ben5049/Smart-Watch/Firmware/README.md

# Firmware

## STM32

All STM32 firmware was written in [STM32CubeIDE](https://www.st.com/en/development-tools/stm32cubeide.html).

## NRF53

Zephyr is scary : (
