ben5049/Smart-Watch/Simulations/README.md

Simulations and calculations for circuits
