ben5049/Smart-Watch/Documentation/Useful Tools.md

[STM32 Oscillator selection](https://app.powerbi.com/view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)

[JLCPCB Impedance Calculator](https://jlcpcb.com/pcb-impedance-calculator/)

[Saturn PCB Design Toolkit](https://saturnpcb.com/saturn-pcb-toolkit/)
