ben5049/Smart-Watch/PCBs/archived/README.md

All libraries for projects in "archived/" are defined relative to the "PCBs" folder (../), and need to be moved there before opening to work properly.
