ben5049/Smart-Watch/Documentation/Display/coordinates1.png

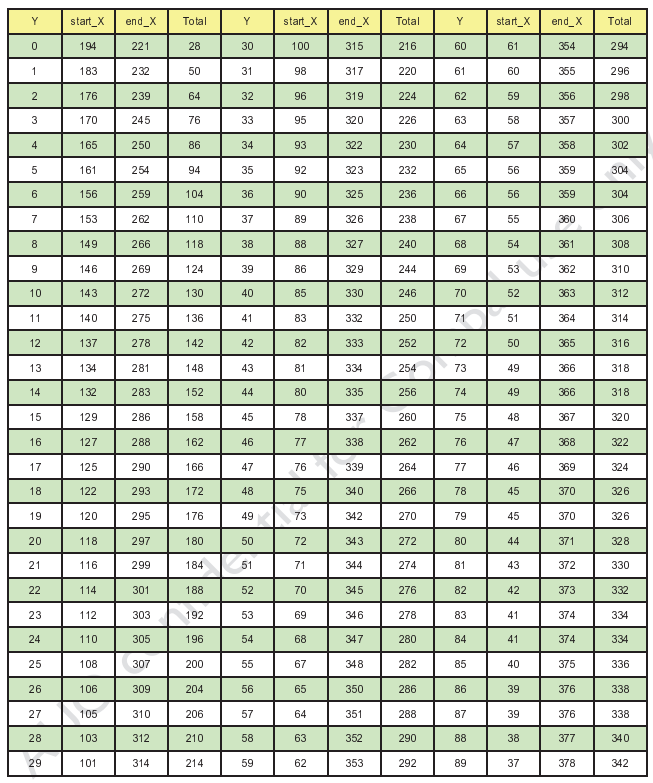
Documentation/Display/coordinates1.png
