ben5049/Smart-Watch/Documentation/Display/coordinates2.png

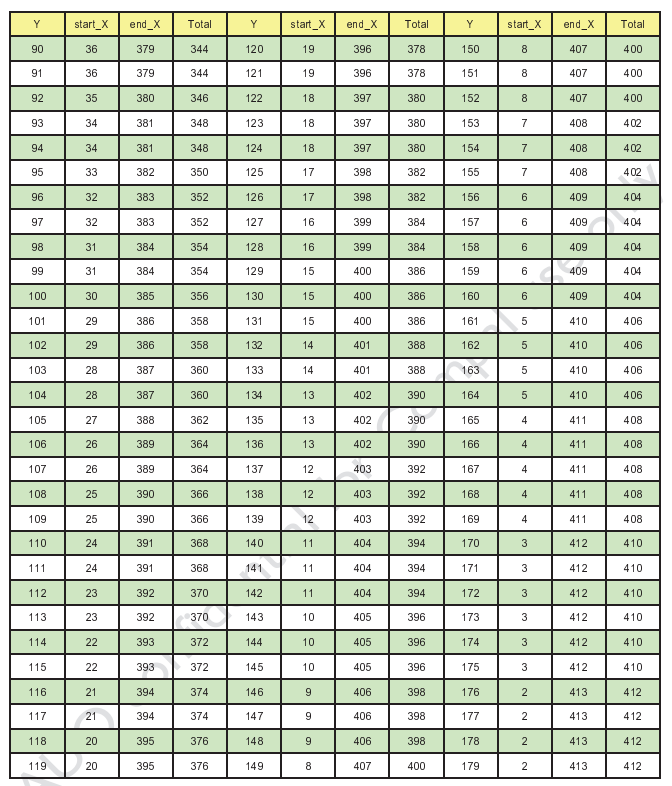
Documentation/Display/coordinates2.png
