ben5049/Smart-Watch/Documentation/Display/coordinates3.png

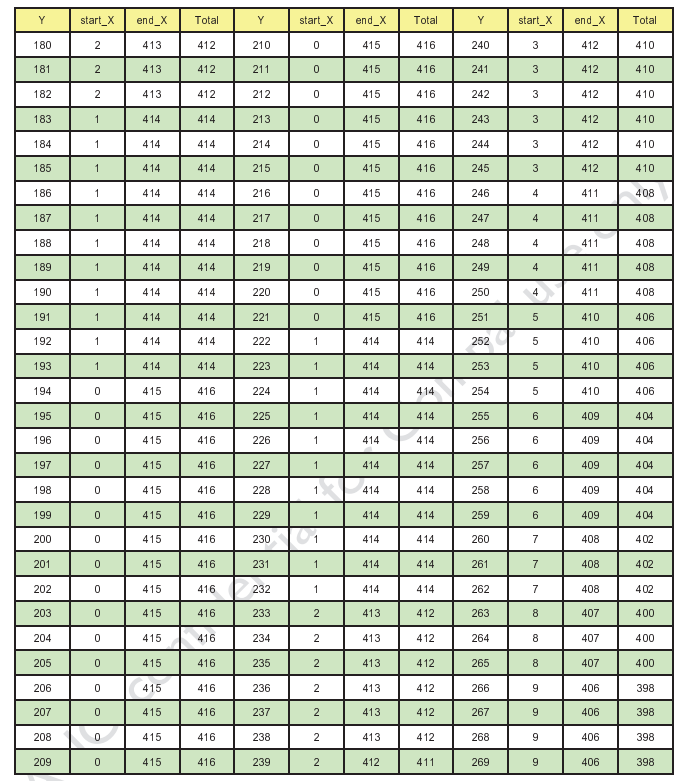
Documentation/Display/coordinates3.png
