ben5049/Smart-Watch/Documentation/Display/coordinates4.png

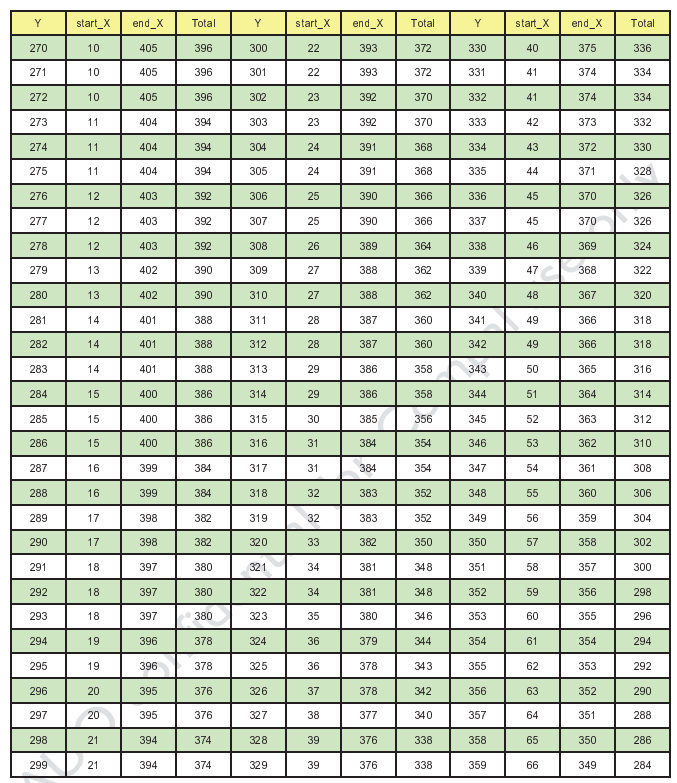
Documentation/Display/coordinates4.png
