ben5049/Smart-Watch/Documentation/Display/coordinates5.png

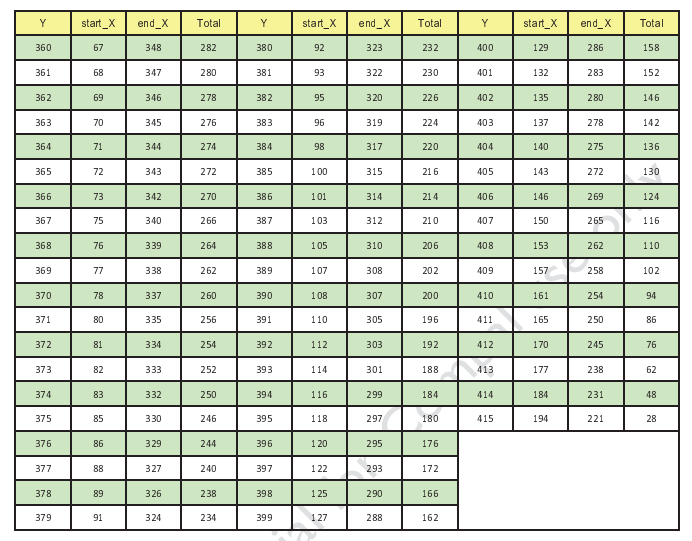
Documentation/Display/coordinates5.png
