ben5049/Smart-Watch/Documentation/Images/ADP5360_layout.png

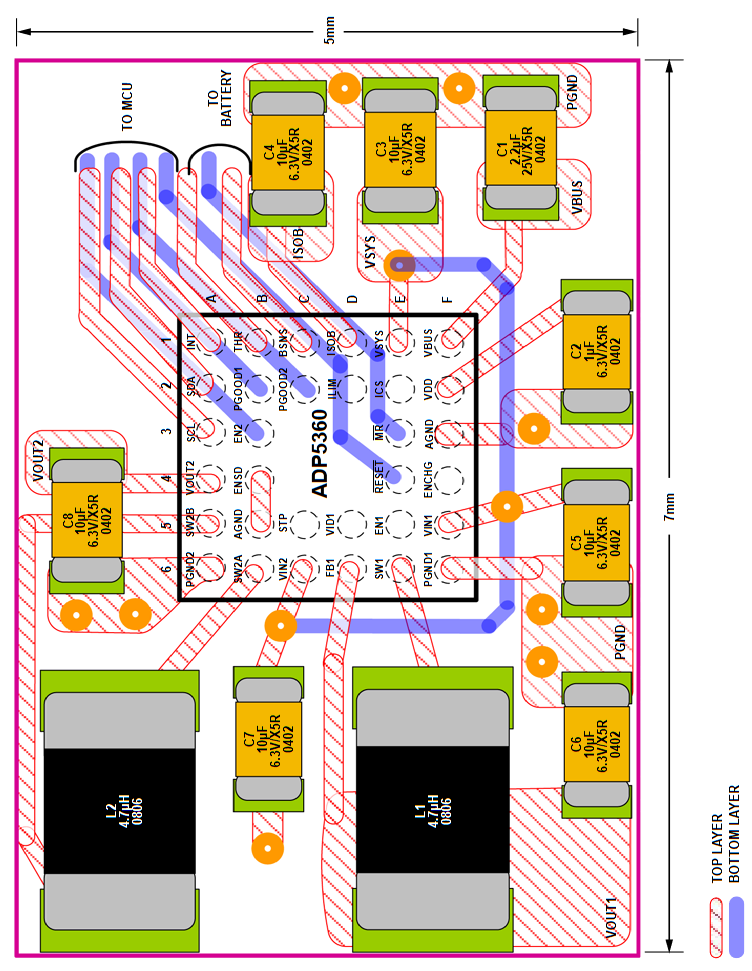
Documentation/Images/ADP5360_layout.png
