ben5049/Smart-Watch/Documentation/Images/antenna-diagram.png

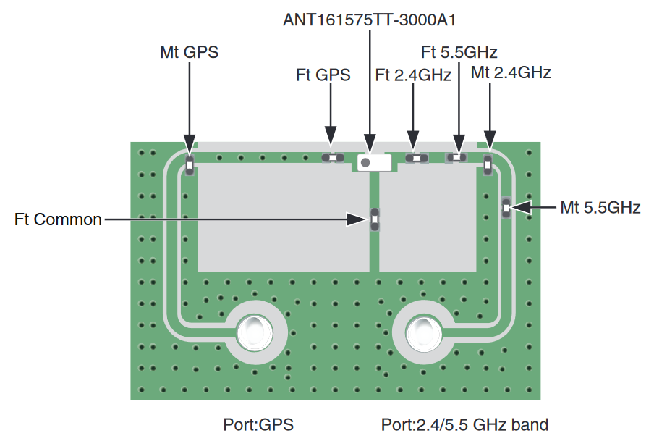
Documentation/Images/antenna-diagram.png
