ben5049/Smart-Watch/Documentation/Images/CST716_pinout.png

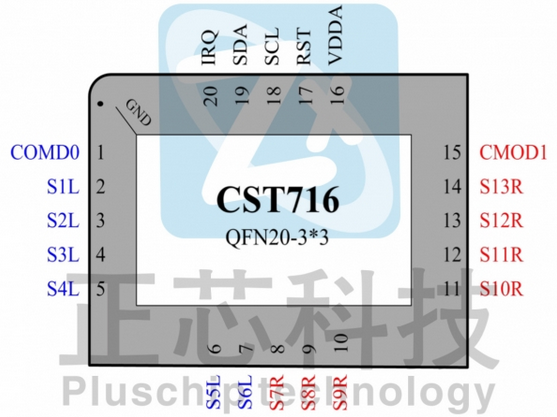
Documentation/Images/CST716_pinout.png
