ben5049/Smart-Watch/Documentation/Images/display_2_front.png

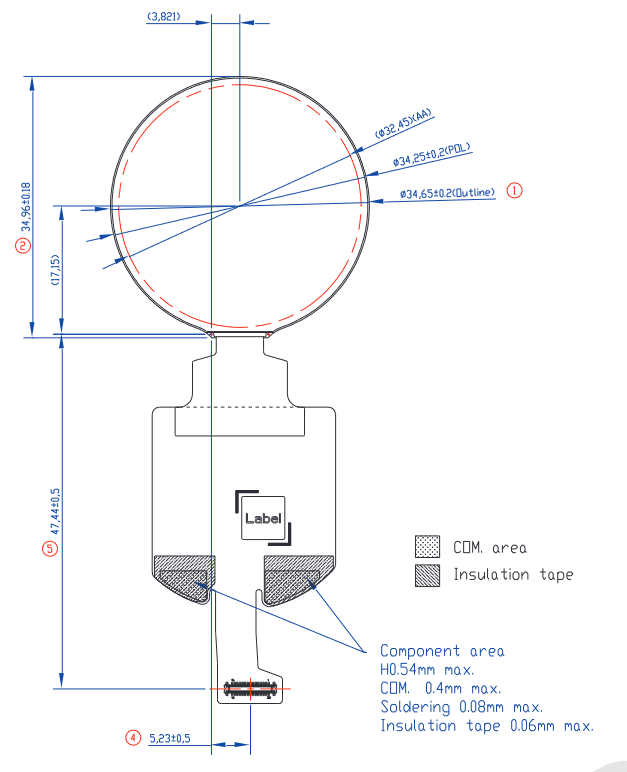
Documentation/Images/display_2_front.png
