ben5049/Smart-Watch/Documentation/Images/pogo_pin_3mm.png

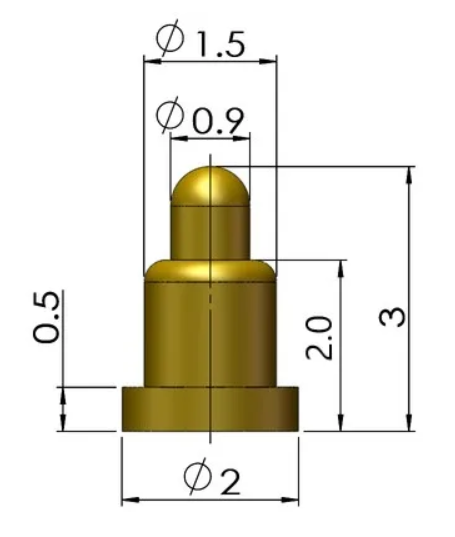
Documentation/Images/pogo_pin_3mm.png
