ben5049/Smart-Watch/Documentation/Images/pogo_pin_8mm.png

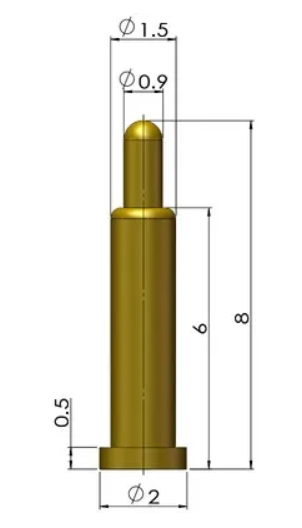
Documentation/Images/pogo_pin_8mm.png
