ben5049/Smart-Watch/Documentation/Images/pogo_pin_size_chart.png

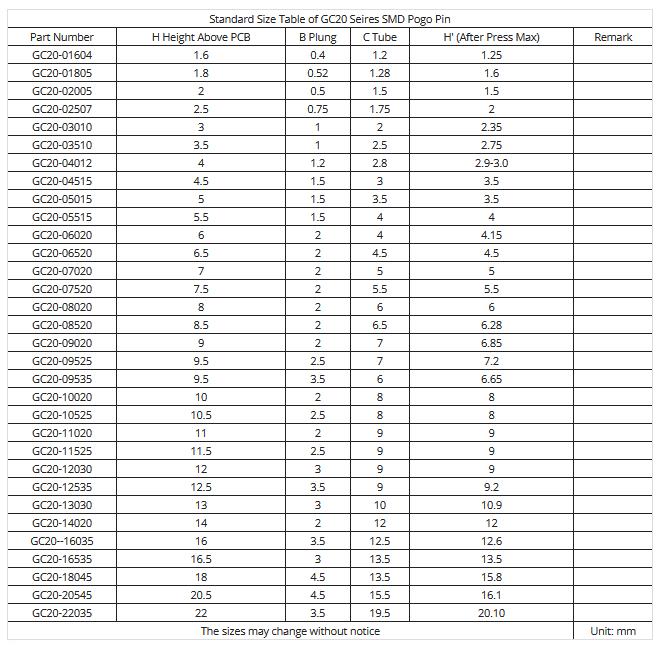
Documentation/Images/pogo_pin_size_chart.png
