ben5049/Smart-Watch/Simulations/Boost_SMPS_DAC_Control.jpg

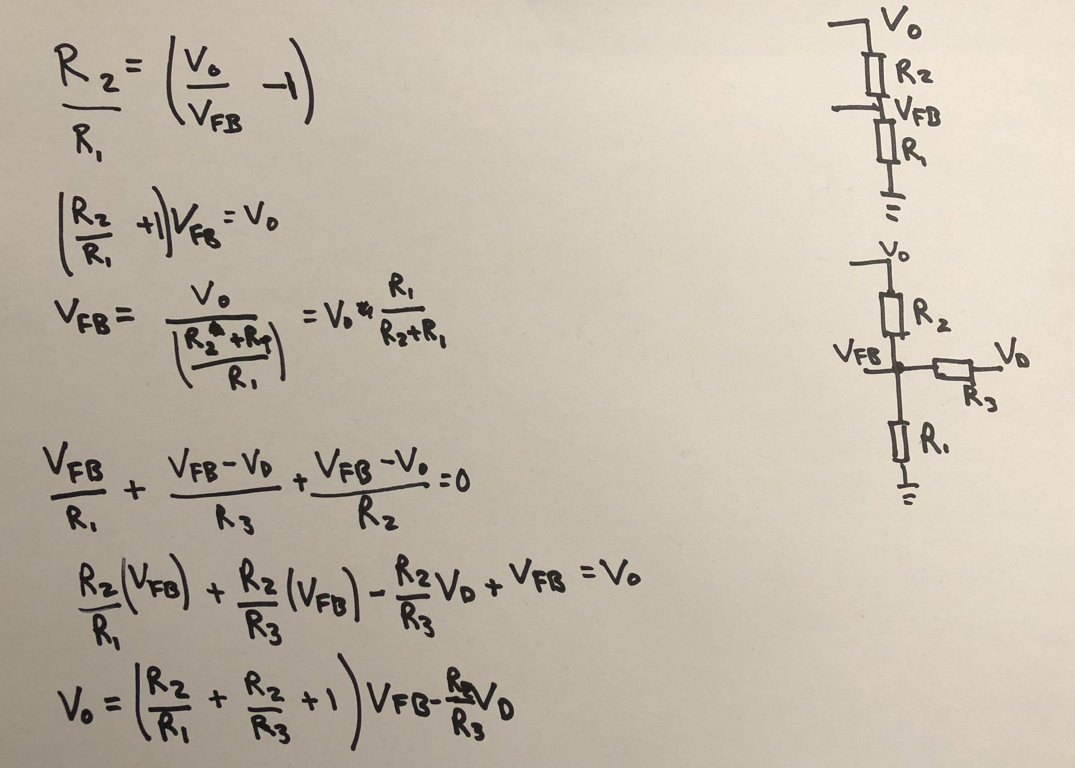
Simulations/Boost_SMPS_DAC_Control.jpg
