ben5049/Smart-Watch/Simulations/RFID_Level_Shift_Switching_Delay.jpg

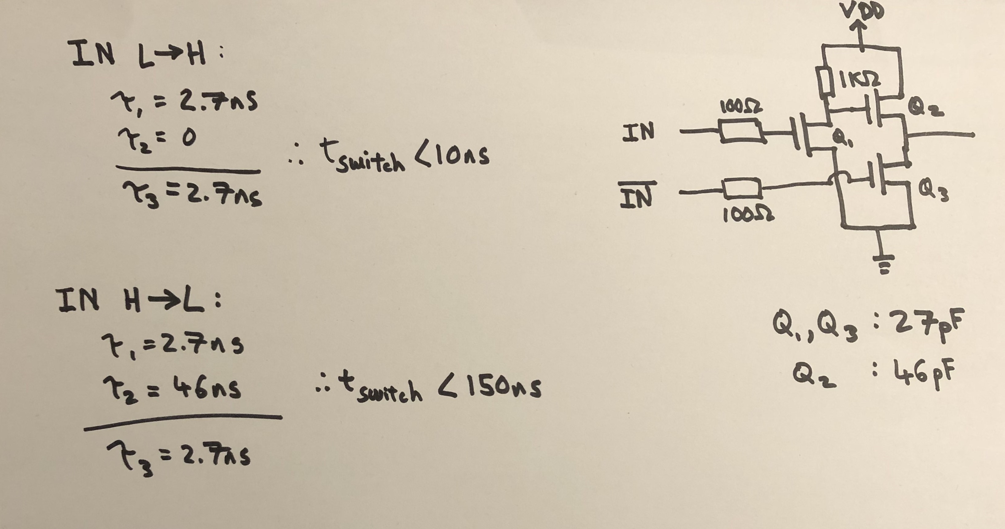
Simulations/RFID_Level_Shift_Switching_Delay.jpg
