ben5049/Smart-Watch/Documentation/BOMs/Watch Main BOM.xlsx

 |  | Name | Value | Quantity | Price | Function | Bought? | Link | Datasheet
ICs |  | STM32U5A9NJH6Q |  | 1 | 14.25 | Main MCU | A | https://www.mouser.co.uk/ProductDetail/STMicroelectronics/STM32U5A9NJH6Q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
 |  | nRF5340-QKAA-R7 |  | 1 | 7.32 | BLE MCU | B | https://www.mouser.co.uk/ProductDetail/Nordic-Semiconductor/nRF5340-QKAA-R7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
 |  | ADP5360ACBZ-2-R7 |  | 1 | 3.59 | Battery charger, 1V8, 3V3 regulators | B | https://www.mouser.co.uk/ProductDetail/Analog-Devices/ADP5360ACBZ-2-R7?qs=GBLSl2AkirtayaN8yEOC7w%3D%3D
 |  | NCP45525IMNTWG-H |  | 1 | 1.16 | SD Card load switch | B | https://www.mouser.co.uk/ProductDetail/onsemi/NCP45525IMNTWG-H?qs=xGcJQ%252BnsJwuEDnjYHzk8Zw%3D%3D
 |  | RT4730WSC |  | 1 | 1.86 | AMOLED Power | B | https://www.mouser.co.uk/ProductDetail/Richtek/RT4730WSC?qs=amGC7iS6iy9KQOadwtNmGA%3D%3D
 |  | ANT161575TT-3000A1 |  | 1 | 0.44 | GNSS + BLE Antenna | B | https://www.mouser.co.uk/ProductDetail/TDK/ANT161575TT-3000A1?qs=%2FQ2qp2Z%2FWFzXgfHtTXyT%2FQ%3D%3D
 |  | TESEO-LIV3FL |  | 1 | 12.96 | GNSS Module | B | https://www.mouser.co.uk/ProductDetail/STMicroelectronics/TESEO-LIV3FL
 |  | BGA725L6E6327FTSA1 |  | 1 | 0.35 | GNSS LNA | B | https://www.mouser.co.uk/ProductDetail/Infineon-Technologies/BGA725L6E6327FTSA1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
 |  | B39162B4327P810 |  | 1 | 1.24 | GNSS Saw filter | B | https://www.mouser.co.uk/ProductDetail/RF360/B39162B4327P810?qs=lGUynpphgXxwtn5A8O%2FIyg%3D%3D
 |  | S26HS512TGABHI000 |  | 1 | 10.00 | Hyper flash | A | https://www.mouser.co.uk/ProductDetail/Infineon-Technologies/S26HS512TGABHI000?qs=BJlw7L4Cy78X5sI41cfhkg%3D%3D
 |  | NVT4858HKZ |  | 1 | 0.96 | SD Level shifter | B | https://www.mouser.co.uk/ProductDetail/NXP-Semiconductors/NVT4858HKZ?qs=TuK3vfAjtkUQFuqXj%252BGfyA%3D%3D
 |  | M24256X-FCU6T/VF |  | 1 | 0.44 | EEPROM | B | https://www.mouser.co.uk/ProductDetail/STMicroelectronics/M24256X-FCU6T-VF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
 |  | IM70D122V01XTMA1 |  | 1 | 1.58 | Microphone | B | https://www.mouser.co.uk/ProductDetail/Infineon-Technologies/IM70D122V01XTMA1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
 |  | LSM6DSO16ISTR |  | 1 | 5.64 | IMU | A | https://www.mouser.co.uk/ProductDetail/STMicroelectronics/LSM6DSO16ISTR?qs=t7xnP681wgUum%252BsoR36hnw%3D%3D
 |  | IIS2MDCTR |  | 1 | 2.80 | Magnetometer | B | https://www.mouser.co.uk/ProductDetail/STMicroelectronics/IIS2MDCTR?qs=1mbolxNpo8ems1K%2FRdQzXg%3D%3D
 |  | OPT3004DNPR |  | 1 | 2.46 | Ambient light sensor | B | https://www.mouser.co.uk/ProductDetail/Texas-Instruments/OPT3004DNPR?qs=l7cgNqFNU1jkBuP1vZFGkA%3D%3D
Discrete Semis | FETs | DMP2104LP-7 |  | 1 | 0.34 | Reverse polarity PMOS | B | https://www.mouser.co.uk/ProductDetail/Diodes-Incorporated/DMP2104LP-7?qs=R%252By5Lqt1H6xg6KRllhPj7w%3D%3D
Passives | Inductors | MLG1005S0N6CT000 | 0.6nH | 1 |  |  | B
 |  | LQG15HZ1N5S02D | 1.5nH | 2 |  |  | B
 |  | LQG15HS2N2B02D | 2.2nH | 1 |  |  | B
 |  | LQG15HZ2N7S02D | 2.7nH | 1 |  |  | B
 |  | LQG15HS7N5G02D | 7.5nH | 1 |  |  | B
 |  | DFE201612E-2R2M=P2 | 2.2uH | 2 | 0.26 | VDD11, Display buck inductor | B | https://www.mouser.co.uk/ProductDetail/Murata-Electronics/DFE201612E-2R2M%3dP2?qs=AQlKX63v8Rsi4vow61OBVg%3D%3D
 |  | DFE201612E-4R7M=P2 | 4.7uH | 2 | 0.26 | 1V8, 3V3 Regulator inductors | B | https://www.mouser.co.uk/ProductDetail/Murata-Electronics/DFE201612E-4R7M%3dP2?qs=AQlKX63v8RtFKyOOIfSFEA%3D%3D
 |  | MLZ1608N100LT000 | 10uH | 2 | 0.11 | nRF Regulator inductors | B | https://www.mouser.co.uk/ProductDetail/TDK/MLZ1608N100LT000?qs=%2FPzWLGNeQ%252BjWztxz0ZUthw%3D%3D
 | Crystals | ECS-.327-7-12-C-TR | 32.768kHz | 1 | 0.54 | STM32 LSE | B | https://www.mouser.co.uk/ProductDetail/ECS/ECS-.327-7-12-C-TR?qs=Mv7BduZupUigykQeU9laTQ%3D%3D
 |  | ECS-160-8-37-CWY-TR3 | 16MHz | 1 | 0.32 | STM32 HSE | B | https://www.mouser.co.uk/ProductDetail/ECS/ECS-160-8-37-CWY-TR3?qs=e8oIoAS2J1S7yHPKjK4eXg%3D%3D
 |  | ECS-320-8-37B-CWN-TR | 32MHz | 1 | 0.37 | nRF Oscillator | B | https://www.mouser.co.uk/ProductDetail/ECS/ECS-320-8-37B-CWN-TR?qs=3Rah4i%252BhyCHz%252B6r%252BQzq5cA%3D%3D
 | Capacitors | GJM1555C1HR60BB01D | 0.7pF, 0402 | 1 |  |  | B
 |  | GJM1555C1H6R0CB01D | 6pF, 0402 | 4 |  |  | B
 |  | GJM1555C1H7R5DB01D | 7.5pF, 0402 | 1 |  |  | B
 |  | GJM1555C1H430JB01D | 43pF, 0402 | 1 |  |  | B
 |  | GRM1555C1H121JA01D | 120pF, 0402 | 1 |  |  | B
 |  | GRM155R70J222KA01D | 2.2nF, 0402 | 1 |  |  | B
 |  |  | 10nF, 0402 | 2 |  |  | A
 |  |  | 100nF, 0402 | 36 |  |  | A
 |  | GRT155C81E224ME01D | 220nF, 0402 | 1 |  |  | B
 |  |  | 1uF, 0402 | 10 |  |  | A
 |  |  | 2.2uF, 0402 | 3 |  |  | A
 |  |  | 4.7uF, 0402 | 4 |  |  | A
 |  |  | 10uF, 0402 | 13 |  |  | A
 |  | GRM158R61A226ME15D | 22uF, 0402 | 2 | 0.18 | ELVSS Cap | B | https://www.mouser.co.uk/ProductDetail/Murata-Electronics/GRM158R60J226ME01D?qs=hd1VzrDQEGhRlVgN8RQ1oA%3D%3D
 | Resistors 0402 |  | 0 | 1 |  |  | A
 |  |  | 4.7k | 10 |  |  | A
 |  | ERJ-2RKF1002X | 10k | 2 |  |  | B
 |  |  | 100k | 1 |  |  | A
Mechanical | Buttons | EVP-AEJB2A |  | 1 | 0.64 | Side button | A | https://www.mouser.co.uk/ProductDetail/Panasonic/EVP-AEJB2A?qs=WGabLL9VVXqY3HchGWvM%2Fg%3D%3D
 | Connectors | AXG130144A |  | 1 | 2.74 | Display connector | B | https://www.digikey.co.uk/en/products/detail/panasonic-electric-works/AXG130144A/5057281
 |  | 105162-0001 |  | 1 | 0.82 | uSD Card slot | B | https://www.digikey.co.uk/en/products/detail/molex/1051620001/4555282?s=N4IgTCBcDaIIwAYCscBsYC0DtxAXQF8g
 |  | AXG110144A | WRONG | 1 | 1.40 | Touch mezzanine socket | B | https://www.digikey.co.uk/en/products/detail/panasonic-electric-works/AXG110144A/5057277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
 |  | AXG120144A |  | 1 | 2.04 | Lower mezzanine socket | B | https://www.digikey.co.uk/en/products/detail/panasonic-electric-works/AXG120144A/5057279
