ben5049/Smart-Watch/Documentation/BOMs/Module Test Rig BOM.xlsx

 |  | Name | Value | Quantity | Price | Function | Bought? | Link | Datasheet
ICs |  | LDI1117-3.3H |  | 1 | 0.55 | 3V3 LDO Regulator | B | https://www.mouser.co.uk/ProductDetail/Diotec-Semiconductor/LDI1117-3.3H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
Passives
Mechanical | Connectors | FTSH-107-01-F-DV-K |  | 1 | 3.94 | STDC14 Connector | B | https://www.mouser.co.uk/ProductDetail/Samtec/FTSH-107-01-F-DV-K?qs=%252BZP6%2F%252BtExtDsIijVpK7L8w%3D%3D
 | Other | Button |  | 1 | 0.00 |  | A
 |  | Slide Switch |  | 1 | 0.00 |  | A
