ben5049/Smart-Watch/Documentation/BOMs/RFID Module BOM.xlsx

ICs |  | STM32G071G8U6TR |  | 1 | 2.58 |  | B | https://www.mouser.co.uk/ProductDetail/STMicroelectronics/STM32G071G8U6TR?qs=ZSypp649SOUutATaO5pC%2Fg%3D%3D
 |  | TLV9004SIRTER |  | 1 | 0.61 | Quad op amp | B | https://www.mouser.co.uk/ProductDetail/Texas-Instruments/TLV9004SIRTER?qs=byeeYqUIh0P0b6lIyMN1Wg%3D%3D
 |  | MAX9027EBT+T |  | 1 | 1.26 | Comparator | B | https://www.mouser.co.uk/ProductDetail/Analog-Devices-Maxim-Integrated/MAX9027EBT%2bT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
 |  | MAX17291BANT+T |  | 1 | 1.45 | Boost converter | B | https://www.mouser.co.uk/ProductDetail/Analog-Devices-Maxim-Integrated/MAX17291BANT%2bT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
Discrete Semis | FETs | DMN21D2UFB-7B |  | 4 | 0.29 | RFID NMOS | B | https://www.mouser.co.uk/ProductDetail/Diodes-Incorporated/DMN21D2UFB-7B?qs=gfe7vQ8txpW8IlraWNmMnA%3D%3D
 |  | DMP21D5UFB4-7B |  | 1 | 0.30 | RFID PMOS | B | https://www.mouser.co.uk/ProductDetail/Diodes-Incorporated/DMP21D5UFB4-7B?qs=gfe7vQ8txpUVAcG22XiS3g%3D%3D
 | Diodes | ACDBQC0130L-HF |  | 1 | 0.27 | RFID Envelope detector diode | B | https://www.mouser.co.uk/ProductDetail/Comchip-Technology/ACDBQC0130L-HF?qs=Zz7%252BYVVL6bENpHY2DpOUTA%3D%3D
Passives | Inductors | TR1102-0491J | 4.91mH | 1 | 5.00 | RFID z-axis transponder coil | A | https://www.grupopremo.com/en/tr1102-xy-axis-smd-ferrite-rfid-transponder-inductor-125khz-238-9mh-11x26x22mm/900-tr1102-0491j.html | Alternative: 4513TC-495XGLB
 |  | MLZ1608N100LT000 | 10uH | 1 |  |  | B | https://www.mouser.co.uk/ProductDetail/TDK/MLZ1608N100LT000?qs=%2FPzWLGNeQ%252BjWztxz0ZUthw%3D%3D
 | Capacitors 0402 | GRM1555C2A101GA01D | 100p | 3 |  |  | B
 |  | GRM155R71H331MA01D | 330p | 1 |  | Tuning cap | B
 |  | GCM155R72A102KA37J | 1n | 1 |  |  | B
 |  | GRM155R61E472KA01D | 4.7n | 2 |  |  | B
 |  |  | 10n | 2 |  |  | A
 |  |  | 100n | 4 |  |  | A
 |  |  | 220n | 1 |  |  | B
 |  |  | 1u | 2 |  |  | A
 |  |  | 4.7u | 2 |  |  | A
 |  | GRM158R61A226ME15D | 22u | 1 |  |  | B
 | Resistors 0402
 |  |  | 100 | 3 |  |  | A
 |  |  | 330 | 1 |  |  | A
 |  |  | 1k | 6 |  |  | A
 |  |  | 4.7k | 1 |  |  | A
 |  | ERJ-2GEJ512X | 5.1k | 1 |  |  | B
 |  |  | 10k | 6 |  |  | B
 |  | AF0402FR-0720KL | 20k | 1 |  |  | B
 |  |  | 33k | 2 |  |  | A
 |  |  | 100k | 2 |  |  | A
 |  | AC0402FR-07402KL | 402k | 1 |  |  | B
 |  |  | 1M | 2 |  |  | A
 |  | CRCW04023M48FKED | 3.48M | 1 |  |  | B
