ben5049/Smart-Watch/Documentation/BOMs/Watch Lower PCB BOM.xlsx

 |  | Name | Value | Quantity | Price | Function | Bought? | Link | Datasheet
ICs |  | DRV2605LYZFR |  | 1 | 1.65 |  | B | https://www.mouser.co.uk/ProductDetail/Texas-Instruments/DRV2605LYZFR?qs=7z%252BmIopC6%2FIPohzEGVWenA%3D%3D
 |  | MAX30102EFD+T |  | 1 | 9.94 |  | B | https://www.mouser.co.uk/ProductDetail/Analog-Devices-Maxim-Integrated/MAX30102EFD%2bT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
Discrete Semis | TVS Diode | TPD1E10B06DPYR |  | 1 | 0.30 |  | B | https://www.mouser.co.uk/ProductDetail/Texas-Instruments/TPD1E10B06DPYR?qs=UFc95S4Z4CaJYpQ4xqTc0g%3D%3D
Mechanical | Connectors | AXG220144 |  | 1 | 2.46 |  | B | https://www.mouser.co.uk/ProductDetail/Panasonic-Industrial-Devices/AXG220144?qs=MNIFWdyJgbqoES8luJlP4A%3D%3D
