ben5049/Smart-Watch/Documentation/BOMs/Watch Test Rig BOM.xlsx

 |  | Name | Value | Quantity | Price | Function | Bought? | Link | Datasheet
ICs
Discrete Semis | FETs | DMN21D2UFB-7B |  | 5 |  |  | B
Passives
Mechanical | Connectors | FTSH-107-01-F-DV-K |  | 1 | 3.94 | STDC14 Connector | B | https://www.mouser.co.uk/ProductDetail/Samtec/FTSH-107-01-F-DV-K?qs=%252BZP6%2F%252BtExtDsIijVpK7L8w%3D%3D
 |  | FTSH-105-01-F-DV-K |  | 1 | 2.67 | MIPI10 Connector | B | https://www.mouser.co.uk/ProductDetail/Samtec/FTSH-105-01-F-DV-K?qs=iT52DjcXudtFjikTq7rIdg%3D%3D
 |  | Pogo Pin | 8mm
