ben5049/Smart-Watch/PCBs/component_library/watch_drawings/watch_main.dxf

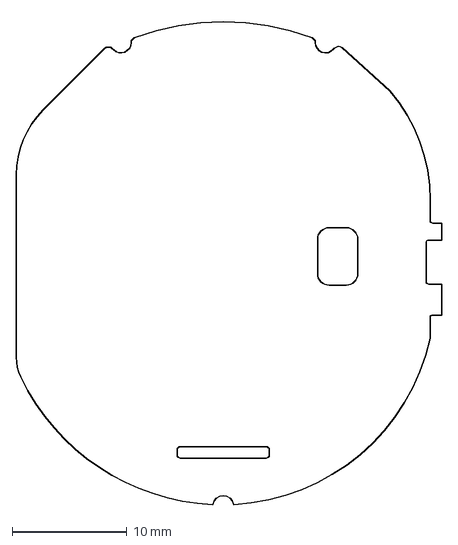
[picture p18: CAD file, 2024-01-25]
PCBs/component_library/watch_drawings/watch_main.dxf
37.0 x 42.4 mm
