ben5049/Smart-Watch/PCBs/component_library/watch_drawings/watch_main_keepout.dxf

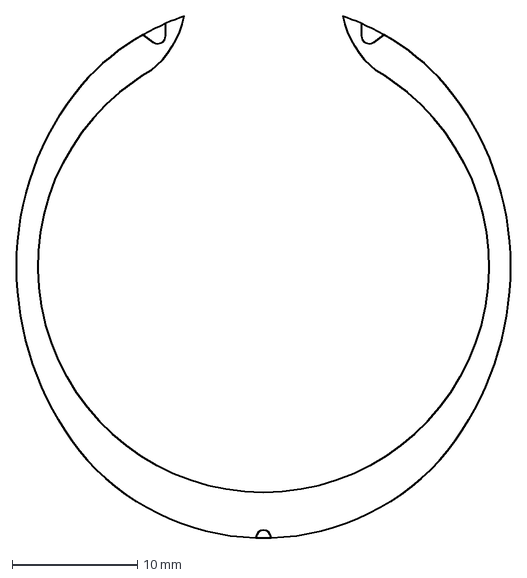
[picture p19: CAD file, 2023-12-30]
PCBs/component_library/watch_drawings/watch_main_keepout.dxf
39.4 x 41.6 mm
