ben5049/Smart-Watch/CAD/Bottom.stl

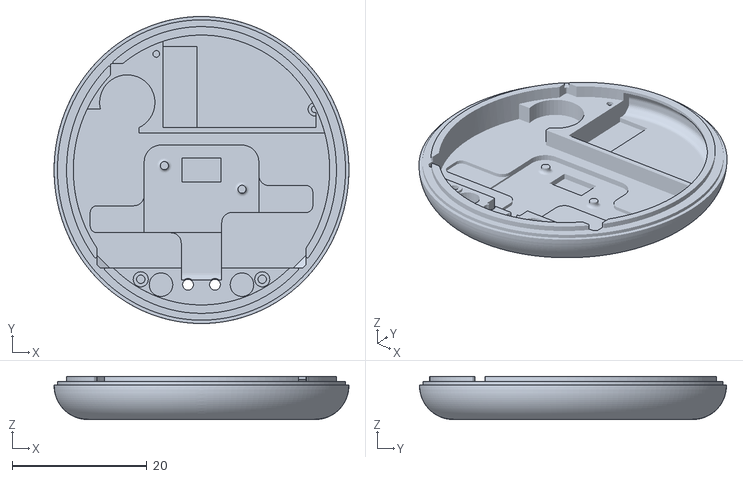
[picture p20: CAD file, 2024-01-14]
CAD/Bottom.stl
43.7 x 45.5 x 6.38
