ben5049/Smart-Watch/PCBs/component_library/watch_models/PCA9570GMH.stp

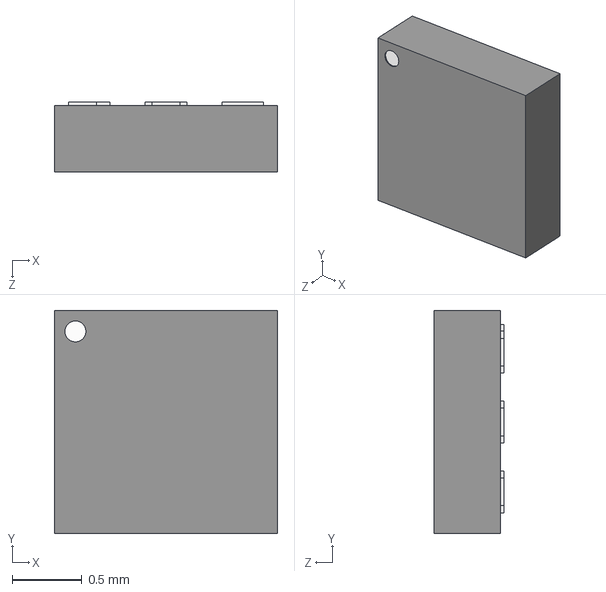
[picture p21: CAD file, 2024-03-28]
PCBs/component_library/watch_models/PCA9570GMH.stp
1.60 x 1.60 x 0.5 mm
