ben5049/Smart-Watch/PCBs/rfid_module_v1.1/rfid_module.step

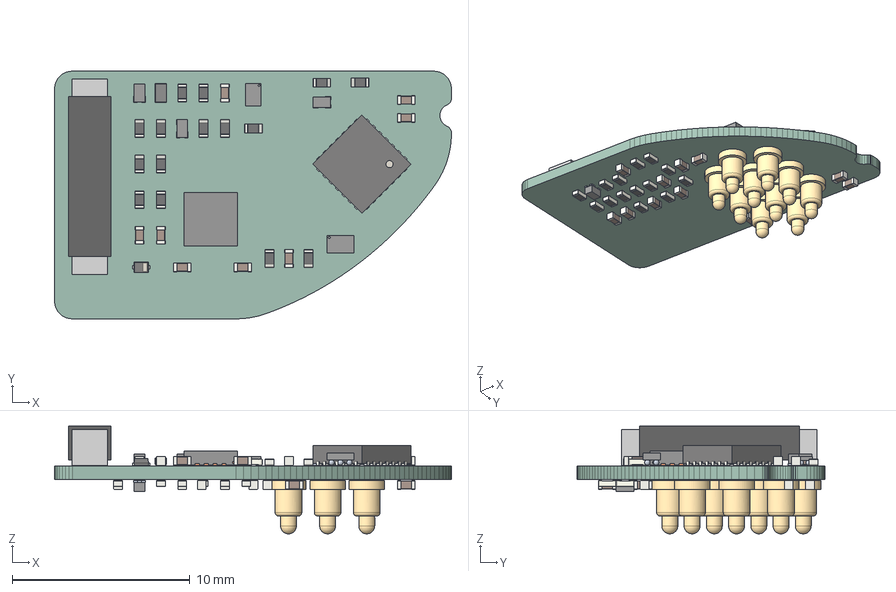
[picture p22: CAD file, 2024-01-06]
PCBs/rfid_module_v1.1/rfid_module.step
22.3 x 13.9 x 6.06 mm
PCB
