ben5049/Smart-Watch/PCBs/watch_lower/watch_lower.step

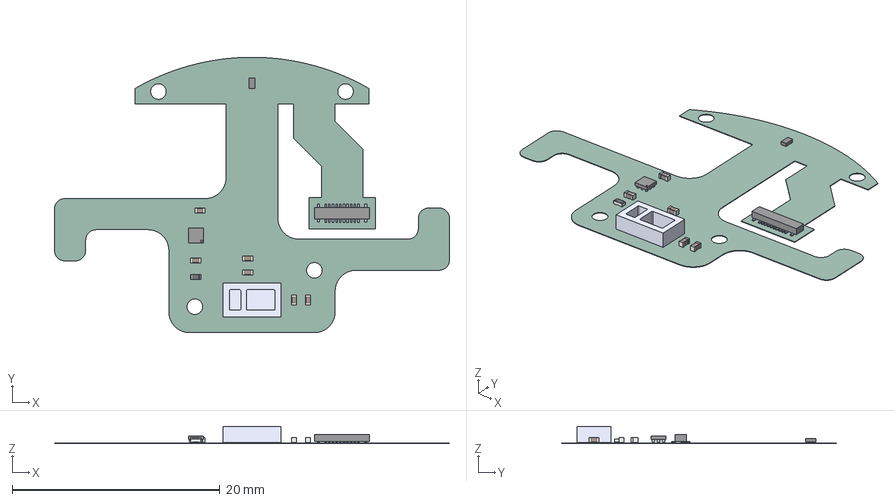
[picture p23: CAD file, 2024-01-06]
PCBs/watch_lower/watch_lower.step
38.0 x 26.5 x 1.66 mm
PCB
