ben5049/Smart-Watch/CAD/Test Rig Frame.stl

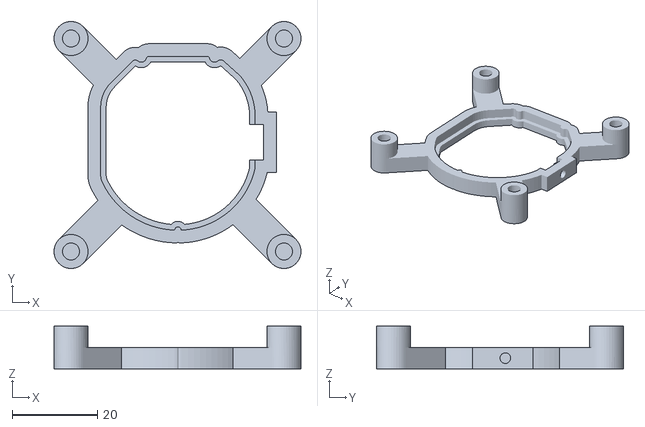
[picture p24: CAD file, 2024-01-13]
CAD/Test Rig Frame.stl
58.0 x 58.0 x 10.0
