ben5049/Smart-Watch/PCBs/component_library/watch_drawings/watch_module.dxf

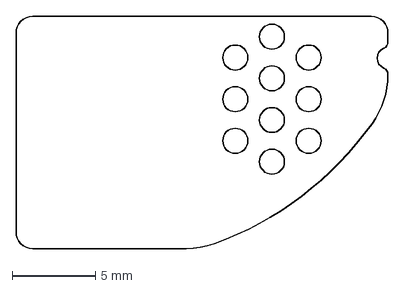
[picture p25: CAD file, 2024-01-06]
PCBs/component_library/watch_drawings/watch_module.dxf
22.3 x 13.9 mm
