ben5049/Smart-Watch/PCBs/component_library/watch_models/21-0789_B41_MXM.step

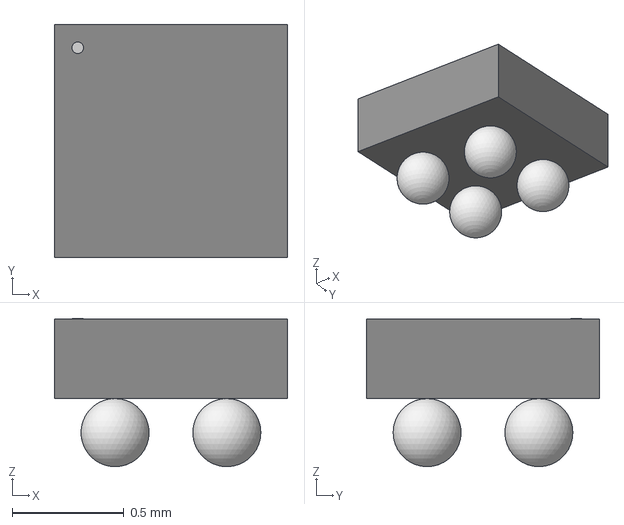
[picture p26: CAD file, 2024-03-27]
PCBs/component_library/watch_models/21-0789_B41_MXM.step
1.04 x 1.04 x 0.663 mm
