ben5049/Smart-Watch/PCBs/component_library/watch_drawings/watch_lower.dxf

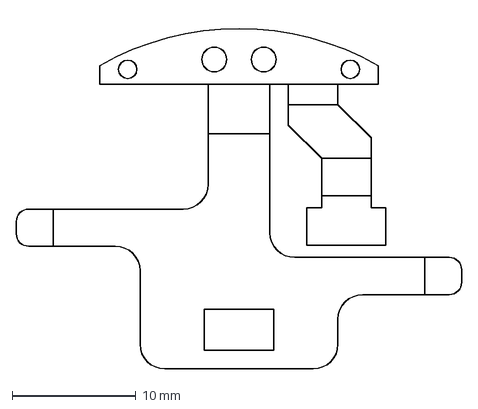
[picture p27: CAD file, 2024-01-03]
PCBs/component_library/watch_drawings/watch_lower.dxf
36.0 x 28.5 mm
