ben5049/Smart-Watch/PCBs/component_library/watch_models/UFBGA144_STM.step

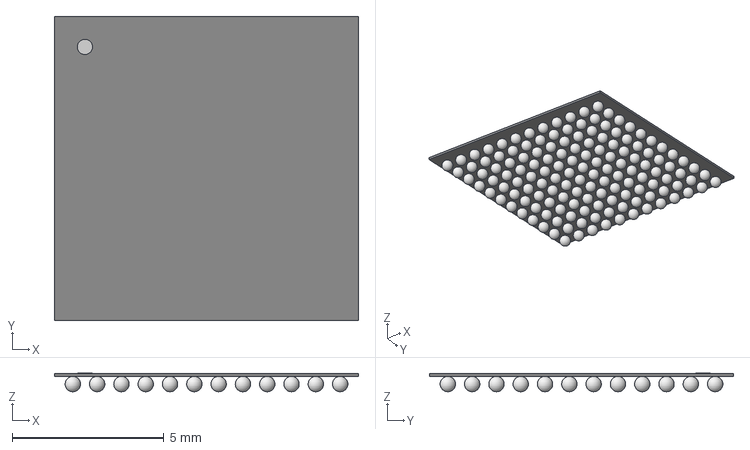
[picture p28: CAD file, 2024-03-26]
PCBs/component_library/watch_models/UFBGA144_STM.step
10.0 x 10.0 x 0.612 mm
