ben5049/Smart-Watch/PCBs/component_library/watch_drawings/antenna_layout.dxf

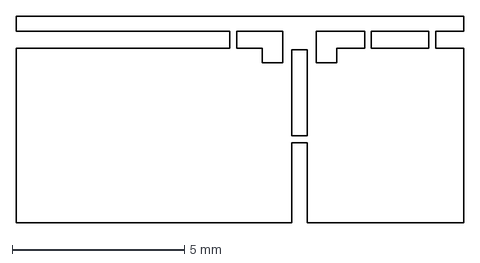
[picture p29: CAD file, 2023-12-17]
PCBs/component_library/watch_drawings/antenna_layout.dxf
13.0 x 6.00 mm
