ben5049/Smart-Watch/PCBs/component_library/watch_models/STM32U5G9ZJJ.stp

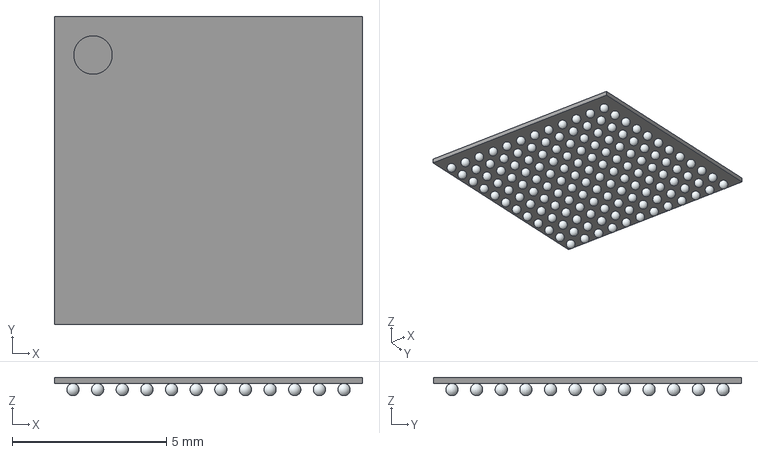
[picture p30: CAD file, 2024-01-26]
PCBs/component_library/watch_models/STM32U5G9ZJJ.stp
10.0 x 10.0 x 0.6 mm
