ben5049/Smart-Watch/PCBs/component_library/watch_models/LBEE59B1LV-278.stp

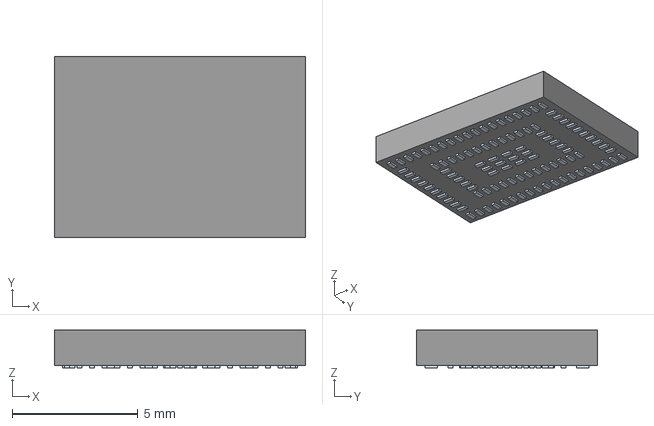
[picture p31: CAD file, 2024-01-25]
PCBs/component_library/watch_models/LBEE59B1LV-278.stp
10.0 x 7.20 x 1.50 mm
Pins
