ben5049/Smart-Watch/PCBs/component_library/watch_models/FCBGA300_CYP.step

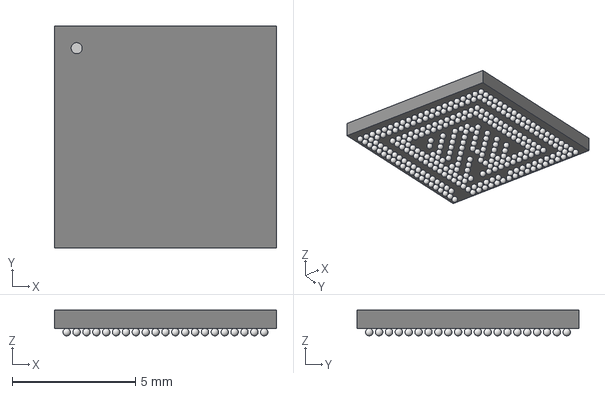
[picture p32: CAD file, 2024-01-25]
PCBs/component_library/watch_models/FCBGA300_CYP.step
8.99 x 8.99 x 1.04 mm
