ben5049/Smart-Watch/PCBs/component_library/watch_models/LBEE5PK2AE-564.stp

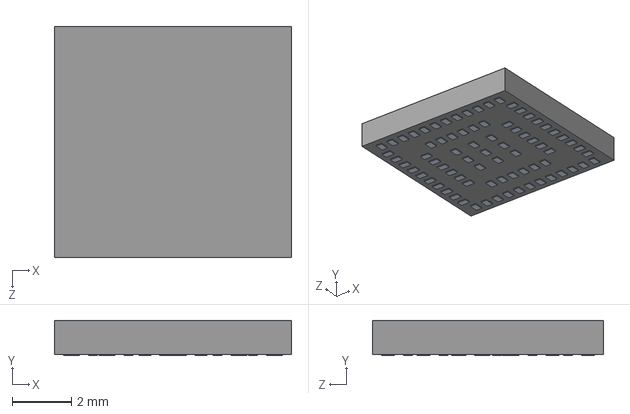
[picture p33: CAD file, 2024-01-25]
PCBs/component_library/watch_models/LBEE5PK2AE-564.stp
8.00 x 1.19 x 7.80 mm
