ben5049/Smart-Watch/PCBs/component_library/watch_models/10-Pin Pogo Connector Pins.step

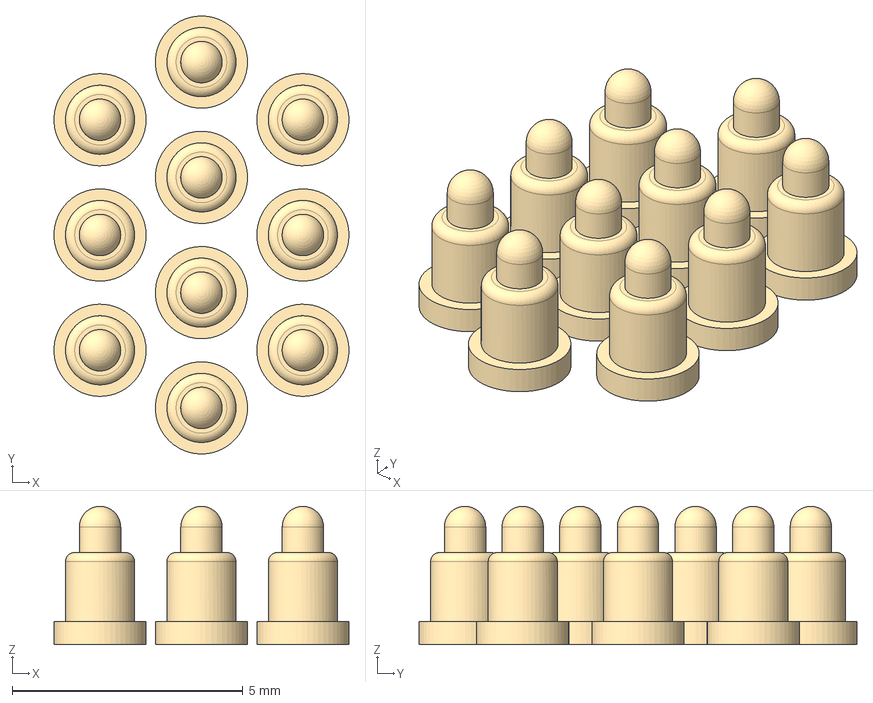
[picture p34: CAD file, 2024-01-03]
PCBs/component_library/watch_models/10-Pin Pogo Connector Pins.step
6.40 x 9.50 x 3.00 mm
Pogo Pin 5mm x 10
