ben5049/Smart-Watch/PCBs/component_library/watch_models/10-Pin Pogo Connector Pads.step

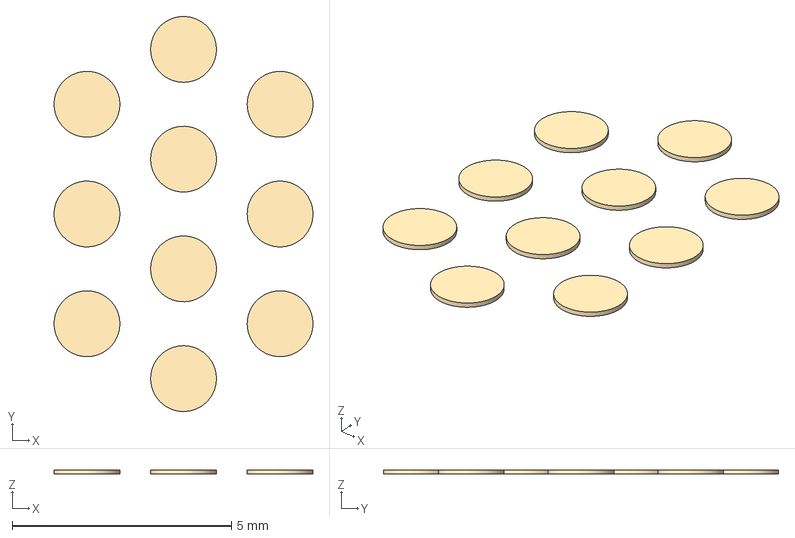
[picture p35: CAD file, 2024-01-02]
PCBs/component_library/watch_models/10-Pin Pogo Connector Pads.step
5.90 x 9.00 x 0.1 mm
