ben5049/Smart-Watch/PCBs/component_library/watch_models/Test Point 2mm.step

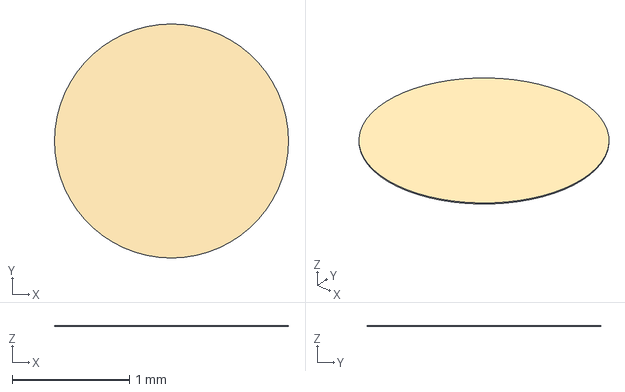
[picture p36: CAD file, 2024-01-02]
PCBs/component_library/watch_models/Test Point 2mm.step
2.00 x 2.00 x 0.01 mm
