ben5049/Smart-Watch/PCBs/component_library/watch_models/Test Point 1.5mm.step

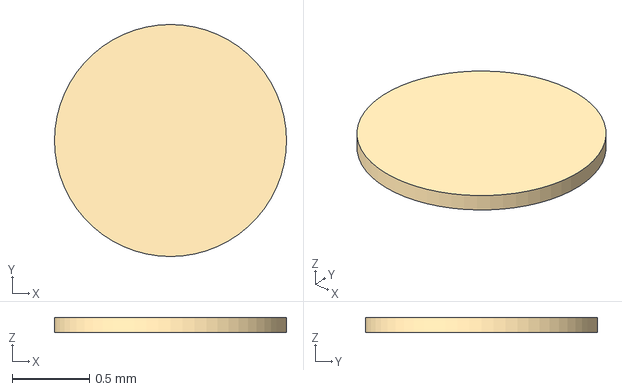
[picture p37: CAD file, 2024-01-02]
PCBs/component_library/watch_models/Test Point 1.5mm.step
1.50 x 1.50 x 0.1 mm
