ben5049/Smart-Watch/PCBs/component_library/watch_models/RT4730WSC.step

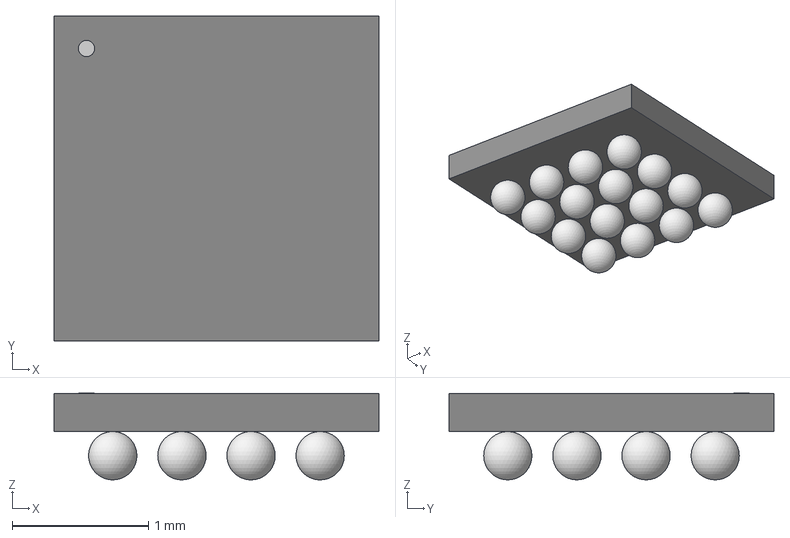
[picture p38: CAD file, 2023-12-27]
PCBs/component_library/watch_models/RT4730WSC.step
2.39 x 2.39 x 0.638 mm
