ben5049/Smart-Watch/PCBs/component_library/watch_models/TYPE-C-31-M-12.step

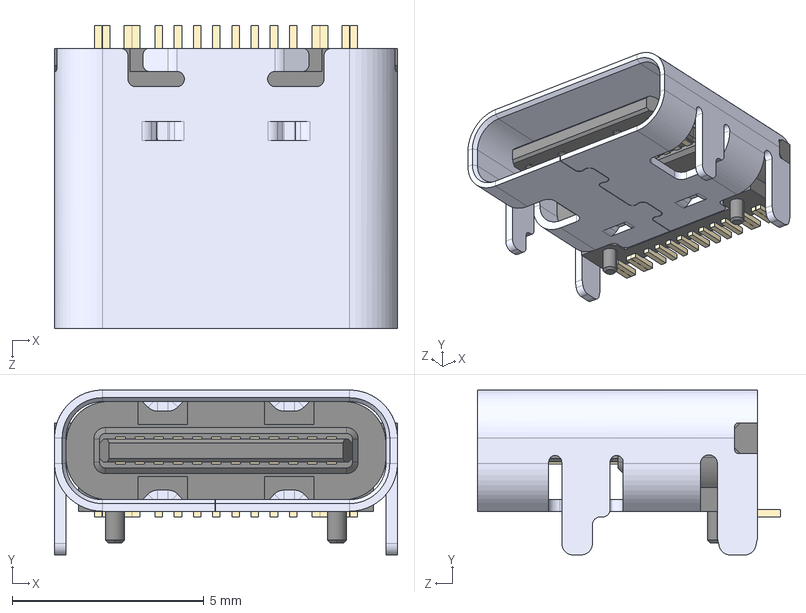
[picture p39: CAD file, 2023-12-22]
PCBs/component_library/watch_models/TYPE-C-31-M-12.step
8.94 x 4.30 x 7.90 mm
