ben5049/Smart-Watch/PCBs/component_library/watch_models/FTSH-105-01-L-DV-K.stp

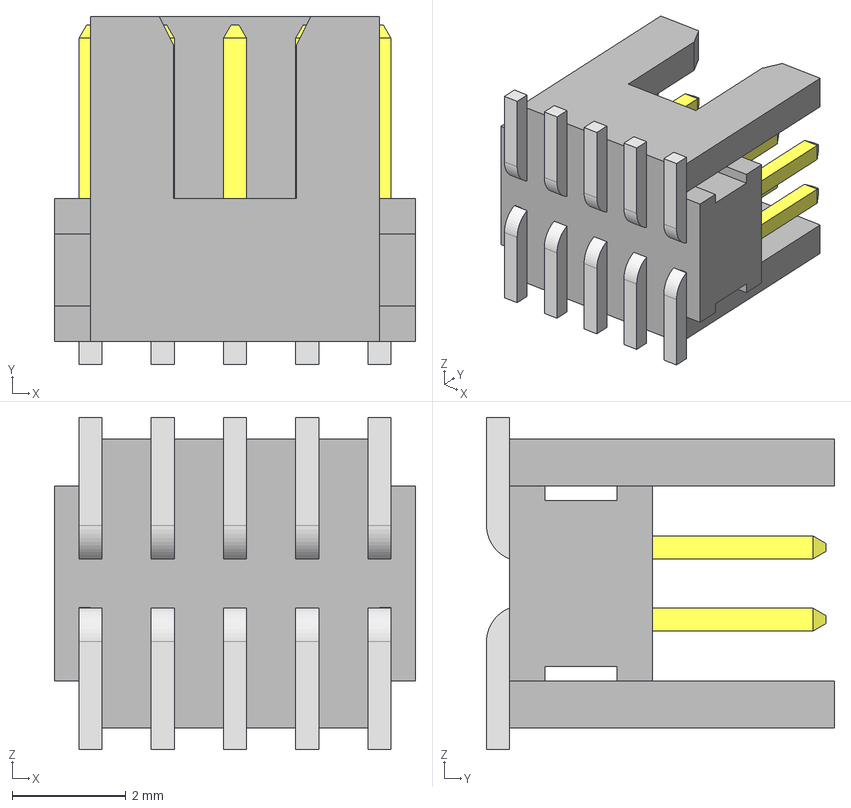
[picture p40: CAD file, 2023-12-21]
PCBs/component_library/watch_models/FTSH-105-01-L-DV-K.stp
6.35 x 6.12 x 5.84 mm
FTSH-105-01-L-DV-K_pins2
FTSH-105-01-L-DV-K_pins1
FTSH-105-01-L-DV-K_body
