ben5049/Smart-Watch/PCBs/component_library/watch_models/DMP2104LP-7.stp

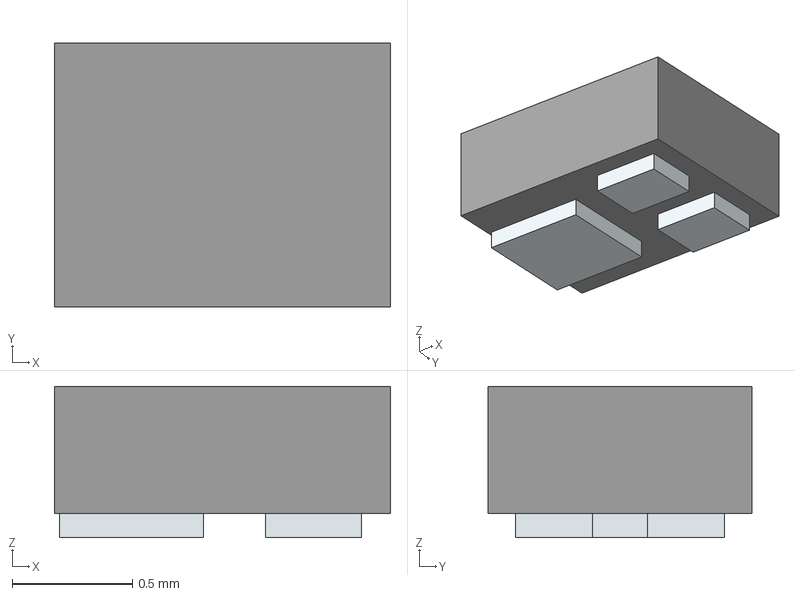
[picture p42: CAD file, 2023-12-21]
PCBs/component_library/watch_models/DMP2104LP-7.stp
1.40 x 1.10 x 0.63 mm
Pins
