ben5049/Smart-Watch/PCBs/component_library/watch_models/IM70D122V01.step

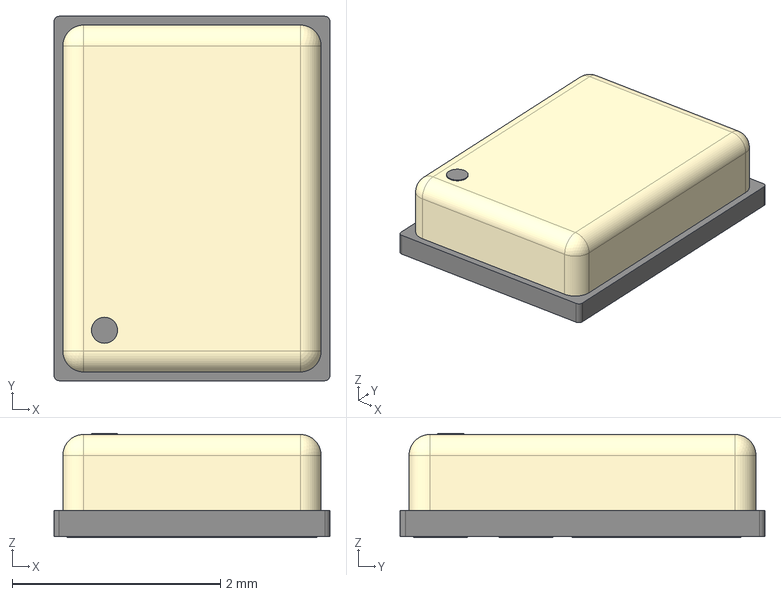
[picture p43: CAD file, 2023-12-21]
PCBs/component_library/watch_models/IM70D122V01.step
2.65 x 3.50 x 1.00 mm
