ben5049/Smart-Watch/PCBs/component_library/watch_models/TPD1E10B06DPYR.stp

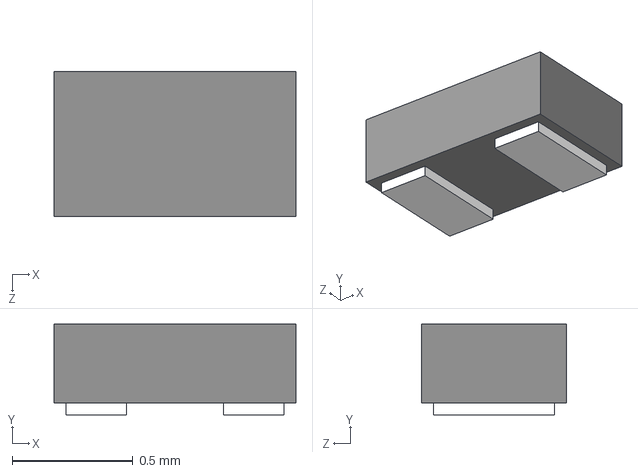
[picture p44: CAD file, 2023-12-21]
PCBs/component_library/watch_models/TPD1E10B06DPYR.stp
1.00 x 0.375 x 0.6 mm
