ben5049/Smart-Watch/PCBs/component_library/watch_models/BGA725L6E6327FTSA1.stp

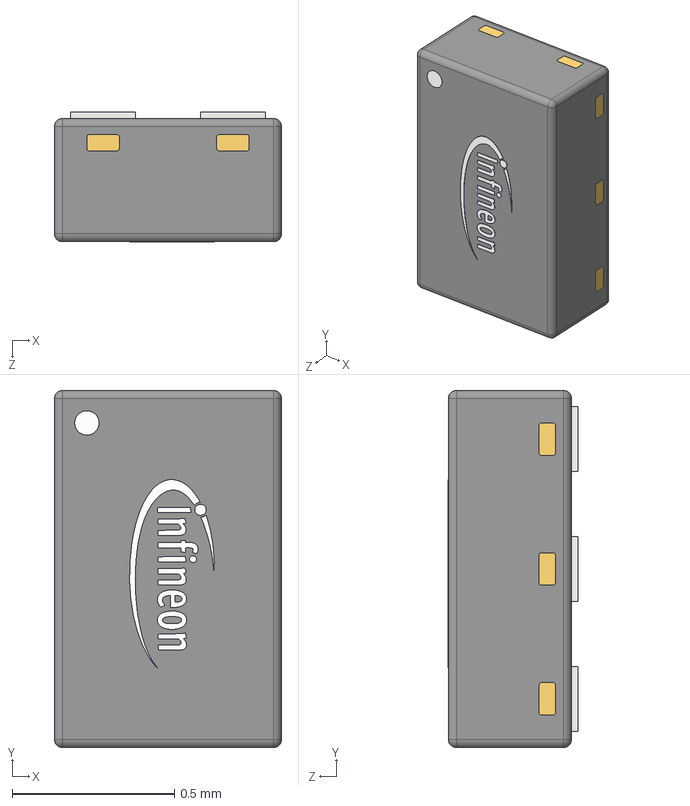
[picture p45: CAD file, 2023-12-21]
PCBs/component_library/watch_models/BGA725L6E6327FTSA1.stp
0.7 x 1.10 x 0.401 mm
BGA824N6E6327XTSA1
Infineon_Logo_1.4mm-LAPTOP-NQA1DCQ3
