ben5049/Smart-Watch/PCBs/component_library/watch_models/DMP21D5UFB4-7B.stp

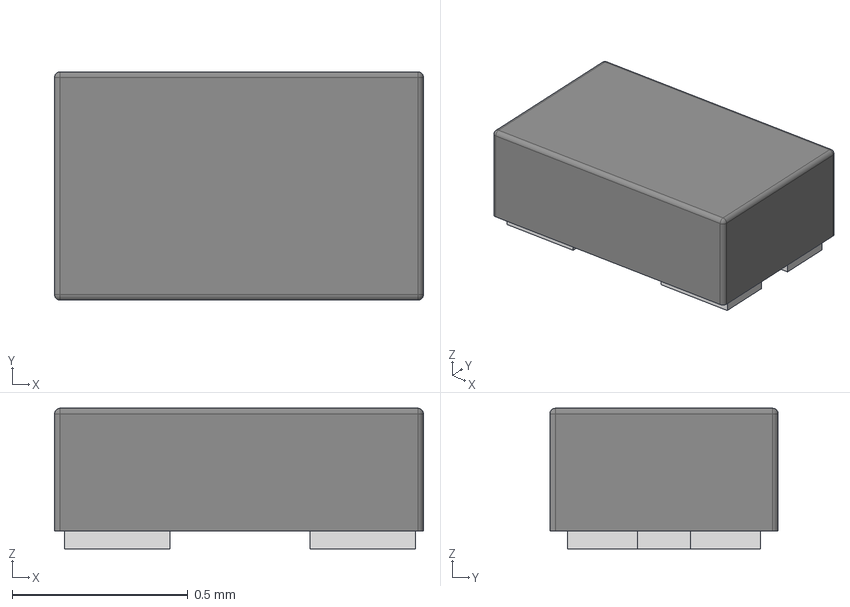
[picture p46: CAD file, 2023-12-20]
PCBs/component_library/watch_models/DMP21D5UFB4-7B.stp
1.05 x 0.65 x 0.4 mm
