ben5049/Smart-Watch/PCBs/component_library/watch_models/DMN21D2UFB-7B.stp

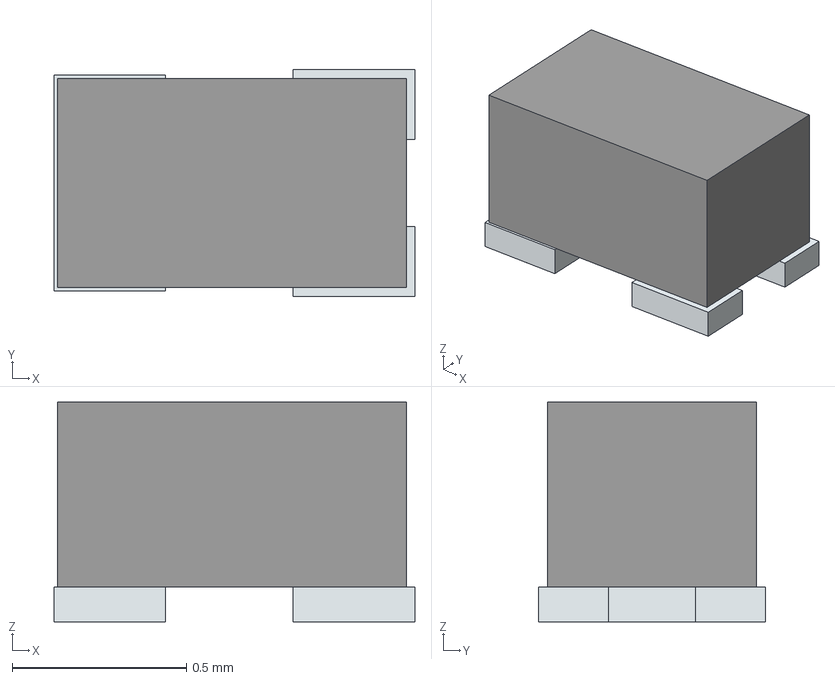
[picture p47: CAD file, 2023-12-20]
PCBs/component_library/watch_models/DMN21D2UFB-7B.stp
1.04 x 0.65 x 0.63 mm
Pins
