ben5049/Smart-Watch/PCBs/component_library/watch_models/IIS2MDCTR.stp

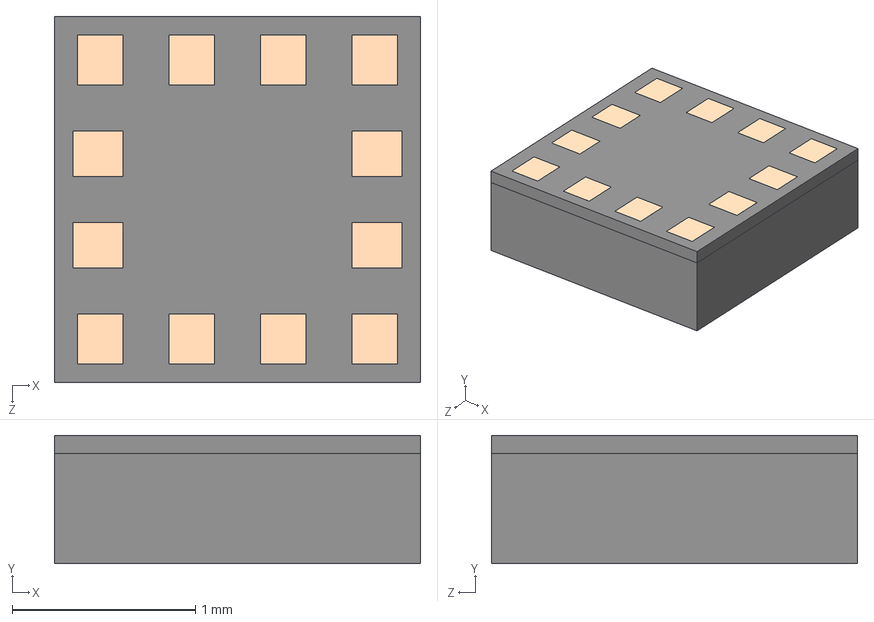
[picture p48: CAD file, 2023-12-19]
PCBs/component_library/watch_models/IIS2MDCTR.stp
2.00 x 0.7 x 2.00 mm
