ben5049/Smart-Watch/PCBs/component_library/watch_models/DRV2605LYZFR.stp

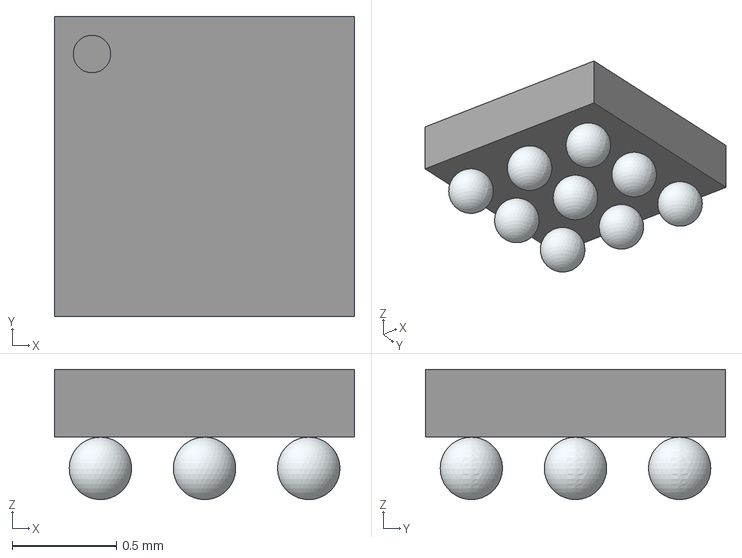
[picture p49: CAD file, 2023-12-19]
PCBs/component_library/watch_models/DRV2605LYZFR.stp
1.44 x 1.44 x 0.625 mm
