ben5049/Smart-Watch/PCBs/component_library/watch_models/MAX9027EBT+T.stp

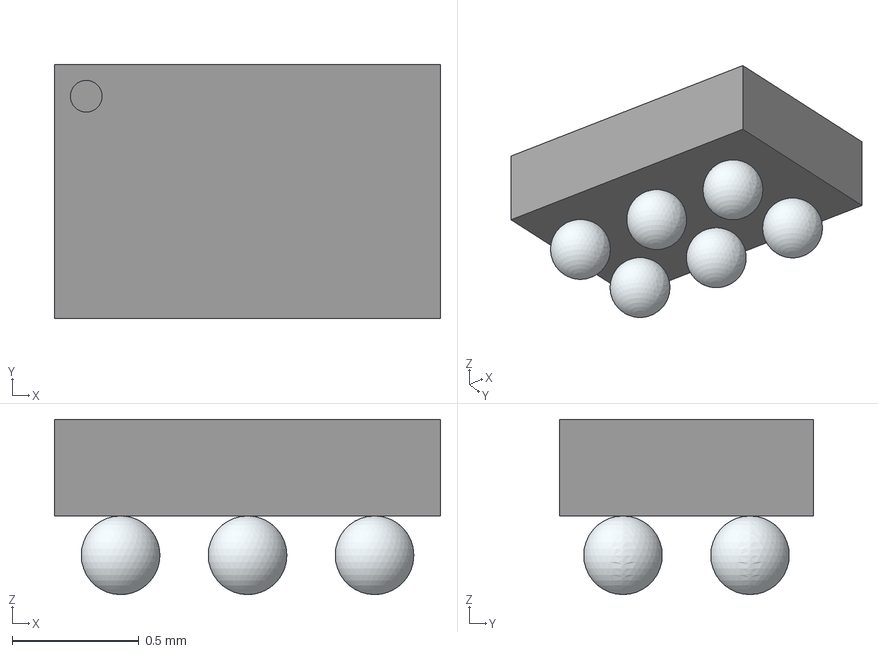
[picture p50: CAD file, 2023-12-17]
PCBs/component_library/watch_models/MAX9027EBT+T.stp
1.52 x 1.00 x 0.69 mm
