ben5049/Smart-Watch/PCBs/component_library/watch_models/TR1102-0491J.step

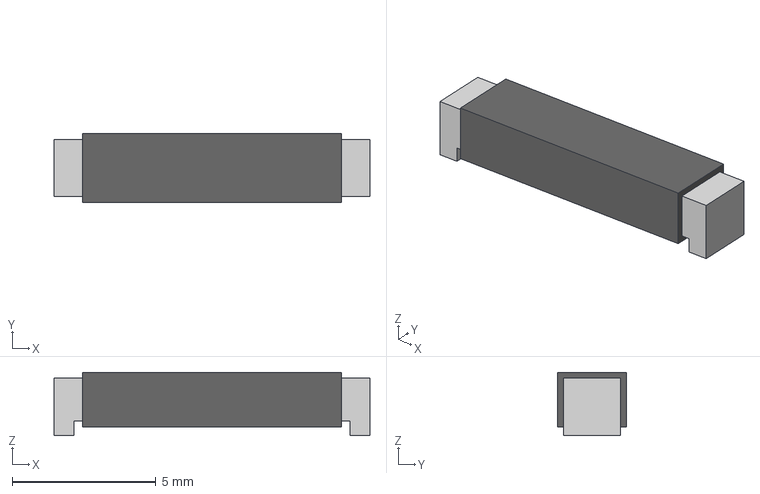
[picture p51: CAD file, 2023-12-17]
PCBs/component_library/watch_models/TR1102-0491J.step
11.0 x 2.40 x 2.20 mm
