ben5049/Smart-Watch/PCBs/component_library/watch_models/NRF5340-QKAA-R7.step

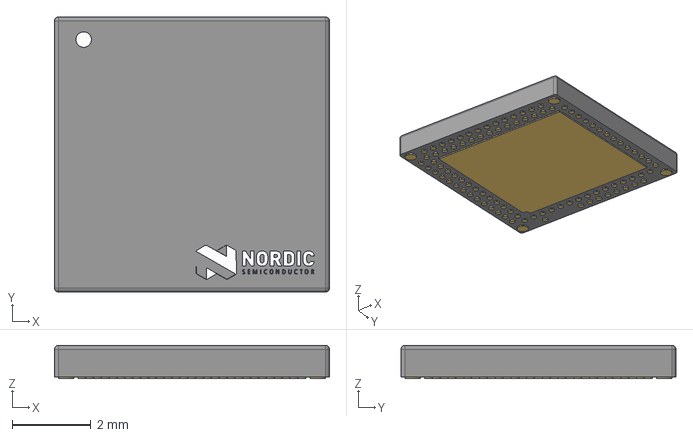
[picture p52: CAD file, 2023-12-17]
PCBs/component_library/watch_models/NRF5340-QKAA-R7.step
7.00 x 7.00 x 0.851 mm
