ben5049/Smart-Watch/PCBs/component_library/watch_models/NVT4858HKZ.stp

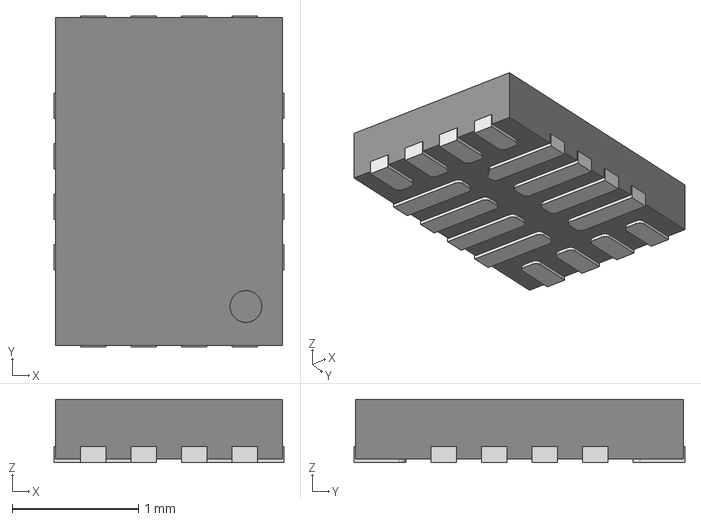
[picture p53: CAD file, 2023-12-13]
PCBs/component_library/watch_models/NVT4858HKZ.stp
1.82 x 2.62 x 0.5 mm
