ben5049/Smart-Watch/PCBs/component_library/watch_models/ICE40UP5K-UWG30ITR1K.stp

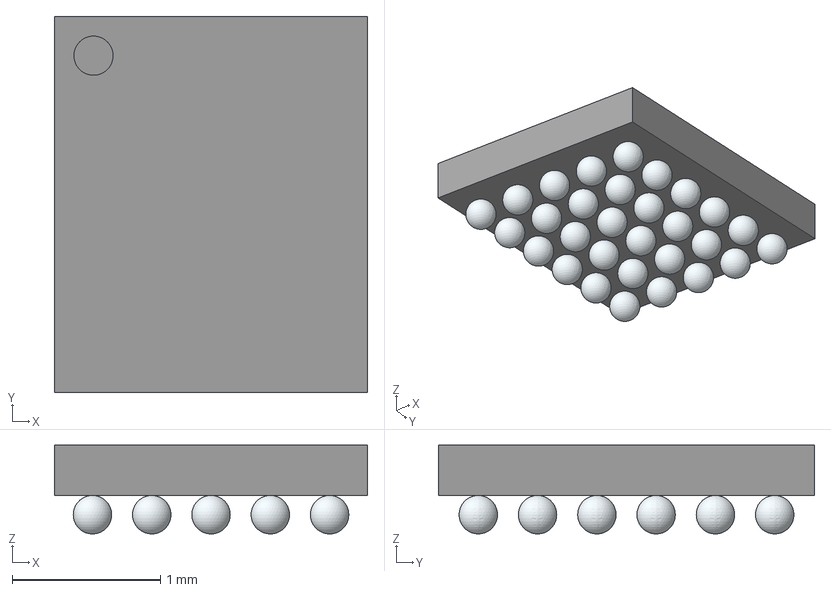
[picture p54: CAD file, 2023-12-12]
PCBs/component_library/watch_models/ICE40UP5K-UWG30ITR1K.stp
2.11 x 2.54 x 0.6 mm
