ben5049/Smart-Watch/PCBs/component_library/watch_models/TESEO-LIV3FL.stp

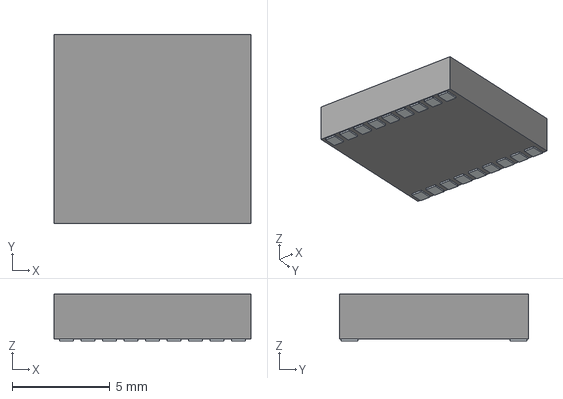
[picture p55: CAD file, 2023-12-12]
PCBs/component_library/watch_models/TESEO-LIV3FL.stp
10.1 x 9.70 x 2.40 mm
Pins
