ben5049/Smart-Watch/PCBs/component_library/watch_models/TXS0206-29YFPRB.stp

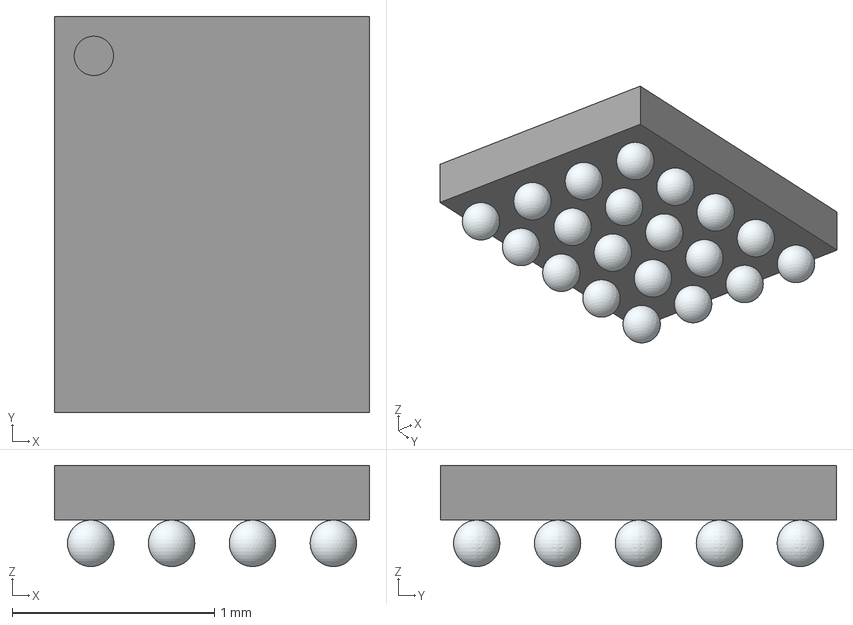
[picture p56: CAD file, 2023-12-12]
PCBs/component_library/watch_models/TXS0206-29YFPRB.stp
1.56 x 1.96 x 0.5 mm
