ben5049/Smart-Watch/PCBs/component_library/watch_models/TFBGA216_13X13_STM.step

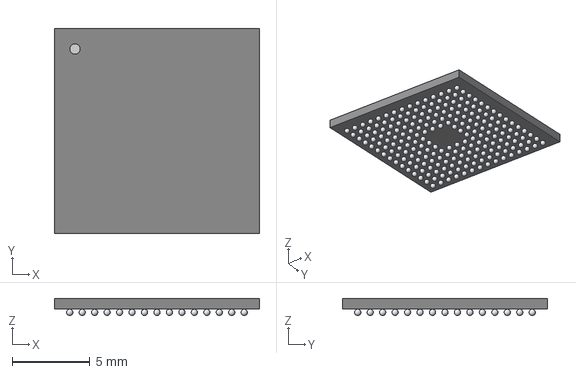
[picture p57: CAD file, 2023-12-12]
PCBs/component_library/watch_models/TFBGA216_13X13_STM.step
13.2 x 13.2 x 1.10 mm
