ben5049/Smart-Watch/PCBs/component_library/watch_models/ADP5360ACBZ-2-R7.stp

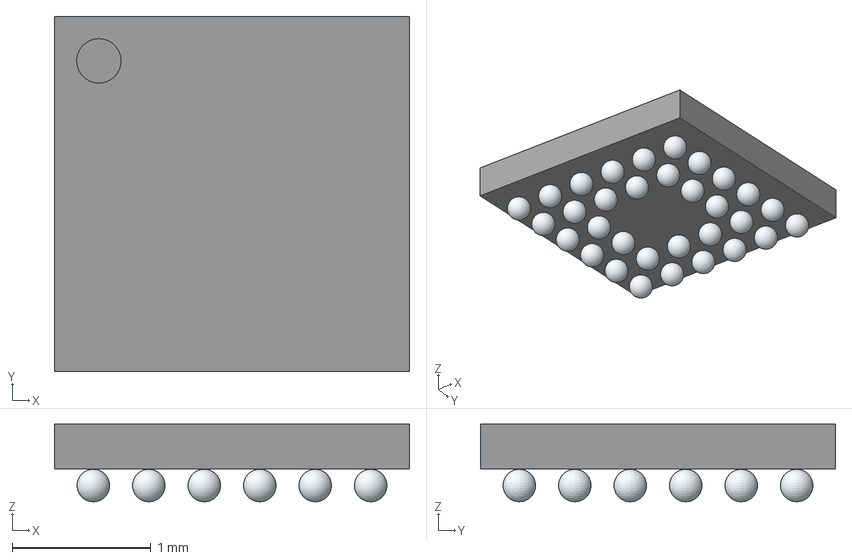
[picture p58: CAD file, 2023-12-12]
PCBs/component_library/watch_models/ADP5360ACBZ-2-R7.stp
2.56 x 2.56 x 0.56 mm
A1
A2
A3
A4
A5
A6
B1
B2
B3
B4
B5
B6
C1
C2
C5
C6
D1
D2
D5
D6
E1
E2
E3
E4
E5
E6
F1
F2
F3
F4
F5
F6
