ben5049/Smart-Watch/PCBs/component_library/watch_models/TLV9004SIRTER.stp

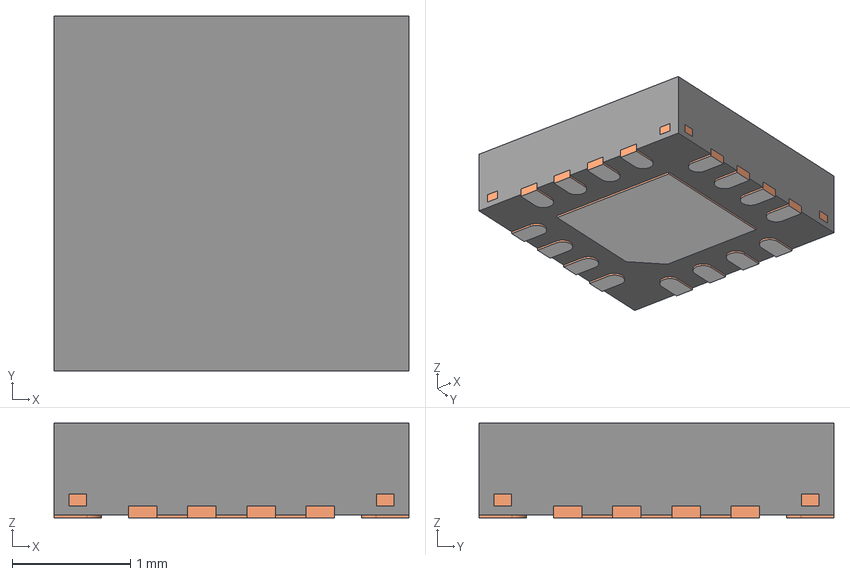
[picture p59: CAD file, 2023-12-12]
PCBs/component_library/watch_models/TLV9004SIRTER.stp
3.00 x 3.00 x 0.8 mm
BODY-QFN
FRAME-RTE0016C
PIN1-ID
