ben5049/Smart-Watch/PCBs/component_library/watch_models/Panasonic_-_EVP-AEJB2A.step

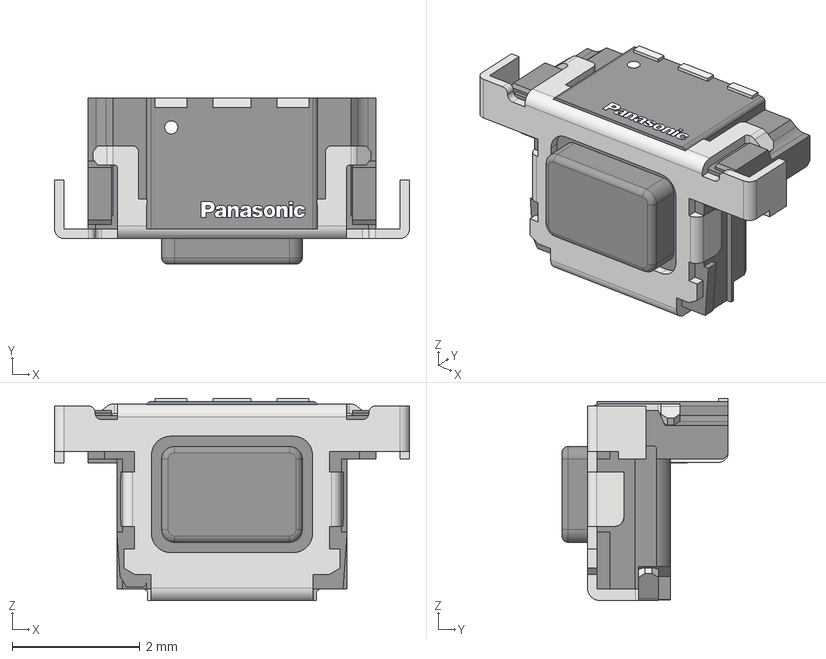
[picture p60: CAD file, 2023-12-12]
PCBs/component_library/watch_models/Panasonic_-_EVP-AEJB2A.step
5.55 x 2.60 x 3.16 mm
terminal
logo
