ben5049/Smart-Watch/PCBs/component_library/watch_models/S25HS512TFABHM010.stp

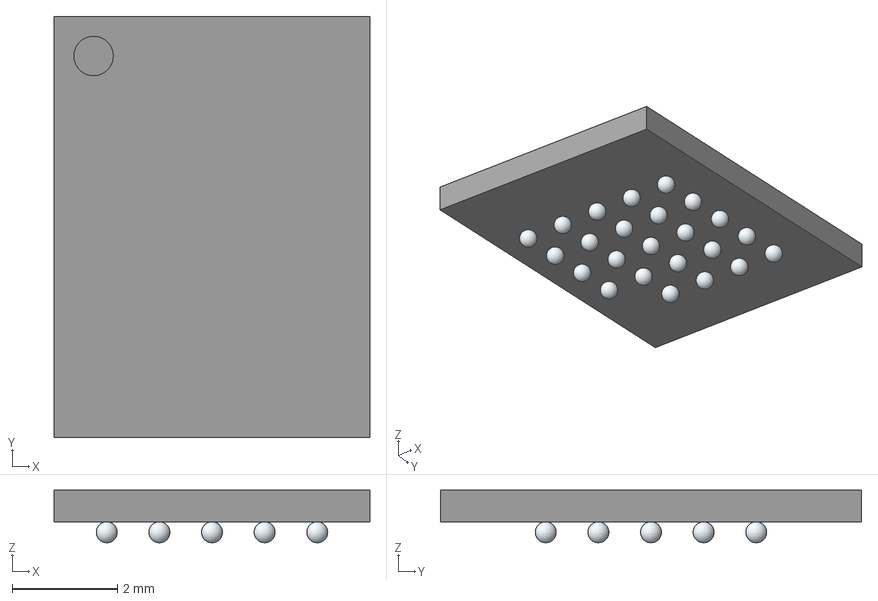
[picture p61: CAD file, 2023-12-12]
PCBs/component_library/watch_models/S25HS512TFABHM010.stp
6.00 x 8.00 x 1.00 mm
A2
A3
A4
A5
B1
B2
B3
B4
B5
C1
C2
C3
C4
C5
D1
D2
D3
D4
D5
E1
E2
E3
E4
E5
