ben5049/Smart-Watch/PCBs/component_library/watch_models/LGA14_LSM6_STM.step

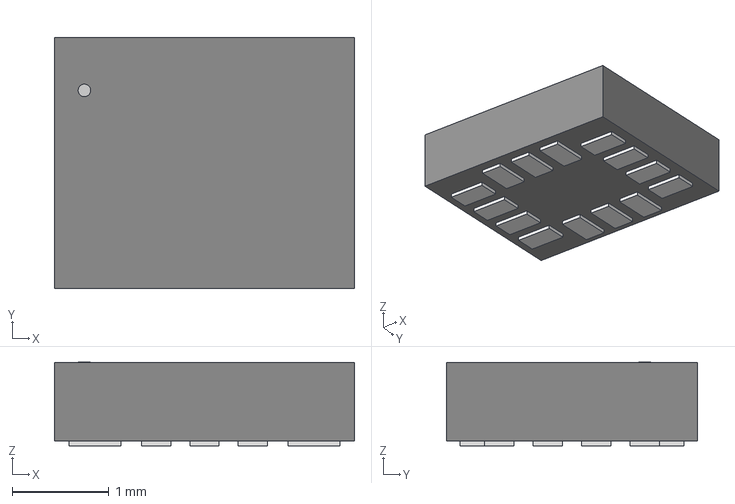
[picture p62: CAD file, 2023-12-12]
PCBs/component_library/watch_models/LGA14_LSM6_STM.step
3.10 x 2.59 x 0.866 mm
