ben5049/Smart-Watch/PCBs/component_library/watch_models/ADP5301ACBZ-3-R7.stp

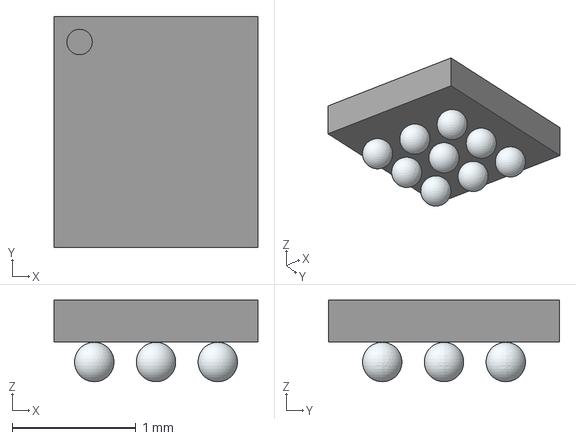
[picture p63: CAD file, 2023-12-12]
PCBs/component_library/watch_models/ADP5301ACBZ-3-R7.stp
1.65 x 1.87 x 0.66 mm
