ben5049/Smart-Watch/(list of files, cad)

Other CAD files:
PCBs/archived/rfid_module_v1/rfid_module.step
PCBs/component_library/watch_models/105162-0001.stp
PCBs/component_library/watch_models/500913-0242.stp
PCBs/component_library/watch_models/ANT161575TT-3000A1.stp
PCBs/component_library/watch_models/AXG110144A.stp
PCBs/component_library/watch_models/AXG120144.stp
PCBs/component_library/watch_models/AXG130144.stp
PCBs/component_library/watch_models/AXG220144.stp
PCBs/component_library/watch_models/B39162B4327P810.step
PCBs/component_library/watch_models/LQ05041QCS6.stp
PCBs/component_library/watch_models/M24256X-FCU6T_VF.stp
PCBs/component_library/watch_models/MAX17291BANT+T.stp
PCBs/component_library/watch_models/MAX30102EFD+T.step
PCBs/component_library/watch_models/NCP45525IMNTWG-H.stp
PCBs/component_library/watch_models/TPS65631WDSKR.stp
PCBs/component_library/watch_models/b82451l_e402.step
