ben5049/Smart-Watch/Documentation/LW11 Disassembly.md

# LW11 Disassembly

[TODO: COMPLETE DISASSEMBLY]

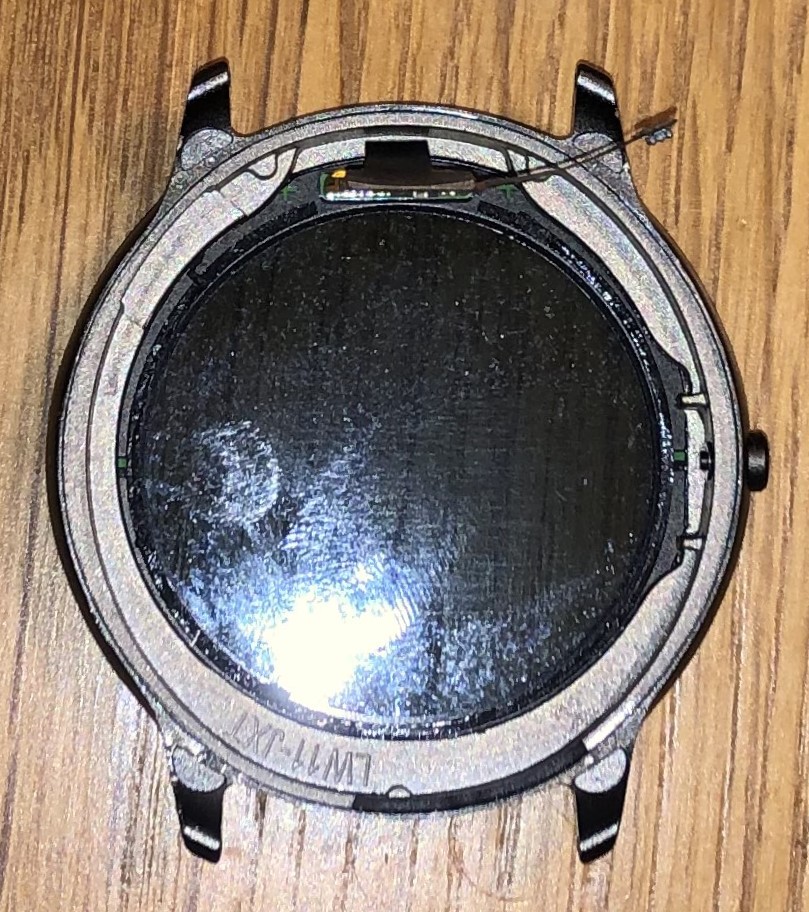
[picture p64: Documentation/Images/LW11_frame.jpg]
LW11_frame
