ben5049/Smart-Watch/Firmware/STM32/gui_ltdc_test/TouchGFX/assets/images/__generated/alternate_theme_images_backgrounds_480x480_shattered_rain_dark.png

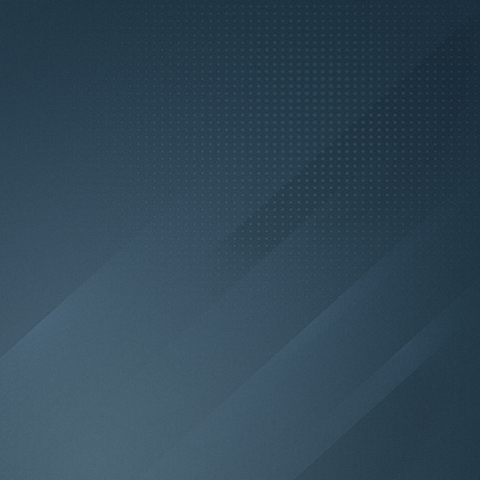
Firmware/STM32/gui_ltdc_test/TouchGFX/assets/images/__generated/alternate_theme_images_backgrounds_480x480_shattered_rain_dark.png
