ben5049/Smart-Watch/Firmware/STM32/gui_ltdc_test/TouchGFX/assets/images/Screenshot 2024-03-24 231733.png

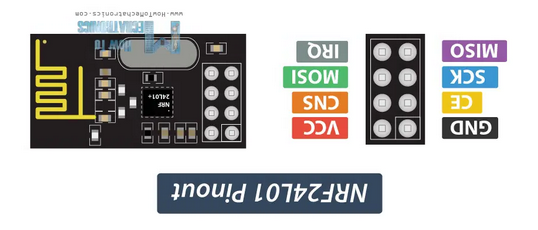
Firmware/STM32/gui_ltdc_test/TouchGFX/assets/images/Screenshot 2024-03-24 231733.png
