ben5049/Smart-Watch/PCBs/rfid_module_v1.1/rfid_module.pdf

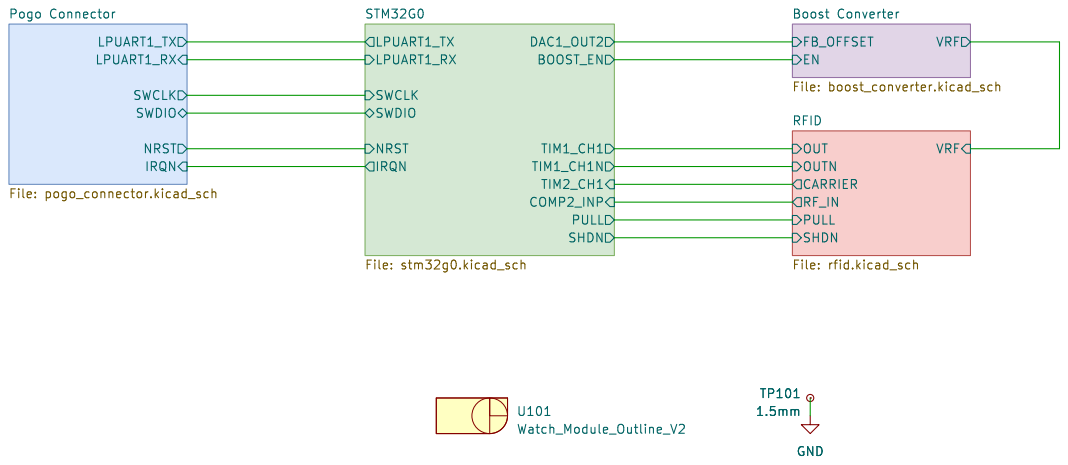
[picture p67: page 1]

Boost Converter File: boost_converter.kicad_sch GND

SWCLK
Id: 1/5 Title: File: rfid_module.kicad_sch Sheet: / PULL SWDIO

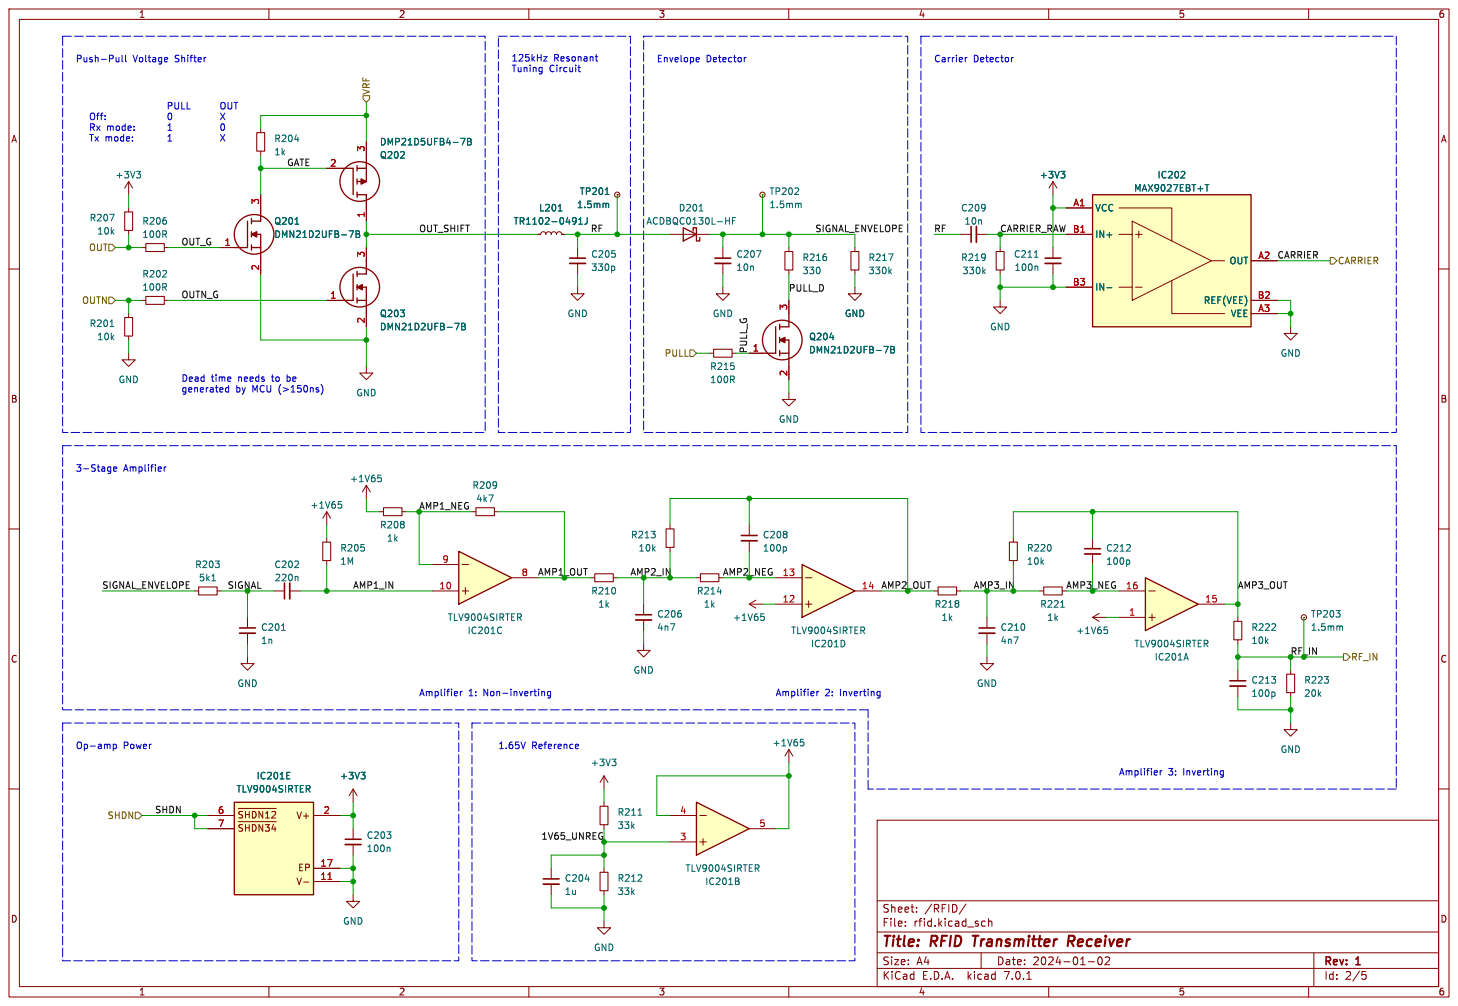
[picture p68: page 2]

PULL OUT Off: 0 X Rx mode: 1 0 Tx mode: 1 X

Id: 2/5 Title: RFID Transmitter Receiver File: rfid.kicad_sch Sheet: /RFID/ R209

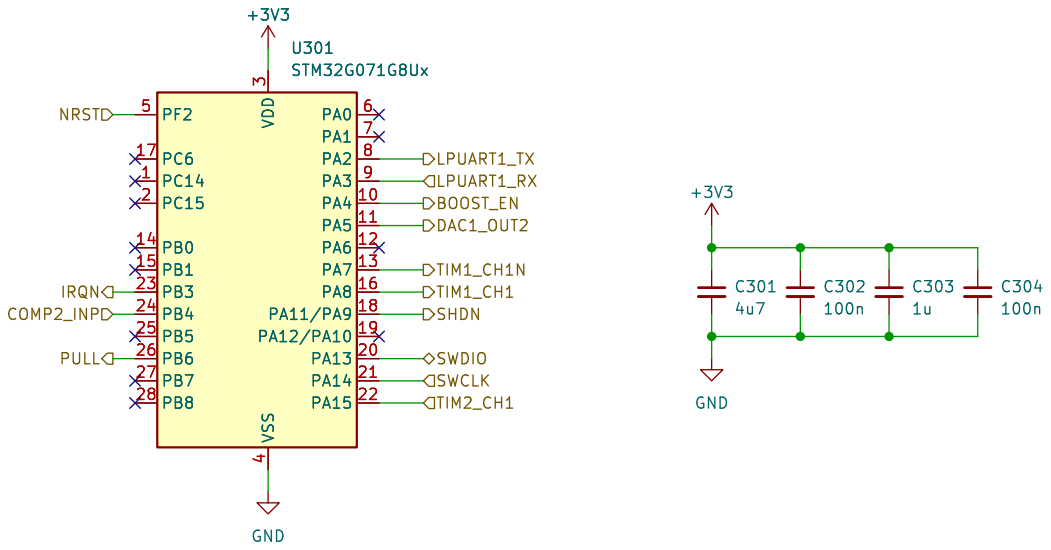
[picture p69: page 3]

Id: 3/5 Title: File: stm32g0.kicad_sch Sheet: /STM32G0/ GND

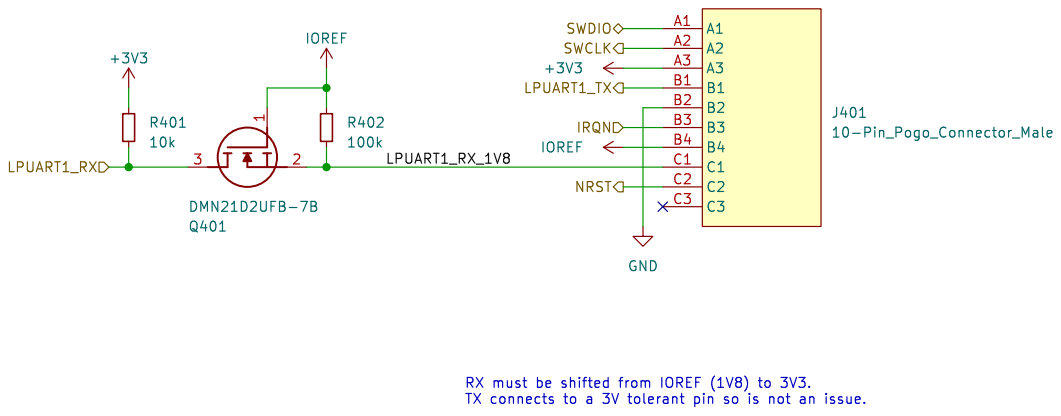
[picture p70: page 4]

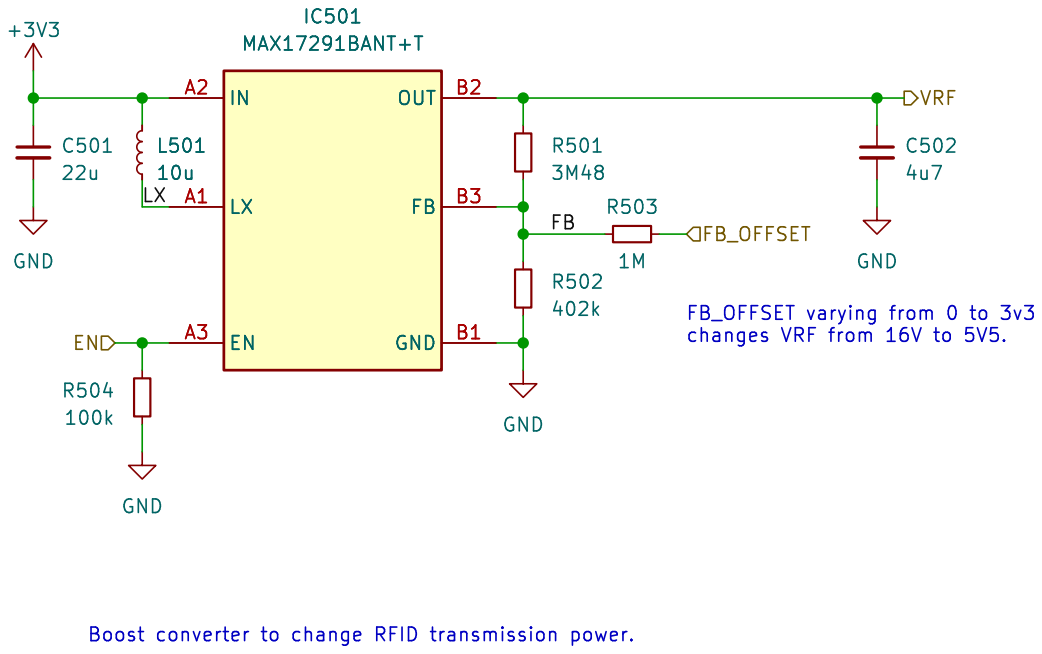
[picture p71: page 5]
