ben5049/Smart-Watch/PCBs/watch_lower/watch_lower.pdf

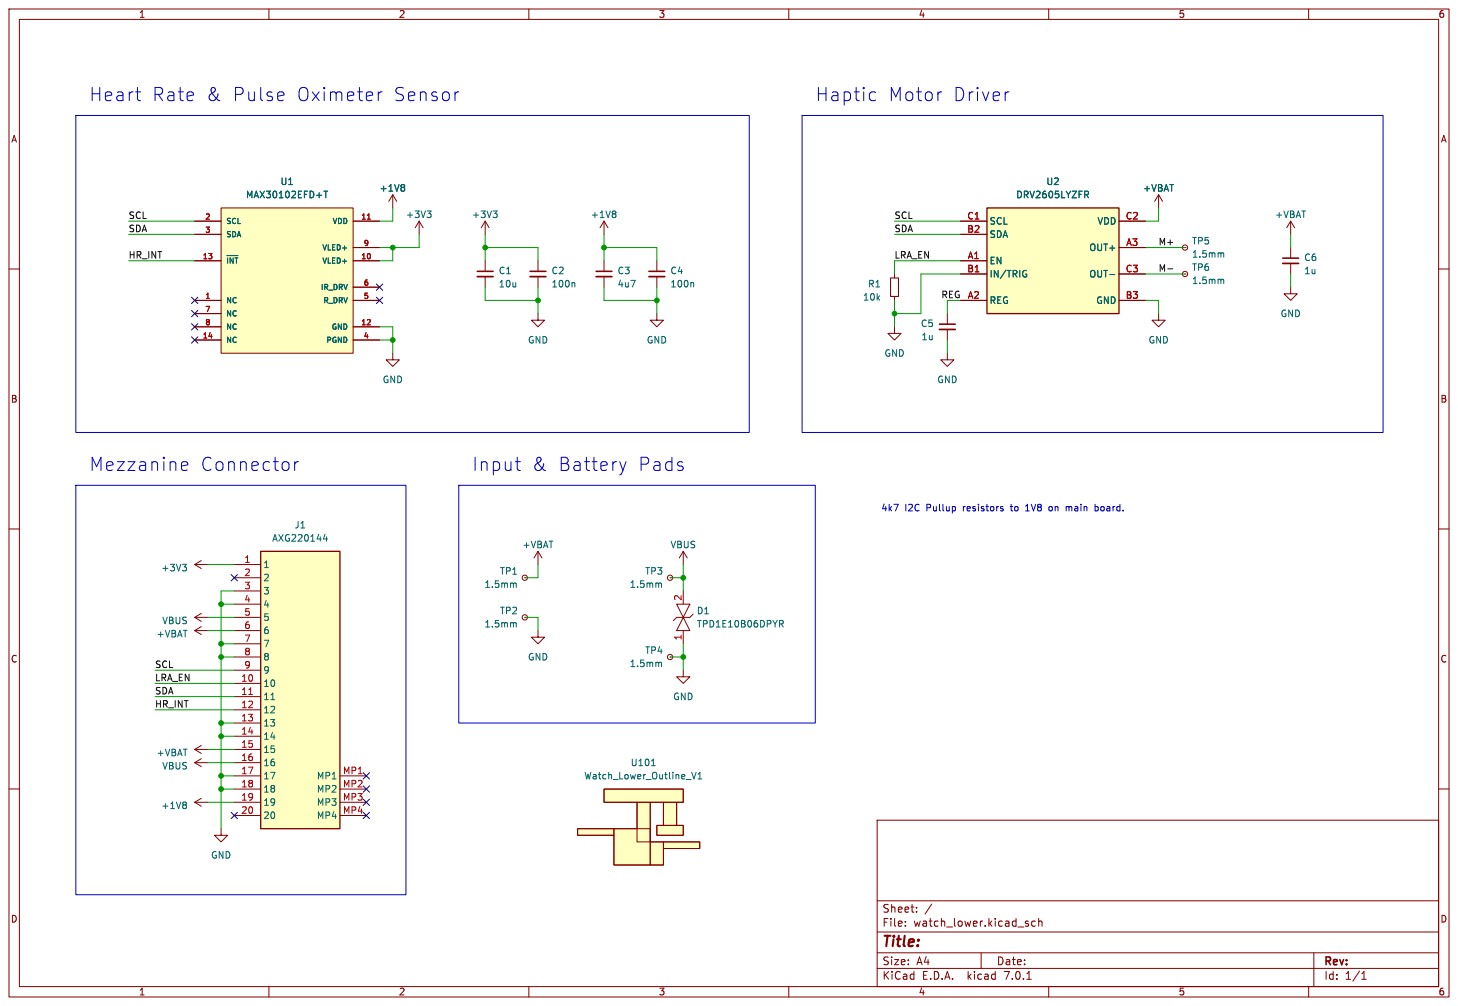
[picture p72: page 1]

Id: 1/1 Title: File: watch_lower.kicad_sch Sheet: / U101 Watch_Lower_Outline_V1 GND
