ben5049/Smart-Watch/PCBs/module_test_rig/module_test_rig.pdf

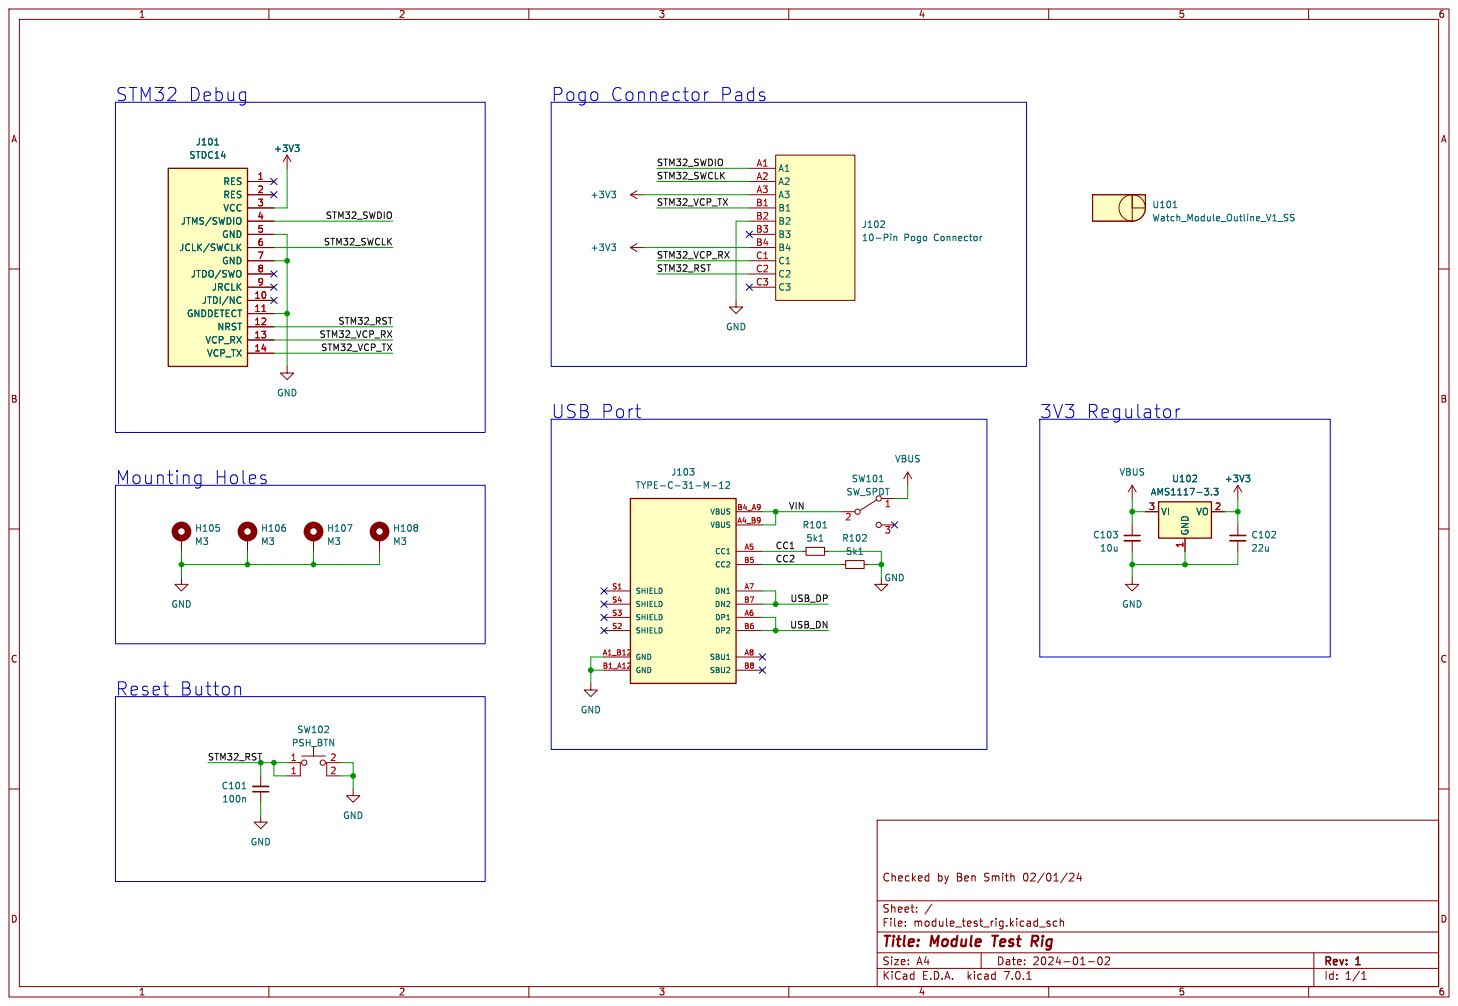
[picture p73: page 1]

Id: 1/1 Title: Module Test Rig
