ben5049/Smart-Watch/PCBs/watch_test_rig_v2/watch_test_rig.pdf

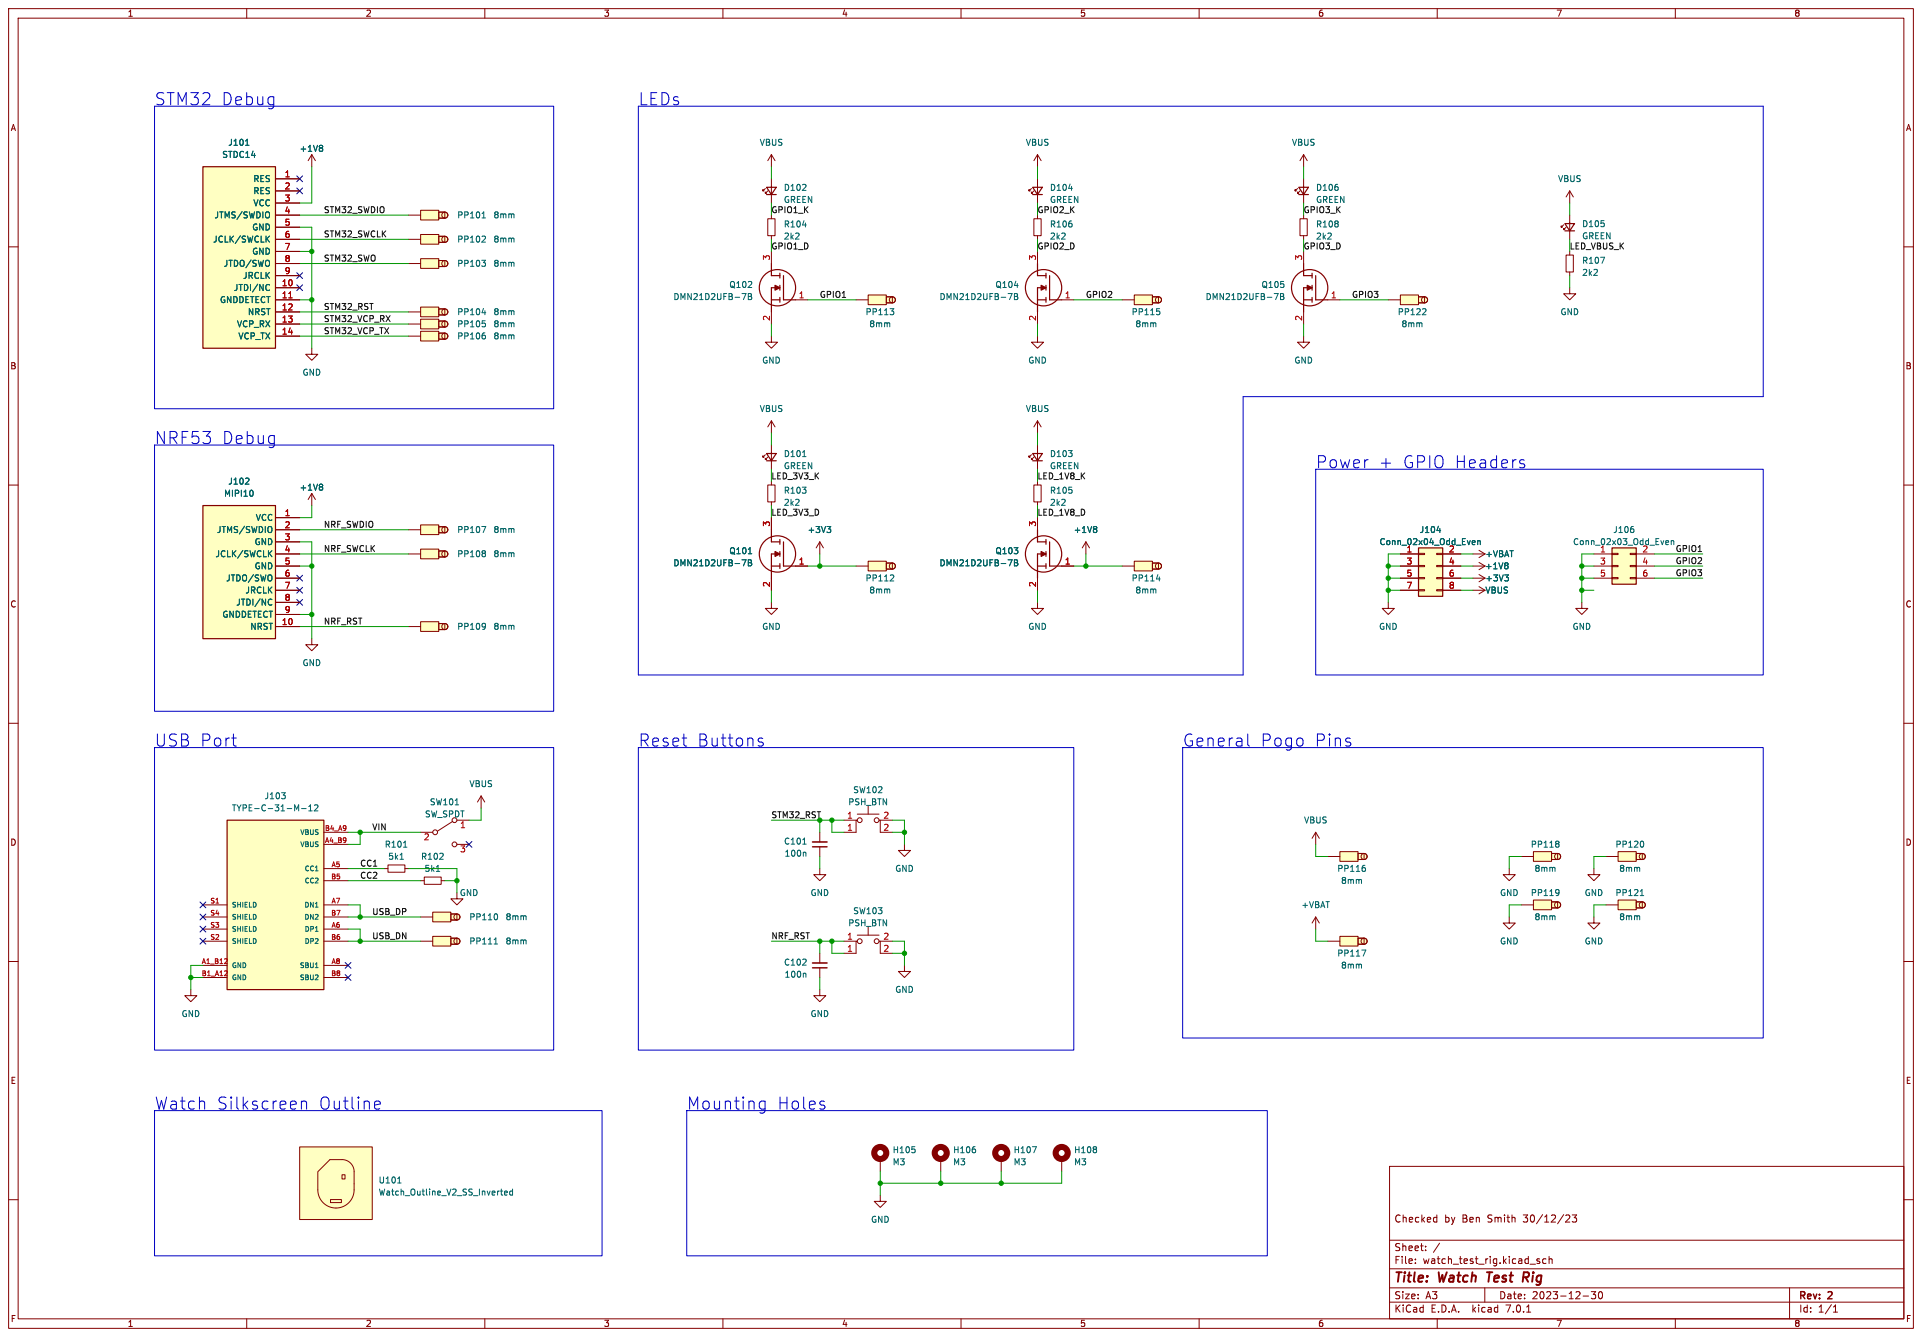
[picture p74: page 1]

Id: 1/1 Title: Watch Test Rig
