ben5049/Smart-Watch/PCBs/watch_main_v2/watch_main.pdf

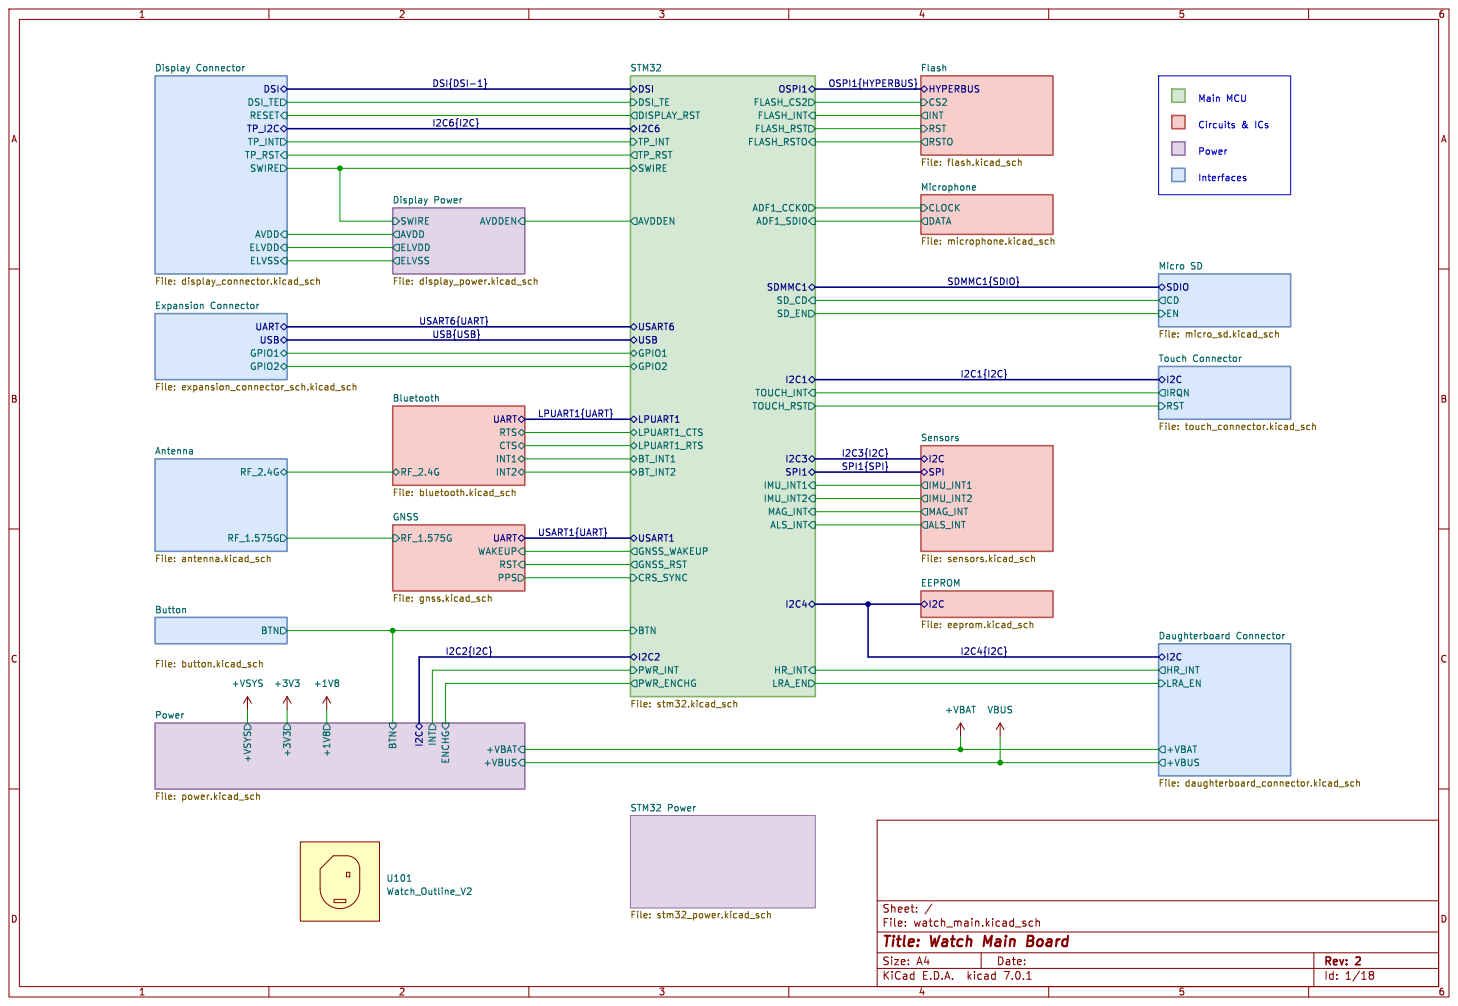
[picture p75: page 1]

Interfaces Power Main MCU

Antenna File: antenna.kicad_sch BTN

File: watch_main.kicad_sch Sheet: /
Id: 1/18 Title: Watch Main Board

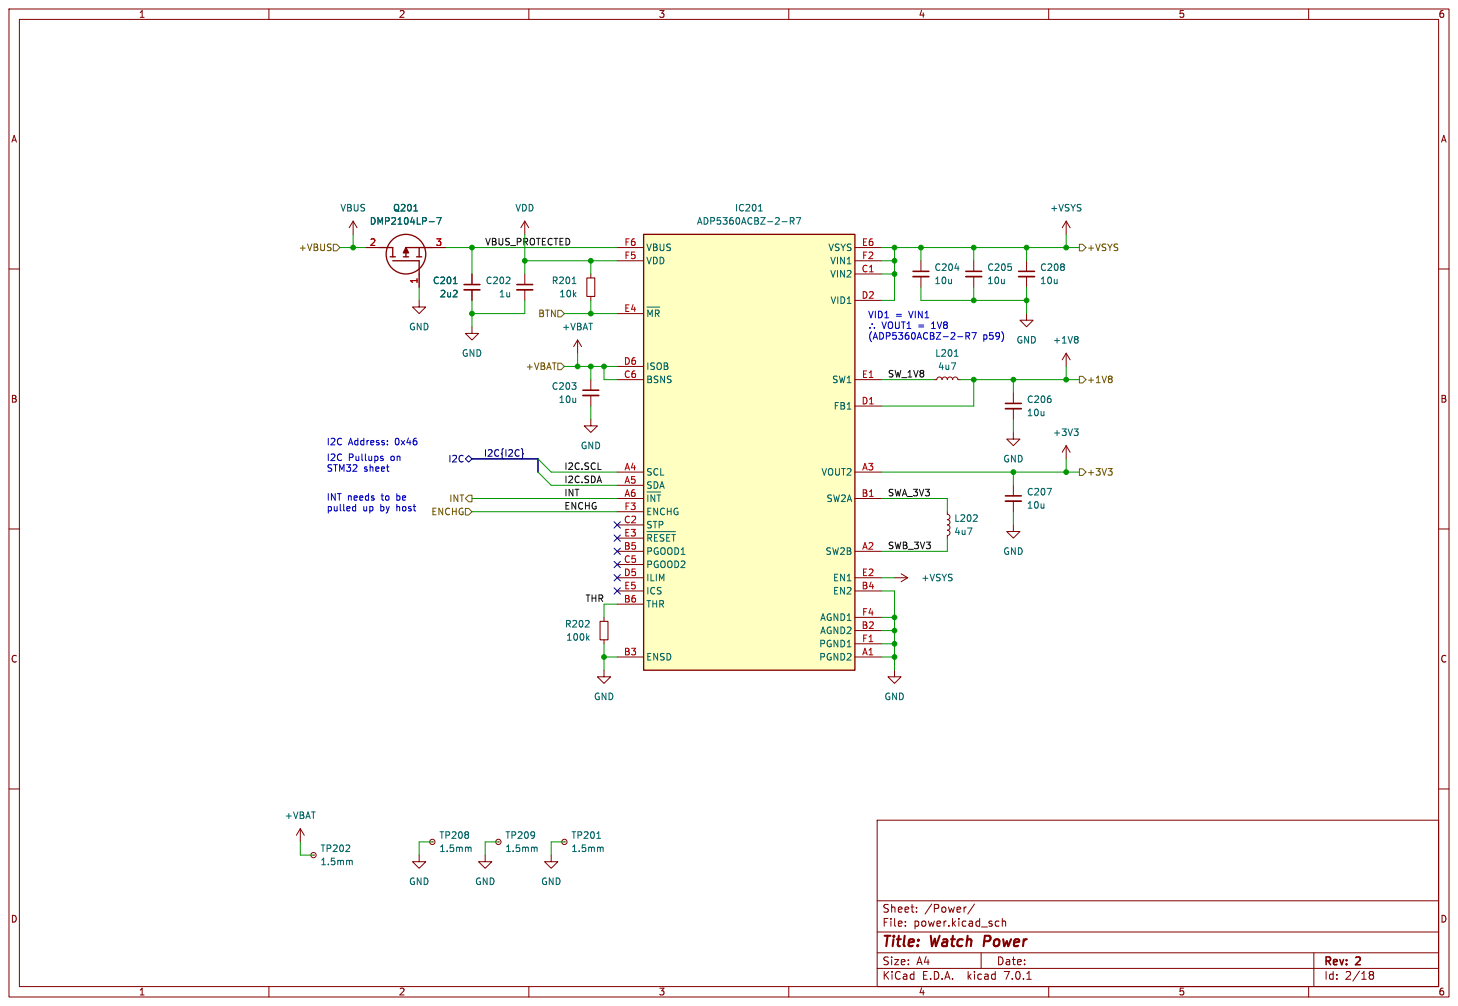
[picture p76: page 2]

INT needs to be
pulled up by host

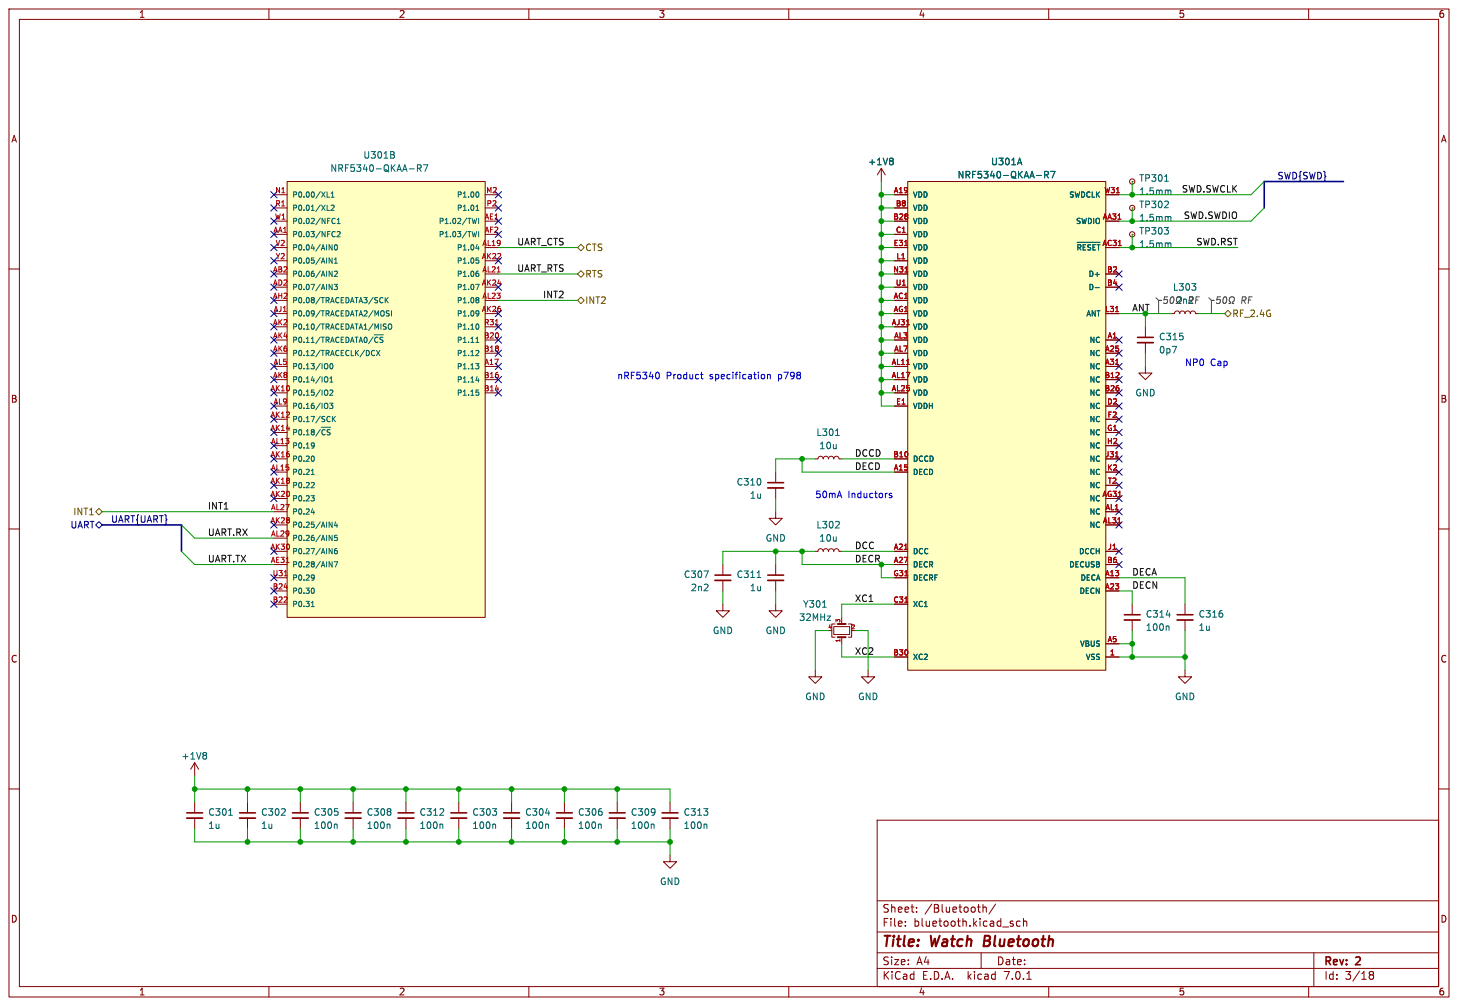
[picture p77: page 3]

SWD.RST SWD.SWDIO

Id: 3/18 Title: Watch Bluetooth

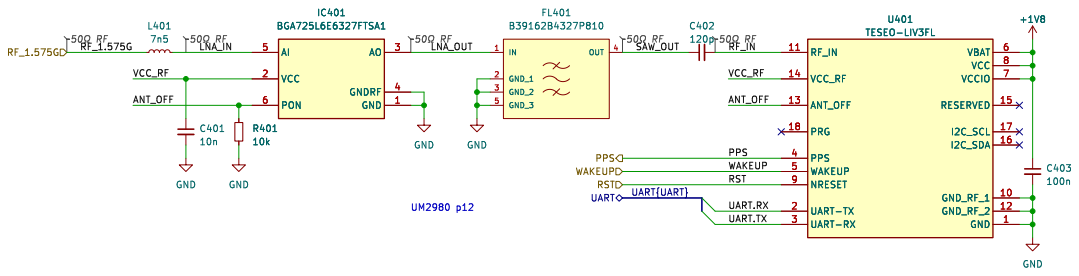
[picture p78: page 4]

Id: 4/18 Title: Watch GNSS

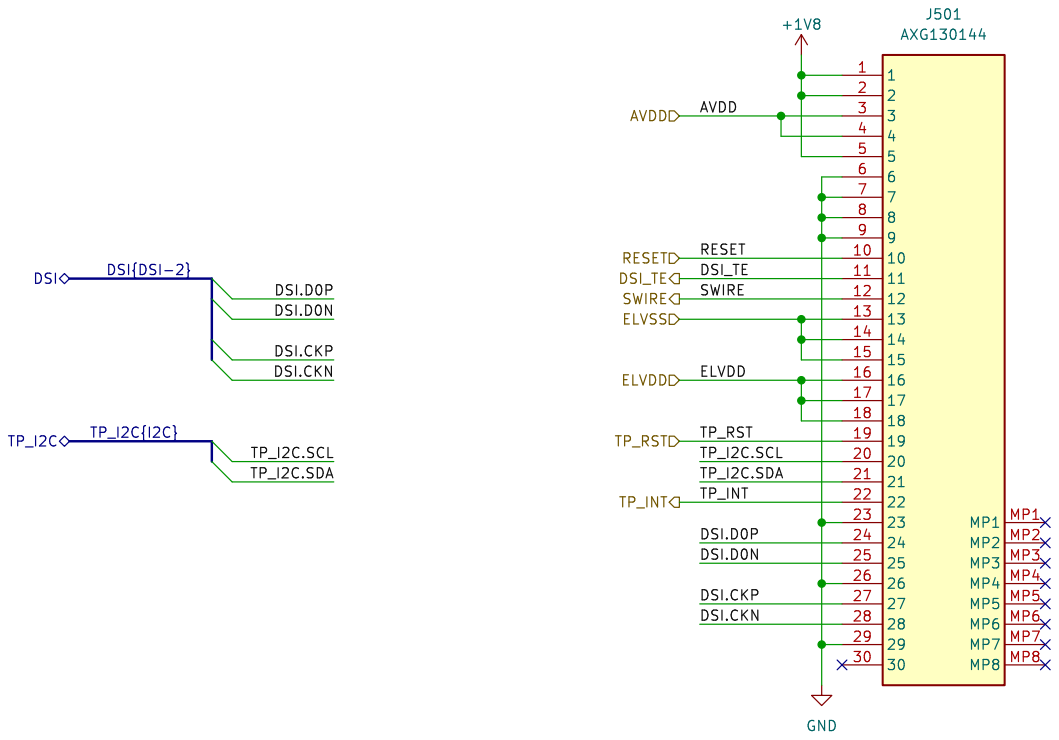
[picture p79: page 5]

DSI.CKP DSI.D0P DSI{DSI-2}

DSI.D0P DSI.CKP DSI.CKN
DSI.D0N

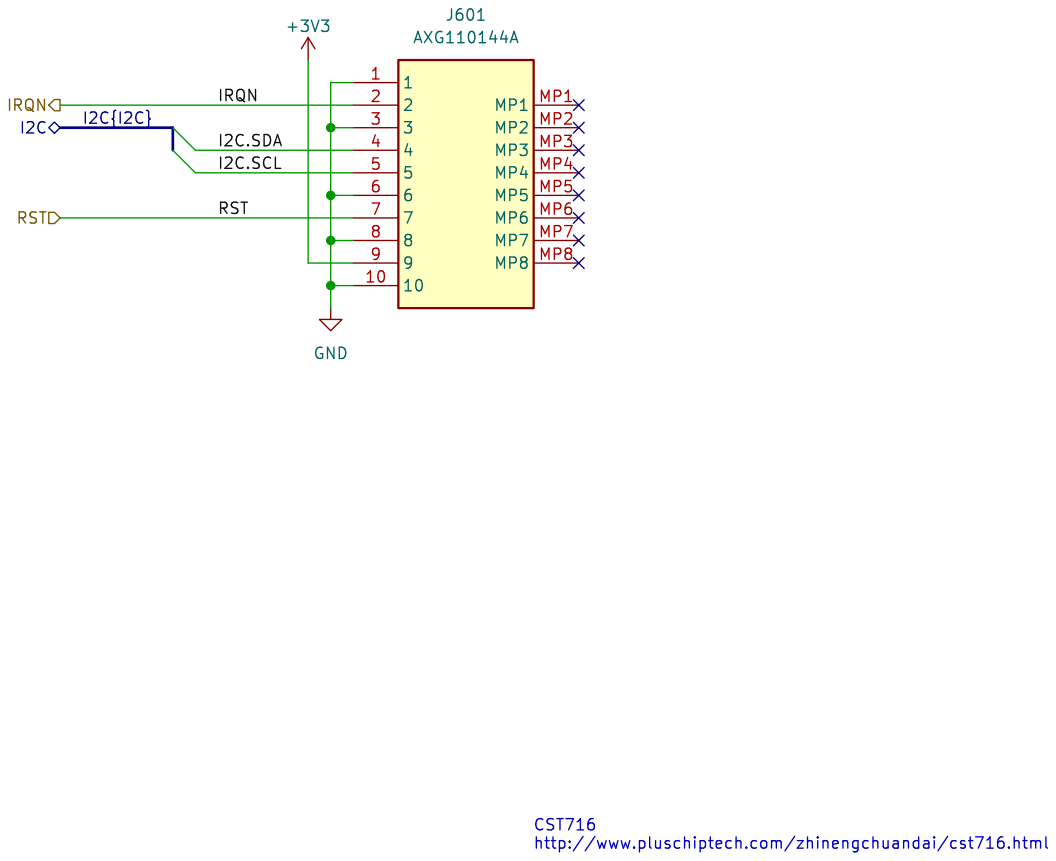
[picture p80: page 6]

http://www.pluschiptech.com/zhinengchuandai/cst716.html

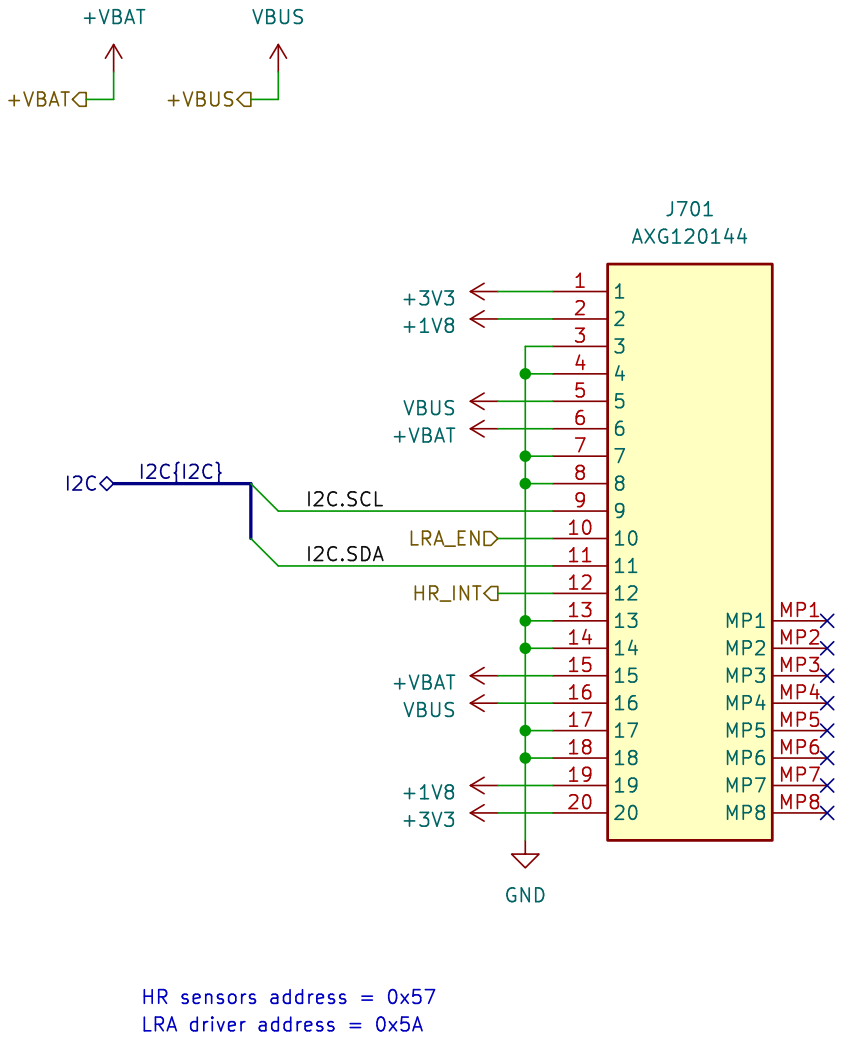
[picture p81: page 7]

LRA driver address = 0x5A HR sensors address = 0x57

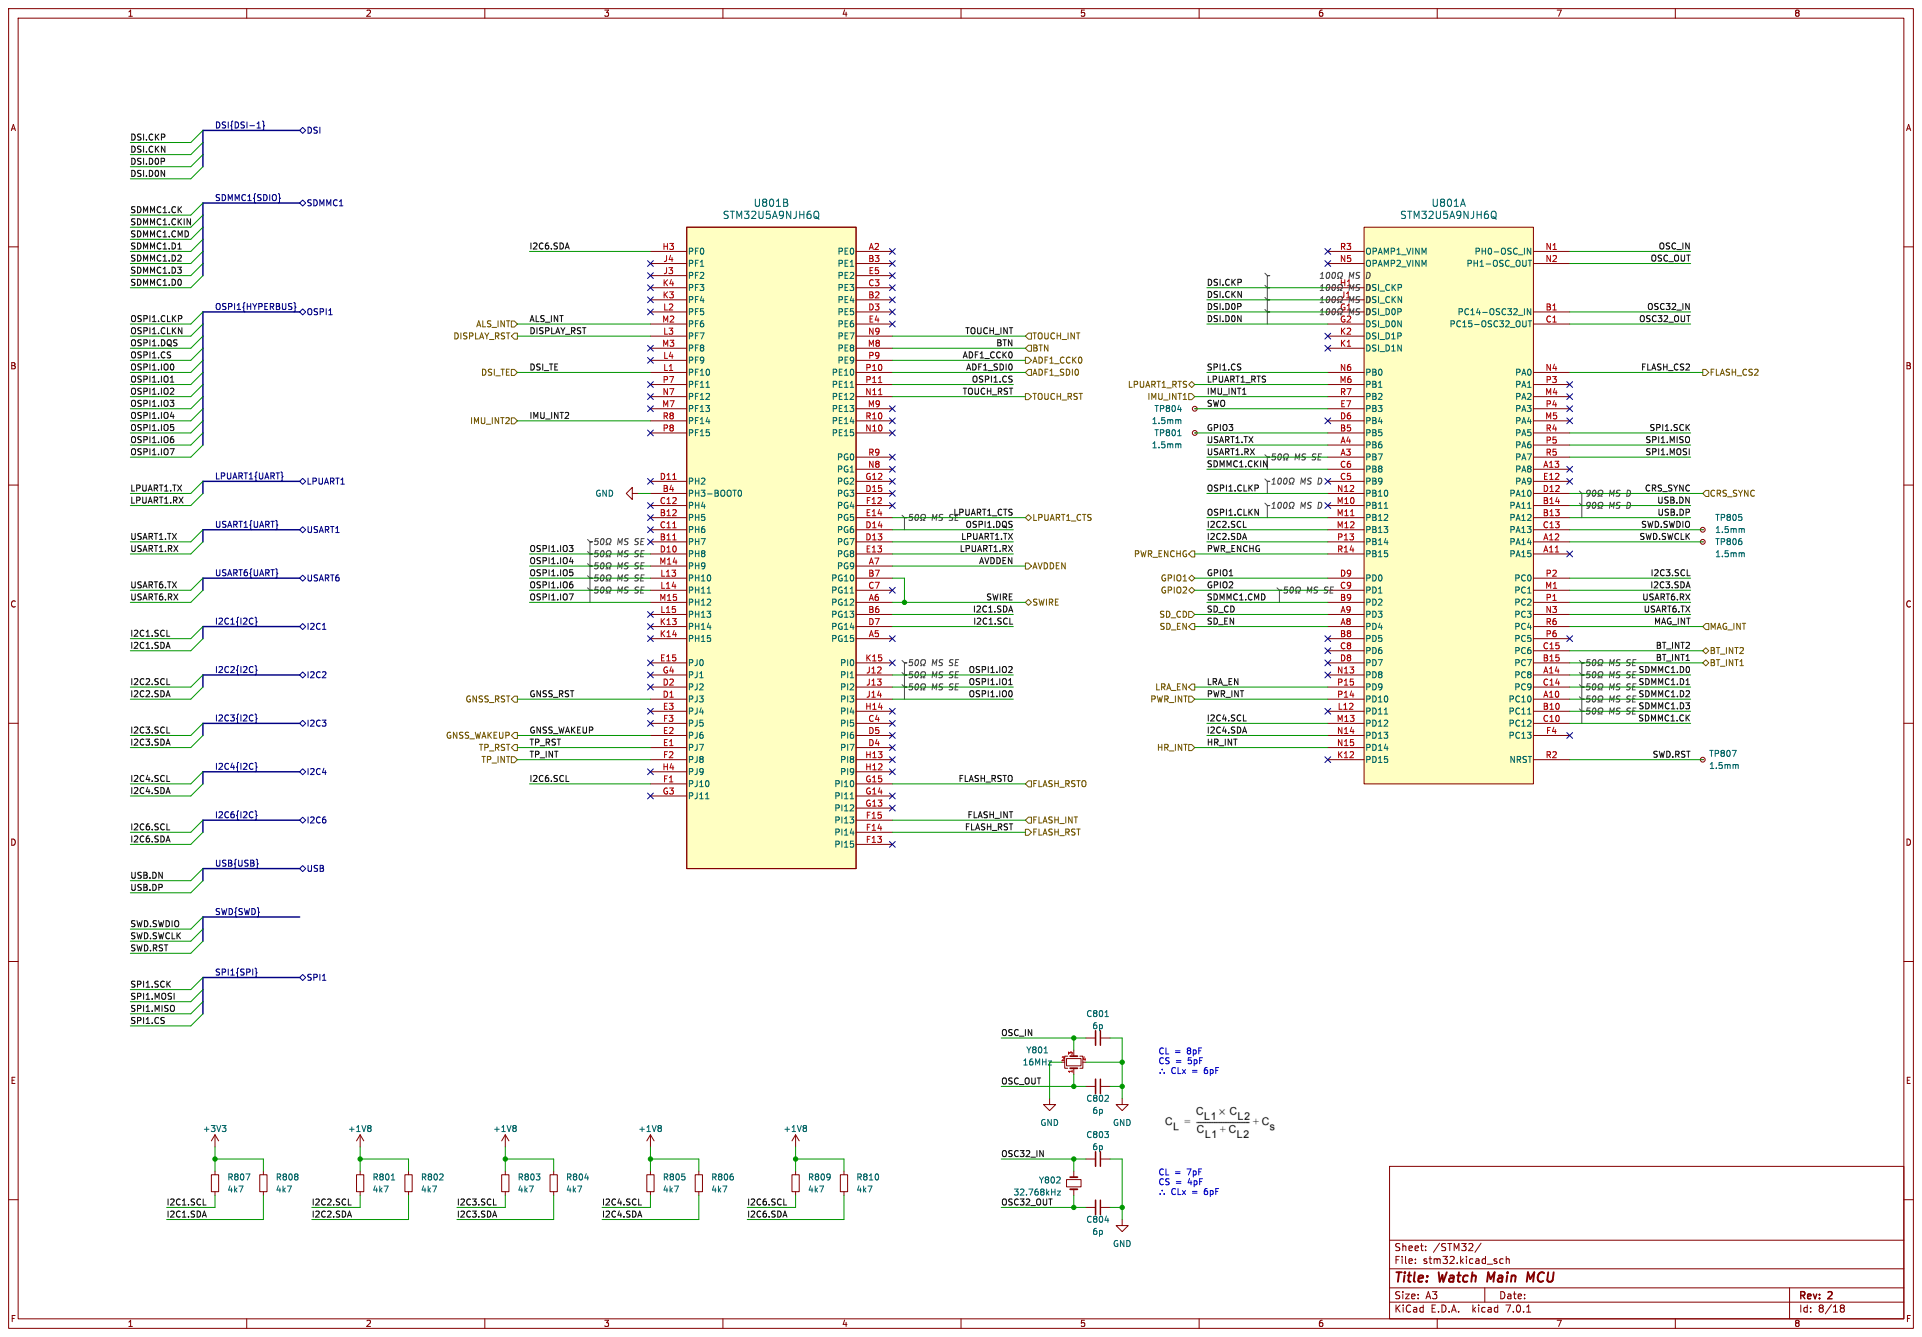
[picture p82: page 8]

DSI.CKP DSI.D0N
DSI.CKN
DSI.D0P
SDMMC1.D2 SDMMC1.D1 OSPI1.IO4 OSPI1.IO5 OSPI1.IO6 OSPI1.IO7 OSPI1.IO3 OSPI1.IO0 OSPI1.IO2 OSPI1.IO1
LPUART1.TX USART1.TX OSPI1.CLKP OSPI1.DQS OSPI1.CLKN

SWD.SWDIO
SWD.RST SWD.SWCLK

Id: 8/18 Title: Watch Main MCU

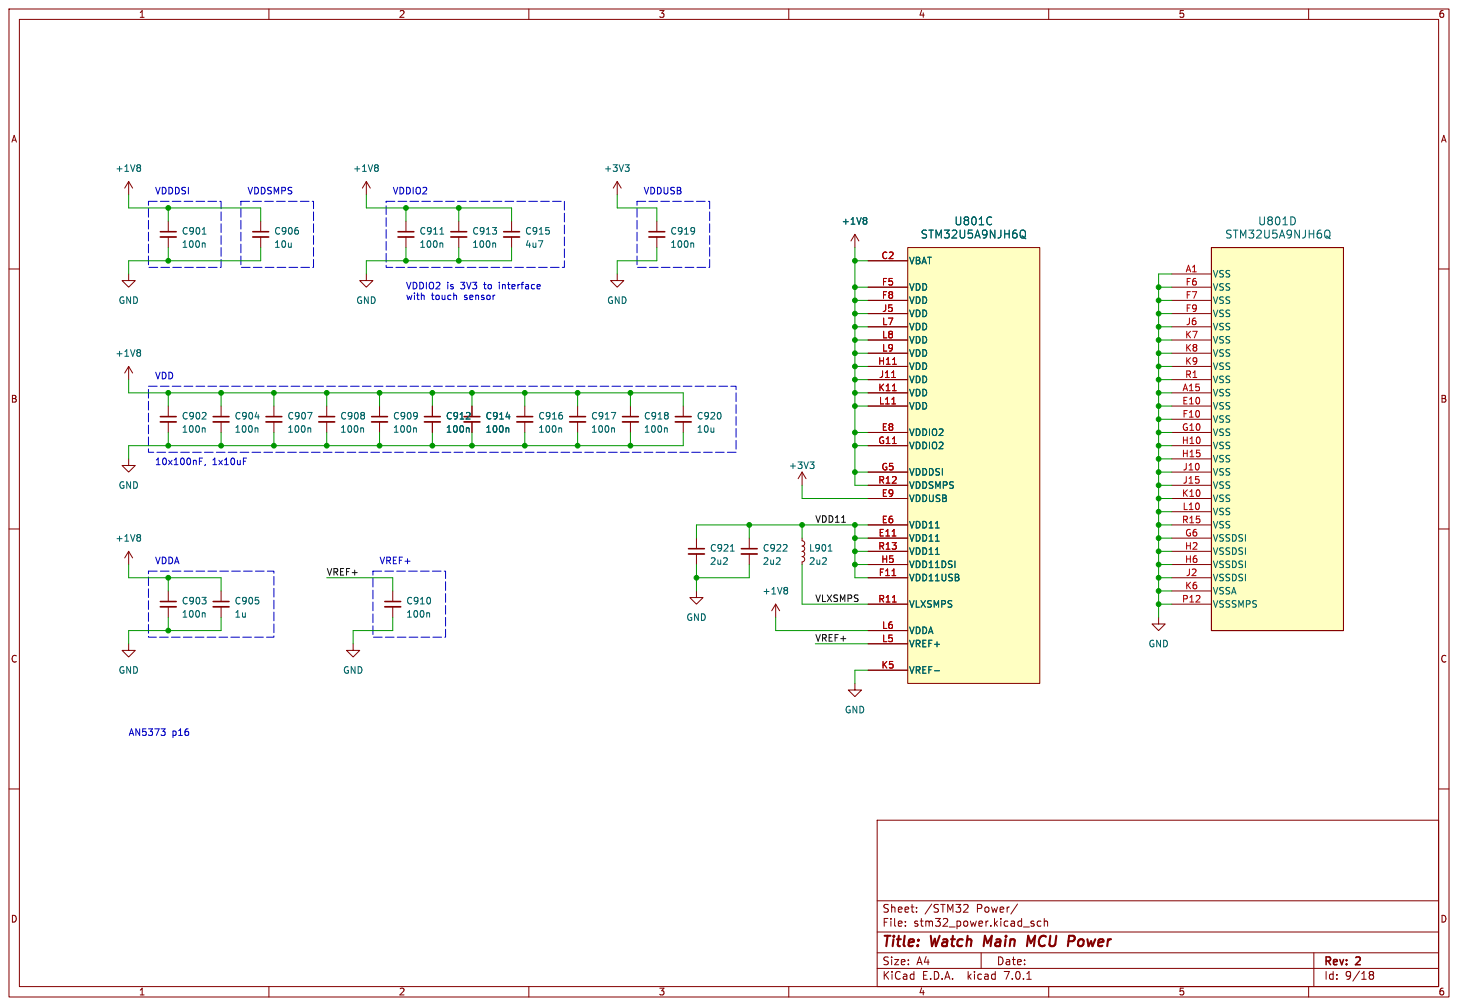
[picture p83: page 9]

VDDIO2 is 3V3 to interface with touch sensor AN5373 p16 VDDA
100n GND GND

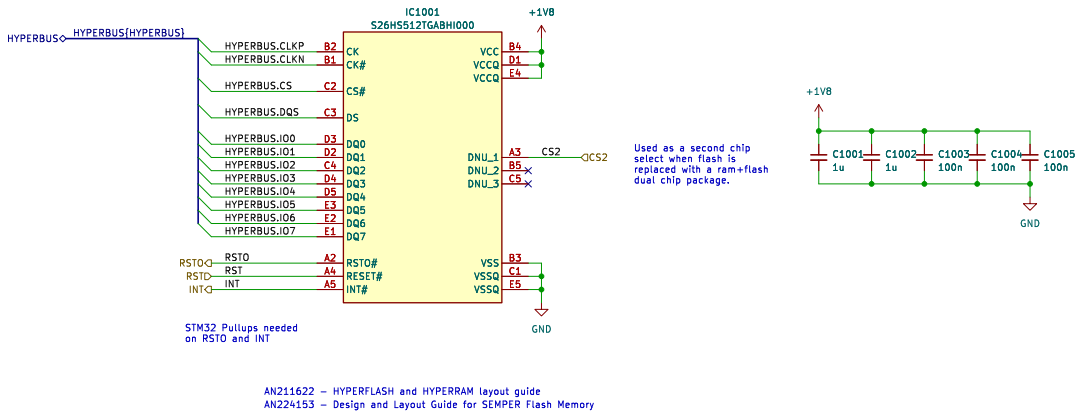
[picture p84: page 10]

select when flash is
replaced with a ram+flash

File: flash.kicad_sch Sheet: /Flash/
Id: 10/18 Title: Watch Flash

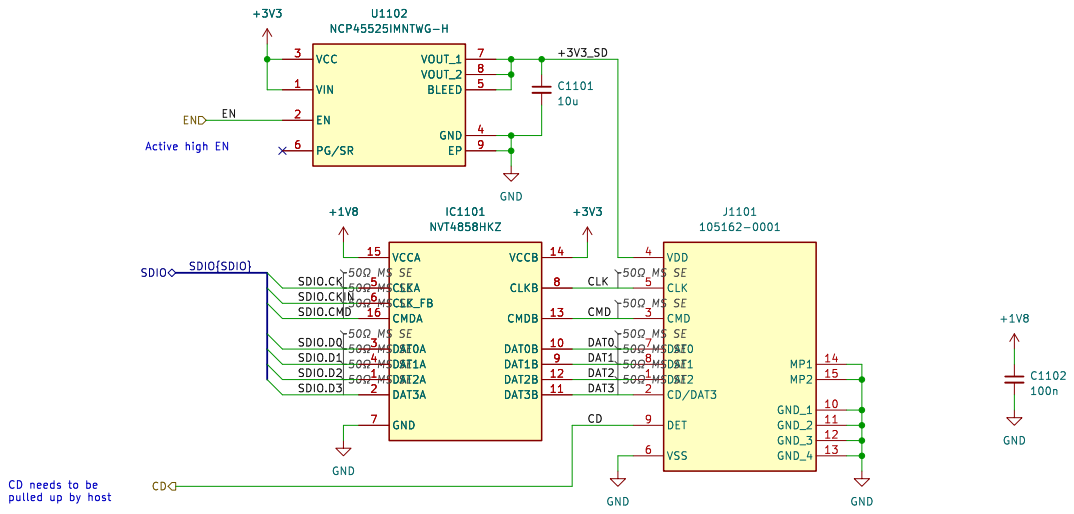
[picture p85: page 11]

DAT1 DAT3 SDIO.D1 Active high EN

CD needs to be

Id: 11/18 Title: Watch Micro SD

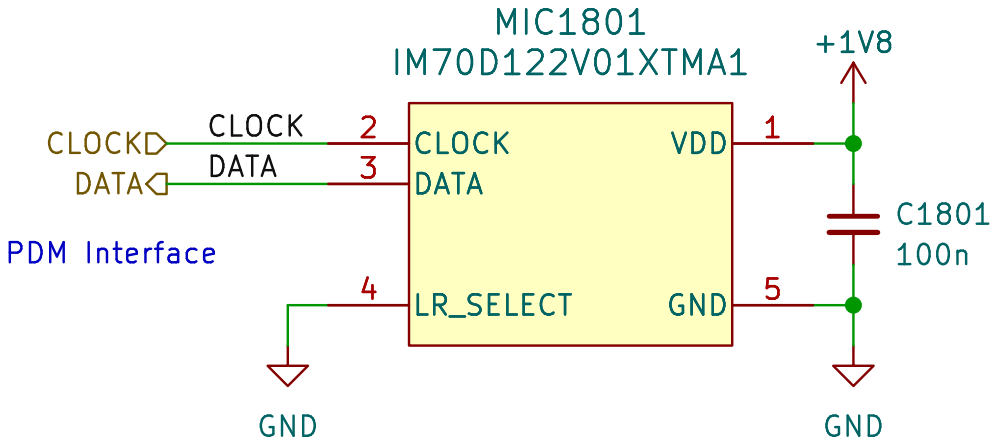
[picture p86: page 12]

File: microphone.kicad_sch Sheet: /Microphone/
Id: 12/18 Title: Watch Microphone

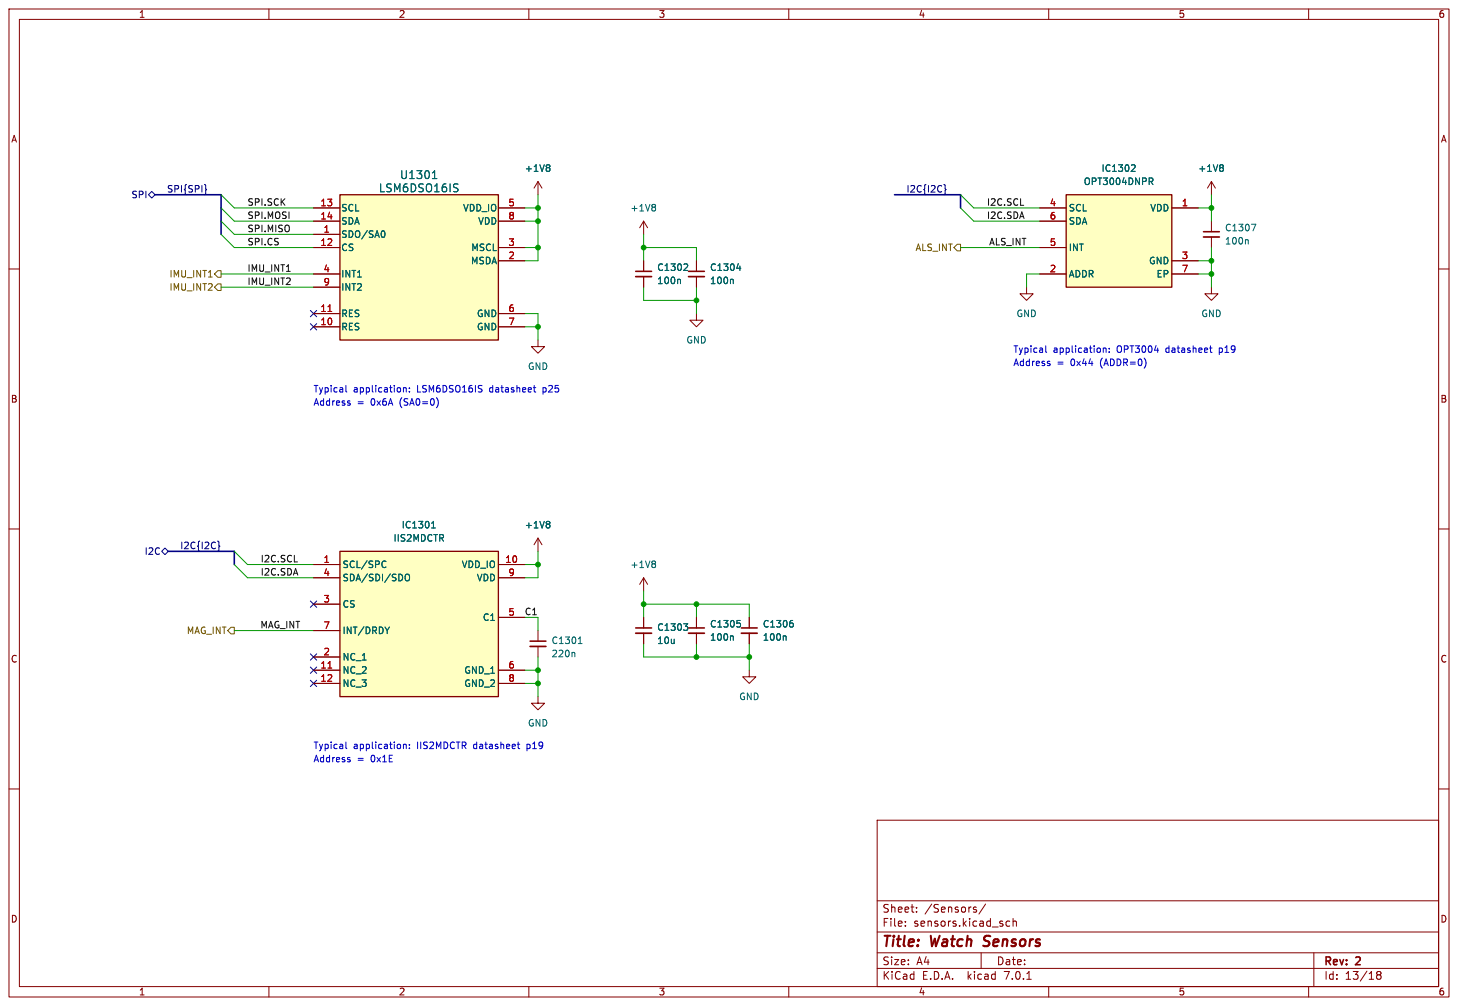
[picture p87: page 13]

IMU_INT1 SPI.MOSI MAG_INT SPI.MISO

File: sensors.kicad_sch Sheet: /Sensors/ GND

Id: 13/18 Title: Watch Sensors

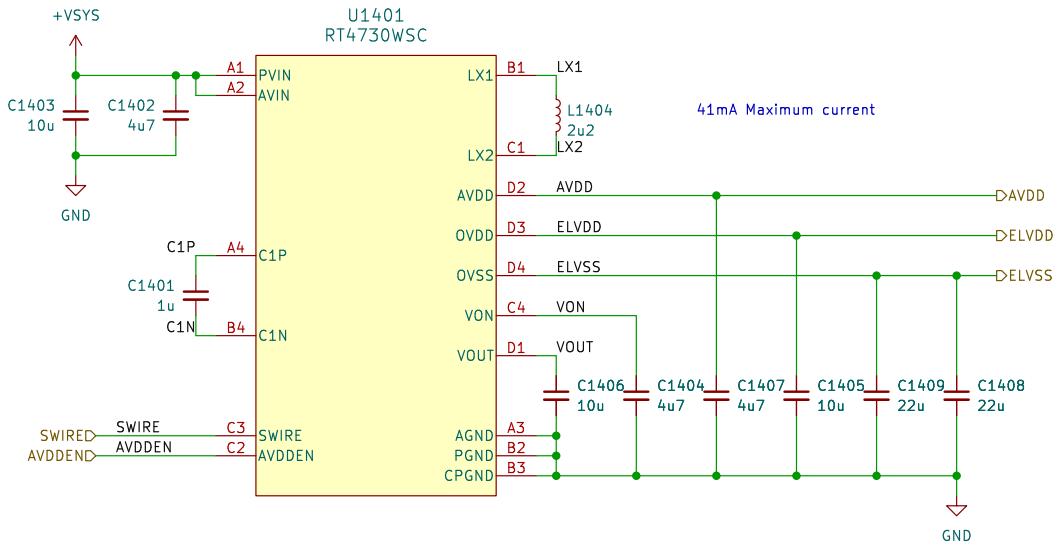
[picture p88: page 14]

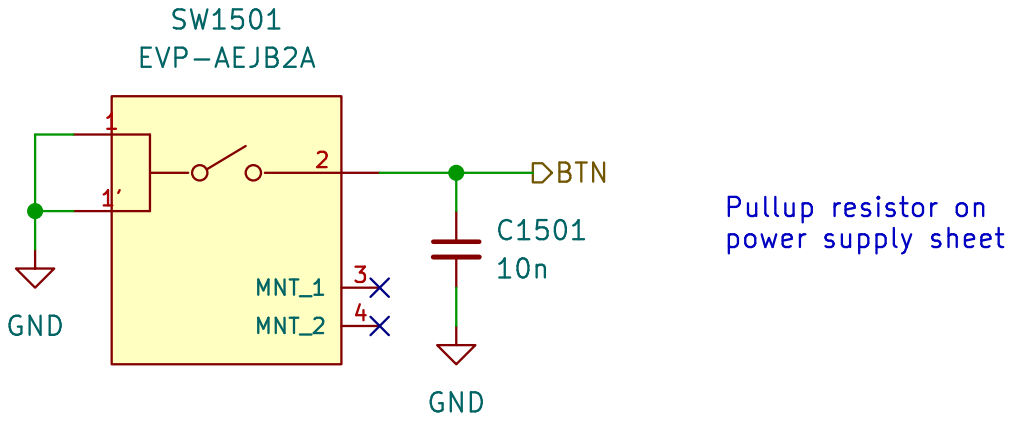
[picture p89: page 15]

Id: 15/18 Title: Watch Button

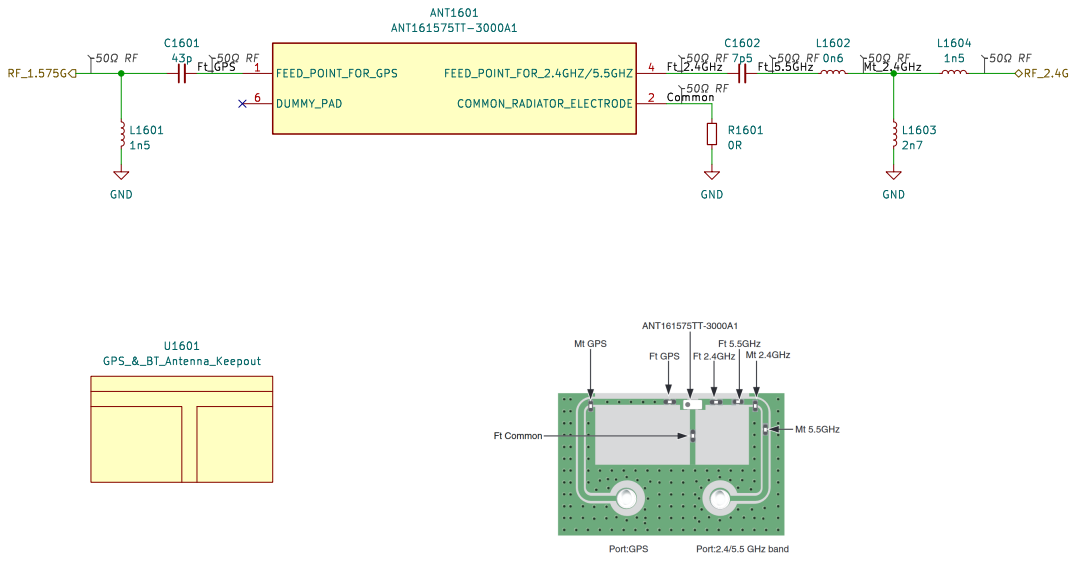
[picture p90: page 16]

File: antenna.kicad_sch Sheet: /Antenna/
Id: 16/18 Title: Watch Antenna

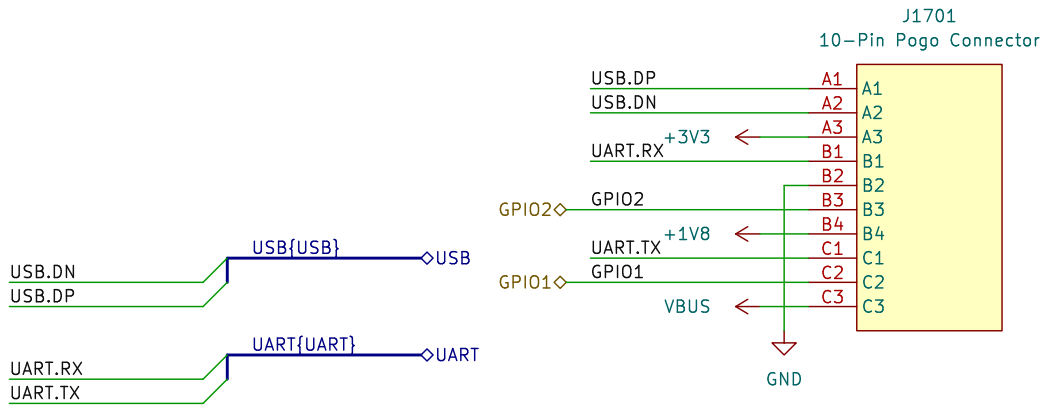
[picture p91: page 17]

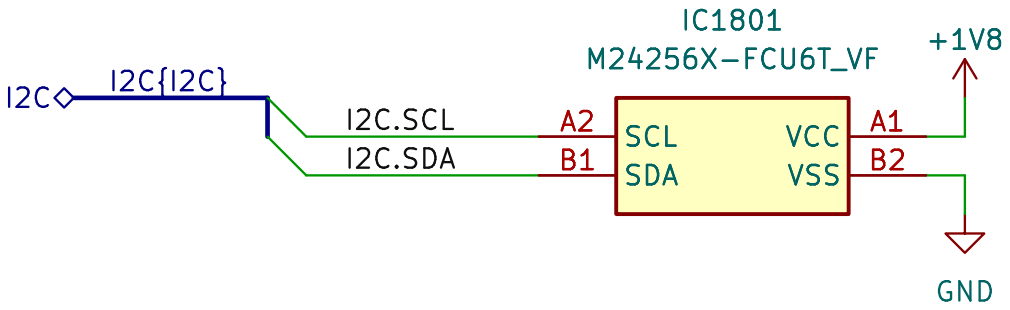
[picture p92: page 18]

File: eeprom.kicad_sch Sheet: /EEPROM/
Id: 18/18 Title: Watch EEPROM
