ben5049/Smart-Watch/PCBs/archived/watch_main_v1/watch_main.pdf

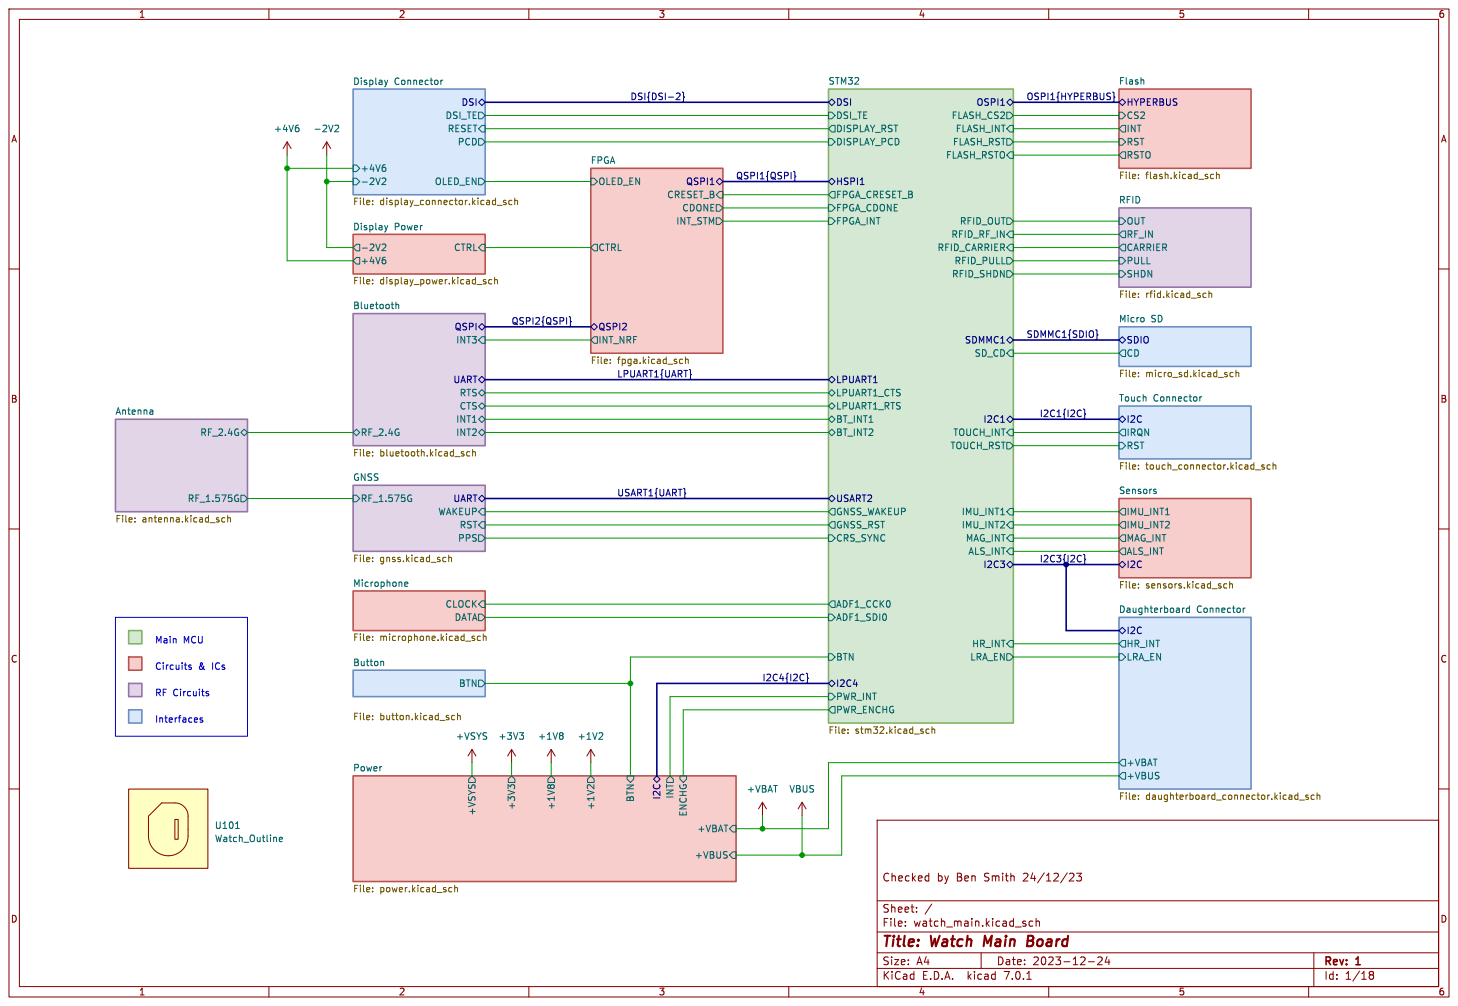
[picture p93: page 1]

Button File: button.kicad_sch QSPI UART RF_2.4G

PULL CARRIER OUT RFID

File: rfid.kicad_sch UART WAKEUP RST PPS RF_1.575G

Interfaces RF Circuits Main MCU

Id: 1/18 Title: Watch Main Board

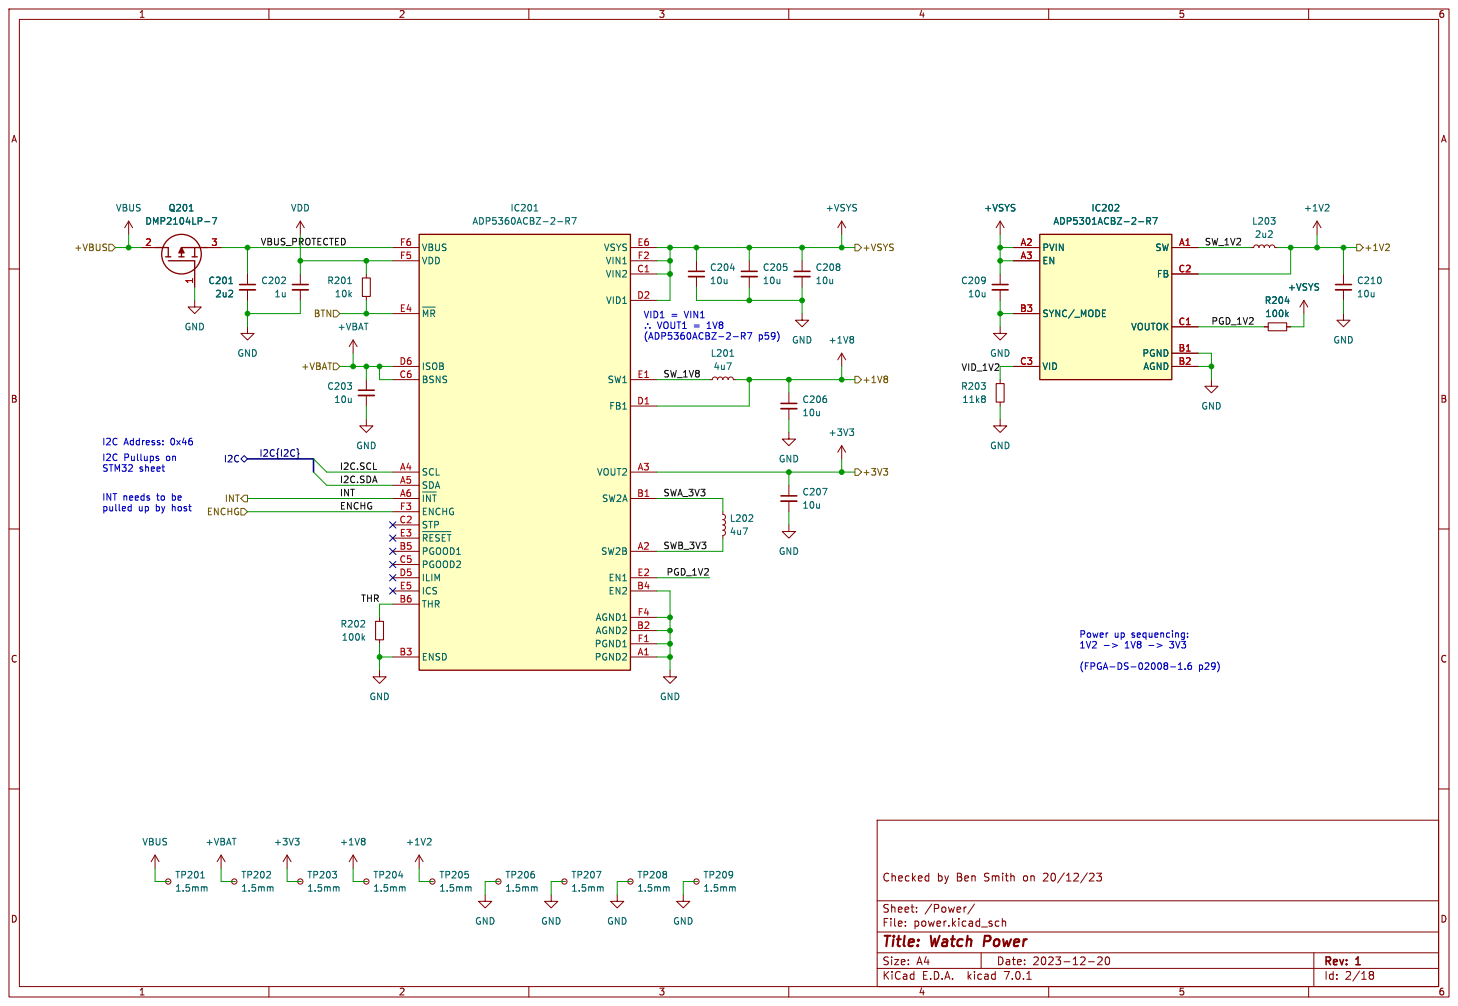
[picture p94: page 2]

INT needs to be
pulled up by host

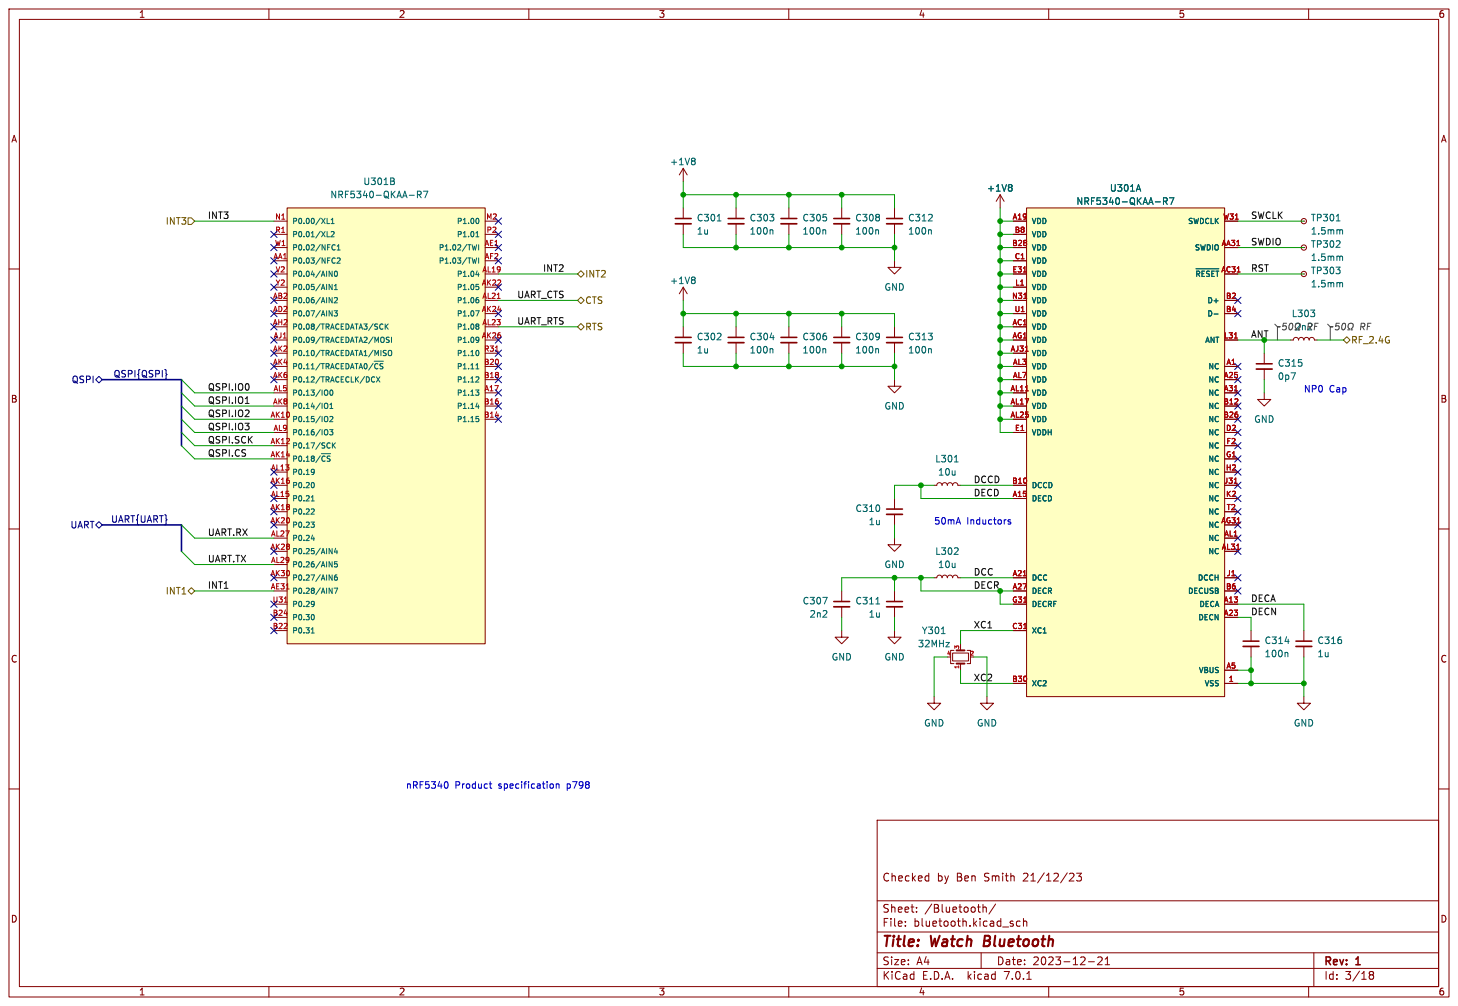
[picture p95: page 3]

Id: 3/18 Title: Watch Bluetooth


Id: 4/18 Title: Watch GNSS

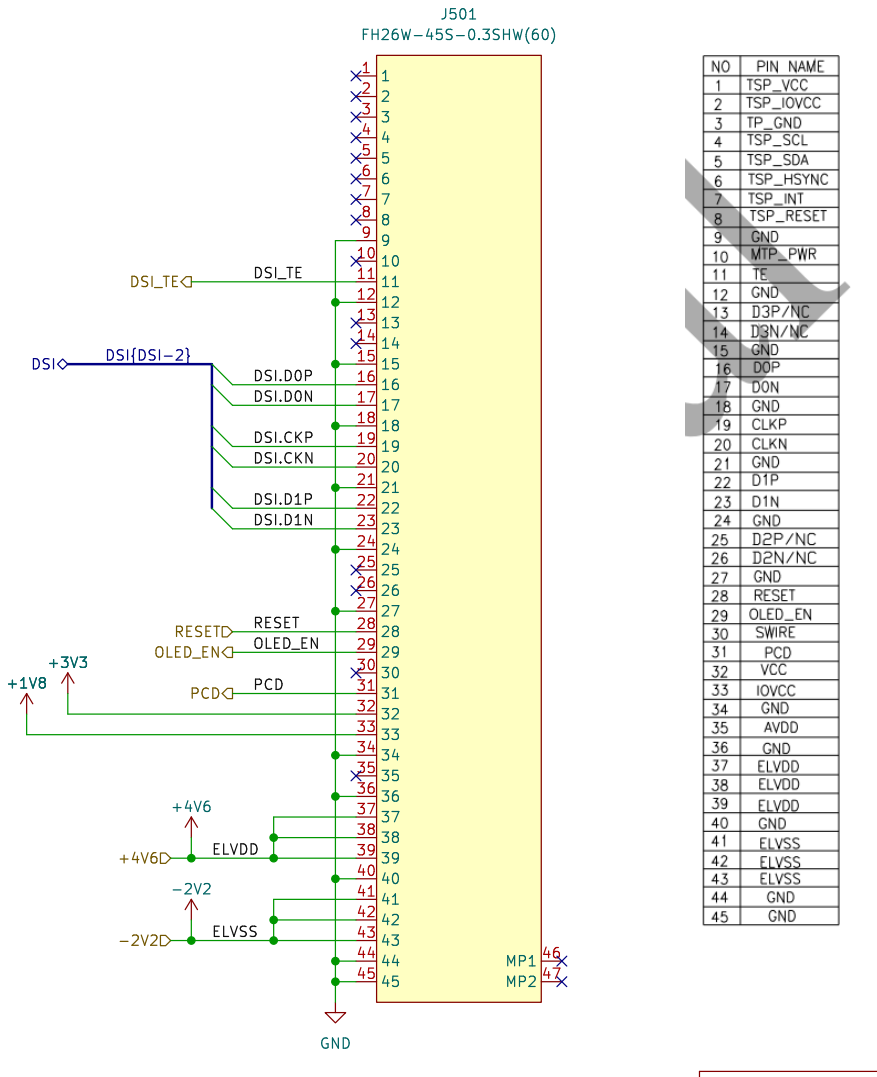
[picture p96: page 5]

ELVSSDSI_TE OLED_EN
DSI.CKP DSI.D0P DSI.D1P DSI.D1N


http://www.pluschiptech.com/zhinengchuandai/cst716.html


LRA driver address = 0x5A HR sensors address = 0x57

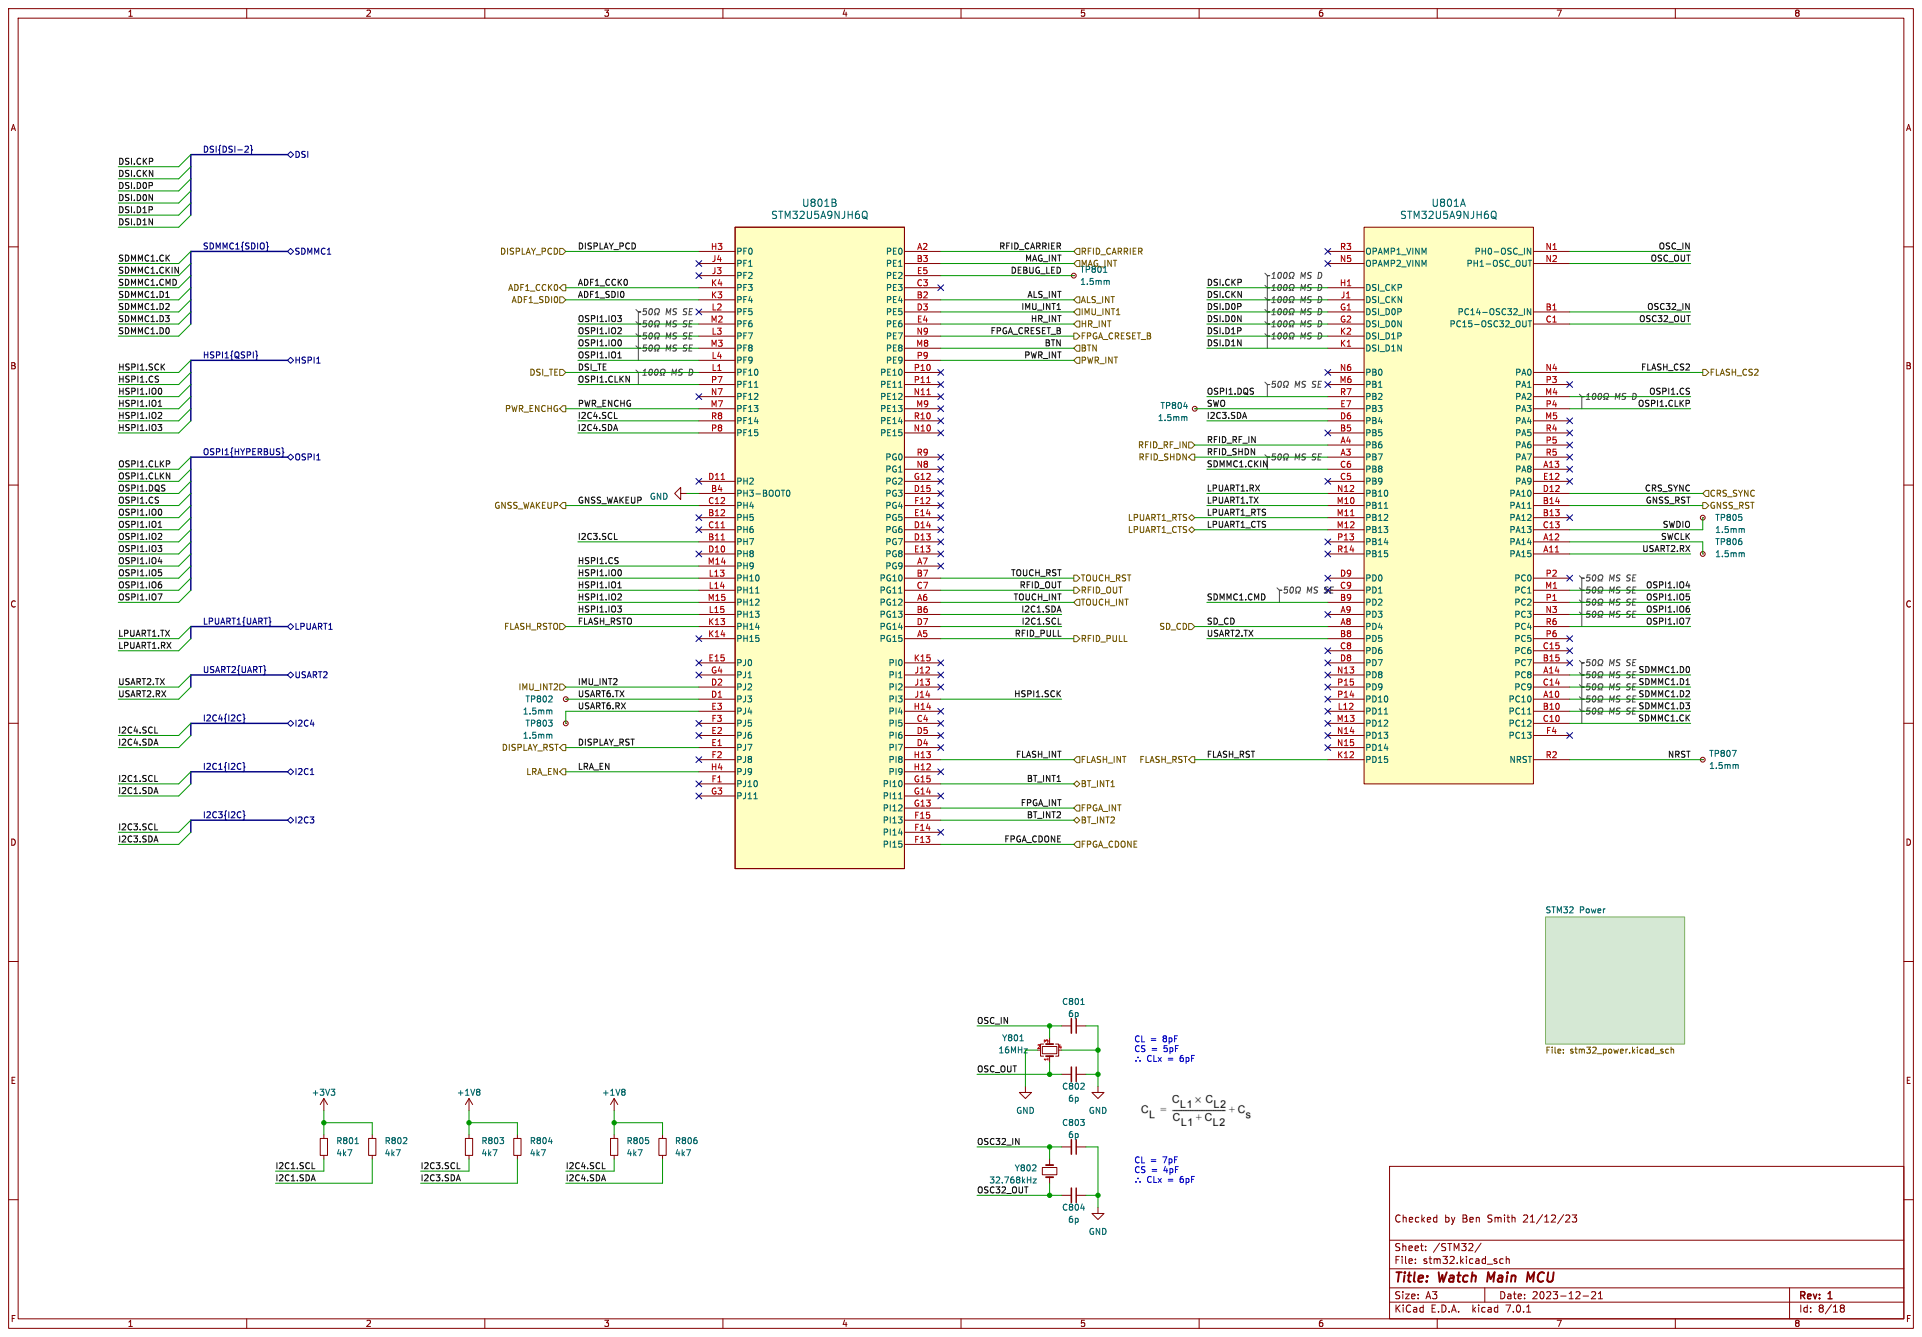
[picture p97: page 8]

DSI.CKP DSI.CKN

Id: 8/18 Title: Watch Main MCU

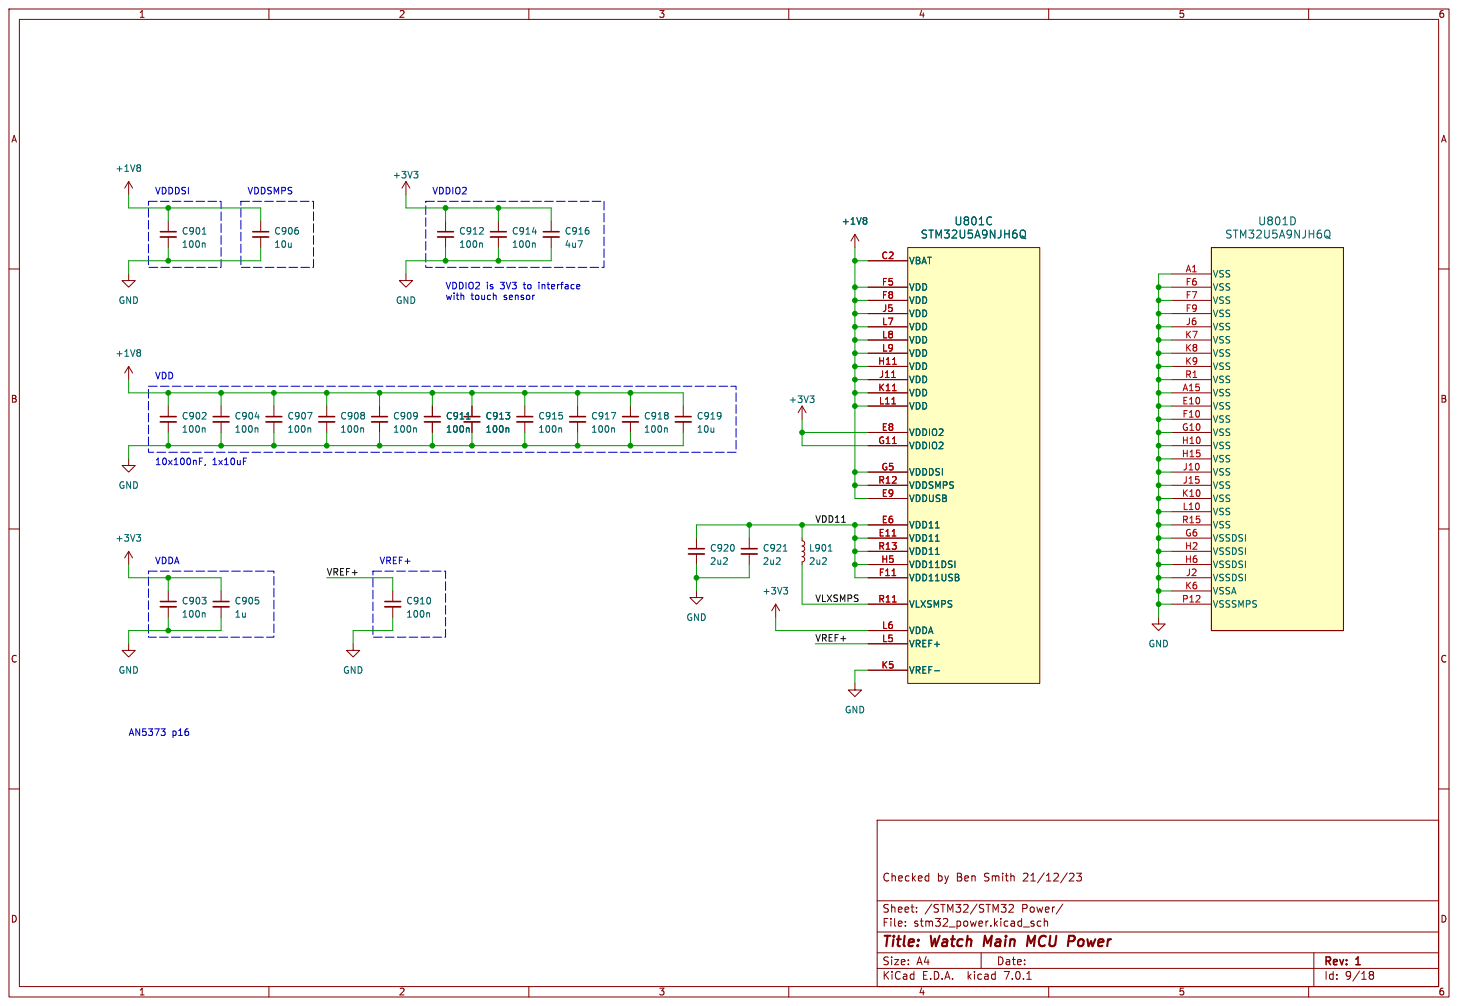
[picture p98: page 9]


select when flash is
replaced with a ram+flash

Id: 10/18 Title: Watch Flash

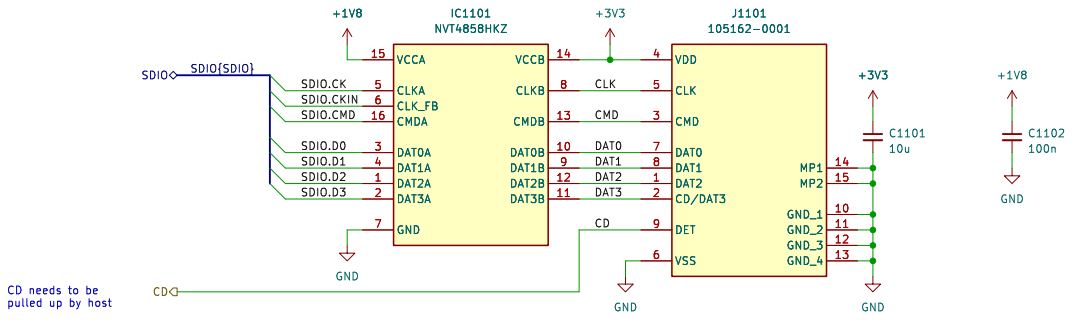
[picture p99: page 11]

SDIO.D3 SDIO.CK
DAT0 DAT3 SDIO.D0 SDIO.D2 SDIO.CKIN
SDIO.CMD

CD needs to be

Id: 11/18 Title: Watch Micro SD

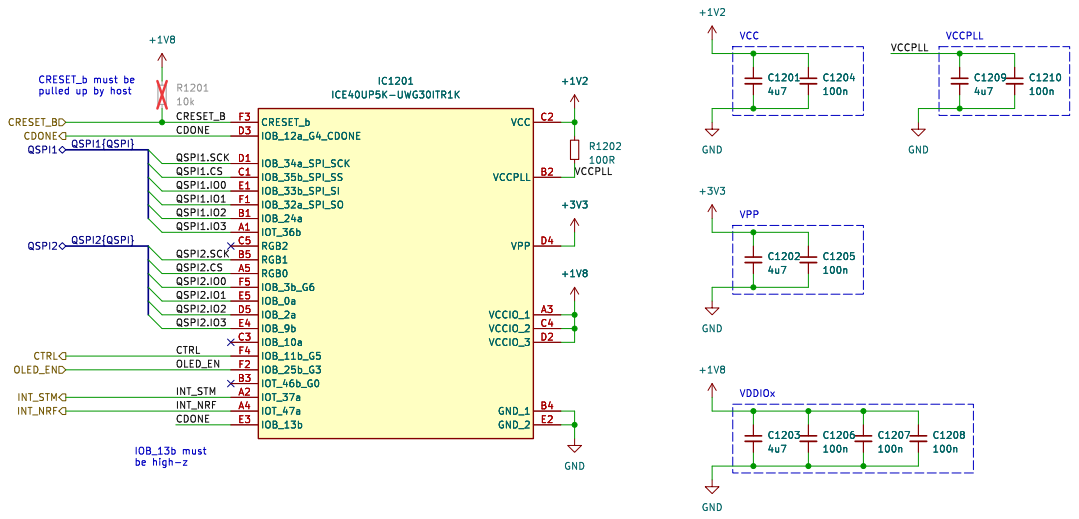
[picture p100: page 12]

CRESET_b must be
pulled up by host

Id: 12/18 Title: Watch FPGA

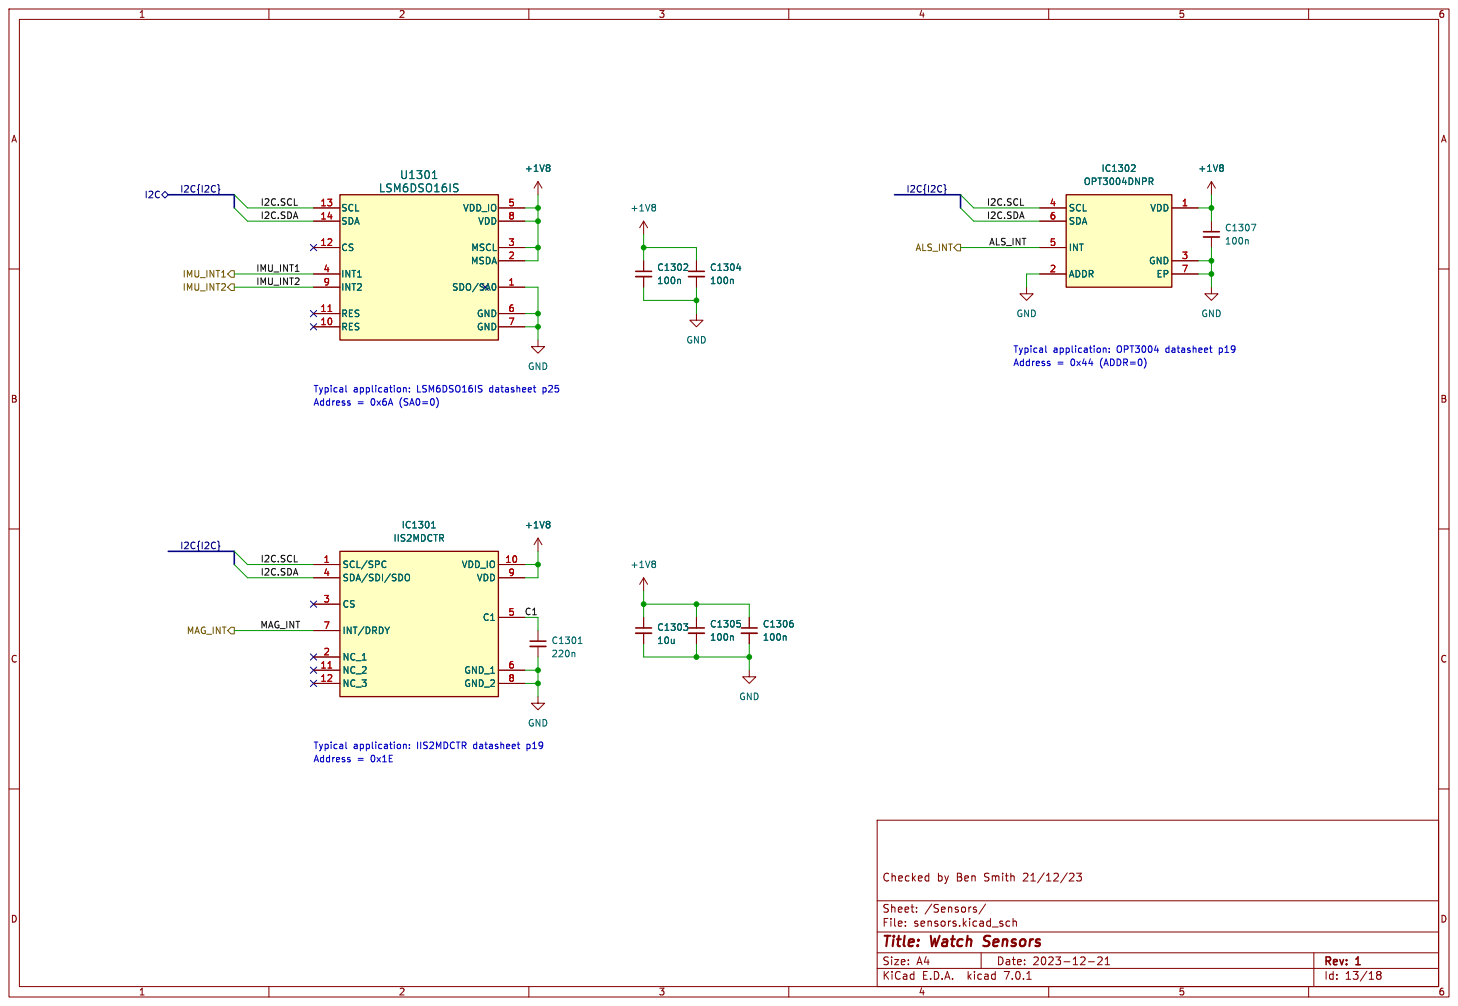
[picture p101: page 13]

Id: 13/18 Title: Watch Sensors

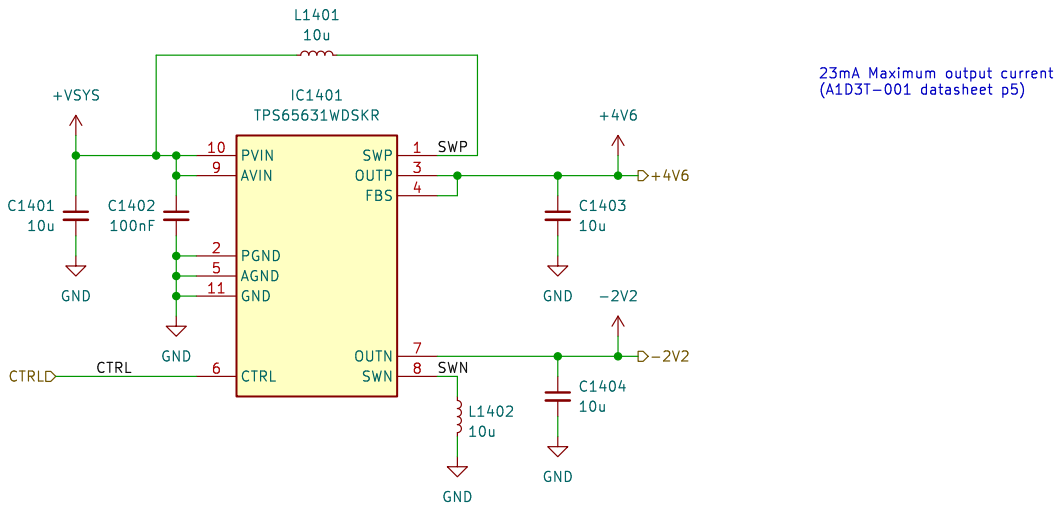
[picture p102: page 14]


Id: 15/18 Title: Watch Button


Id: 16/18 Title: Watch Antenna

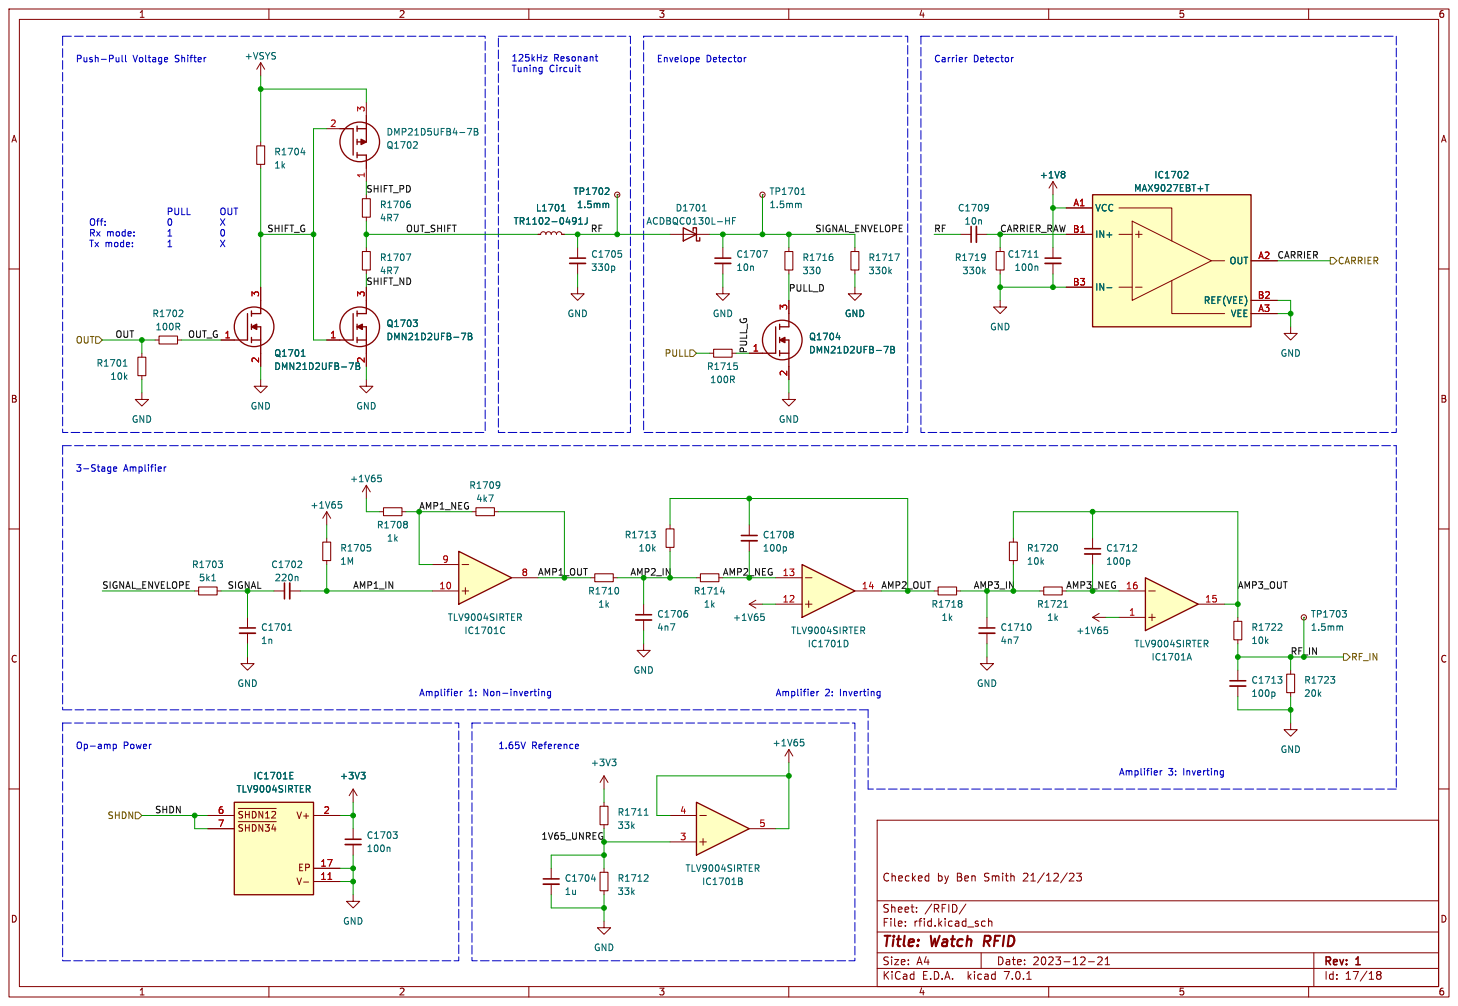
[picture p103: page 17]

PULL OUT Off: 0 X Rx mode: 1 0 Tx mode: 1 X

Id: 17/18 Title: Watch RFID


Id: 18/18 Title: Watch Microphone
