ben5049/Smart-Watch/PCBs/archived/rfid_module_v1/rfid_module.pdf

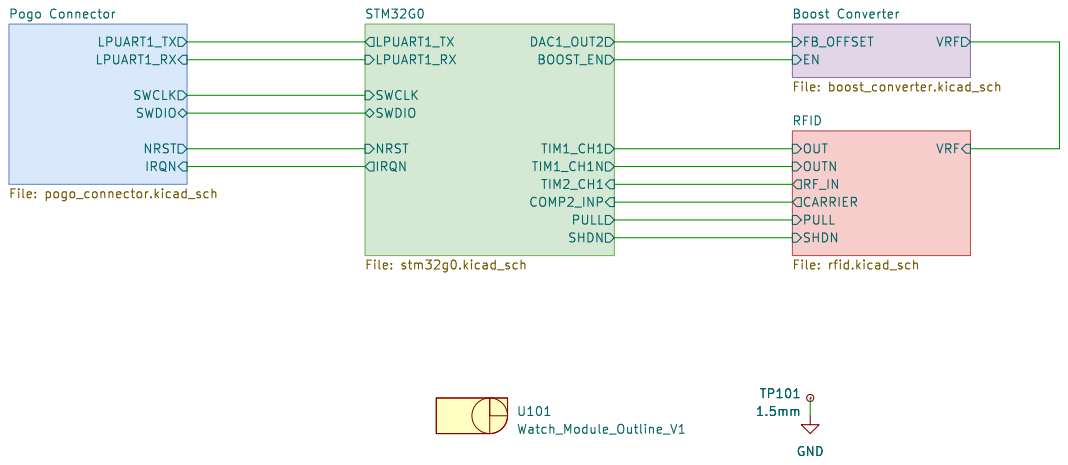
[picture p104: page 1]

Boost Converter File: boost_converter.kicad_sch SHDN OUTN OUT RF_IN

SWCLK
File: rfid.kicad_sch PULL SWDIO

Id: 1/5 Title: File: rfid_module.kicad_sch Sheet: /


Id: 2/5 Title: RFID Transmitter Receiver File: rfid.kicad_sch Sheet: /RFID/ GND

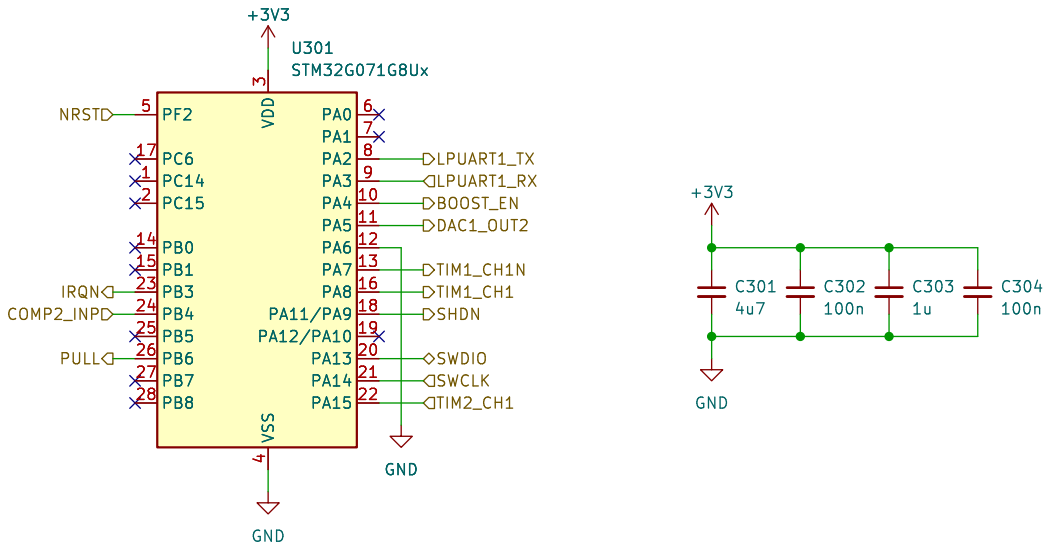
[picture p105: page 3]


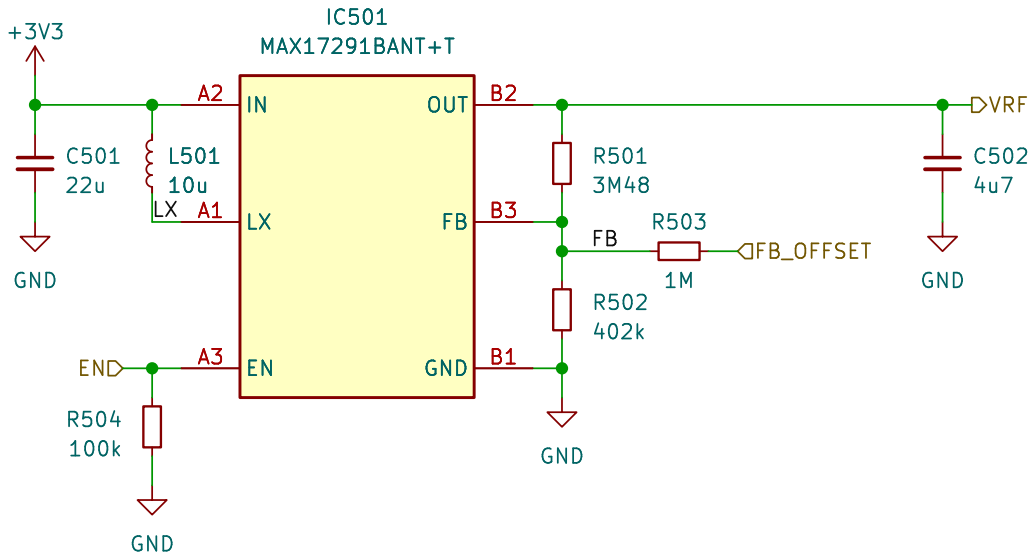
[picture p106: page 5]
