ben5049/Smart-Watch/PCBs/archived/watch_test_rig v1/watch_test_rig.pdf

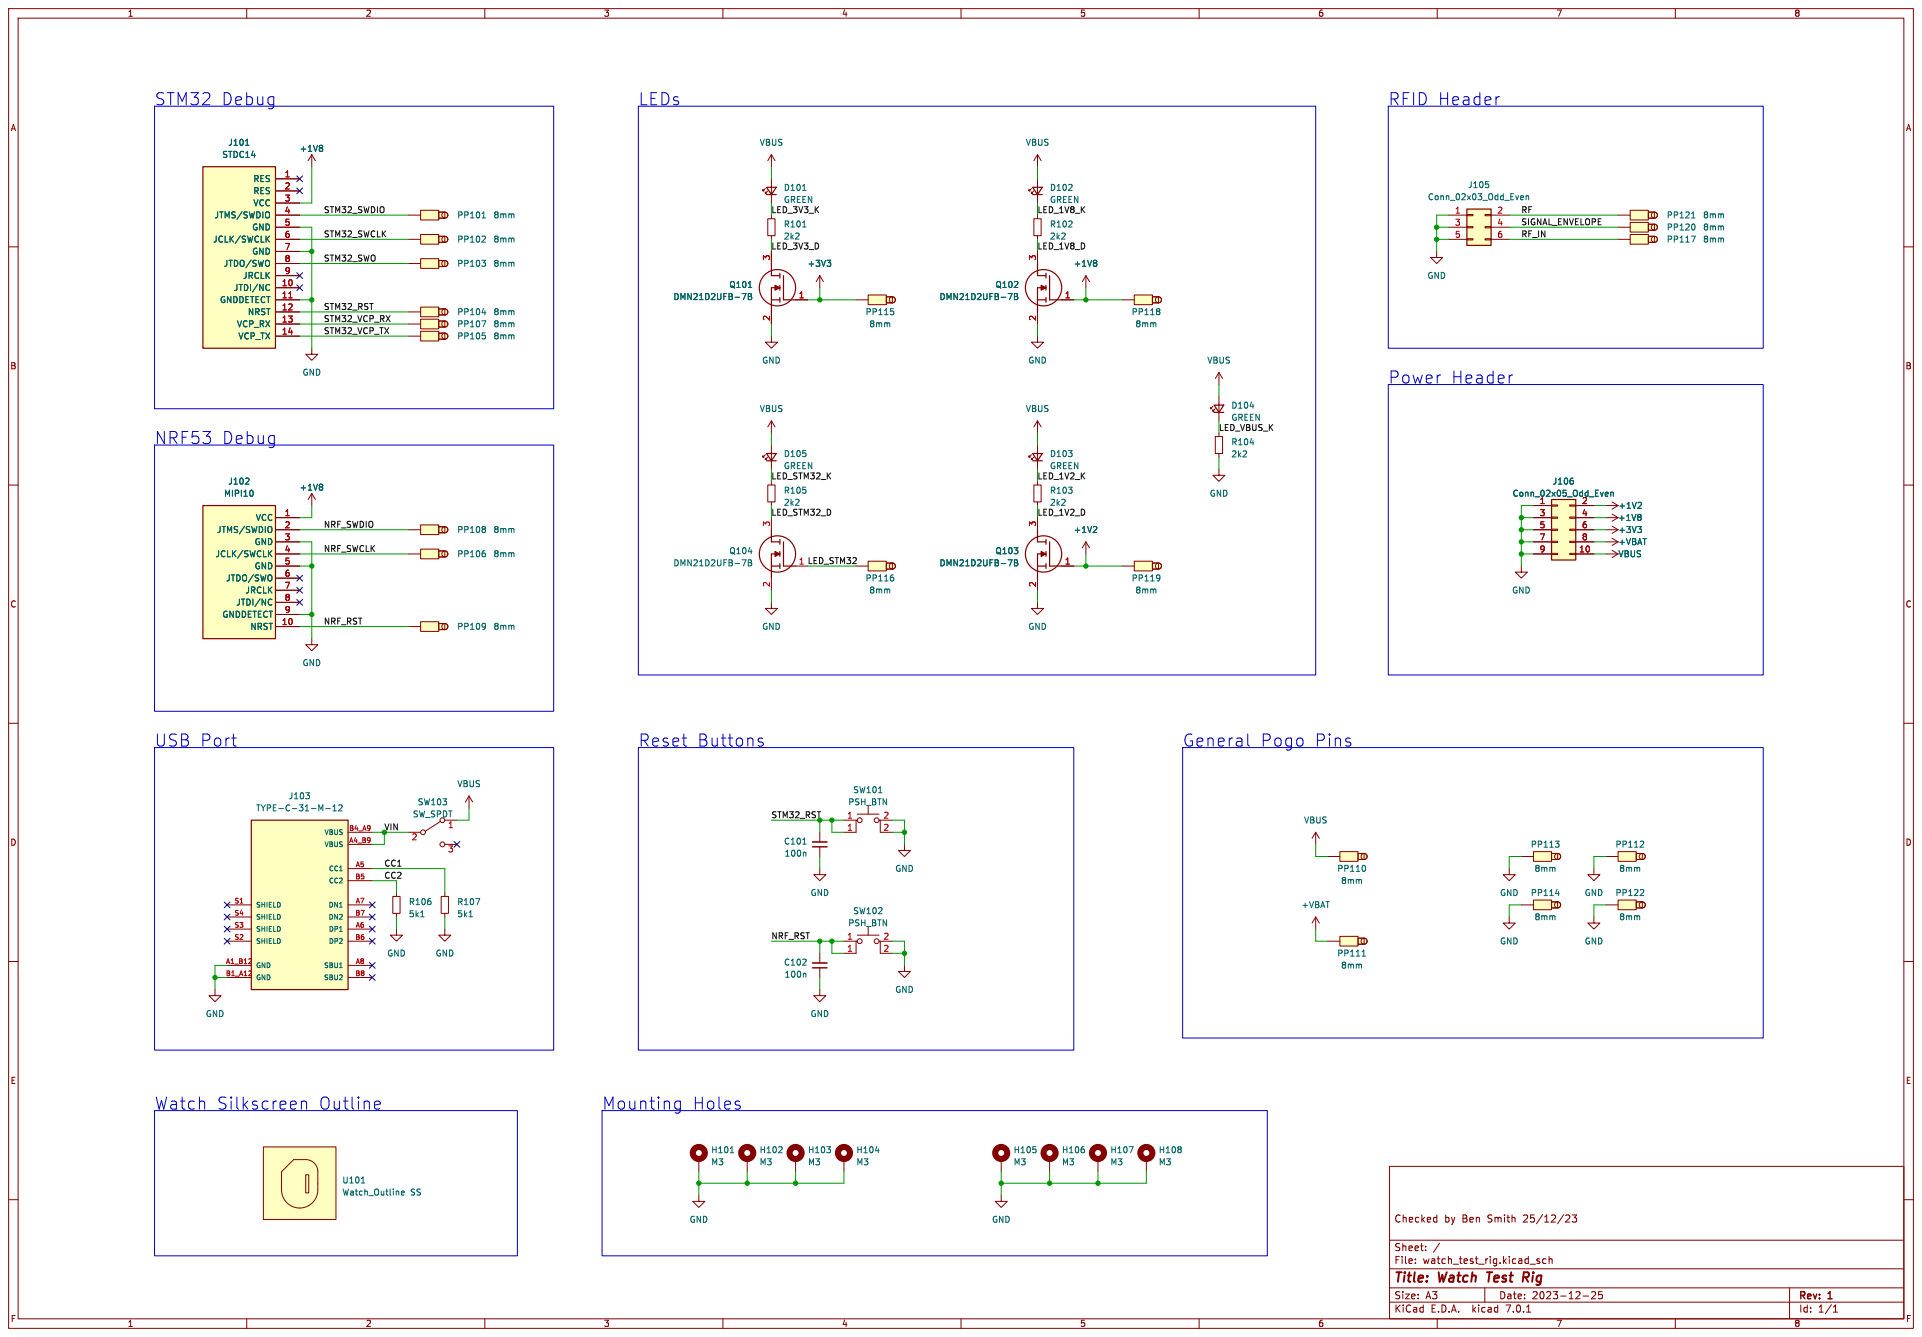
[picture p107: page 1]

Id: 1/1 Title: Watch Test Rig
