ben5049/Smart-Watch/Simulations/Draft1.asc

C1: cap; 10µ; V=25 Rser=1m
C2: cap; 100µ; V=25 Rser=1m
L1: ind; 200n; Ipk=200 Rser=0.5m Rpar=0 Cpar=0
R1: res; 1k
S1: sw; MYSW
V1: voltage; 24; Rser=1m
V2: voltage; PULSE(0 10 1 0 0 10 20 1); Rser=0 Cpar=0
Named nets: 0, VSYS
.tran 3 steady
.MODEL MYSW SW(Ron=1u Roff=100Meg Vt=.5 Vh=-.4)
