ben5049/Smart-Watch/Simulations/Draft2.asc

C1: cap
L1: ind
R1: res
S1: sw
V1: voltage
V2: voltage
Named nets: 0
