ben5049/Smart-Watch/Simulations/Draft3.asc

R1: res; 330k
R2: res; 100k
V1: voltage; 5
Named nets: 0
.op
