ben5049/Smart-Watch/Simulations/RFID.asc

C1: cap; 1µ
C2: cap; 100p
C3: cap; 100p
C4: cap; 100p
C5: cap; 220n
C6: cap; 1n
C7: cap; 4.7n
C8: cap; 4.7n
C9: cap; 330p
C10: cap; 1n
D1: diode; 1N4148
I1: current; SINE(0 0.01 125k 0 0 0 13)
I2: current; SINE(0 0.01 125k 200u 0 0 21)
I3: current; SINE(0 0.01 125k 480u 0 0 21)
I4: current; SINE(0 0.01 125k 760u 0 0 13)
I5: current; SINE(0 0.01 125k 960u 0 0 13)
L1: ind2; 4.91m; Rser=40m
L2: ind2; 10m
R1: res; 33k
R2: res; 33k
R3: res; 4.7k
R4: res; 1k
R5: res; 1k
R6: res; 10k
R7: res; 1k
R8: res; 1k
R9: res; 10k
R10: res; 33k
R11: res; 20k
R12: res; 1k
R13: res; 1Meg
R14: res; 5.1k
R15: res; 330k
R16: res; 5
U1: LT1677
U2: LT1677
U3: LT1677
U4: LT1677
V1: voltage; 3.3
V3: voltage; 4
Named nets: 0, 3V3, 1V65, VOUT, S1O, S2I, S2O, S3I, S3O, VIN, S1I
;ac dec 10 1k 1Meg
.tran 1m
K1 L2 L1 0.001
