ben5049/Smart-Watch/Simulations/BLE_Input.asc

C1: cap; 7.5p
C2: cap; 0.7p
L1: ind; 0.6n
L2: ind; 1.5n
L3: ind; 2.7n
L4: ind; 2.2n
V1: voltage; ""; AC 1
Named nets: 0, VOUT, VIN
.ac dec 100 100Meg 10G
