ben5049/Smart-Watch/Simulations/GNSS_Input.asc

C1: cap; 43p
L1: ind; 1.5n
L2: ind; 7.5n
V1: voltage; ""; AC 1
Named nets: 0, VIN, VOUT
.ac dec 10 100k 10G
