ben5049/Smart-Watch/PCBs/rfid_module_v1.1/rfid_module.kicad_pcb

## KiCad design PCBs/rfid_module_v1.1/rfid_module.kicad_pcb (2024-04-02)

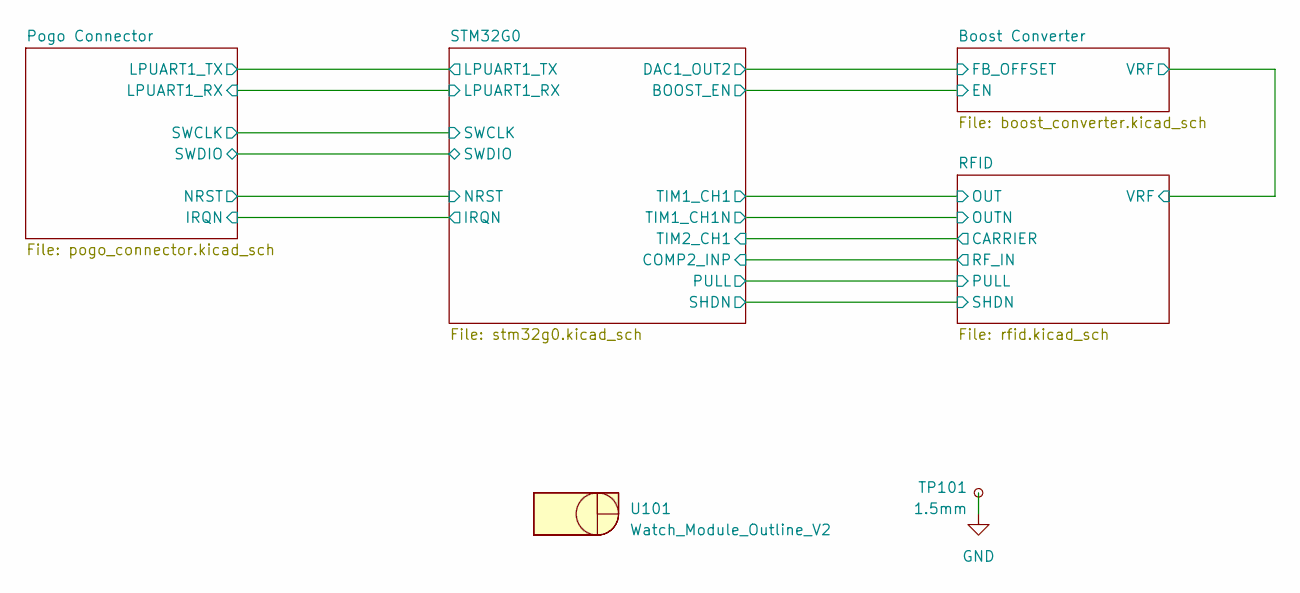
[picture p108: schematic rfid_module.kicad_sch]

Parts:
TP101: 1.5mm; TestPoint_Pad_D1.5mm
U101: Watch_Module_Outline_V2; Watch Module Outline V2

Connections:
GND: TP101.1; also elsewhere on the board

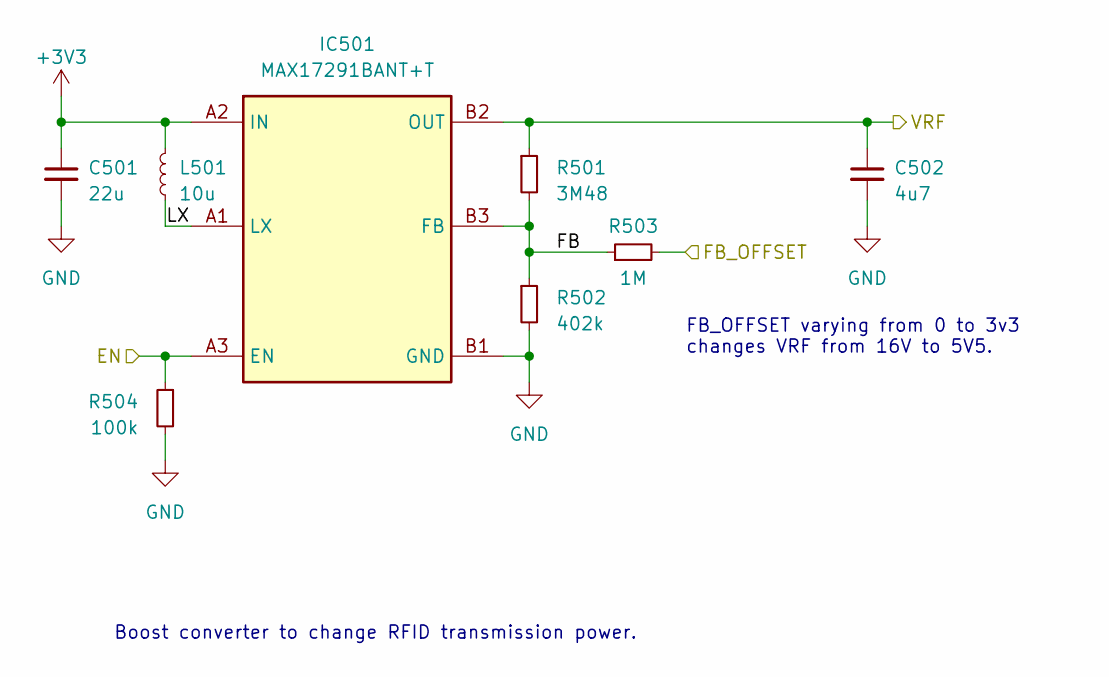
[picture p109: schematic boost_converter.kicad_sch]

Parts:
C501: 22u; C_0402_1005Metric
C502: 4u7; C_0402_1005Metric
IC501: MAX17291BANT+T; BGA6C40P3X2_127X87X50; Mouser Part Number 700-MAX17291BANT+T
L501: 10u; L_TDK_MLZ1608
R501: 3M48; R_0402_1005Metric
R502: 402k; R_0402_1005Metric
R503: 1M; R_0402_1005Metric
R504: 100k; R_0402_1005Metric

Connections:
+3V3: C501.1, IC501.A2 (IN), L501.1; also elsewhere on the board
/Boost Converter/EN: IC501.A3 (EN), R504.1; also elsewhere on the board
/Boost Converter/FB: IC501.B3 (FB), R501.2, R502.1, R503.1
/Boost Converter/FB_OFFSET: R503.2; also elsewhere on the board
/Boost Converter/LX: IC501.A1 (LX), L501.2
/Boost Converter/VRF: C502.1, IC501.B2 (OUT), R501.1; also elsewhere on the board
GND: C501.2, C502.2, IC501.B1 (GND), R502.2, R504.2; also elsewhere on the board

Notes on the sheet:
Boost converter to change RFID transmission power.
FB_OFFSET varying from 0 to 3v3 changes VRF from 16V to 5V5.

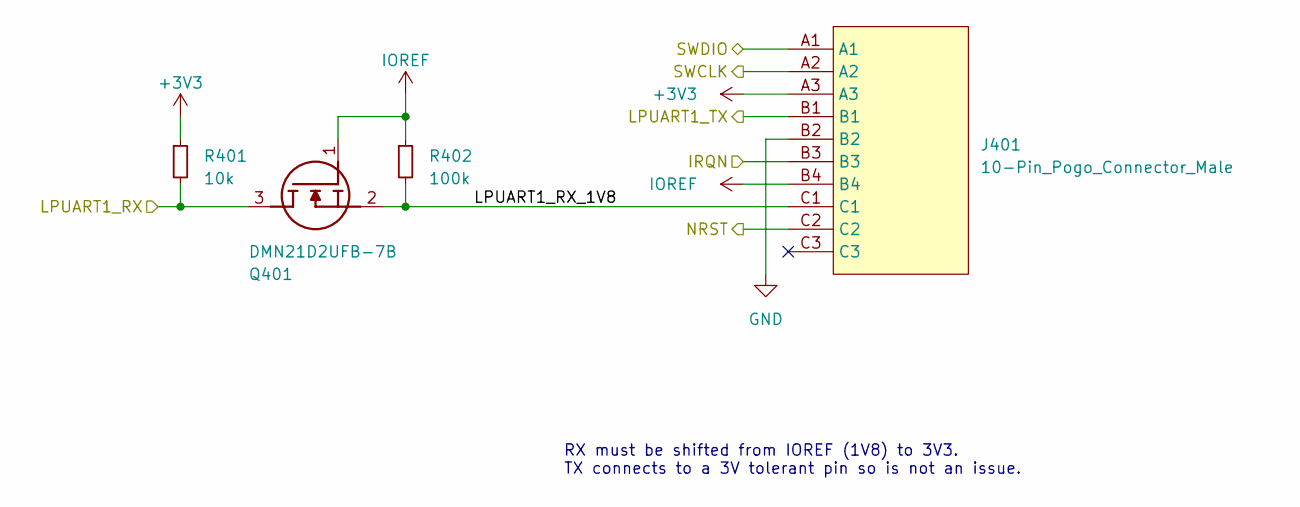
[picture p110: schematic pogo_connector.kicad_sch]

Parts:
J401: 10-Pin_Pogo_Connector_Male; 10-Pin Pogo Connector Male
Q401: DMN21D2UFB-7B; DMN21D2UFB7B; Mouser Part Number 621-DMN21D2UFB-7B
R401: 10k; R_0402_1005Metric
R402: 100k; R_0402_1005Metric

Connections:
+3V3: J401.A3, R401.1; also elsewhere on the board
/Pogo Connector/IRQN: J401.B3; also elsewhere on the board
/Pogo Connector/LPUART1_RX: Q401.3 (D), R401.2; also elsewhere on the board
/Pogo Connector/LPUART1_RX_1V8: J401.C1, Q401.2 (S), R402.2
/Pogo Connector/LPUART1_TX: J401.B1; also elsewhere on the board
/Pogo Connector/NRST: J401.C2; also elsewhere on the board
/Pogo Connector/SWCLK: J401.A2; also elsewhere on the board
/Pogo Connector/SWDIO: J401.A1; also elsewhere on the board
GND: J401.B2; also elsewhere on the board
IOREF: J401.B4, Q401.1 (G), R402.1

Notes on the sheet:
RX must be shifted from IOREF (1V8) to 3V3. TX connects to a 3V tolerant pin so is not an issue.

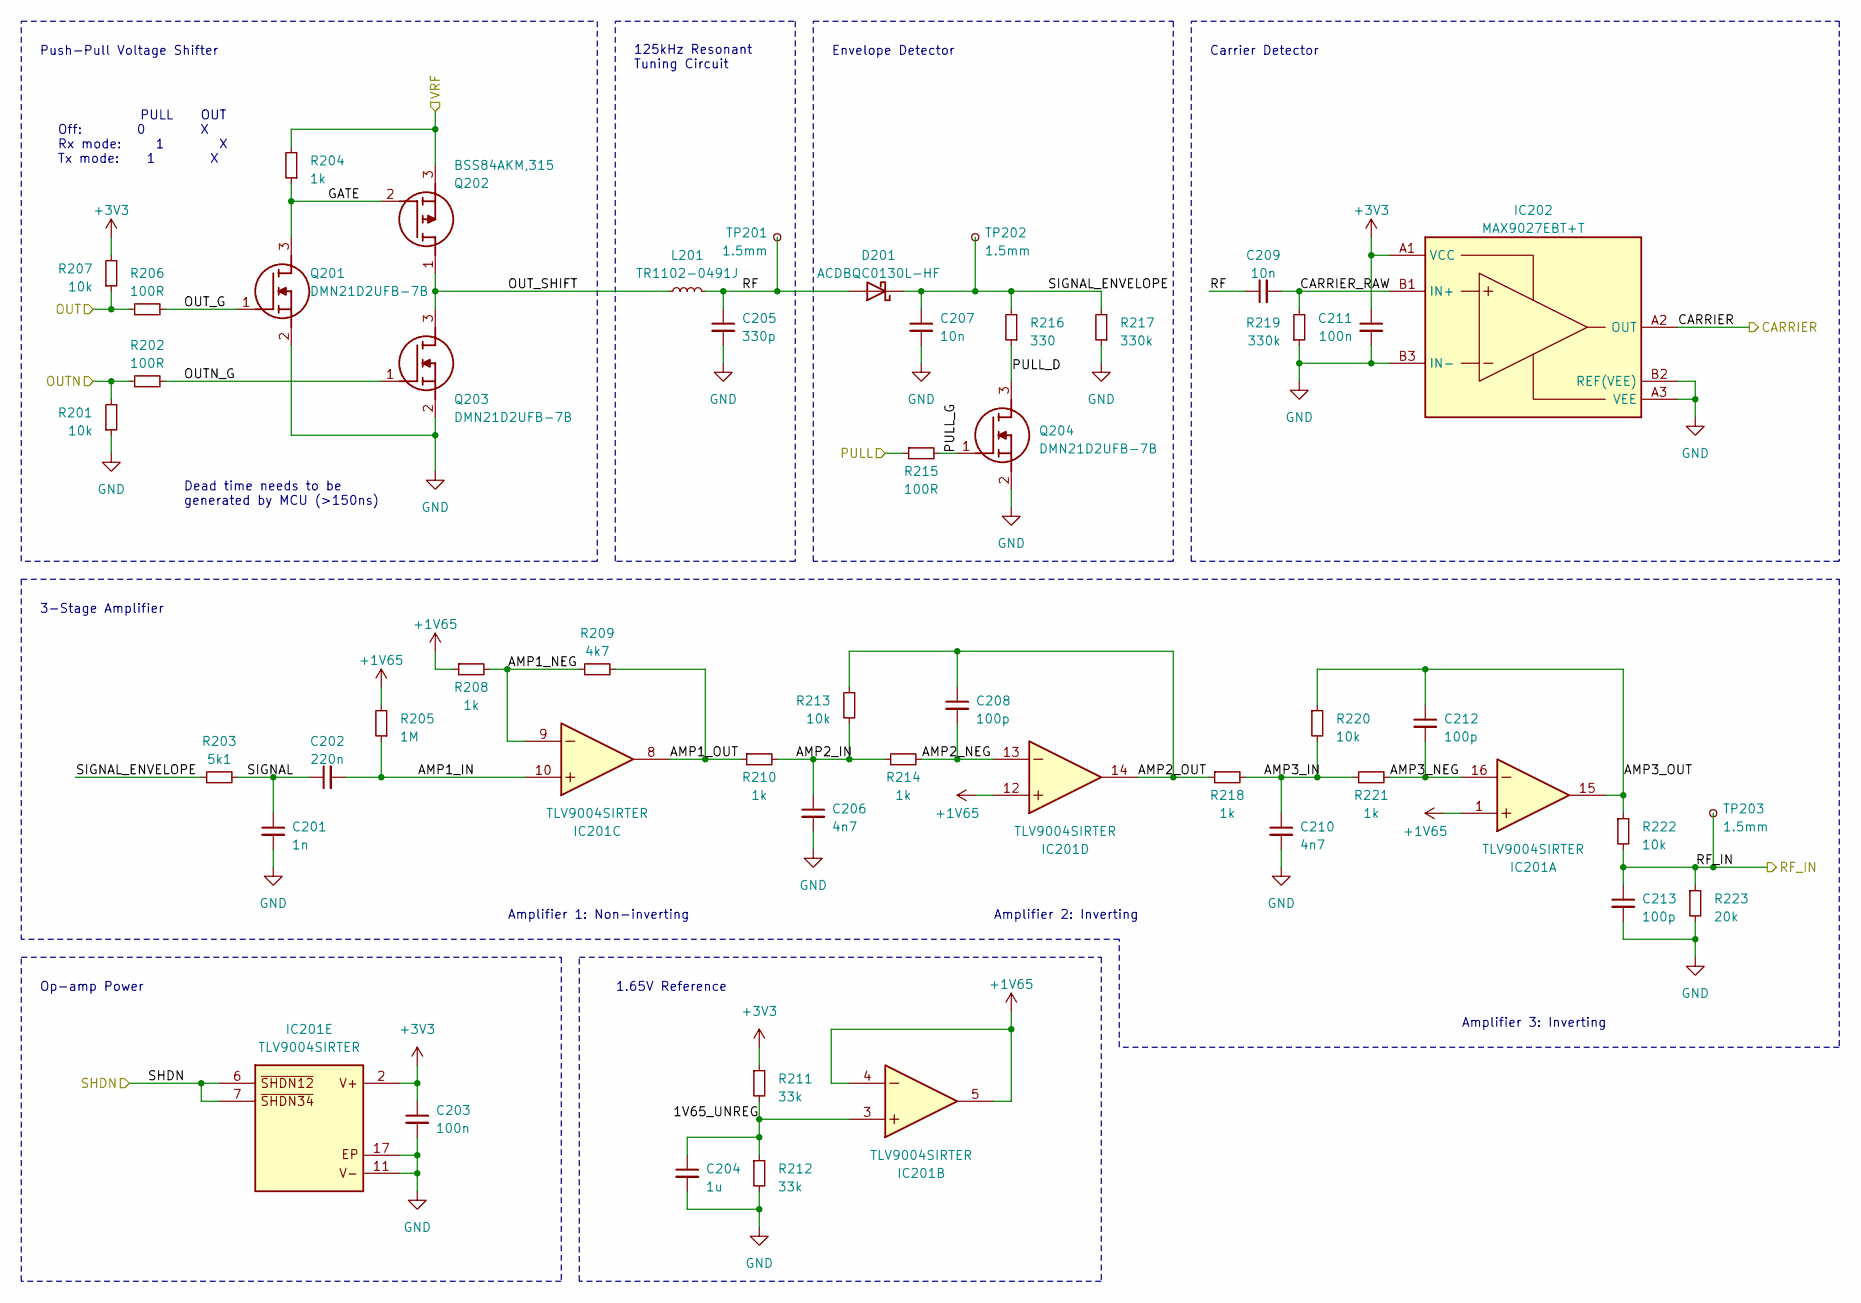
[picture p111: schematic rfid.kicad_sch, RFID Transmitter Receiver]

Parts:
C201: 1n; C_0402_1005Metric
C202: 220n; C_0402_1005Metric
C203, C211: 100n; C_0402_1005Metric
C204: 1u; C_0402_1005Metric
C205: 330p; C_0402_1005Metric
C206, C210: 4n7; C_0402_1005Metric
C207, C209: 10n; C_0402_1005Metric
C208, C212, C213: 100p; C_0402_1005Metric
D201: ACDBQC0130L-HF; D_SOD-923
IC201: TLV9004SIRTER; QFN50P300X300X80-17N-D; Mouser Part Number 595-TLV9004SIRTER
IC202: MAX9027EBT+T; BGA6C50P3X2_152X100X69; Mouser Part Number 700-MAX9028EBTT
L201: TR1102-0491J
Q201, Q203, Q204: DMN21D2UFB-7B; DMN21D2UFB7B; Mouser Part Number 621-DMN21D2UFB-7B
Q202: BSS84AKM,315; DMP21D5UFB47B; Mouser Part Number 771-BSS84AKM315
R201, R207, R213, R220, R222: 10k; R_0402_1005Metric
R202, R206, R215: 100R; R_0402_1005Metric
R203: 5k1; R_0402_1005Metric
R204, R208, R210, R214, R218, R221: 1k; R_0402_1005Metric
R205: 1M; R_0402_1005Metric
R209: 4k7; R_0402_1005Metric
R211, R212: 33k; R_0402_1005Metric
R216: 330; R_0402_1005Metric
R217, R219: 330k; R_0402_1005Metric
R223: 20k; R_0402_1005Metric
TP201, TP202, TP203: 1.5mm; TestPoint_Pad_D1.5mm

Connections:
+1V65: IC201.1 (IN1+), IC201.4 (IN2-), IC201.5 (OUT2), IC201.12 (IN4+), R205.2, R208.1
+3V3: C203.1, C211.1, IC201.2 (V+), IC202.A1 (VCC), R207.2, R211.1; also elsewhere on the board
/Boost Converter/VRF: Q202.3 (S), R204.2; also elsewhere on the board
/RFID/1V65_UNREG: C204.1, IC201.3 (IN2+), R211.2, R212.1
/RFID/AMP1_IN: C202.2, IC201.10 (IN3+), R205.1
/RFID/AMP1_NEG: IC201.9 (IN3-), R208.2, R209.1
/RFID/AMP1_OUT: IC201.8 (OUT3), R209.2, R210.1
/RFID/AMP2_IN: C206.1, R210.2, R213.2, R214.1
/RFID/AMP2_NEG: C208.2, IC201.13 (IN4-), R214.2
/RFID/AMP2_OUT: C208.1, IC201.14 (OUT4), R213.1, R218.1
/RFID/AMP3_IN: C210.1, R218.2, R220.2, R221.1
/RFID/AMP3_NEG: C212.2, IC201.16 (IN1-), R221.2
/RFID/AMP3_OUT: C212.1, IC201.15 (OUT1), R220.1, R222.1
/RFID/CARRIER: IC202.A2 (OUT); also elsewhere on the board
/RFID/CARRIER_RAW: C209.2, IC202.B1 (IN+), R219.2
/RFID/GATE: Q201.3 (D), Q202.2 (G), R204.1
/RFID/OUT: R206.1, R207.1; also elsewhere on the board
/RFID/OUTN: R201.2, R202.1; also elsewhere on the board
/RFID/OUTN_G: Q203.1 (G), R202.2
/RFID/OUT_G: Q201.1 (G), R206.2
/RFID/OUT_SHIFT: L201.1, Q202.1 (D), Q203.3 (D)
/RFID/PULL: R215.1; also elsewhere on the board
/RFID/PULL_D: Q204.3 (D), R216.1
/RFID/PULL_G: Q204.1 (G), R215.2
/RFID/RF: C205.1, C209.1, D201.2 (A), L201.2, TP201.1
/RFID/RF_IN: C213.1, R222.2, R223.1, TP203.1; also elsewhere on the board
/RFID/SHDN: IC201.6 (~SHDN12), IC201.7 (~SHDN34); also elsewhere on the board
/RFID/SIGNAL: C201.1, C202.1, R203.2
/RFID/SIGNAL_ENVELOPE: C207.1, D201.1 (K), R203.1, R216.2, R217.2, TP202.1
GND: C201.2, C203.2, C204.2, C205.2, C206.2, C207.2, C210.2, C211.2, C213.2, IC201.11 (V-), IC201.17 (EP), IC202.A3 (VEE), IC202.B2 (REF(VEE)), IC202.B3 (IN-), Q201.2 (S), Q203.2 (S), Q204.2 (S), R201.1, R212.2, R217.1, R219.1, R223.2; also elsewhere on the board

Notes on the sheet:
Amplifier 3: Inverting
Carrier Detector
Op-amp Power
Push-Pull Voltage Shifter
3-Stage Amplifier
Amplifier 1: Non-inverting
125kHz Resonant Tuning Circuit
Envelope Detector
Amplifier 2: Inverting
PULL OUT Off: 0 X Rx mode: 1 X Tx mode: 1 X
Dead time needs to be generated by MCU (>150ns)
1.65V Reference

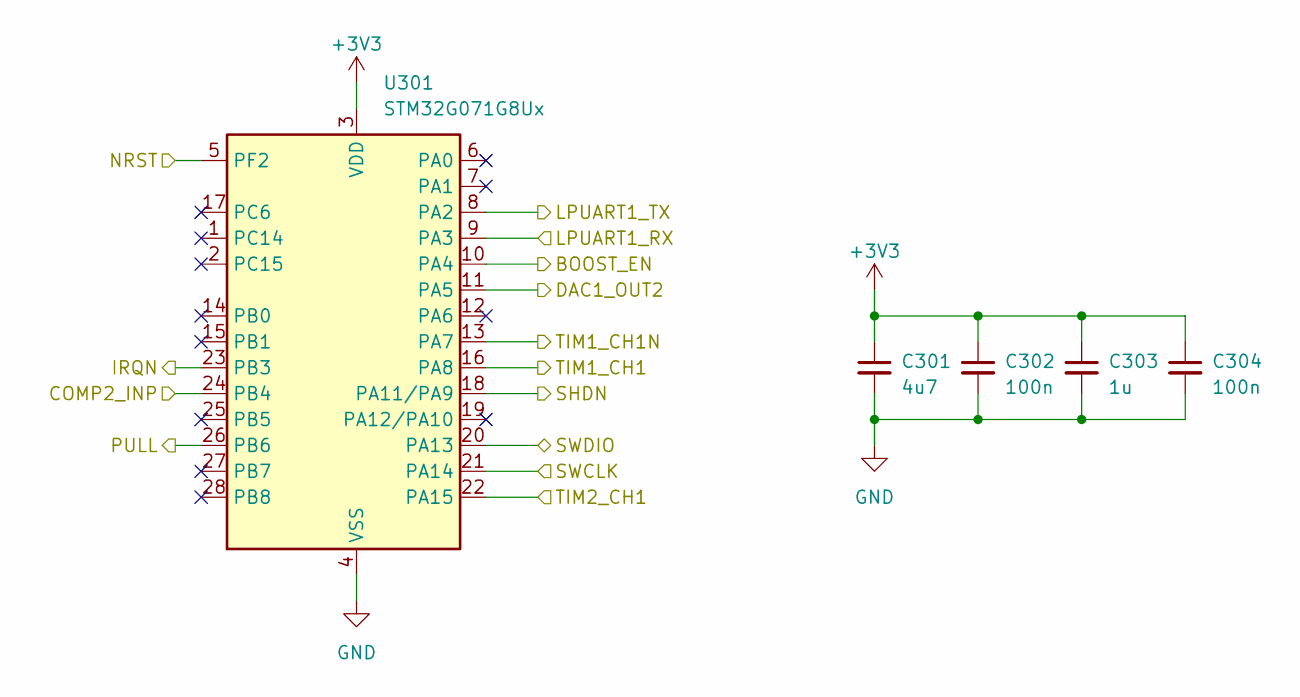
[picture p112: schematic stm32g0.kicad_sch]

Parts:
C301: 4u7; C_0402_1005Metric
C302, C304: 100n; C_0402_1005Metric
C303: 1u; C_0402_1005Metric
U301: STM32G071G8Ux; QFN-28_4x4mm_P0.5mm

Connections:
+3V3: C301.1, C302.1, C303.1, C304.1, U301.3 (VDD); also elsewhere on the board
/Boost Converter/EN: U301.10 (PA4); also elsewhere on the board
/Boost Converter/FB_OFFSET: U301.11 (PA5); also elsewhere on the board
/Pogo Connector/IRQN: U301.23 (PB3); also elsewhere on the board
/Pogo Connector/LPUART1_RX: U301.9 (PA3); also elsewhere on the board
/Pogo Connector/LPUART1_TX: U301.8 (PA2); also elsewhere on the board
/Pogo Connector/NRST: U301.5 (PF2); also elsewhere on the board
/Pogo Connector/SWCLK: U301.21 (PA14); also elsewhere on the board
/Pogo Connector/SWDIO: U301.20 (PA13); also elsewhere on the board
/RFID/CARRIER: U301.22 (PA15); also elsewhere on the board
/RFID/OUT: U301.16 (PA8); also elsewhere on the board
/RFID/OUTN: U301.13 (PA7); also elsewhere on the board
/RFID/PULL: U301.26 (PB6); also elsewhere on the board
/RFID/RF_IN: U301.24 (PB4); also elsewhere on the board
/RFID/SHDN: U301.18 (PA11/PA9); also elsewhere on the board
GND: C301.2, C302.2, C303.2, C304.2, U301.4 (VSS); also elsewhere on the board

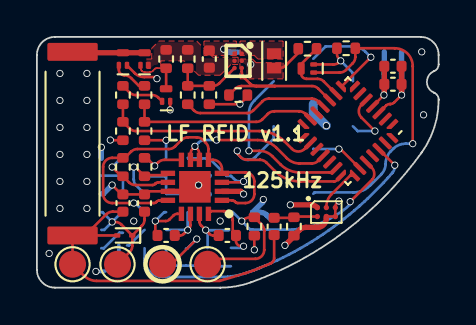
[picture p113: board rfid_module.kicad_pcb from above]

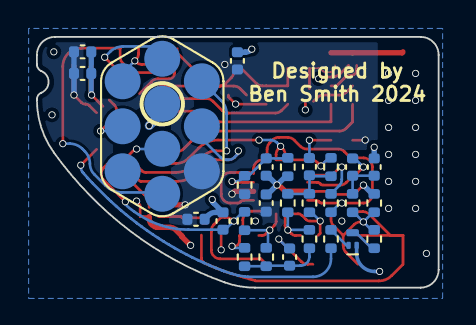
[picture p114: board rfid_module.kicad_pcb from below]

Board: 4 copper layers, 22.3 x 13.9 mm, 66 parts (27 on the bottom side), 42 nets.
