ben5049/Smart-Watch/PCBs/watch_main_v3/watch_main.kicad_pcb

## KiCad design PCBs/watch_main_v3/watch_main.kicad_pcb (2024-03-26)

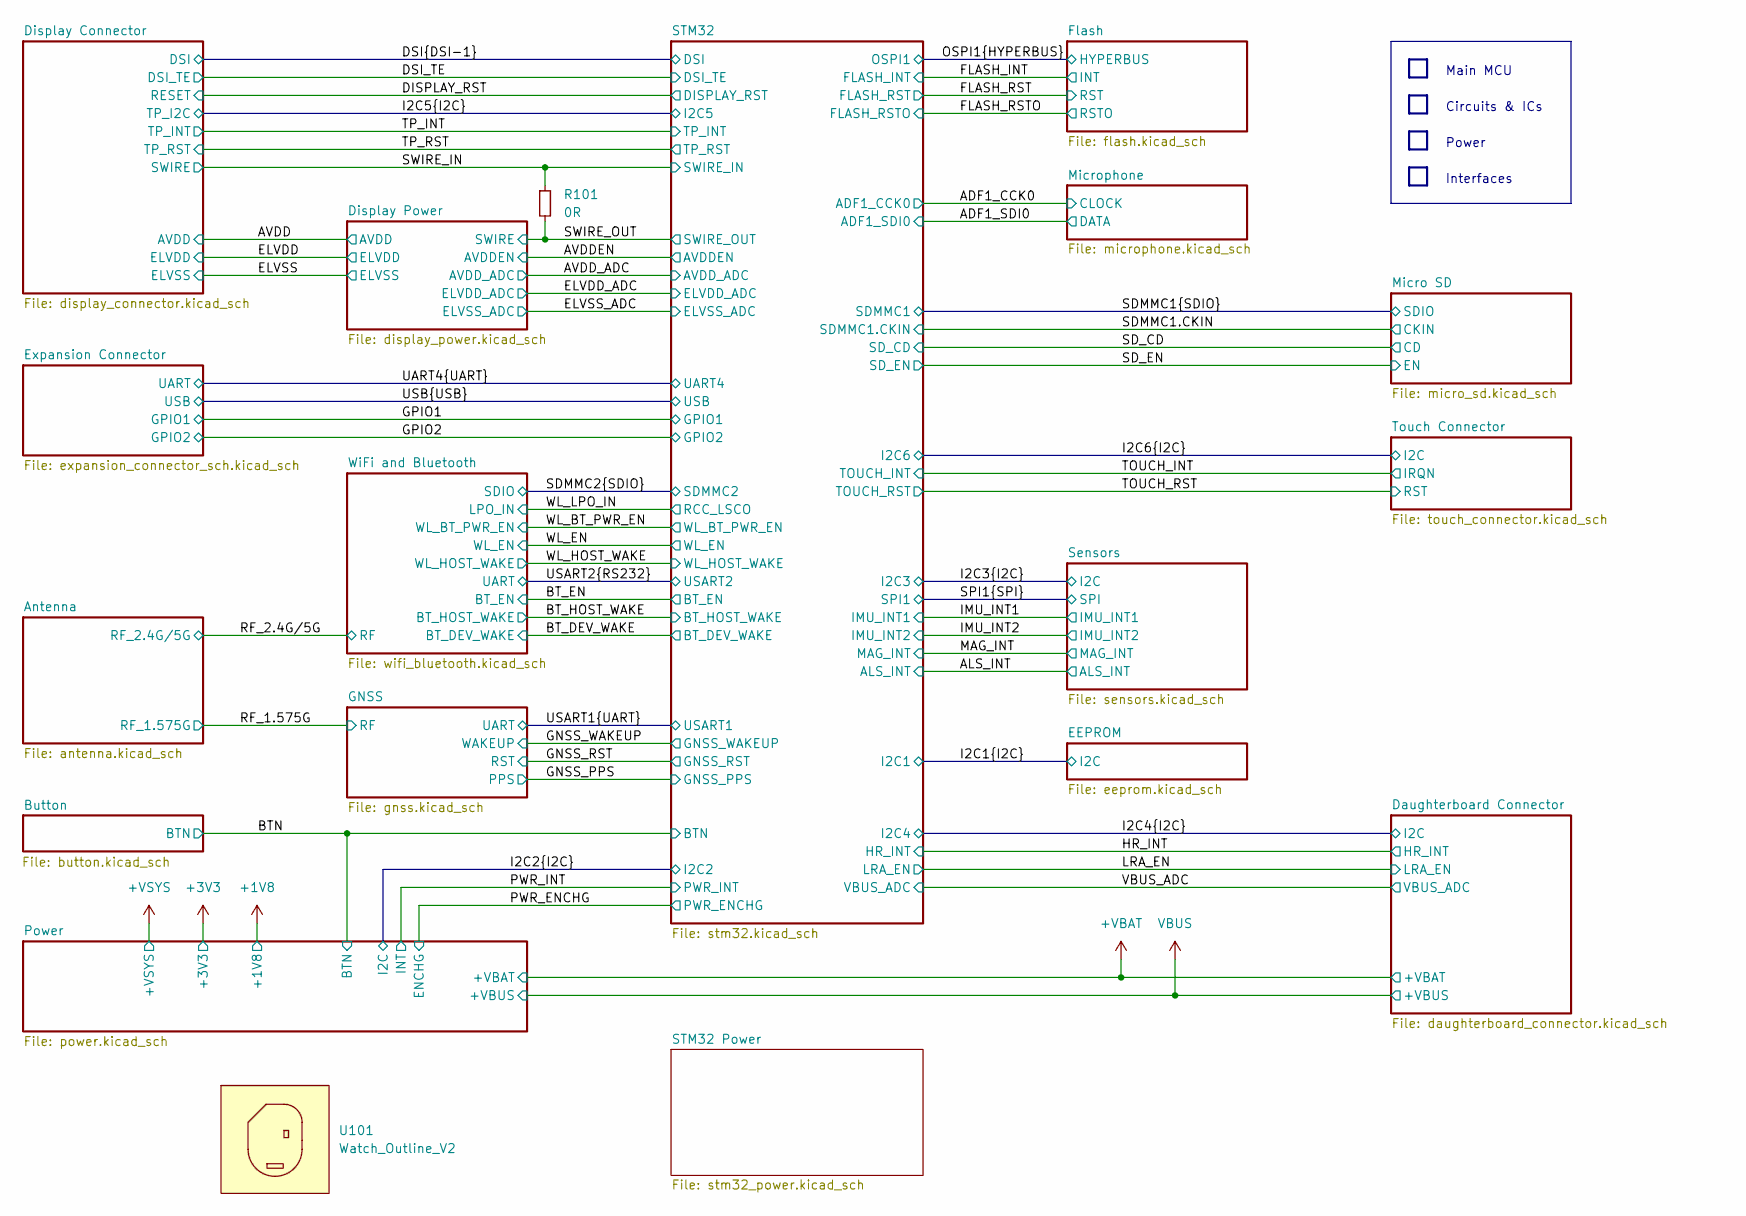
[picture p115: schematic watch_main.kicad_sch, Watch Main Board]

Parts:
R101: 0R; R_0402_1005Metric
U101: Watch_Outline_V2; Watch Outline V3

Connections:
/SWIRE_IN: R101.1; also elsewhere on the board
/SWIRE_OUT: R101.2; also elsewhere on the board

Notes on the sheet:
Interfaces
Circuits & ICs
Power
Main MCU

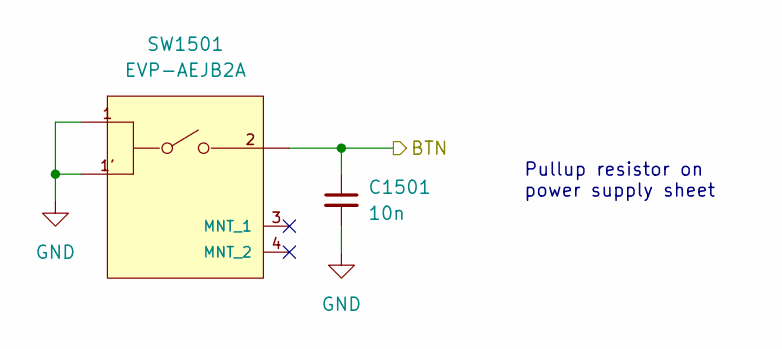
[picture p116: schematic button.kicad_sch, Watch Button]

Parts:
C1501: 10n; C_0402_1005Metric
SW1501: EVP-AEJB2A; Panasonic-EVP-AEJB2A-MFG; voltage rating DC 15V; mouser part number 667-EVP-AEJB2A; digikey description SWITCH TACTILE SPST-NO 0.02A 15V

Connections:
/BTN: C1501.1, SW1501.2; also elsewhere on the board
GND: C1501.2, SW1501.1, SW1501.1'; also elsewhere on the board

Notes on the sheet:
Pullup resistor on power supply sheet

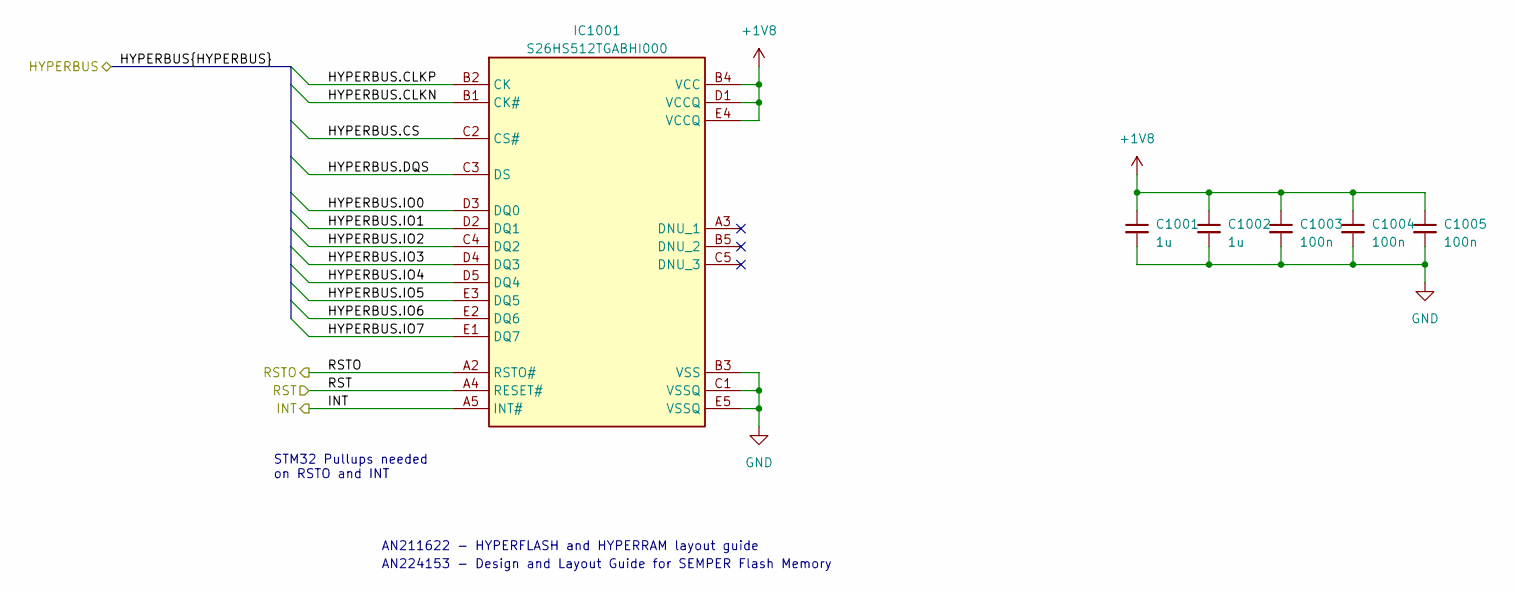
[picture p117: schematic flash.kicad_sch, Watch Flash]

Parts:
C1001, C1002: 1u; C_0402_1005Metric
C1003, C1004, C1005: 100n; C_0402_1005Metric
IC1001: S26HS512TGABHI000; BGA24C100P5X5_600X800X100; Mouser Part Number 727-S26HS512TGABHI00

Connections:
+1V8: C1001.1, C1002.1, C1003.1, C1004.1, C1005.1, IC1001.B4 (VCC), IC1001.D1 (VCCQ), IC1001.E4 (VCCQ); also elsewhere on the board
/FLASH_INT: IC1001.A5 (INT#); also elsewhere on the board
/FLASH_RST: IC1001.A4 (RESET#); also elsewhere on the board
/FLASH_RSTO: IC1001.A2 (RSTO#); also elsewhere on the board
/OSPI1.CLKN: IC1001.B1 (CK#); also elsewhere on the board
/OSPI1.CLKP: IC1001.B2 (CK); also elsewhere on the board
/OSPI1.CS: IC1001.C2 (CS#); also elsewhere on the board
/OSPI1.DQS: IC1001.C3 (DS); also elsewhere on the board
/OSPI1.IO0: IC1001.D3 (DQ0); also elsewhere on the board
/OSPI1.IO1: IC1001.D2 (DQ1); also elsewhere on the board
/OSPI1.IO2: IC1001.C4 (DQ2); also elsewhere on the board
/OSPI1.IO3: IC1001.D4 (DQ3); also elsewhere on the board
/OSPI1.IO4: IC1001.D5 (DQ4); also elsewhere on the board
/OSPI1.IO5: IC1001.E3 (DQ5); also elsewhere on the board
/OSPI1.IO6: IC1001.E2 (DQ6); also elsewhere on the board
/OSPI1.IO7: IC1001.E1 (DQ7); also elsewhere on the board
GND: C1001.2, C1002.2, C1003.2, C1004.2, C1005.2, IC1001.B3 (VSS), IC1001.C1 (VSSQ), IC1001.E5 (VSSQ); also elsewhere on the board

Notes on the sheet:
STM32 Pullups needed on RSTO and INT
AN224153 - Design and Layout Guide for SEMPER Flash Memory
AN211622 - HYPERFLASH and HYPERRAM layout guide

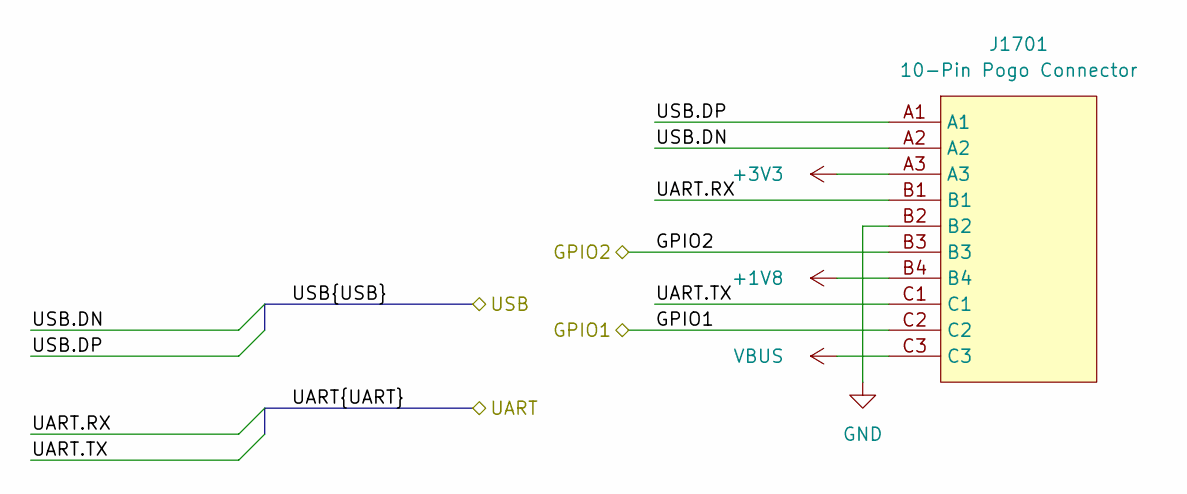
[picture p118: schematic expansion_connector_sch.kicad_sch, Watch Expansion Connector]

Parts:
J1701: 10-Pin Pogo Connector

Connections:
+1V8: J1701.B4; also elsewhere on the board
+3V3: J1701.A3; also elsewhere on the board
/GPIO1: J1701.C2; also elsewhere on the board
/GPIO2: J1701.B3; also elsewhere on the board
/UART4.RX: J1701.B1; also elsewhere on the board
/UART4.TX: J1701.C1; also elsewhere on the board
/USB.DN: J1701.A2; also elsewhere on the board
/USB.DP: J1701.A1; also elsewhere on the board
GND: J1701.B2; also elsewhere on the board
VBUS: J1701.C3; also elsewhere on the board

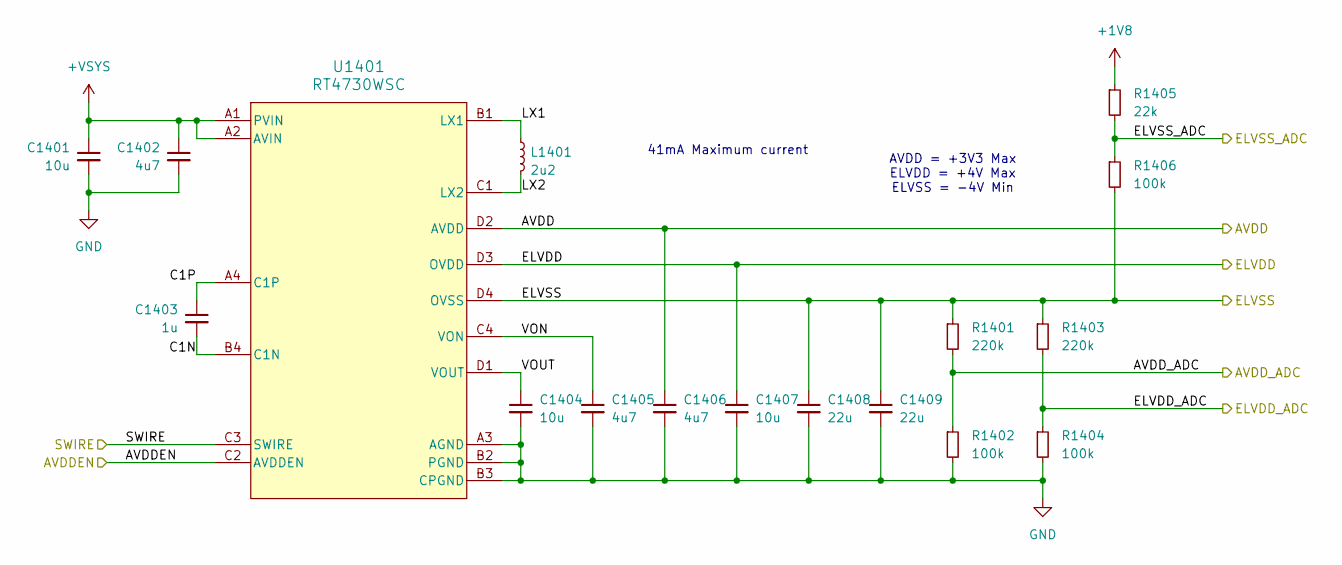
[picture p119: schematic display_power.kicad_sch, Watch Display Power]

Parts:
C1401, C1404, C1407: 10u; C_0402_1005Metric
C1402, C1405, C1406: 4u7; C_0402_1005Metric
C1403: 1u; C_0402_1005Metric
C1408, C1409: 22u; C_0402_1005Metric
L1401: 2u2; L_Murata_DFE201610P
R1401, R1403: 220k; R_0402_1005Metric
R1402, R1404, R1406: 100k; R_0402_1005Metric
R1405: 22k; R_0402_1005Metric
U1401: RT4730WSC

Connections:
+1V8: R1405.1; also elsewhere on the board
+VSYS: C1401.1, C1402.1, U1401.A1 (PVIN), U1401.A2 (AVIN); also elsewhere on the board
/AVDD: C1406.1, U1401.D2 (AVDD); also elsewhere on the board
/AVDDEN: U1401.C2 (AVDDEN); also elsewhere on the board
/AVDD_ADC: R1401.2, R1402.1; also elsewhere on the board
/Display Power/C1N: C1403.2, U1401.B4 (C1N)
/Display Power/C1P: C1403.1, U1401.A4 (C1P)
/Display Power/LX1: L1401.1, U1401.B1 (LX1)
/Display Power/LX2: L1401.2, U1401.C1 (LX2)
/Display Power/VON: C1405.1, U1401.C4 (VON)
/Display Power/VOUT: C1404.1, U1401.D1 (VOUT)
/ELVDD: C1407.1, U1401.D3 (OVDD); also elsewhere on the board
/ELVDD_ADC: R1403.2, R1404.1; also elsewhere on the board
/ELVSS: C1408.1, C1409.1, R1401.1, R1403.1, R1406.2, U1401.D4 (OVSS); also elsewhere on the board
/ELVSS_ADC: R1405.2, R1406.1; also elsewhere on the board
/SWIRE_OUT: U1401.C3 (SWIRE); also elsewhere on the board
GND: C1401.2, C1402.2, C1404.2, C1405.2, C1406.2, C1407.2, C1408.2, C1409.2, R1402.2, R1404.2, U1401.A3 (AGND), U1401.B2 (PGND), U1401.B3 (CPGND); also elsewhere on the board

Notes on the sheet:
AVDD = +3V3 Max ELVDD = +4V Max ELVSS = -4V Min
41mA Maximum current

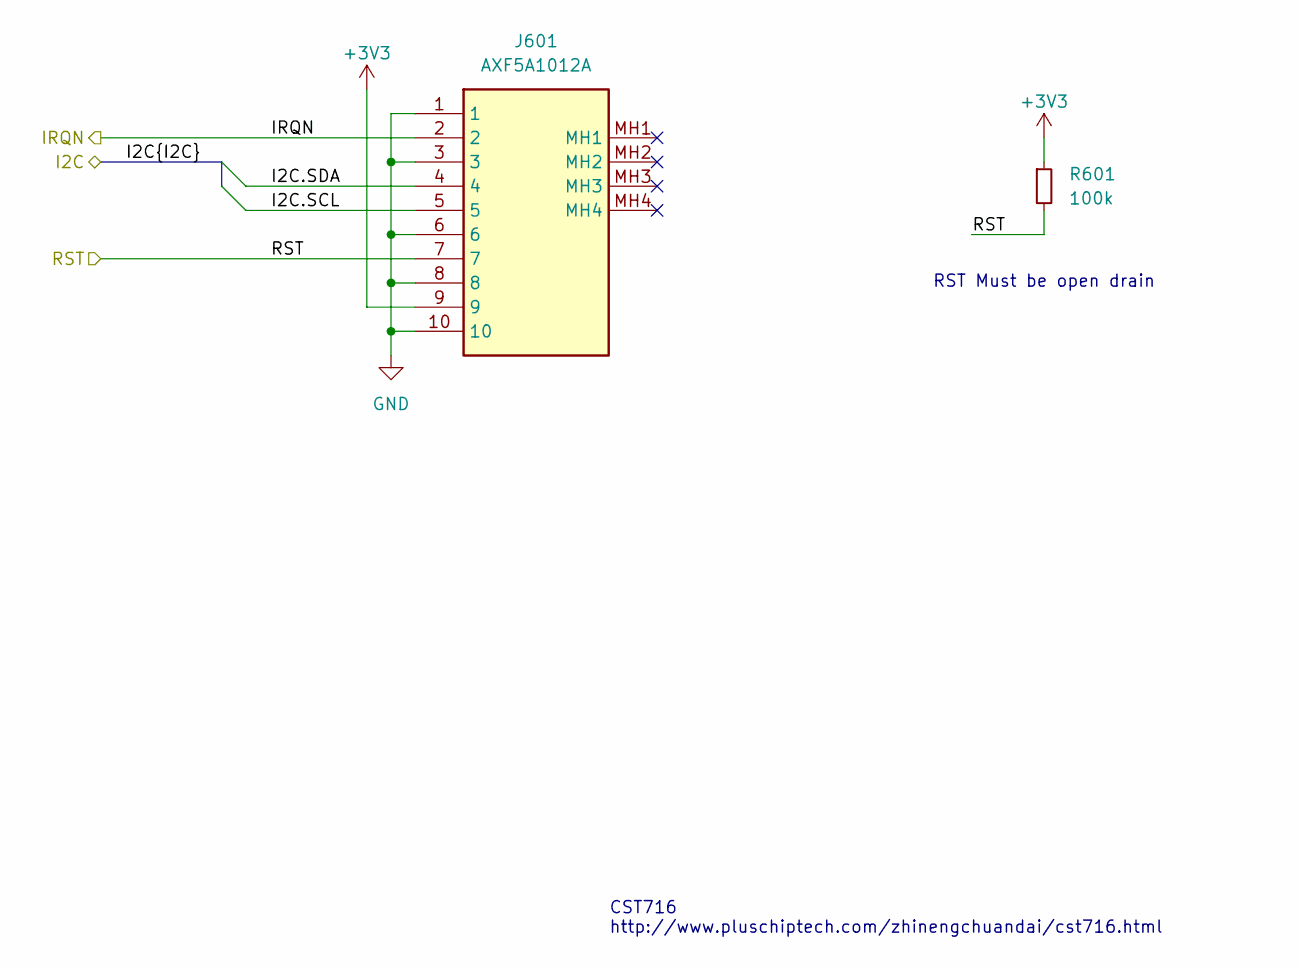
[picture p120: schematic touch_connector.kicad_sch]

Parts:
J601: AXF5A1012A
R601: 100k; R_0402_1005Metric

Connections:
+3V3: J601.9, R601.1; also elsewhere on the board
/I2C6.SCL: J601.5; also elsewhere on the board
/I2C6.SDA: J601.4; also elsewhere on the board
/TOUCH_INT: J601.2; also elsewhere on the board
/TOUCH_RST: J601.7, R601.2; also elsewhere on the board
GND: J601.1, J601.3, J601.6, J601.8, J601.10; also elsewhere on the board

Notes on the sheet:
RST Must be open drain
CST716 http://www.pluschiptech.com/zhinengchuandai/cst716.html

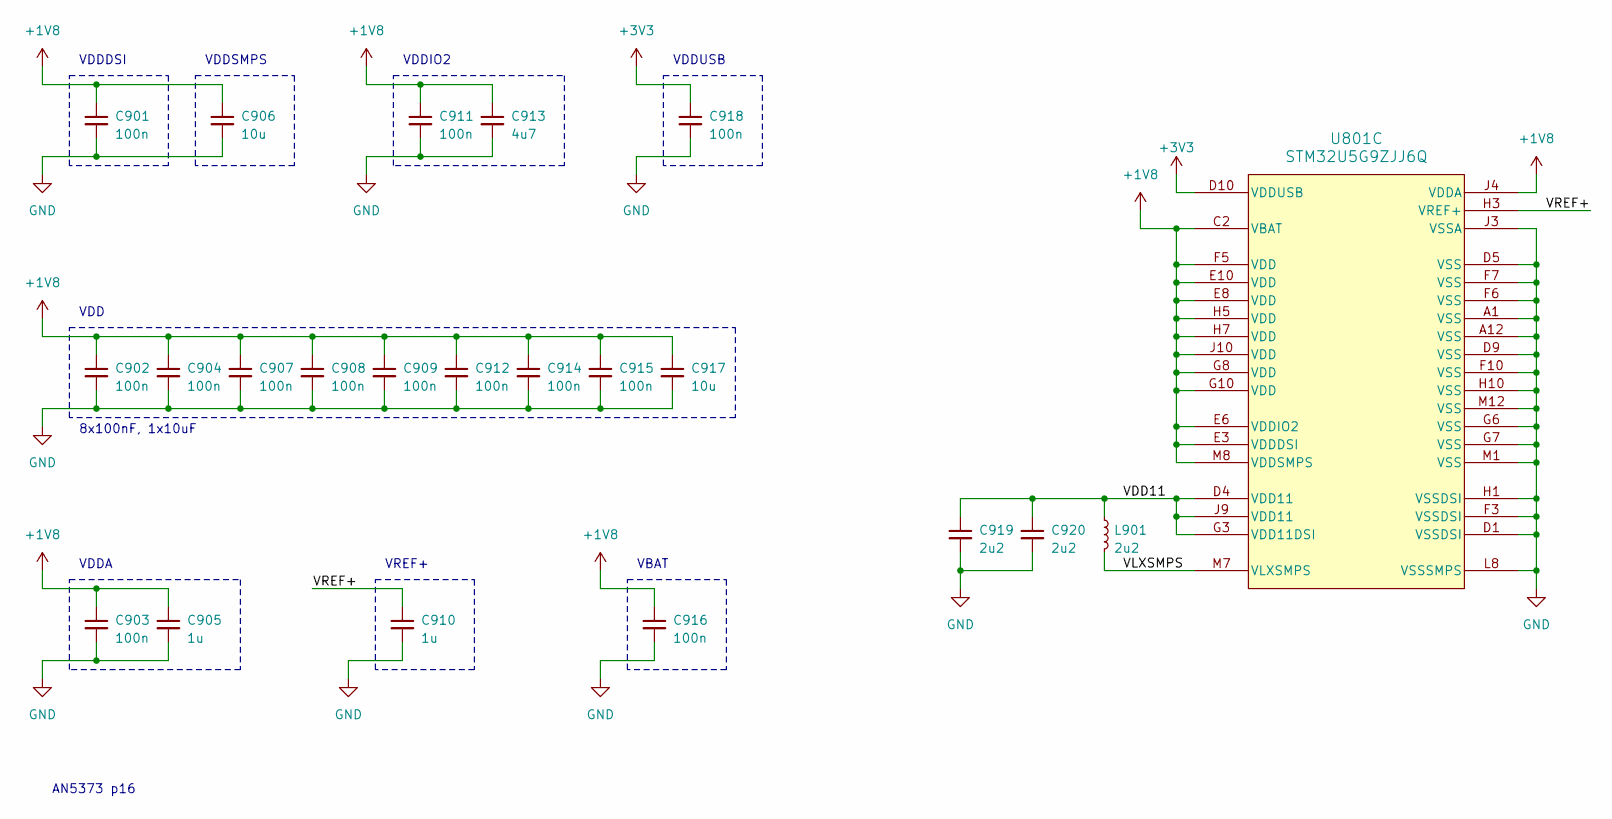
[picture p121: schematic stm32_power.kicad_sch, Watch Main MCU Power]

Parts:
C901, C902, C903, C904, C907, C908, C909, C911, C912, C914, C915, C916, C918: 100n; C_0201_0603Metric
C905, C910: 1u; C_0201_0603Metric
C906, C917: 10u; C_0402_1005Metric
C913: 4u7; C_0402_1005Metric
C919, C920: 2u2; C_0201_0603Metric
L901: 2u2; L_Murata_DFE201610P
U801: STM32U5G9ZJJ6Q; UFBGA144_STM

Connections:
+1V8: C901.1, C902.1, C903.1, C904.1, C905.1, C906.1, C907.1, C908.1, C909.1, C911.1, C912.1, C913.1, C914.1, C915.1, C916.1, C917.1, U801.C2 (VBAT), U801.E3 (VDDDSI), U801.E6 (VDDIO2), U801.E8 (VDD), U801.E10 (VDD), U801.F5 (VDD), U801.G8 (VDD), U801.G10 (VDD), U801.H5 (VDD), U801.H7 (VDD), U801.J4 (VDDA), U801.J10 (VDD), U801.M8 (VDDSMPS); also elsewhere on the board
+3V3: C918.1, U801.D10 (VDDUSB); also elsewhere on the board
/STM32 Power/VDD11: C919.1, C920.1, L901.1, U801.D4 (VDD11), U801.G3 (VDD11DSI), U801.J9 (VDD11)
/STM32 Power/VLXSMPS: L901.2, U801.M7 (VLXSMPS)
/STM32 Power/VREF+: C910.1, U801.H3 (VREF+)
GND: C901.2, C902.2, C903.2, C904.2, C905.2, C906.2, C907.2, C908.2, C909.2, C910.2, C911.2, C912.2, C913.2, C914.2, C915.2, C916.2, C917.2, C918.2, C919.2, C920.2, U801.A1 (VSS), U801.A12 (VSS), U801.D1 (VSSDSI), U801.D5 (VSS), U801.D9 (VSS), U801.F3 (VSSDSI), U801.F6 (VSS), U801.F7 (VSS), U801.F10 (VSS), U801.G6 (VSS), U801.G7 (VSS), U801.H1 (VSSDSI), U801.H10 (VSS), U801.J3 (VSSA), U801.L8 (VSSSMPS), U801.M1 (VSS), U801.M12 (VSS); also elsewhere on the board

Notes on the sheet:
VDDUSB
VDDIO2
VREF+
VDD
VDDSMPS
VDDA
VBAT
AN5373 p16
8x100nF, 1x10uF
VDDDSI
