ben5049/Smart-Watch/PCBs/watch_main_v3/watch_main.kicad_pcb

## KiCad design PCBs/watch_main_v3/watch_main.kicad_pcb (continued)

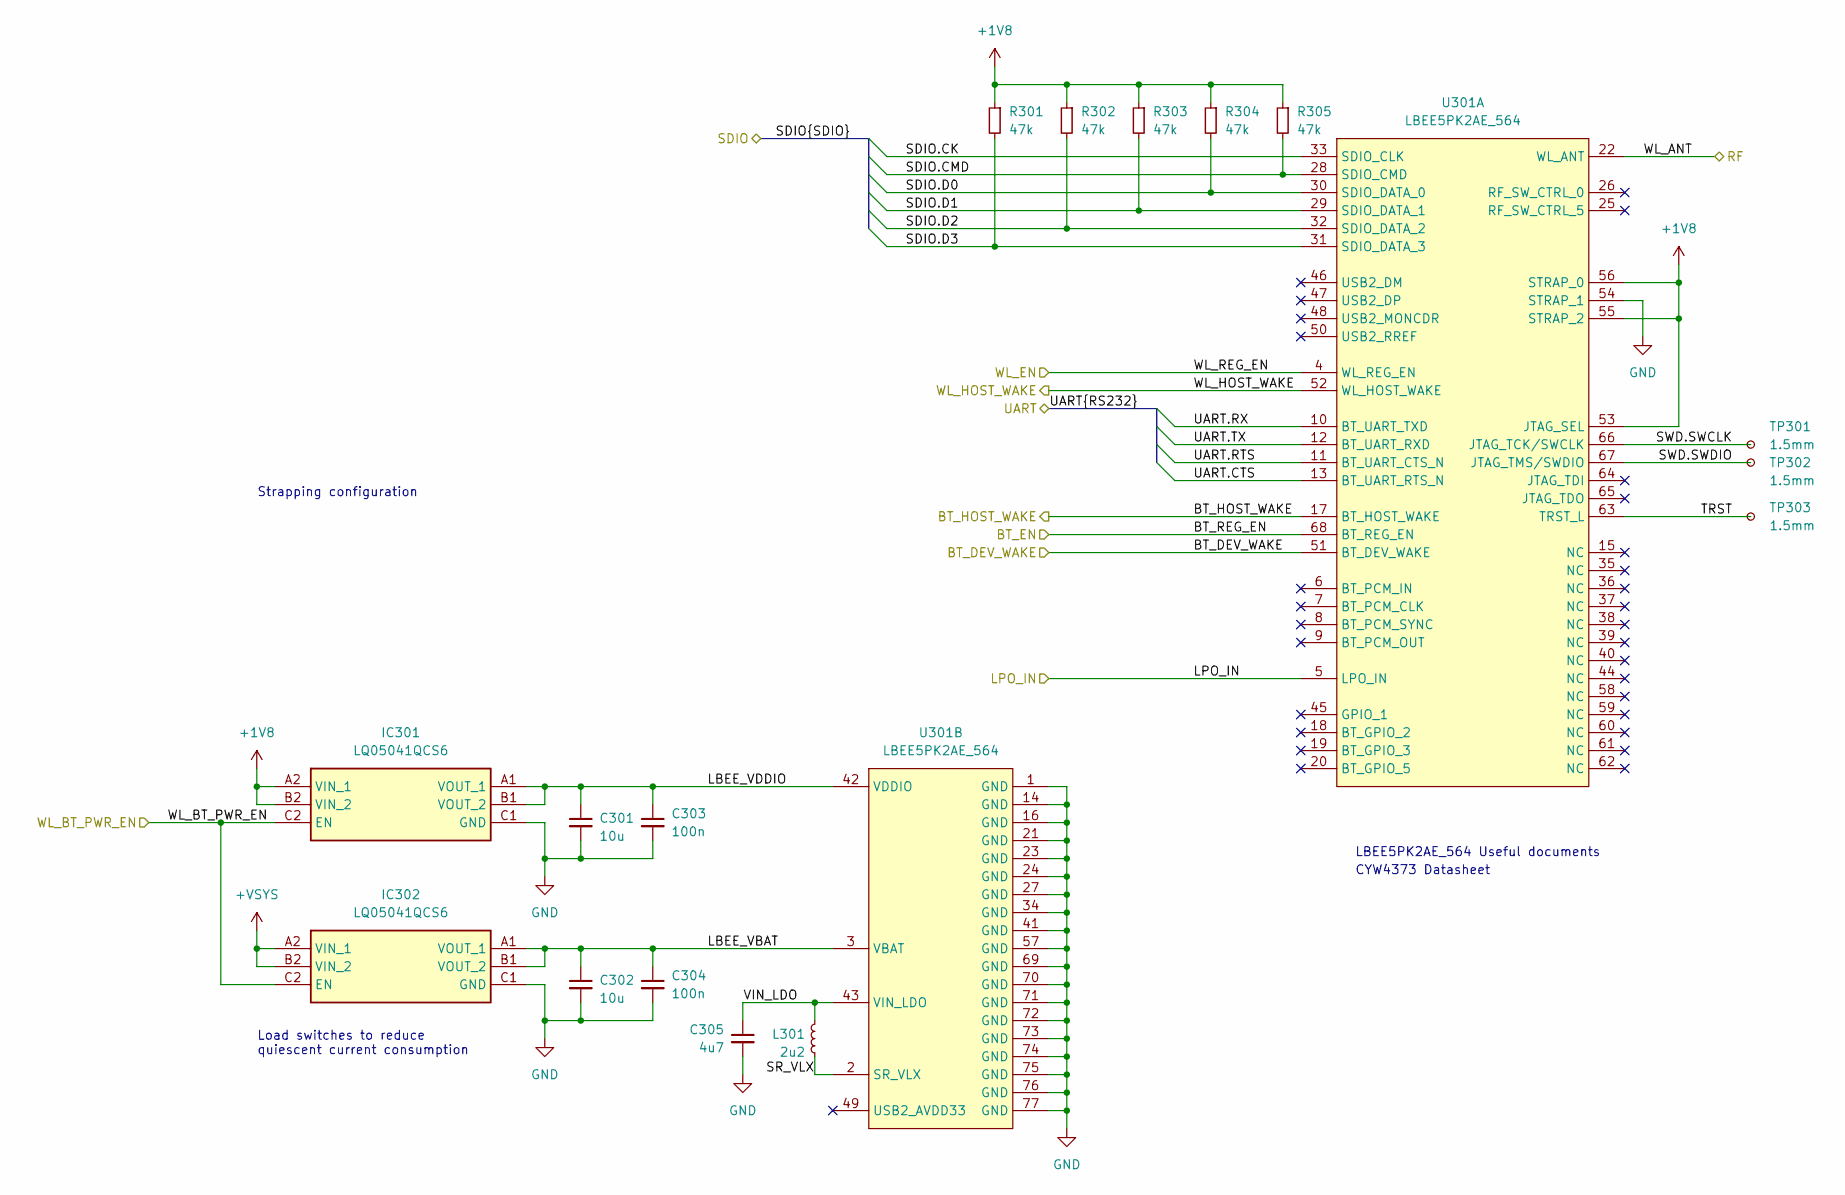
[picture p122: schematic wifi_bluetooth.kicad_sch, Watch Bluetooth]

Parts:
C301, C302: 10u; C_0402_1005Metric
C303, C304: 100n; C_0402_1005Metric
C305: 4u7; C_0402_1005Metric
IC301, IC302: LQ05041QCS6; BGA6C50P2X3_97X147X60; Manufacturer_Part_Number LQ05041QCS6
L301: 2u2; L_Murata_DFE201610P
R301, R302, R303, R304, R305: 47k; R_0402_1005Metric
TP301, TP302, TP303: 1.5mm; TestPoint_Pad_D1.5mm
U301: LBEE5PK2AE_564; LBEE5PK2AE-564

Connections:
+1V8: IC301.A2 (VIN_1), IC301.B2 (VIN_2), R301.1, R302.1, R303.1, R304.1, R305.1, U301.53 (JTAG_SEL), U301.55 (STRAP_2), U301.56 (STRAP_0); also elsewhere on the board
+VSYS: IC302.A2 (VIN_1), IC302.B2 (VIN_2); also elsewhere on the board
/BT_DEV_WAKE: U301.51 (BT_DEV_WAKE); also elsewhere on the board
/BT_EN: U301.68 (BT_REG_EN); also elsewhere on the board
/BT_HOST_WAKE: U301.17 (BT_HOST_WAKE); also elsewhere on the board
/RF_2.4G/5G: U301.22 (WL_ANT); also elsewhere on the board
/SDMMC2.CK: U301.33 (SDIO_CLK); also elsewhere on the board
/SDMMC2.CMD: R305.2, U301.28 (SDIO_CMD); also elsewhere on the board
/SDMMC2.D0: R304.2, U301.30 (SDIO_DATA_0); also elsewhere on the board
/SDMMC2.D1: R303.2, U301.29 (SDIO_DATA_1); also elsewhere on the board
/SDMMC2.D2: R302.2, U301.32 (SDIO_DATA_2); also elsewhere on the board
/SDMMC2.D3: R301.2, U301.31 (SDIO_DATA_3); also elsewhere on the board
/USART2.CTS: U301.13 (BT_UART_RTS_N); also elsewhere on the board
/USART2.RTS: U301.11 (BT_UART_CTS_N); also elsewhere on the board
/USART2.RX: U301.10 (BT_UART_TXD); also elsewhere on the board
/USART2.TX: U301.12 (BT_UART_RXD); also elsewhere on the board
/WL_BT_PWR_EN: IC301.C2 (EN), IC302.C2 (EN); also elsewhere on the board
/WL_EN: U301.4 (WL_REG_EN); also elsewhere on the board
/WL_HOST_WAKE: U301.52 (WL_HOST_WAKE); also elsewhere on the board
/WL_LPO_IN: U301.5 (LPO_IN); also elsewhere on the board
/WiFi and Bluetooth/LBEE_VBAT: C302.1, C304.1, IC302.A1 (VOUT_1), IC302.B1 (VOUT_2), U301.3 (VBAT)
/WiFi and Bluetooth/LBEE_VDDIO: C301.1, C303.1, IC301.A1 (VOUT_1), IC301.B1 (VOUT_2), U301.42 (VDDIO)
/WiFi and Bluetooth/SR_VLX: L301.2, U301.2 (SR_VLX)
/WiFi and Bluetooth/SWD.SWCLK: TP301.1, U301.66 (JTAG_TCK/SWCLK)
/WiFi and Bluetooth/SWD.SWDIO: TP302.1, U301.67 (JTAG_TMS/SWDIO)
/WiFi and Bluetooth/TRST: TP303.1, U301.63 (TRST_L)
/WiFi and Bluetooth/VIN_LDO: C305.1, L301.1, U301.43 (VIN_LDO)
GND: C301.2, C302.2, C303.2, C304.2, C305.2, IC301.C1 (GND), IC302.C1 (GND), U301.1 (GND), U301.14 (GND), U301.16 (GND), U301.21 (GND), U301.23 (GND), U301.24 (GND), U301.27 (GND), U301.34 (GND), U301.41 (GND), U301.54 (STRAP_1), U301.57 (GND), U301.69 (GND), U301.70 (GND), U301.71 (GND), U301.72 (GND), U301.73 (GND), U301.74 (GND), U301.75 (GND), U301.76 (GND), U301.77 (GND); also elsewhere on the board

Notes on the sheet:
Strapping configuration
LBEE5PK2AE_564 Useful documents
Load switches to reduce quiescent current consumption
CYW4373 Datasheet

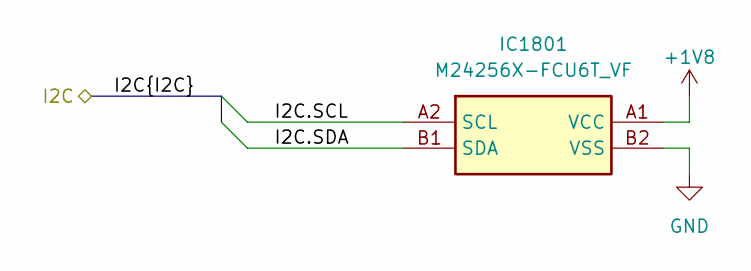
[picture p123: schematic eeprom.kicad_sch, Watch EEPROM]

Parts:
IC1801: M24256X-FCU6T_VF; BGA4C50P2X2_70X98X33; Mouser Part Number 511-M24256X-FCU6T/VF

Connections:
+1V8: IC1801.A1 (VCC); also elsewhere on the board
/I2C1.SCL: IC1801.A2 (SCL); also elsewhere on the board
/I2C1.SDA: IC1801.B1 (SDA); also elsewhere on the board
GND: IC1801.B2 (VSS); also elsewhere on the board

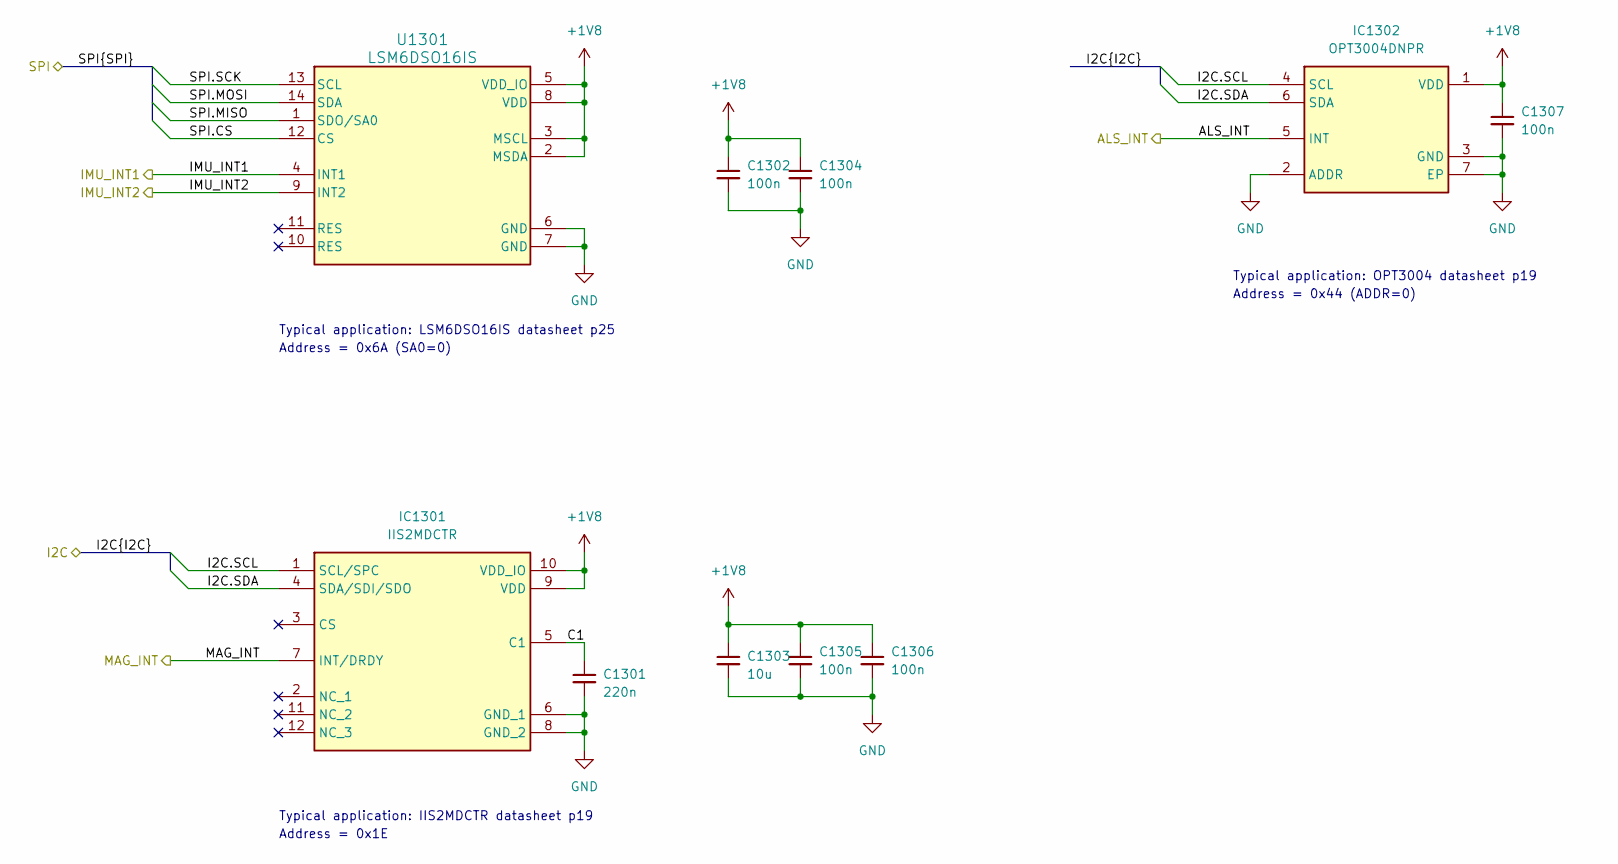
[picture p124: schematic sensors.kicad_sch, Watch Sensors]

Parts:
C1301: 220n; C_0402_1005Metric
C1302, C1304, C1305, C1306, C1307: 100n; C_0402_1005Metric
C1303: 10u; C_0402_1005Metric
IC1301: IIS2MDCTR; Mouser Part Number 511-IIS2MDCTR
IC1302: OPT3004DNPR; SON65P200X200X65-7N-D; Mouser Part Number 595-OPT3004DNPR
U1301: LSM6DSO16IS; LGA14_LSM6_STM

Connections:
+1V8: C1302.1, C1303.1, C1304.1, C1305.1, C1306.1, C1307.1, IC1301.9 (VDD), IC1301.10 (VDD_IO), IC1302.1 (VDD), U1301.2 (MSDA), U1301.3 (MSCL), U1301.5 (VDD_IO), U1301.8 (VDD); also elsewhere on the board
/ALS_INT: IC1302.5 (INT); also elsewhere on the board
/I2C3.SCL: IC1301.1 (SCL/SPC), IC1302.4 (SCL); also elsewhere on the board
/I2C3.SDA: IC1301.4 (SDA/SDI/SDO), IC1302.6 (SDA); also elsewhere on the board
/IMU_INT1: U1301.4 (INT1); also elsewhere on the board
/IMU_INT2: U1301.9 (INT2); also elsewhere on the board
/MAG_INT: IC1301.7 (INT/DRDY); also elsewhere on the board
/SPI1.CS: U1301.12 (CS); also elsewhere on the board
/SPI1.MISO: U1301.1 (SDO/SA0); also elsewhere on the board
/SPI1.MOSI: U1301.14 (SDA); also elsewhere on the board
/SPI1.SCK: U1301.13 (SCL); also elsewhere on the board
/Sensors/C1: C1301.1, IC1301.5 (C1)
GND: C1301.2, C1302.2, C1303.2, C1304.2, C1305.2, C1306.2, C1307.2, IC1301.6 (GND_1), IC1301.8 (GND_2), IC1302.2 (ADDR), IC1302.3 (GND), IC1302.7 (EP), U1301.6 (GND), U1301.7 (GND); also elsewhere on the board

Notes on the sheet:
Address = 0x1E
Address = 0x6A (SA0=0)
Address = 0x44 (ADDR=0)
Typical application: LSM6DSO16IS datasheet p25
Typical application: IIS2MDCTR datasheet p19
Typical application: OPT3004 datasheet p19

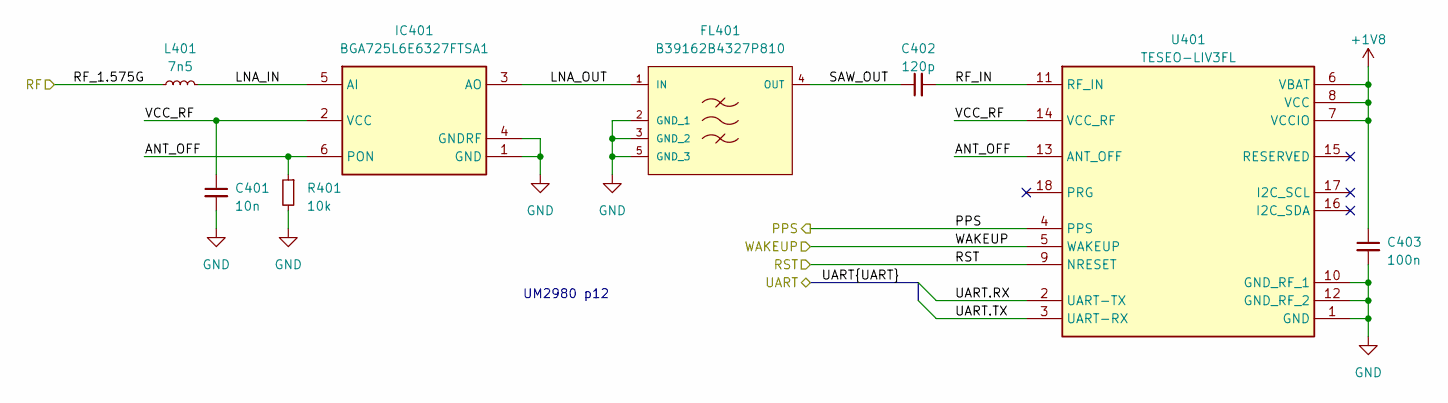
[picture p125: schematic gnss.kicad_sch, Watch GNSS]

Parts:
C401: 10n; C_0402_1005Metric
C402: 120p; C_0402_1005Metric
C403: 100n; C_0402_1005Metric
FL401: B39162B4327P810; mouser part number 871-B39162B4327P810; digikey description FILTER SAW 5SMD
IC401: BGA725L6E6327FTSA1; BGS12SN6E6327XTSA1; Mouser Part Number 726-BGA725L6E6327FTS
L401: 7n5; L_0402_1005Metric
R401: 10k; R_0402_1005Metric
U401: TESEO-LIV3FL; TESEOLIV3FL; Mouser Part Number 511-TESEO-LIV4FTR

Connections:
+1V8: C403.1, U401.6 (VBAT), U401.7 (VCCIO), U401.8 (VCC); also elsewhere on the board
/GNSS/ANT_OFF: IC401.6 (PON), R401.1, U401.13 (ANT_OFF)
/GNSS/LNA_IN: IC401.5 (AI), L401.2
/GNSS/LNA_OUT: FL401.1 (IN), IC401.3 (AO)
/GNSS/RF_IN: C402.2, U401.11 (RF_IN)
/GNSS/SAW_OUT: C402.1, FL401.4 (OUT)
/GNSS/VCC_RF: C401.1, IC401.2 (VCC), U401.14 (VCC_RF)
/GNSS_PPS: U401.4 (PPS); also elsewhere on the board
/GNSS_RST: U401.9 (NRESET); also elsewhere on the board
/GNSS_WAKEUP: U401.5 (WAKEUP); also elsewhere on the board
/RF_1.575G: L401.1; also elsewhere on the board
/USART1.RX: U401.2 (UART-TX); also elsewhere on the board
/USART1.TX: U401.3 (UART-RX); also elsewhere on the board
GND: C401.2, C403.2, FL401.2 (GND_1), FL401.3 (GND_2), FL401.5 (GND_3), IC401.1 (GND), IC401.4 (GNDRF), R401.2, U401.1 (GND), U401.10 (GND_RF_1), U401.12 (GND_RF_2); also elsewhere on the board

Notes on the sheet:
UM2980 p12

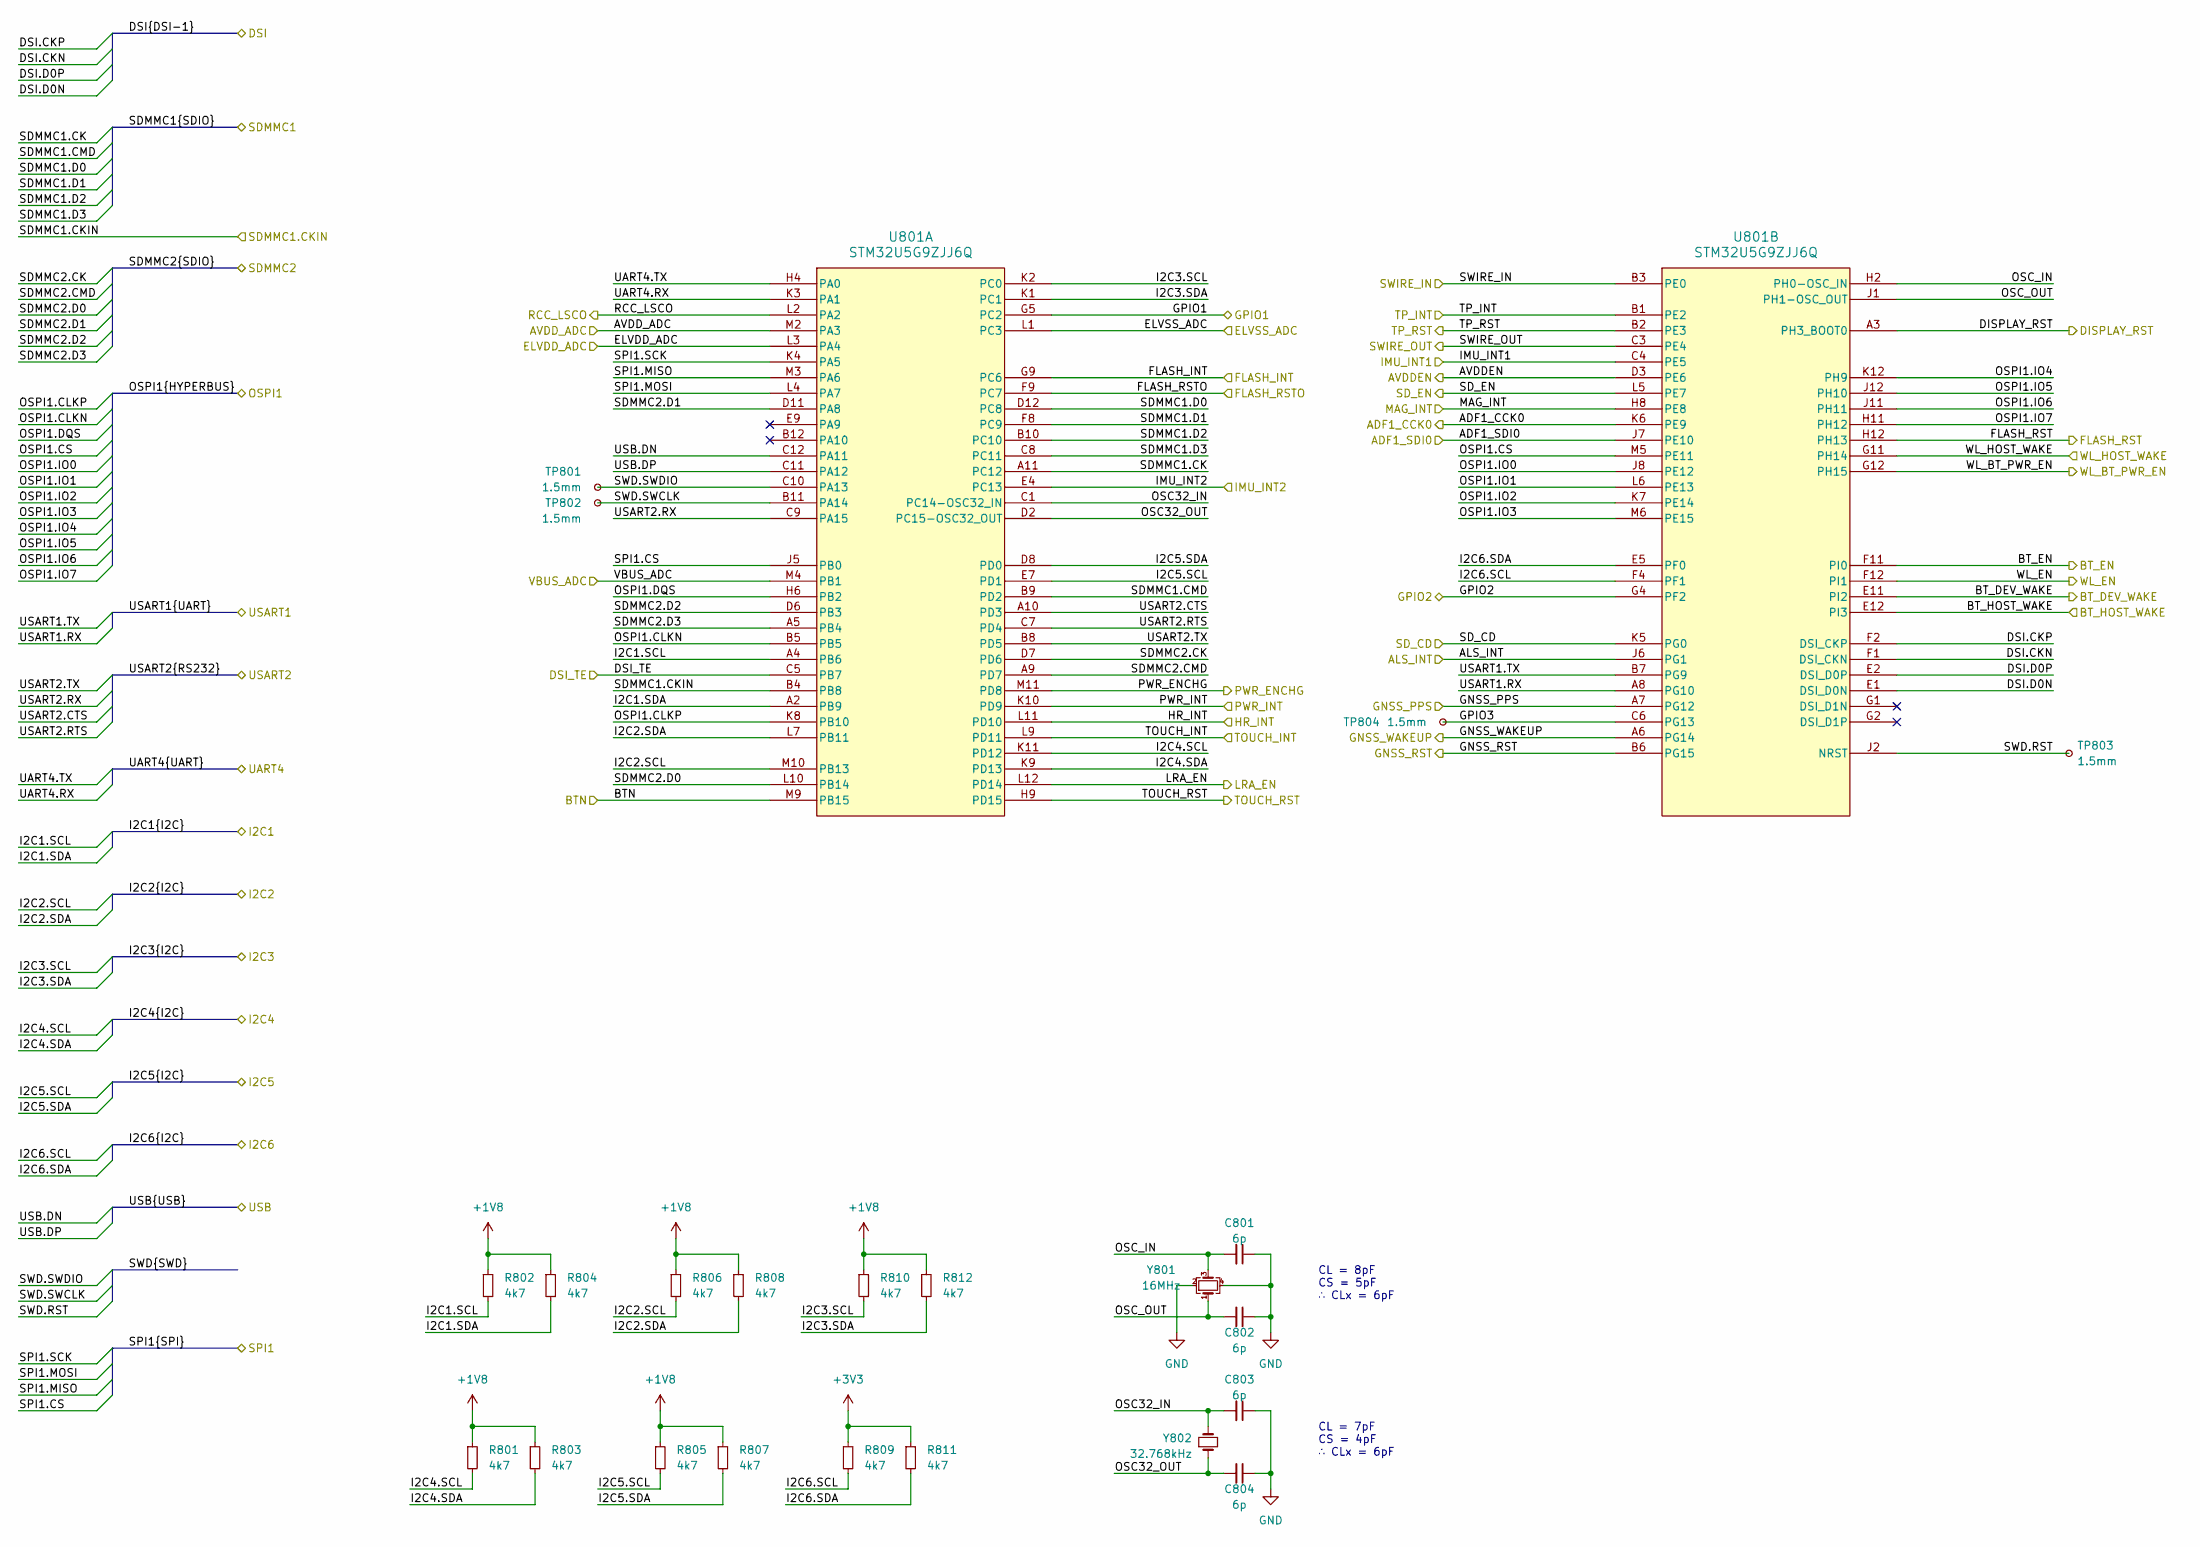
[picture p126: schematic stm32.kicad_sch, Watch Main MCU]

Parts:
C801, C802, C803, C804: 6p; C_0402_1005Metric
R801, R802, R803, R804, R805, R806, R807, R808, R809, R810, R811, R812: 4k7; R_0402_1005Metric
TP801, TP802, TP803, TP804: 1.5mm; TestPoint_Pad_D1.5mm
U801: STM32U5G9ZJJ6Q; UFBGA144_STM
Y801: 16MHz; Crystal_SMD_2016-4Pin_2.0x1.6mm
Y802: 32.768kHz; Crystal_SMD_2012-2Pin_2.0x1.2mm

Connections:
+1V8: R801.1, R802.1, R803.1, R804.1, R805.1, R806.1, R807.1, R808.1, R810.1, R812.1; also elsewhere on the board
+3V3: R809.1, R811.1; also elsewhere on the board
/ADF1_CCK0: U801.K6 (PE9); also elsewhere on the board
/ADF1_SDI0: U801.J7 (PE10); also elsewhere on the board
/ALS_INT: U801.J6 (PG1); also elsewhere on the board
/AVDDEN: U801.D3 (PE6); also elsewhere on the board
/AVDD_ADC: U801.M2 (PA3); also elsewhere on the board
/BTN: U801.M9 (PB15); also elsewhere on the board
/BT_DEV_WAKE: U801.E11 (PI2); also elsewhere on the board
/BT_EN: U801.F11 (PI0); also elsewhere on the board
/BT_HOST_WAKE: U801.E12 (PI3); also elsewhere on the board
/DISPLAY_RST: U801.A3 (PH3_BOOT0); also elsewhere on the board
/DSI.CKN: U801.F1 (DSI_CKN); also elsewhere on the board
/DSI.CKP: U801.F2 (DSI_CKP); also elsewhere on the board
/DSI.D0N: U801.E1 (DSI_D0N); also elsewhere on the board
/DSI.D0P: U801.E2 (DSI_D0P); also elsewhere on the board
/DSI_TE: U801.C5 (PB7); also elsewhere on the board
/ELVDD_ADC: U801.L3 (PA4); also elsewhere on the board
/ELVSS_ADC: U801.L1 (PC3); also elsewhere on the board
/FLASH_INT: U801.G9 (PC6); also elsewhere on the board
/FLASH_RST: U801.H12 (PH13); also elsewhere on the board
/FLASH_RSTO: U801.F9 (PC7); also elsewhere on the board
/GNSS_PPS: U801.A7 (PG12); also elsewhere on the board
/GNSS_RST: U801.B6 (PG15); also elsewhere on the board
/GNSS_WAKEUP: U801.A6 (PG14); also elsewhere on the board
/GPIO1: U801.G5 (PC2); also elsewhere on the board
/GPIO2: U801.G4 (PF2); also elsewhere on the board
/HR_INT: U801.L11 (PD10); also elsewhere on the board
/I2C1.SCL: R802.2, U801.A4 (PB6); also elsewhere on the board
/I2C1.SDA: R804.2, U801.A2 (PB9); also elsewhere on the board
/I2C2.SCL: R806.2, U801.M10 (PB13); also elsewhere on the board
/I2C2.SDA: R808.2, U801.L7 (PB11); also elsewhere on the board
/I2C3.SCL: R810.2, U801.K2 (PC0); also elsewhere on the board
/I2C3.SDA: R812.2, U801.K1 (PC1); also elsewhere on the board
/I2C4.SCL: R801.2, U801.K11 (PD12); also elsewhere on the board
/I2C4.SDA: R803.2, U801.K9 (PD13); also elsewhere on the board
/I2C5.SCL: R805.2, U801.E7 (PD1); also elsewhere on the board
/I2C5.SDA: R807.2, U801.D8 (PD0); also elsewhere on the board
/I2C6.SCL: R809.2, U801.F4 (PF1); also elsewhere on the board
/I2C6.SDA: R811.2, U801.E5 (PF0); also elsewhere on the board
/IMU_INT1: U801.C4 (PE5); also elsewhere on the board
/IMU_INT2: U801.E4 (PC13); also elsewhere on the board
/LRA_EN: U801.L12 (PD14); also elsewhere on the board
/MAG_INT: U801.H8 (PE8); also elsewhere on the board
/OSPI1.CLKN: U801.B5; also elsewhere on the board
/OSPI1.CLKP: U801.K8 (PB10); also elsewhere on the board
/OSPI1.CS: U801.M5 (PE11); also elsewhere on the board
/OSPI1.DQS: U801.H6 (PB2); also elsewhere on the board
/OSPI1.IO0: U801.J8 (PE12); also elsewhere on the board
/OSPI1.IO1: U801.L6 (PE13); also elsewhere on the board
/OSPI1.IO2: U801.K7 (PE14); also elsewhere on the board
/OSPI1.IO3: U801.M6 (PE15); also elsewhere on the board
/OSPI1.IO4: U801.K12 (PH9); also elsewhere on the board
/OSPI1.IO5: U801.J12 (PH10); also elsewhere on the board
/OSPI1.IO6: U801.J11 (PH11); also elsewhere on the board
/OSPI1.IO7: U801.H11 (PH12); also elsewhere on the board
/PWR_ENCHG: U801.M11 (PD8); also elsewhere on the board
/PWR_INT: U801.K10 (PD9); also elsewhere on the board
/SDMMC1.CK: U801.A11 (PC12); also elsewhere on the board
/SDMMC1.CKIN: U801.B4 (PB8); also elsewhere on the board
/SDMMC1.CMD: U801.B9 (PD2); also elsewhere on the board
/SDMMC1.D0: U801.D12 (PC8); also elsewhere on the board
/SDMMC1.D1: U801.F8 (PC9); also elsewhere on the board
/SDMMC1.D2: U801.B10 (PC10); also elsewhere on the board
/SDMMC1.D3: U801.C8 (PC11); also elsewhere on the board
/SDMMC2.CK: U801.D7 (PD6); also elsewhere on the board
/SDMMC2.CMD: U801.A9 (PD7); also elsewhere on the board
/SDMMC2.D0: U801.L10 (PB14); also elsewhere on the board
/SDMMC2.D1: U801.D11 (PA8); also elsewhere on the board
/SDMMC2.D2: U801.D6 (PB3); also elsewhere on the board
/SDMMC2.D3: U801.A5 (PB4); also elsewhere on the board
/SD_CD: U801.K5 (PG0); also elsewhere on the board
/SD_EN: U801.L5 (PE7); also elsewhere on the board
/SPI1.CS: U801.J5 (PB0); also elsewhere on the board
/SPI1.MISO: U801.M3 (PA6); also elsewhere on the board
/SPI1.MOSI: U801.L4 (PA7); also elsewhere on the board
/SPI1.SCK: U801.K4 (PA5); also elsewhere on the board
/STM32/GPIO3: TP804.1, U801.C6 (PG13)
/STM32/OSC32_IN: C803.2, U801.C1 (PC14-OSC32_IN), Y802.2
/STM32/OSC32_OUT: C804.2, U801.D2 (PC15-OSC32_OUT), Y802.1
/STM32/OSC_IN: C801.2, U801.H2 (PH0-OSC_IN), Y801.3
/STM32/OSC_OUT: C802.2, U801.J1 (PH1-OSC_OUT), Y801.1
/STM32/SWD.RST: TP803.1, U801.J2 (NRST)
/STM32/SWD.SWCLK: TP802.1, U801.B11 (PA14)
/STM32/SWD.SWDIO: TP801.1, U801.C10 (PA13)
/SWIRE_IN: U801.B3 (PE0); also elsewhere on the board
/SWIRE_OUT: U801.C3 (PE4); also elsewhere on the board
/TOUCH_INT: U801.L9 (PD11); also elsewhere on the board
/TOUCH_RST: U801.H9 (PD15); also elsewhere on the board
/TP_INT: U801.B1 (PE2); also elsewhere on the board
/TP_RST: U801.B2 (PE3); also elsewhere on the board
/UART4.RX: U801.K3 (PA1); also elsewhere on the board
/UART4.TX: U801.H4 (PA0); also elsewhere on the board
/USART1.RX: U801.A8 (PG10); also elsewhere on the board
/USART1.TX: U801.B7 (PG9); also elsewhere on the board
/USART2.CTS: U801.A10 (PD3); also elsewhere on the board
/USART2.RTS: U801.C7 (PD4); also elsewhere on the board
/USART2.RX: U801.C9 (PA15); also elsewhere on the board
/USART2.TX: U801.B8 (PD5); also elsewhere on the board
/USB.DN: U801.C12 (PA11); also elsewhere on the board
/USB.DP: U801.C11 (PA12); also elsewhere on the board
/VBUS_ADC: U801.M4 (PB1); also elsewhere on the board
/WL_BT_PWR_EN: U801.G12 (PH15); also elsewhere on the board
/WL_EN: U801.F12 (PI1); also elsewhere on the board
/WL_HOST_WAKE: U801.G11 (PH14); also elsewhere on the board
/WL_LPO_IN: U801.L2 (PA2); also elsewhere on the board
GND: C801.1, C802.1, C803.1, C804.1, Y801.2, Y801.4; also elsewhere on the board

Notes on the sheet:
CL = 8pF CS = 5pF ∴ CLx = 6pF
CL = 7pF CS = 4pF ∴ CLx = 6pF

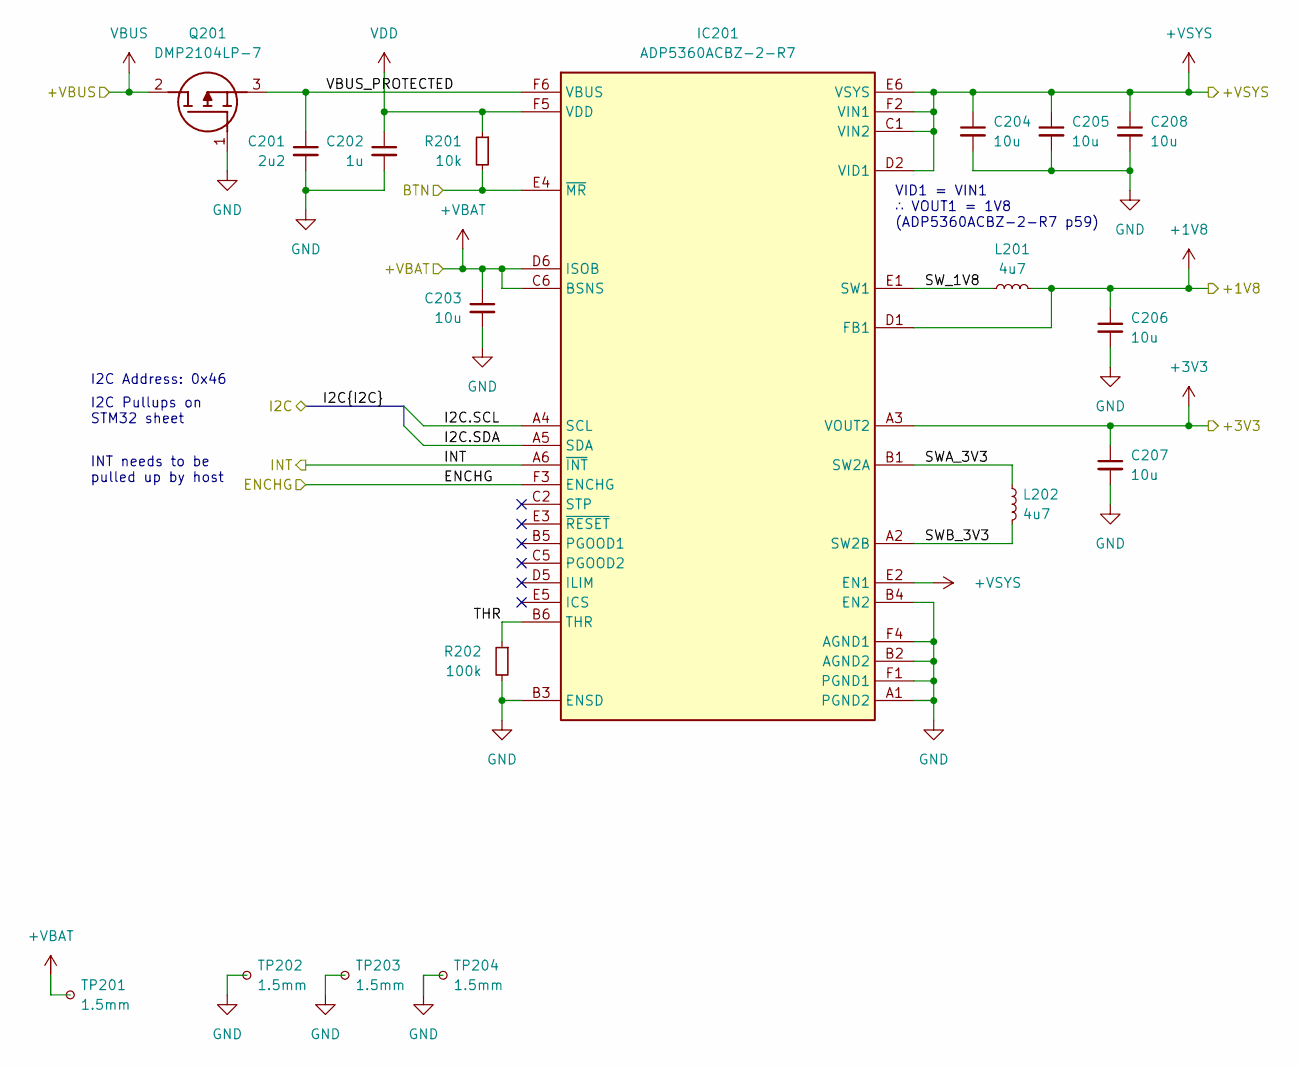
[picture p127: schematic power.kicad_sch, Watch Power]

Parts:
C201: 2u2; C_0402_1005Metric
C202: 1u; C_0402_1005Metric
C203, C204, C205, C206, C207, C208: 10u; C_0402_1005Metric
IC201: ADP5360ACBZ-2-R7; ADP5360ACBZ1R7; Mouser Part Number 584-ADP5360ACBZ-2-R7
L201, L202: 4u7; L_Murata_DFE201610P
Q201: DMP2104LP-7; DMP2104LP7; Mouser Part Number 621-DMP2104LP-7
R201: 10k; R_0402_1005Metric
R202: 100k; R_0402_1005Metric
TP201, TP202, TP203, TP204: 1.5mm; TestPoint_Pad_D1.5mm

Connections:
+1V8: C206.1, IC201.D1 (FB1), L201.2; also elsewhere on the board
+3V3: C207.1, IC201.A3 (VOUT2); also elsewhere on the board
+VBAT: C203.1, IC201.C6 (BSNS), IC201.D6 (ISOB), TP201.1; also elsewhere on the board
+VSYS: C204.1, C205.1, C208.1, IC201.C1 (VIN2), IC201.D2 (VID1), IC201.E2 (EN1), IC201.E6 (VSYS), IC201.F2 (VIN1); also elsewhere on the board
/BTN: IC201.E4 (~MR), R201.2; also elsewhere on the board
/I2C2.SCL: IC201.A4 (SCL); also elsewhere on the board
/I2C2.SDA: IC201.A5 (SDA); also elsewhere on the board
/PWR_ENCHG: IC201.F3 (ENCHG); also elsewhere on the board
/PWR_INT: IC201.A6 (~INT); also elsewhere on the board
/Power/SWA_3V3: IC201.B1 (SW2A), L202.1
/Power/SWB_3V3: IC201.A2 (SW2B), L202.2
/Power/SW_1V8: IC201.E1 (SW1), L201.1
/Power/THR: IC201.B6 (THR), R202.1
/Power/VBUS_PROTECTED: C201.1, IC201.F6 (VBUS), Q201.3 (S)
GND: C201.2, C202.2, C203.2, C204.2, C205.2, C206.2, C207.2, C208.2, IC201.A1 (PGND2), IC201.B2 (AGND2), IC201.B3 (ENSD), IC201.B4 (EN2), IC201.F1 (PGND1), IC201.F4 (AGND1), Q201.1 (G), R202.2, TP202.1, TP203.1, TP204.1; also elsewhere on the board
VBUS: Q201.2 (D); also elsewhere on the board
VDD: C202.1, IC201.F5 (VDD), R201.1

Notes on the sheet:
VID1 = VIN1 ∴ VOUT1 = 1V8 (ADP5360ACBZ-2-R7 p59)
INT needs to be pulled up by host
I2C Address: 0x46
I2C Pullups on STM32 sheet

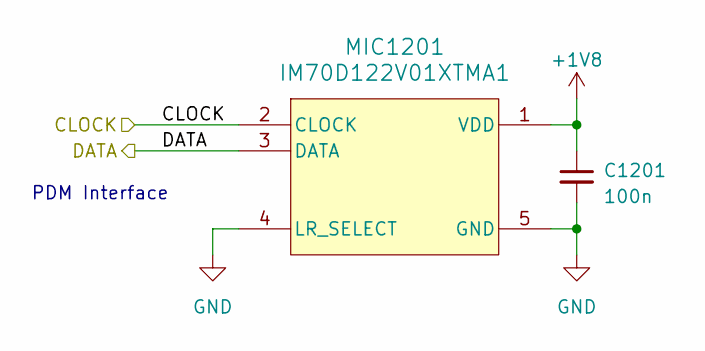
[picture p128: schematic microphone.kicad_sch, Watch Microphone]

Parts:
C1201: 100n; C_0402_1005Metric
MIC1201: IM70D122V01XTMA1; PG-TLGA-5-2_INF

Connections:
+1V8: C1201.1, MIC1201.1 (VDD); also elsewhere on the board
/ADF1_CCK0: MIC1201.2 (CLOCK); also elsewhere on the board
/ADF1_SDI0: MIC1201.3 (DATA); also elsewhere on the board
GND: C1201.2, MIC1201.4 (LR_SELECT), MIC1201.5 (GND); also elsewhere on the board

Notes on the sheet:
PDM Interface

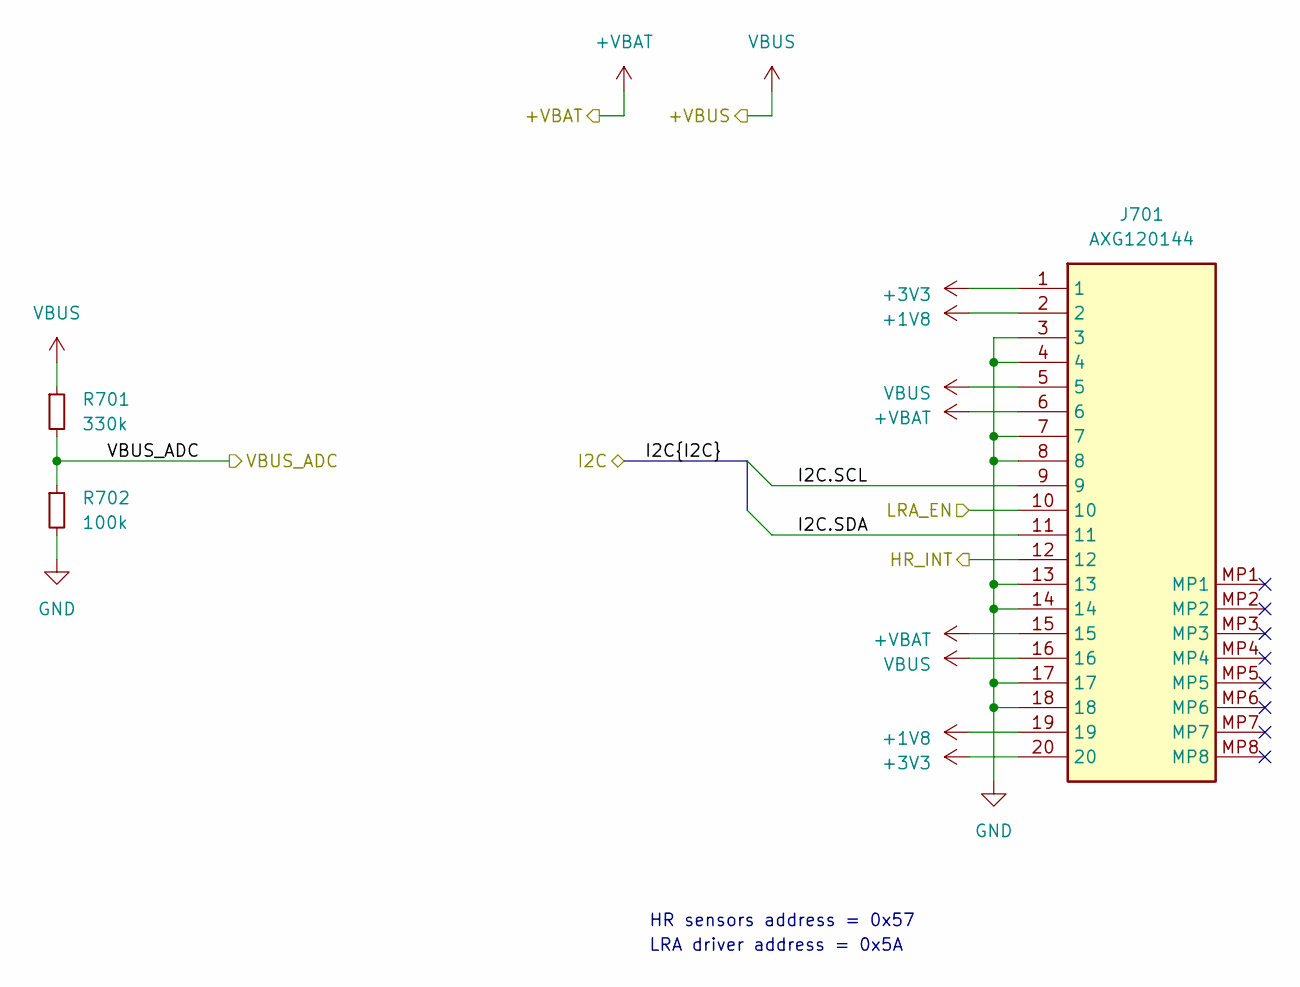
[picture p129: schematic daughterboard_connector.kicad_sch, Watch Daughterboard Connector]

Parts:
J701: AXG120144; Manufacturer_Part_Number AXG120144; Mouser Part Number 769-AXG120144
R701: 330k; R_0402_1005Metric
R702: 100k; R_0402_1005Metric

Connections:
+1V8: J701.2, J701.19; also elsewhere on the board
+3V3: J701.1, J701.20; also elsewhere on the board
+VBAT: J701.6, J701.15; also elsewhere on the board
/HR_INT: J701.12; also elsewhere on the board
/I2C4.SCL: J701.9; also elsewhere on the board
/I2C4.SDA: J701.11; also elsewhere on the board
/LRA_EN: J701.10; also elsewhere on the board
/VBUS_ADC: R701.2, R702.1; also elsewhere on the board
GND: J701.3, J701.4, J701.7, J701.8, J701.13, J701.14, J701.17, J701.18, R702.2; also elsewhere on the board
VBUS: J701.5, J701.16, R701.1; also elsewhere on the board

Notes on the sheet:
HR sensors address = 0x57
LRA driver address = 0x5A

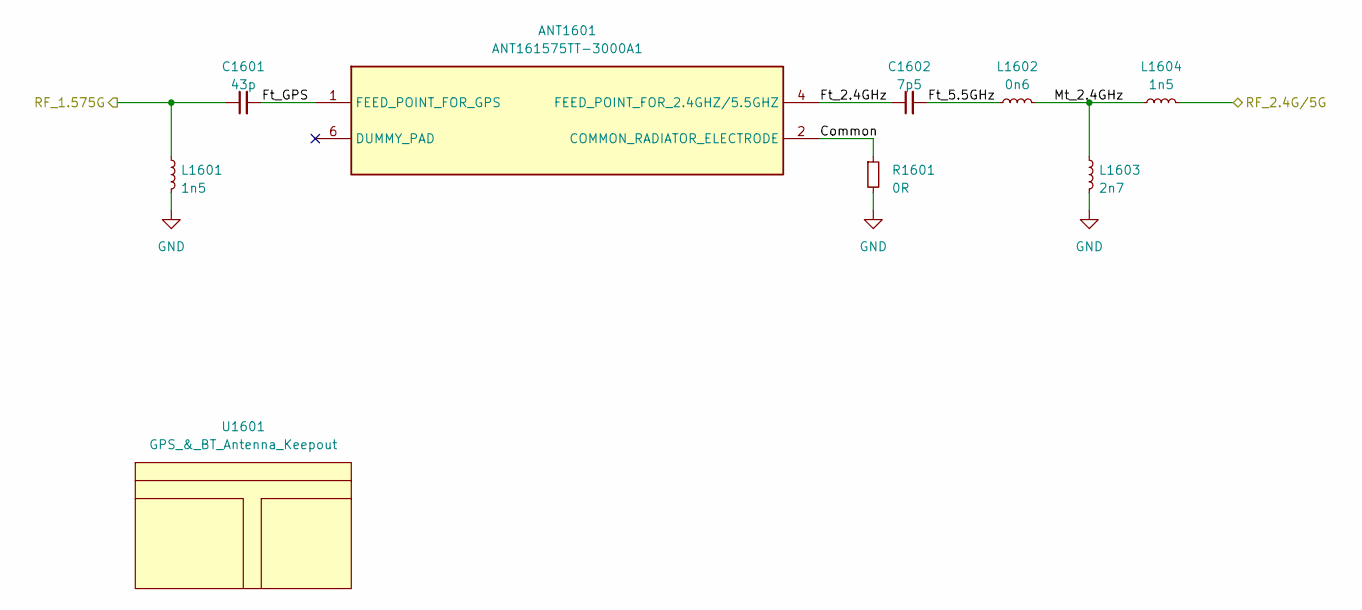
[picture p130: schematic antenna.kicad_sch, Watch Antenna]

Parts:
ANT1601: ANT161575TT-3000A1; ANT161575TT3000A1; Mouser Part Number 810-ANT161575TT-30A1
C1601: 43p; C_0402_1005Metric
C1602: 7p5; C_0402_1005Metric
L1601, L1604: 1n5; L_0402_1005Metric
L1602: 0n6; L_0402_1005Metric
L1603: 2n7; L_0402_1005Metric
R1601: 0R; R_0402_1005Metric
U1601: GPS_&_BT_Antenna_Keepout; GPS & BT Antenna

Connections:
/Antenna/Common: ANT1601.2 (COMMON_RADIATOR_ELECTRODE), R1601.1
/Antenna/Ft_2.4GHz: ANT1601.4 (FEED_POINT_FOR_2.4GHZ/5.5GHZ), C1602.1
/Antenna/Ft_5.5GHz: C1602.2, L1602.1
/Antenna/Ft_GPS: ANT1601.1 (FEED_POINT_FOR_GPS), C1601.2
/RF_1.575G: C1601.1, L1601.1; also elsewhere on the board
/RF_2.4G/5G: L1604.2; also elsewhere on the board
GND: L1601.2, L1603.2, R1601.2; also elsewhere on the board
unnamed: L1602.2, L1603.1, L1604.1
