ben5049/Smart-Watch/PCBs/watch_main_v3/watch_main.kicad_pcb

## KiCad design PCBs/watch_main_v3/watch_main.kicad_pcb (continued)

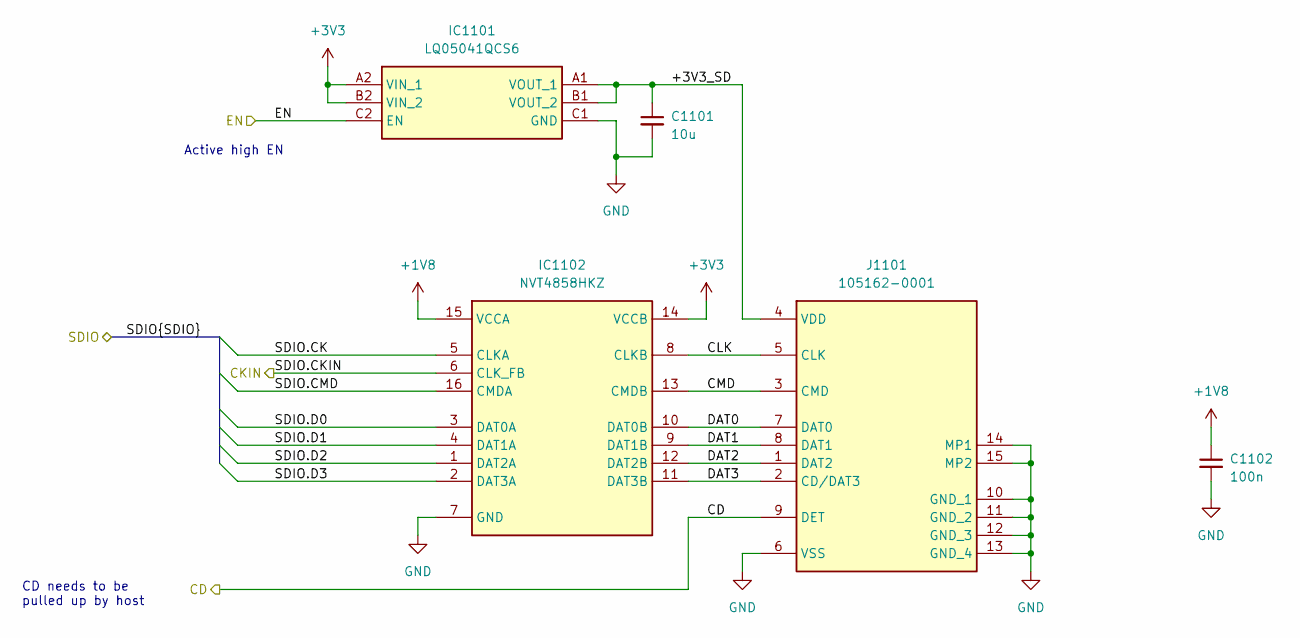
[picture p131: schematic micro_sd.kicad_sch, Watch Micro SD]

Parts:
C1101: 10u; C_0402_1005Metric
C1102: 100n; C_0402_1005Metric
IC1101: LQ05041QCS6; BGA6C50P2X3_97X147X60; Manufacturer_Part_Number LQ05041QCS6
IC1102: NVT4858HKZ; Mouser Part Number 771-NVT4858HKZ
J1101: 105162-0001; Mouser Part Number 538-105162-0001

Connections:
+1V8: C1102.1, IC1102.15 (VCCA); also elsewhere on the board
+3V3: IC1101.A2 (VIN_1), IC1101.B2 (VIN_2), IC1102.14 (VCCB); also elsewhere on the board
/Micro SD/+3V3_SD: C1101.1, IC1101.A1 (VOUT_1), IC1101.B1 (VOUT_2), J1101.4 (VDD)
/Micro SD/CLK: IC1102.8 (CLKB), J1101.5 (CLK)
/Micro SD/CMD: IC1102.13 (CMDB), J1101.3 (CMD)
/Micro SD/DAT0: IC1102.10 (DAT0B), J1101.7 (DAT0)
/Micro SD/DAT1: IC1102.9 (DAT1B), J1101.8 (DAT1)
/Micro SD/DAT2: IC1102.12 (DAT2B), J1101.1 (DAT2)
/Micro SD/DAT3: IC1102.11 (DAT3B), J1101.2 (CD/DAT3)
/SDMMC1.CK: IC1102.5 (CLKA); also elsewhere on the board
/SDMMC1.CKIN: IC1102.6 (CLK_FB); also elsewhere on the board
/SDMMC1.CMD: IC1102.16 (CMDA); also elsewhere on the board
/SDMMC1.D0: IC1102.3 (DAT0A); also elsewhere on the board
/SDMMC1.D1: IC1102.4 (DAT1A); also elsewhere on the board
/SDMMC1.D2: IC1102.1 (DAT2A); also elsewhere on the board
/SDMMC1.D3: IC1102.2 (DAT3A); also elsewhere on the board
/SD_CD: J1101.9 (DET); also elsewhere on the board
/SD_EN: IC1101.C2 (EN); also elsewhere on the board
GND: C1101.2, C1102.2, IC1101.C1 (GND), IC1102.7 (GND), J1101.6 (VSS), J1101.10 (GND_1), J1101.11 (GND_2), J1101.12 (GND_3), J1101.13 (GND_4), J1101.14 (MP1), J1101.15 (MP2); also elsewhere on the board

Notes on the sheet:
CD needs to be pulled up by host
Active high EN

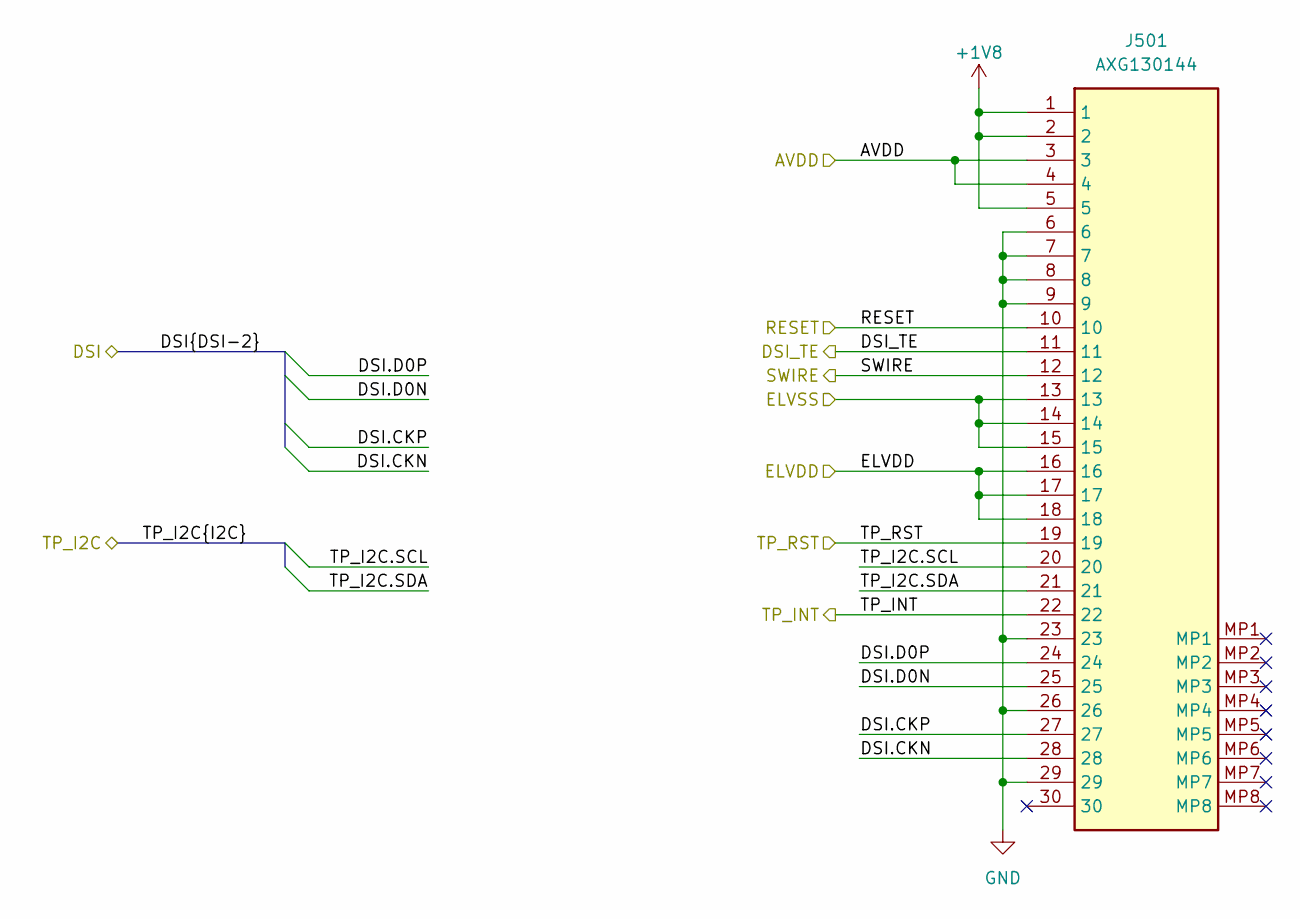
[picture p132: schematic display_connector.kicad_sch, Watch Display Connector]

Parts:
J501: AXG130144; Mouser Part Number 667-AXG130144

Connections:
+1V8: J501.1, J501.2, J501.5; also elsewhere on the board
/AVDD: J501.3, J501.4; also elsewhere on the board
/DISPLAY_RST: J501.10; also elsewhere on the board
/DSI.CKN: J501.28; also elsewhere on the board
/DSI.CKP: J501.27; also elsewhere on the board
/DSI.D0N: J501.25; also elsewhere on the board
/DSI.D0P: J501.24; also elsewhere on the board
/DSI_TE: J501.11; also elsewhere on the board
/ELVDD: J501.16, J501.17, J501.18; also elsewhere on the board
/ELVSS: J501.13, J501.14, J501.15; also elsewhere on the board
/I2C5.SCL: J501.20; also elsewhere on the board
/I2C5.SDA: J501.21; also elsewhere on the board
/SWIRE_IN: J501.12; also elsewhere on the board
/TP_INT: J501.22; also elsewhere on the board
/TP_RST: J501.19; also elsewhere on the board
GND: J501.6, J501.7, J501.8, J501.9, J501.23, J501.26, J501.29; also elsewhere on the board

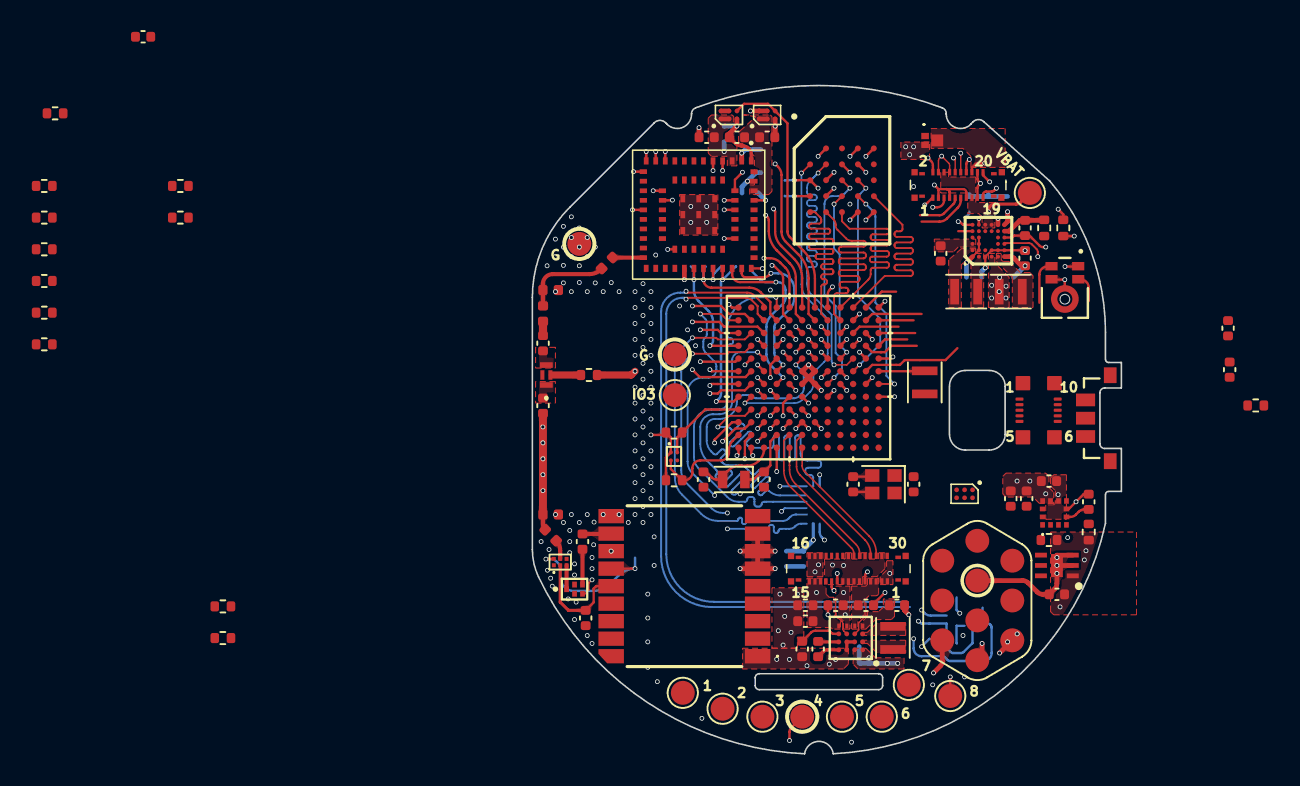
[picture p133: board PCBs/watch_main_v3/watch_main.kicad_pcb from above]

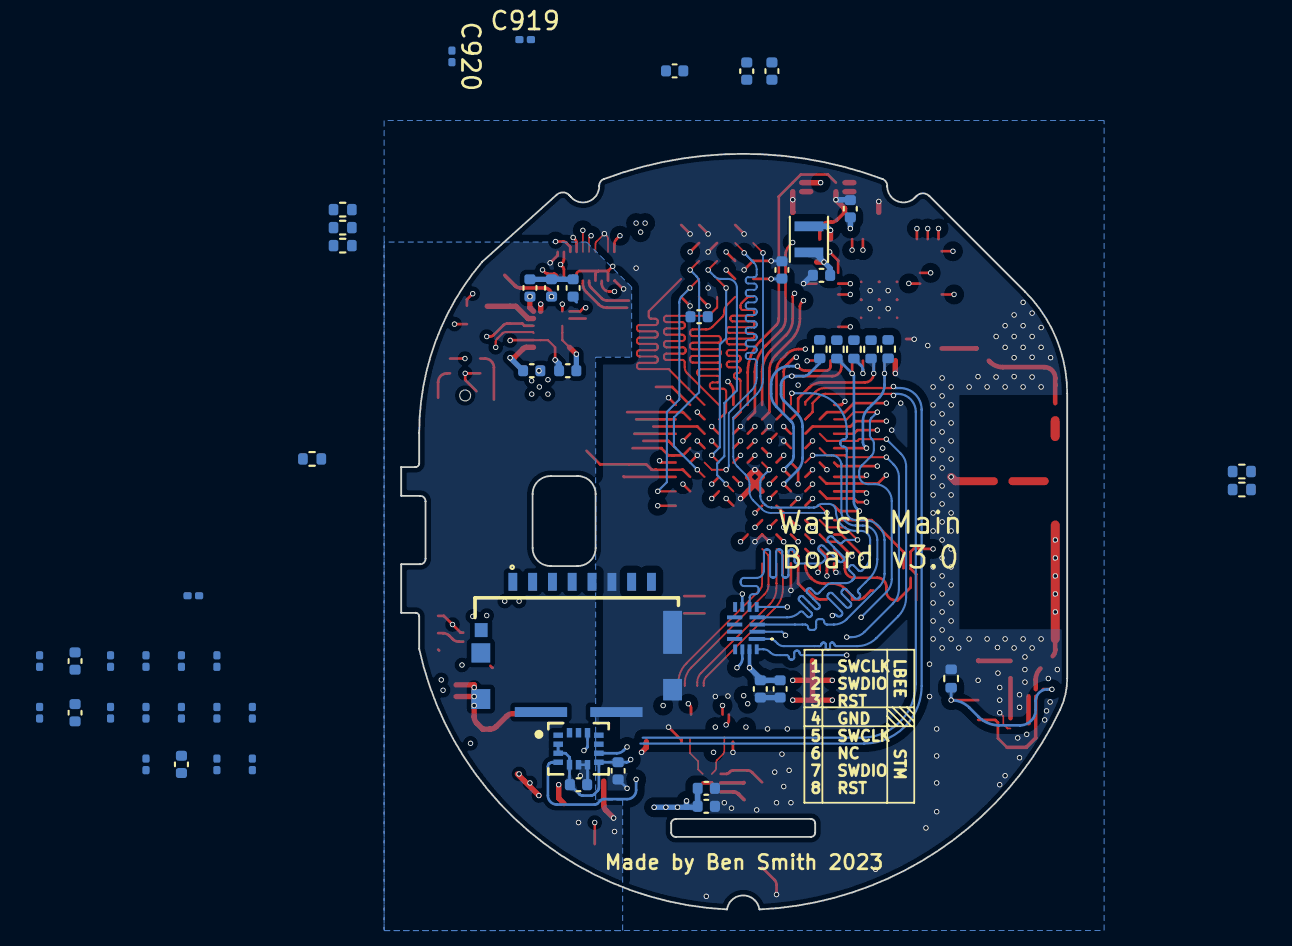
[picture p134: board PCBs/watch_main_v3/watch_main.kicad_pcb from below]

Board: 8 copper layers, 37.0 x 42.0 mm, 149 parts (54 on the bottom side), 156 nets.

Other parts of the board:
TP899: 1.5mm; TestPoint_Pad_D1.5mm
