ben5049/Smart-Watch/PCBs/watch_main_v2/watch_main.kicad_pcb

## KiCad design PCBs/watch_main_v2/watch_main.kicad_pcb (2024-03-26, an earlier design)

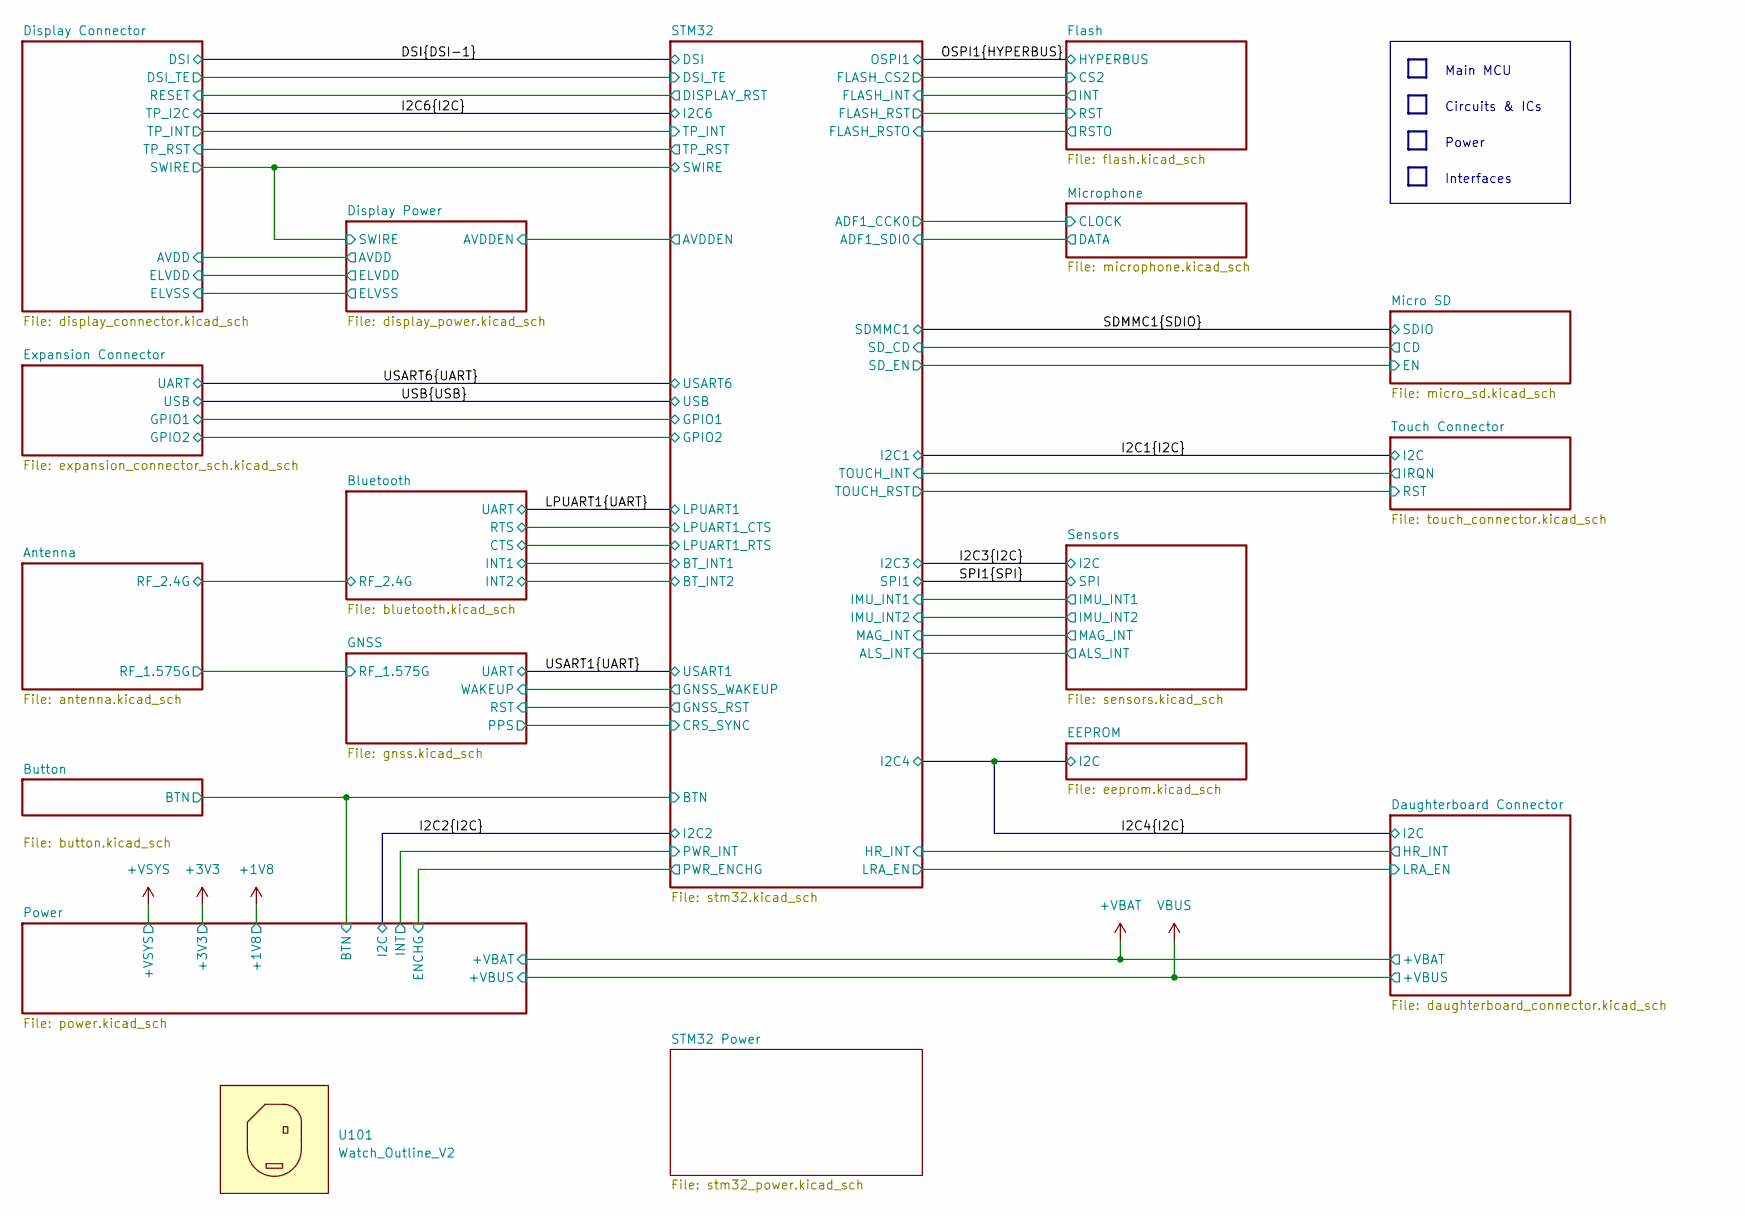
[picture p135: schematic watch_main.kicad_sch, Watch Main Board]

Parts:
U101: Watch_Outline_V2; Watch Outline V2

Notes on the sheet:
Interfaces
Circuits & ICs
Power
Main MCU


Parts:
C1501: 10n; C_0402_1005Metric
SW1501: EVP-AEJB2A; Panasonic-EVP-AEJB2A-MFG; voltage rating DC 15V; mouser part number 667-EVP-AEJB2A; digikey description SWITCH TACTILE SPST-NO 0.02A 15V

Connections:
/STM32/BTN: C1501.1, SW1501.2; also elsewhere on the board
GND: C1501.2, SW1501.1, SW1501.1'; also elsewhere on the board

Notes on the sheet:
Pullup resistor on power supply sheet

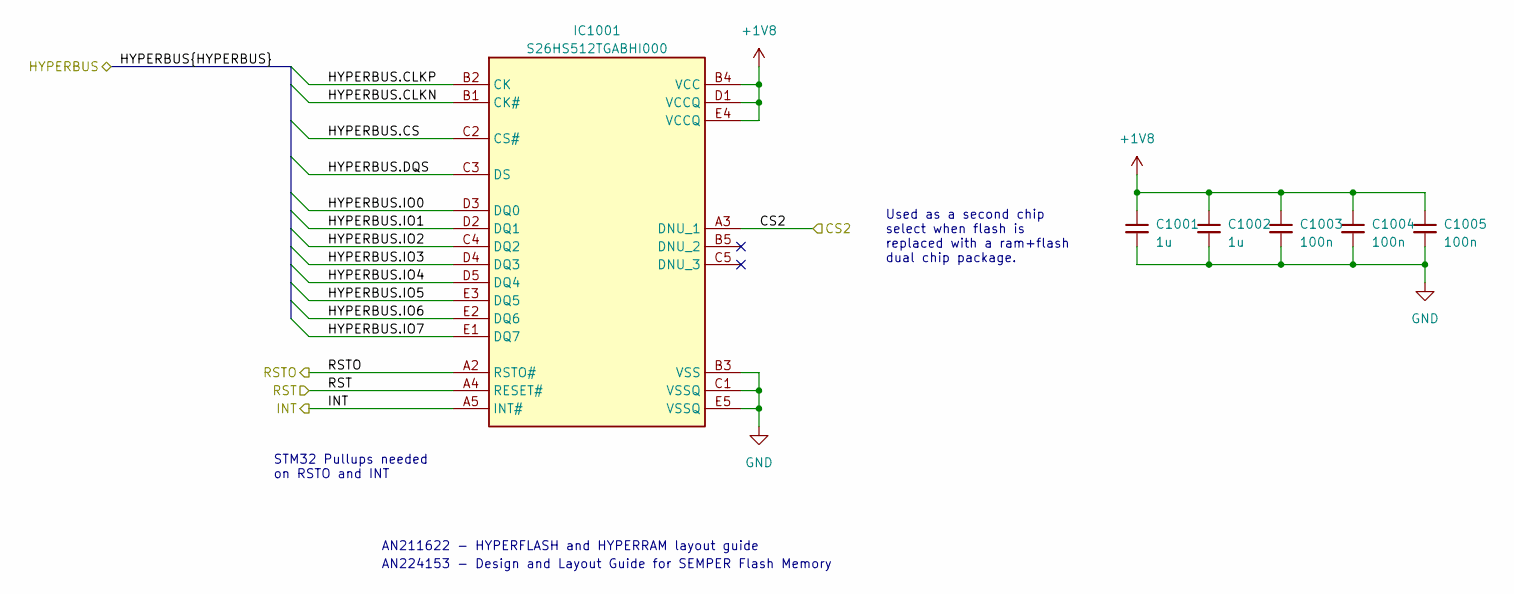
[picture p136: schematic flash.kicad_sch, Watch Flash]

Parts:
C1001, C1002: 1u; C_0402_1005Metric
C1003, C1004, C1005: 100n; C_0402_1005Metric
IC1001: S26HS512TGABHI000; BGA24C100P5X5_600X800X100; Mouser Part Number 727-S26HS512TGABHI00

Connections:
+1V8: C1001.1, C1002.1, C1003.1, C1004.1, C1005.1, IC1001.B4 (VCC), IC1001.D1 (VCCQ), IC1001.E4 (VCCQ); also elsewhere on the board
/Flash/CS2: IC1001.A3 (DNU_1); also elsewhere on the board
/Flash/INT: IC1001.A5 (INT#); also elsewhere on the board
/Flash/RST: IC1001.A4 (RESET#); also elsewhere on the board
/Flash/RSTO: IC1001.A2 (RSTO#); also elsewhere on the board
/OSPI1.CLKN: IC1001.B1 (CK#); also elsewhere on the board
/OSPI1.CLKP: IC1001.B2 (CK); also elsewhere on the board
/OSPI1.CS: IC1001.C2 (CS#); also elsewhere on the board
/OSPI1.DQS: IC1001.C3 (DS); also elsewhere on the board
/OSPI1.IO0: IC1001.D3 (DQ0); also elsewhere on the board
/OSPI1.IO1: IC1001.D2 (DQ1); also elsewhere on the board
/OSPI1.IO2: IC1001.C4 (DQ2); also elsewhere on the board
/OSPI1.IO3: IC1001.D4 (DQ3); also elsewhere on the board
/OSPI1.IO4: IC1001.D5 (DQ4); also elsewhere on the board
/OSPI1.IO5: IC1001.E3 (DQ5); also elsewhere on the board
/OSPI1.IO6: IC1001.E2 (DQ6); also elsewhere on the board
/OSPI1.IO7: IC1001.E1 (DQ7); also elsewhere on the board
GND: C1001.2, C1002.2, C1003.2, C1004.2, C1005.2, IC1001.B3 (VSS), IC1001.C1 (VSSQ), IC1001.E5 (VSSQ); also elsewhere on the board

Notes on the sheet:
STM32 Pullups needed on RSTO and INT
AN224153 - Design and Layout Guide for SEMPER Flash Memory
Used as a second chip select when flash is replaced with a ram+flash dual chip package.
AN211622 - HYPERFLASH and HYPERRAM layout guide


Parts:
J1701: 10-Pin Pogo Connector

Connections:
+1V8: J1701.B4; also elsewhere on the board
+3V3: J1701.A3; also elsewhere on the board
/Expansion Connector/GPIO1: J1701.C2; also elsewhere on the board
/Expansion Connector/GPIO2: J1701.B3; also elsewhere on the board
/USART6.RX: J1701.B1; also elsewhere on the board
/USART6.TX: J1701.C1; also elsewhere on the board
/USB.DN: J1701.A2; also elsewhere on the board
/USB.DP: J1701.A1; also elsewhere on the board
GND: J1701.B2; also elsewhere on the board
VBUS: J1701.C3; also elsewhere on the board

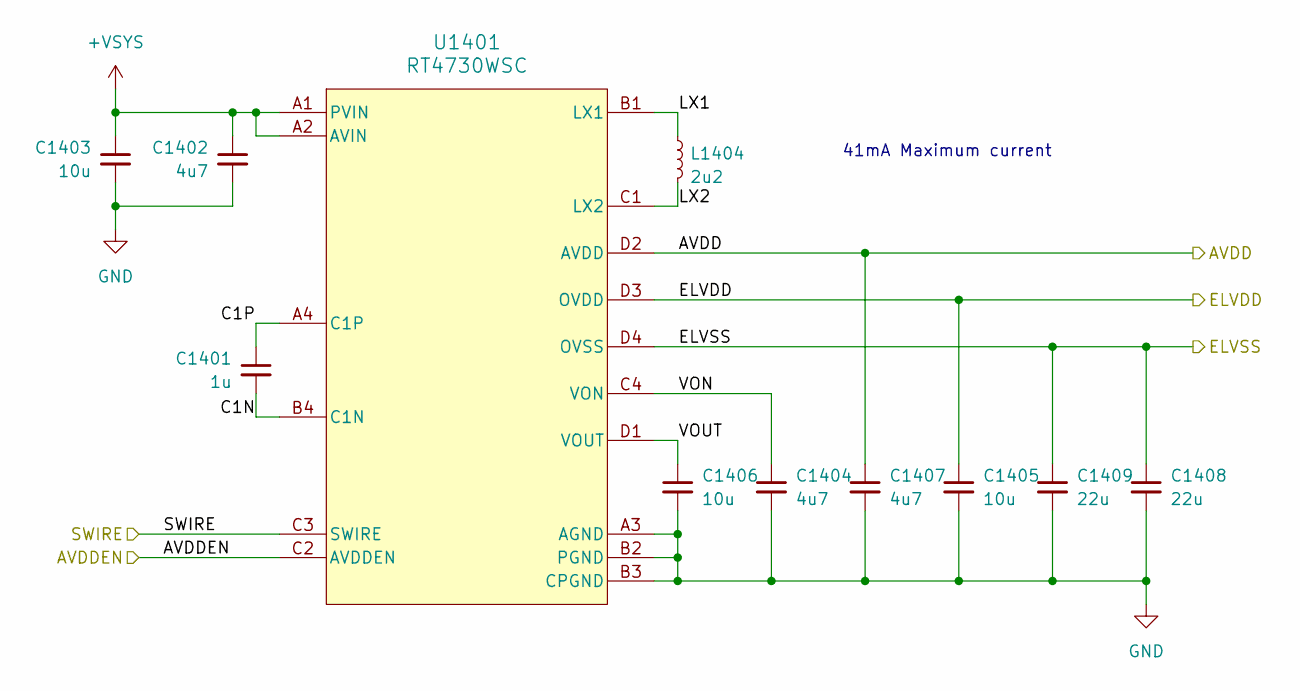
[picture p137: schematic display_power.kicad_sch, Watch Display Power]

Parts:
C1401: 1u; C_0402_1005Metric
C1402, C1404, C1407: 4u7; C_0402_1005Metric
C1403, C1405, C1406: 10u; C_0402_1005Metric
C1408, C1409: 22u; C_0402_1005Metric
L1404: 2u2; L_Murata_DFE201610P
U1401: RT4730WSC

Connections:
+VSYS: C1402.1, C1403.1, U1401.A1 (PVIN), U1401.A2 (AVIN); also elsewhere on the board
/Display Connector/AVDD: C1407.1, U1401.D2 (AVDD); also elsewhere on the board
/Display Connector/ELVDD: C1405.1, U1401.D3 (OVDD); also elsewhere on the board
/Display Connector/SWIRE: U1401.C3 (SWIRE); also elsewhere on the board
/Display Power/AVDDEN: U1401.C2 (AVDDEN); also elsewhere on the board
/Display Power/C1N: C1401.2, U1401.B4 (C1N)
/Display Power/C1P: C1401.1, U1401.A4 (C1P)
/Display Power/ELVSS: C1408.1, C1409.1, U1401.D4 (OVSS); also elsewhere on the board
/Display Power/LX1: L1404.1, U1401.B1 (LX1)
/Display Power/LX2: L1404.2, U1401.C1 (LX2)
/Display Power/VON: C1404.1, U1401.C4 (VON)
/Display Power/VOUT: C1406.1, U1401.D1 (VOUT)
GND: C1402.2, C1403.2, C1404.2, C1405.2, C1406.2, C1407.2, C1408.2, C1409.2, U1401.A3 (AGND), U1401.B2 (PGND), U1401.B3 (CPGND); also elsewhere on the board

Notes on the sheet:
41mA Maximum current

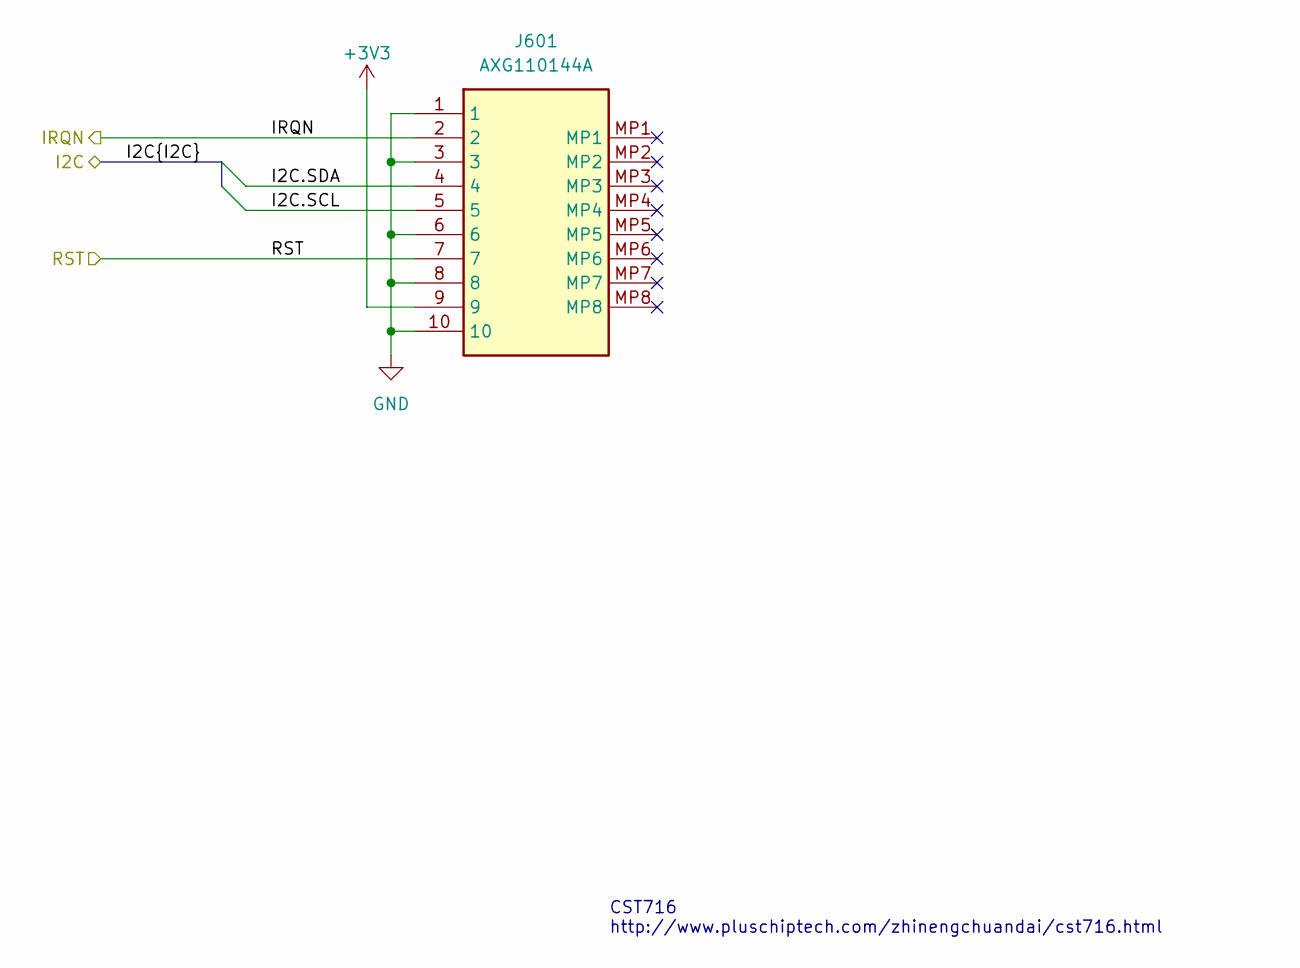
[picture p138: schematic touch_connector.kicad_sch]

Parts:
J601: AXG110144A; Mouser Part Number N/A

Connections:
+3V3: J601.9; also elsewhere on the board
/I2C1.SCL: J601.5; also elsewhere on the board
/I2C1.SDA: J601.4; also elsewhere on the board
/STM32/TOUCH_INT: J601.2; also elsewhere on the board
/STM32/TOUCH_RST: J601.7; also elsewhere on the board
GND: J601.1, J601.3, J601.6, J601.8, J601.10; also elsewhere on the board

Notes on the sheet:
CST716 http://www.pluschiptech.com/zhinengchuandai/cst716.html

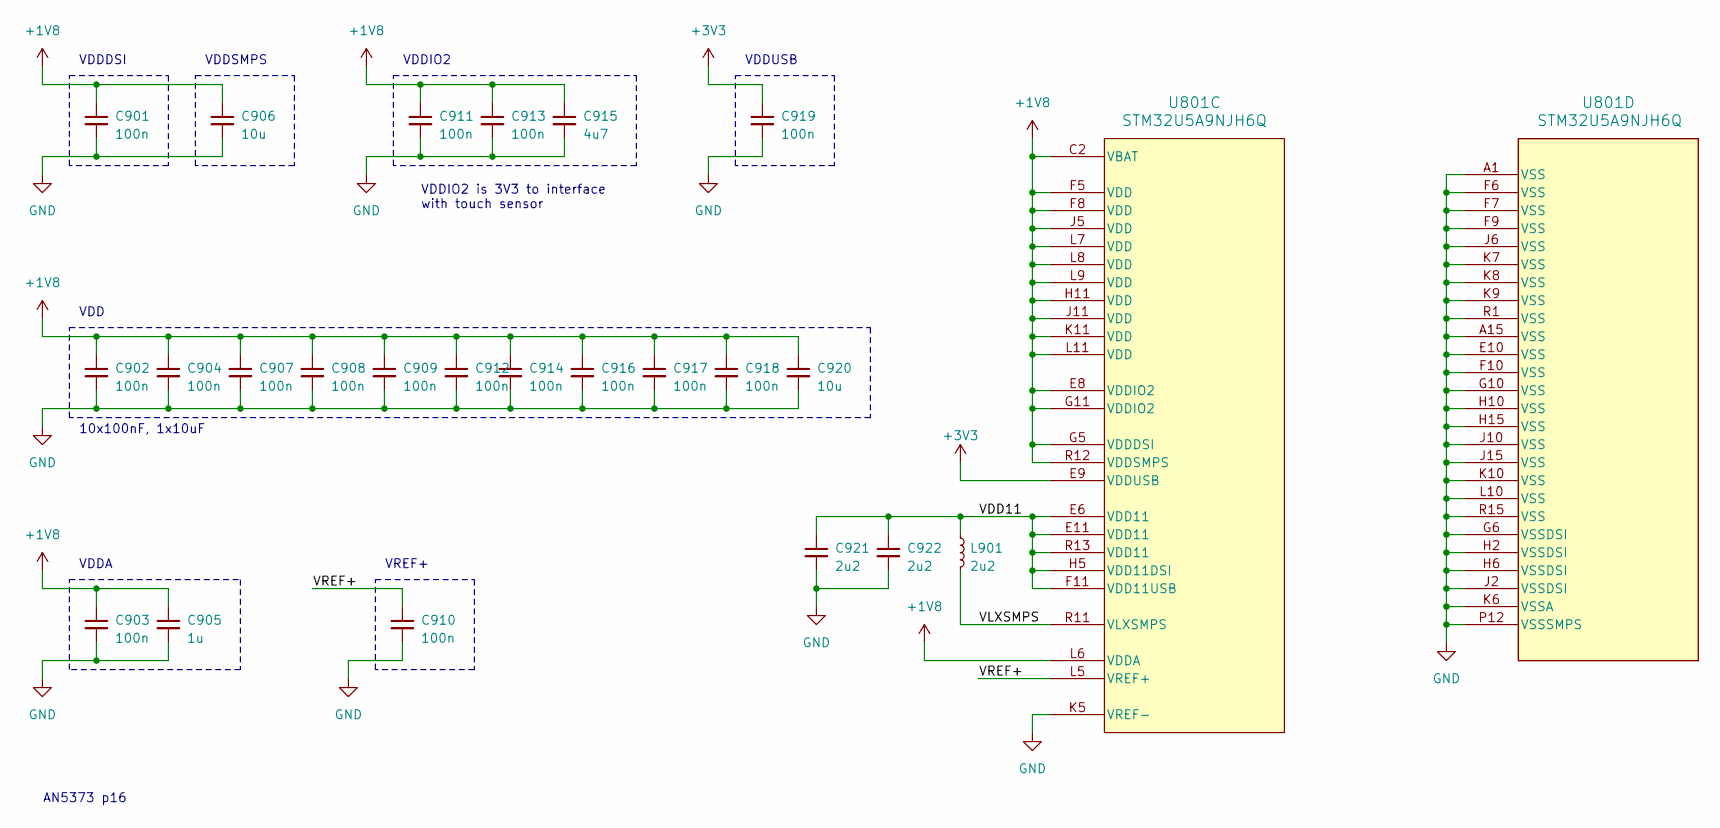
[picture p139: schematic stm32_power.kicad_sch, Watch Main MCU Power]

Parts:
C901, C902, C903, C904, C907, C908, C909, C910, C911, C912, C913, C914, C916, C917, C918, C919: 100n; C_0402_1005Metric
C905: 1u; C_0402_1005Metric
C906, C920: 10u; C_0402_1005Metric
C915: 4u7; C_0402_1005Metric
C921, C922: 2u2; C_0402_1005Metric
L901: 2u2; L_Murata_DFE201610P
U801: STM32U5A9NJH6Q; TFBGA216_13X13_STM

Connections:
+1V8: C901.1, C902.1, C903.1, C904.1, C905.1, C906.1, C907.1, C908.1, C909.1, C911.1, C912.1, C913.1, C914.1, C915.1, C916.1, C917.1, C918.1, C920.1, U801.C2 (VBAT), U801.E8 (VDDIO2), U801.F5 (VDD), U801.F8 (VDD), U801.G5 (VDDDSI), U801.G11 (VDDIO2), U801.H11 (VDD), U801.J5 (VDD), U801.J11 (VDD), U801.K11 (VDD), U801.L6 (VDDA), U801.L7 (VDD), U801.L8 (VDD), U801.L9 (VDD), U801.L11 (VDD), U801.R12 (VDDSMPS); also elsewhere on the board
+3V3: C919.1, U801.E9 (VDDUSB); also elsewhere on the board
/STM32 Power/VDD11: C921.1, C922.1, L901.1, U801.E6 (VDD11), U801.E11 (VDD11), U801.F11 (VDD11USB), U801.H5 (VDD11DSI), U801.R13 (VDD11)
/STM32 Power/VLXSMPS: L901.2, U801.R11 (VLXSMPS)
/STM32 Power/VREF+: C910.1, U801.L5 (VREF+)
GND: C901.2, C902.2, C903.2, C904.2, C905.2, C906.2, C907.2, C908.2, C909.2, C910.2, C911.2, C912.2, C913.2, C914.2, C915.2, C916.2, C917.2, C918.2, C919.2, C920.2, C921.2, C922.2, U801.A1 (VSS), U801.A15 (VSS), U801.E10 (VSS), U801.F6 (VSS), U801.F7 (VSS), U801.F9 (VSS), U801.F10 (VSS), U801.G6 (VSSDSI), U801.G10 (VSS), U801.H2 (VSSDSI), U801.H6 (VSSDSI), U801.H10 (VSS), U801.H15 (VSS), U801.J2 (VSSDSI), U801.J6 (VSS), U801.J10 (VSS), U801.J15 (VSS), U801.K5 (VREF-), U801.K6 (VSSA), U801.K7 (VSS), U801.K8 (VSS), U801.K9 (VSS), U801.K10 (VSS), U801.L10 (VSS), U801.P12 (VSSSMPS), U801.R1 (VSS), U801.R15 (VSS); also elsewhere on the board

Notes on the sheet:
VDDIO2 is 3V3 to interface with touch sensor
VDDUSB
VDDIO2
VREF+
VDD
VDDSMPS
VDDA
AN5373 p16
10x100nF, 1x10uF
VDDDSI

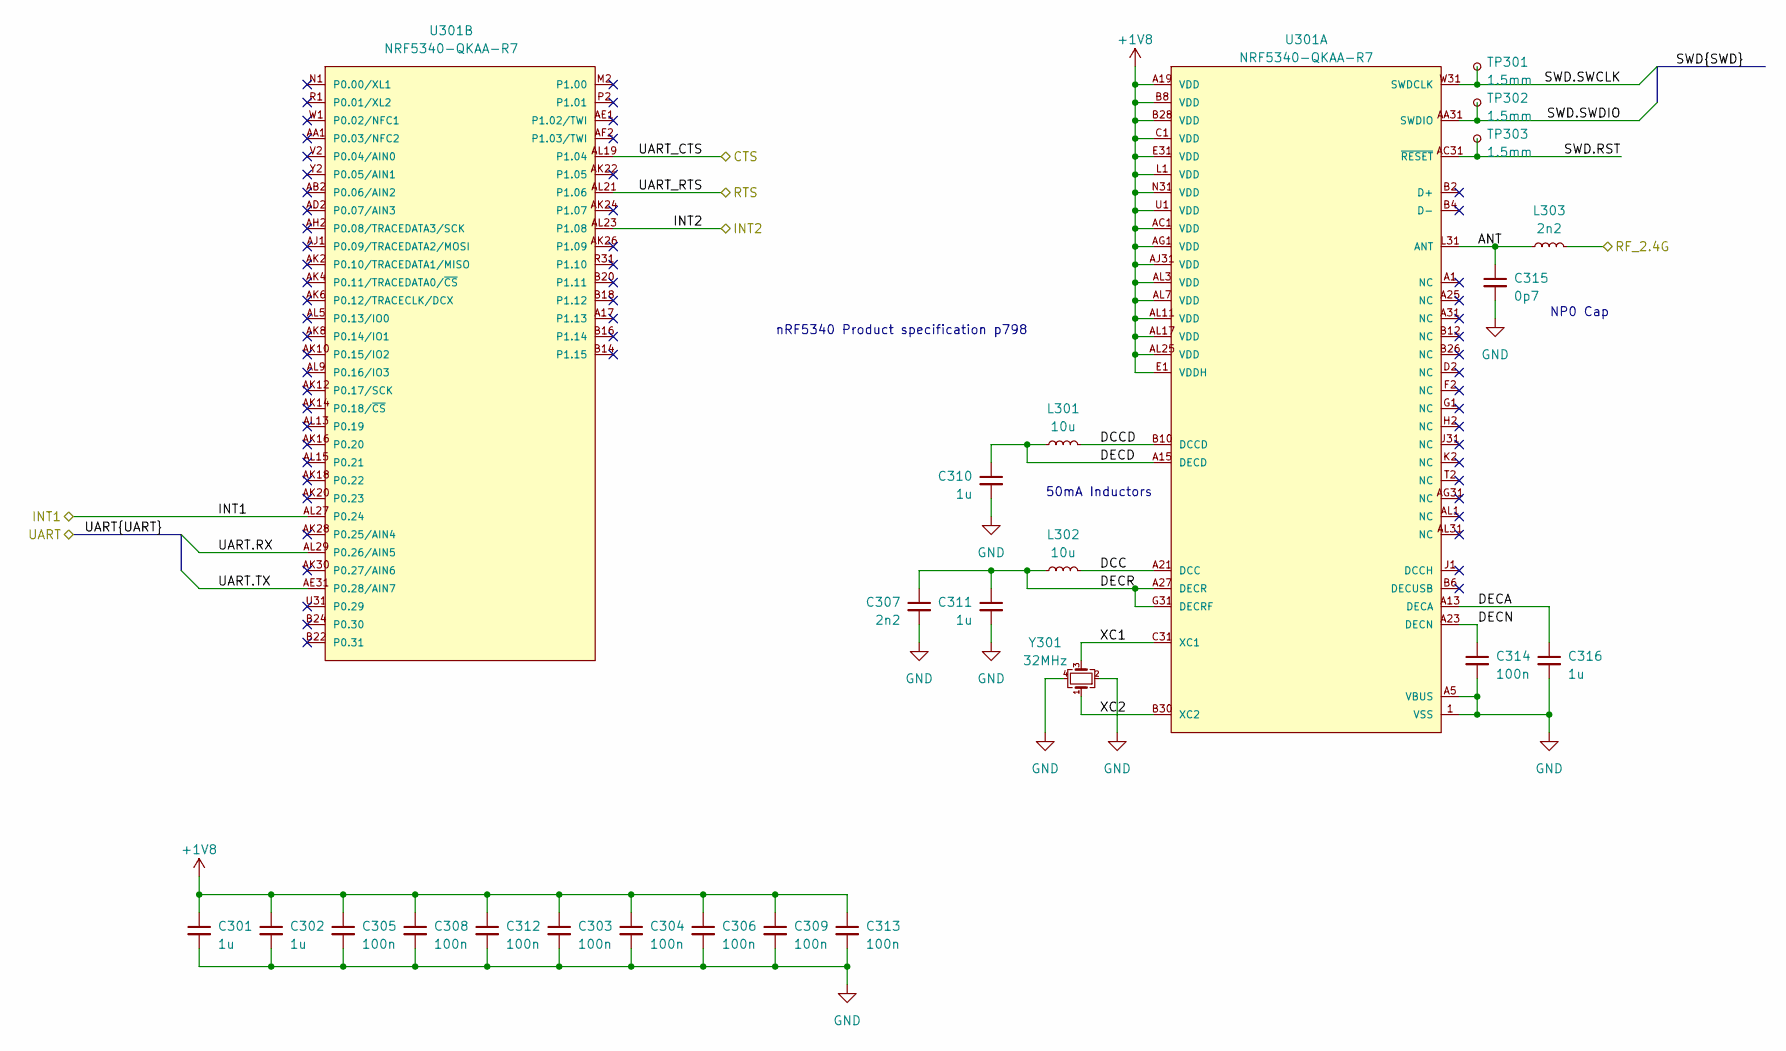
[picture p140: schematic bluetooth.kicad_sch, Watch Bluetooth]

Parts:
C301, C302, C310, C311, C316: 1u; C_0402_1005Metric
C303, C304, C305, C306, C308, C309, C312, C313, C314: 100n; C_0402_1005Metric
C307: 2n2; C_0402_1005Metric
C315: 0p7; C_0402_1005Metric
L301, L302: 10u; L_TDK_MLZ1608
L303: 2n2; L_0402_1005Metric
TP301, TP302, TP303: 1.5mm; TestPoint_Pad_D1.5mm
U301: NRF5340-QKAA-R7; NRF5340-QKAA-R7_modified; mouser part number 949-NRF5340-QKAA-R7; digikey description BLE 5.2 SOC
Y301: 32MHz; Crystal_SMD_2016-4Pin_2.0x1.6mm

Connections:
+1V8: C301.1, C302.1, C303.1, C304.1, C305.1, C306.1, C308.1, C309.1, C312.1, C313.1, U301.A19 (VDD), U301.AC1 (VDD), U301.AG1 (VDD), U301.AJ31 (VDD), U301.AL3 (VDD), U301.AL7 (VDD), U301.AL11 (VDD), U301.AL17 (VDD), U301.AL25 (VDD), U301.B8 (VDD), U301.B28 (VDD), U301.C1 (VDD), U301.E1 (VDDH), U301.E31 (VDD), U301.L1 (VDD), U301.N31 (VDD), U301.U1 (VDD); also elsewhere on the board
/Antenna/RF_2.4G: L303.2; also elsewhere on the board
/Bluetooth/ANT: C315.1, L303.1, U301.L31 (ANT)
/Bluetooth/DCC: L302.2, U301.A21 (DCC)
/Bluetooth/DCCD: L301.2, U301.B10 (DCCD)
/Bluetooth/DECA: C316.1, U301.A13 (DECA)
/Bluetooth/DECD: C310.1, L301.1, U301.A15 (DECD)
/Bluetooth/DECN: C314.1, U301.A23 (DECN)
/Bluetooth/DECR: C307.1, C311.1, L302.1, U301.A27 (DECR), U301.G31 (DECRF)
/Bluetooth/INT1: U301.AL27 (P0.24); also elsewhere on the board
/Bluetooth/INT2: U301.AL23 (P1.08); also elsewhere on the board
/Bluetooth/SWD.RST: TP303.1, U301.AC31 (~RESET)
/Bluetooth/SWD.SWCLK: TP301.1, U301.W31 (SWDCLK)
/Bluetooth/SWD.SWDIO: TP302.1, U301.AA31 (SWDIO)
/Bluetooth/UART_CTS: U301.AL19 (P1.04); also elsewhere on the board
/Bluetooth/UART_RTS: U301.AL21 (P1.06); also elsewhere on the board
/Bluetooth/XC1: U301.C31 (XC1), Y301.3
/Bluetooth/XC2: U301.B30 (XC2), Y301.1
/LPUART1.RX: U301.AL29 (P0.26/AIN5); also elsewhere on the board
/LPUART1.TX: U301.AE31 (P0.28/AIN7); also elsewhere on the board
GND: C301.2, C302.2, C303.2, C304.2, C305.2, C306.2, C307.2, C308.2, C309.2, C310.2, C311.2, C312.2, C313.2, C314.2, C315.2, C316.2, U301.1 (VSS), U301.A5 (VBUS), Y301.2, Y301.4; also elsewhere on the board

Notes on the sheet:
nRF5340 Product specification p798
NP0 Cap
50mA Inductors


Parts:
IC1801: M24256X-FCU6T_VF; BGA4C50P2X2_70X98X33; Mouser Part Number 511-M24256X-FCU6T/VF

Connections:
+1V8: IC1801.A1 (VCC); also elsewhere on the board
/I2C4.SCL: IC1801.A2 (SCL); also elsewhere on the board
/I2C4.SDA: IC1801.B1 (SDA); also elsewhere on the board
GND: IC1801.B2 (VSS); also elsewhere on the board
