ben5049/Smart-Watch/PCBs/watch_main_v2/watch_main.kicad_pcb

## KiCad design PCBs/watch_main_v2/watch_main.kicad_pcb (continued)


Parts:
C1301: 220n; C_0402_1005Metric
C1302, C1304, C1305, C1306, C1307: 100n; C_0402_1005Metric
C1303: 10u; C_0402_1005Metric
IC1301: IIS2MDCTR; Mouser Part Number 511-IIS2MDCTR
IC1302: OPT3004DNPR; SON65P200X200X65-7N-D; Mouser Part Number 595-OPT3004DNPR
U1301: LSM6DSO16IS; LGA14_LSM6_STM

Connections:
+1V8: C1302.1, C1303.1, C1304.1, C1305.1, C1306.1, C1307.1, IC1301.9 (VDD), IC1301.10 (VDD_IO), IC1302.1 (VDD), U1301.2 (MSDA), U1301.3 (MSCL), U1301.5 (VDD_IO), U1301.8 (VDD); also elsewhere on the board
/I2C3.SCL: IC1301.1 (SCL/SPC), IC1302.4 (SCL); also elsewhere on the board
/I2C3.SDA: IC1301.4 (SDA/SDI/SDO), IC1302.6 (SDA); also elsewhere on the board
/SPI1.CS: U1301.12 (CS); also elsewhere on the board
/SPI1.MISO: U1301.1 (SDO/SA0); also elsewhere on the board
/SPI1.MOSI: U1301.14 (SDA); also elsewhere on the board
/SPI1.SCK: U1301.13 (SCL); also elsewhere on the board
/STM32/ALS_INT: IC1302.5 (INT); also elsewhere on the board
/STM32/IMU_INT1: U1301.4 (INT1); also elsewhere on the board
/STM32/IMU_INT2: U1301.9 (INT2); also elsewhere on the board
/STM32/MAG_INT: IC1301.7 (INT/DRDY); also elsewhere on the board
/Sensors/C1: C1301.1, IC1301.5 (C1)
GND: C1301.2, C1302.2, C1303.2, C1304.2, C1305.2, C1306.2, C1307.2, IC1301.6 (GND_1), IC1301.8 (GND_2), IC1302.2 (ADDR), IC1302.3 (GND), IC1302.7 (EP), U1301.6 (GND), U1301.7 (GND); also elsewhere on the board

Notes on the sheet:
Address = 0x1E
Address = 0x6A (SA0=0)
Address = 0x44 (ADDR=0)
Typical application: LSM6DSO16IS datasheet p25
Typical application: IIS2MDCTR datasheet p19
Typical application: OPT3004 datasheet p19

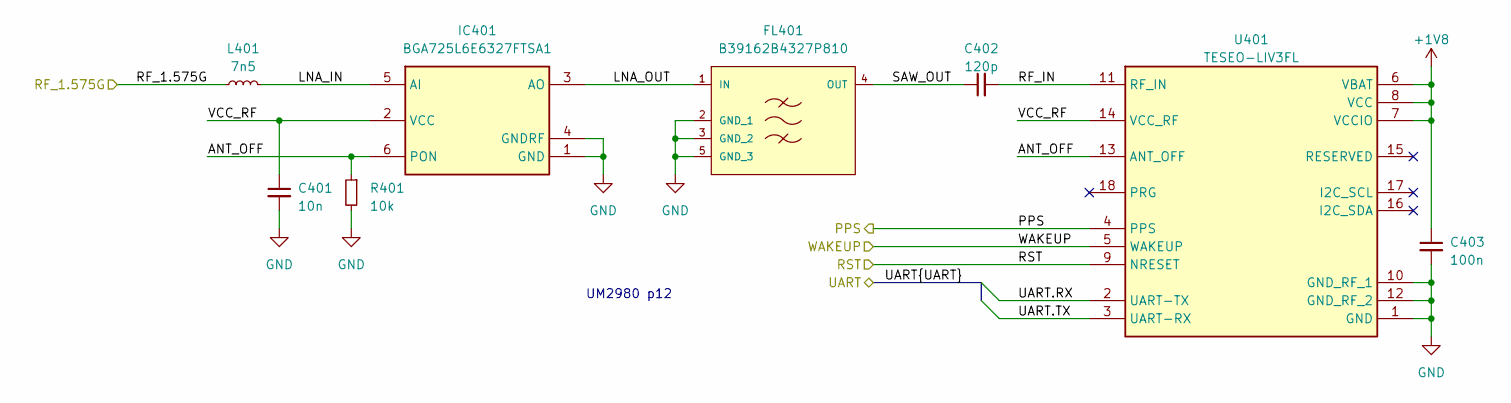
[picture p141: schematic gnss.kicad_sch, Watch GNSS]

Parts:
C401: 10n; C_0402_1005Metric
C402: 120p; C_0402_1005Metric
C403: 100n; C_0402_1005Metric
FL401: B39162B4327P810; mouser part number 871-B39162B4327P810; digikey description FILTER SAW 5SMD
IC401: BGA725L6E6327FTSA1; BGS12SN6E6327XTSA1; Mouser Part Number 726-BGA725L6E6327FTS
L401: 7n5; L_0402_1005Metric
R401: 10k; R_0402_1005Metric
U401: TESEO-LIV3FL; TESEOLIV3FL; Mouser Part Number 511-TESEO-LIV4FTR

Connections:
+1V8: C403.1, U401.6 (VBAT), U401.7 (VCCIO), U401.8 (VCC); also elsewhere on the board
/GNSS/ANT_OFF: IC401.6 (PON), R401.1, U401.13 (ANT_OFF)
/GNSS/LNA_IN: IC401.5 (AI), L401.2
/GNSS/LNA_OUT: FL401.1 (IN), IC401.3 (AO)
/GNSS/PPS: U401.4 (PPS); also elsewhere on the board
/GNSS/RF_1.575G: L401.1; also elsewhere on the board
/GNSS/RF_IN: C402.2, U401.11 (RF_IN)
/GNSS/RST: U401.9 (NRESET); also elsewhere on the board
/GNSS/SAW_OUT: C402.1, FL401.4 (OUT)
/GNSS/VCC_RF: C401.1, IC401.2 (VCC), U401.14 (VCC_RF)
/GNSS/WAKEUP: U401.5 (WAKEUP); also elsewhere on the board
/USART1.RX: U401.2 (UART-TX); also elsewhere on the board
/USART1.TX: U401.3 (UART-RX); also elsewhere on the board
GND: C401.2, C403.2, FL401.2 (GND_1), FL401.3 (GND_2), FL401.5 (GND_3), IC401.1 (GND), IC401.4 (GNDRF), R401.2, U401.1 (GND), U401.10 (GND_RF_1), U401.12 (GND_RF_2); also elsewhere on the board

Notes on the sheet:
UM2980 p12

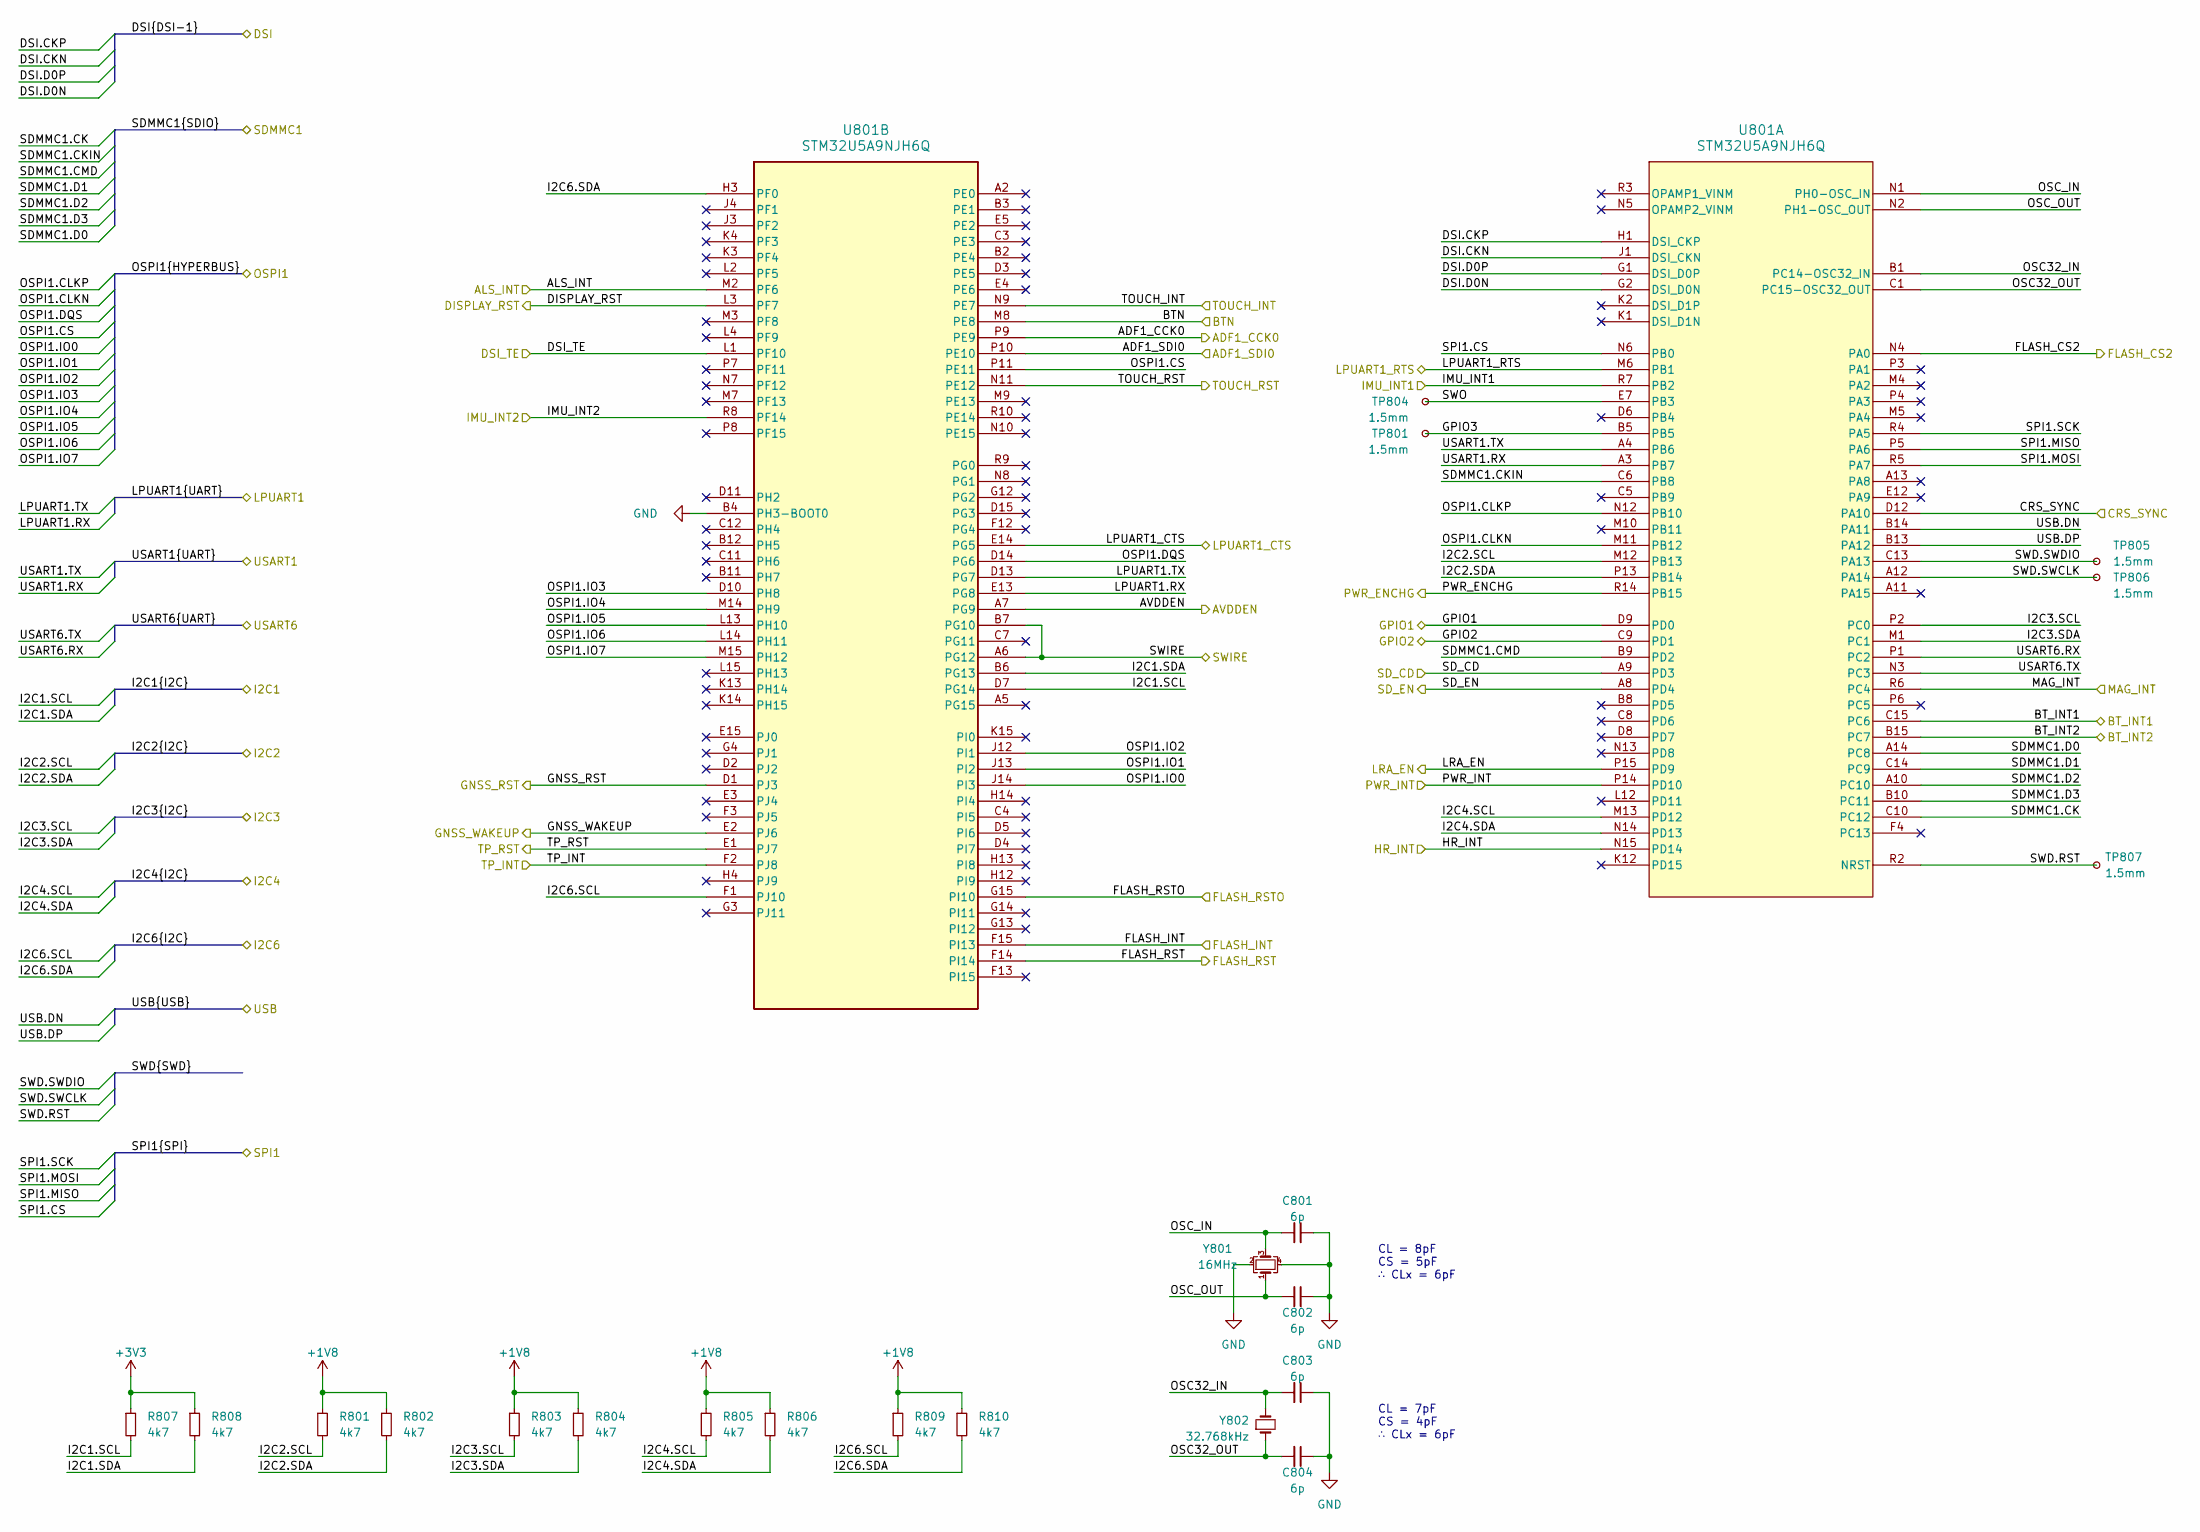
[picture p142: schematic stm32.kicad_sch, Watch Main MCU]

Parts:
C801, C802, C803, C804: 6p; C_0402_1005Metric
R801, R802, R803, R804, R805, R806, R807, R808, R809, R810: 4k7; R_0402_1005Metric
TP801, TP804, TP805, TP806, TP807: 1.5mm; TestPoint_Pad_D1.5mm
U801: STM32U5A9NJH6Q; TFBGA216_13X13_STM
Y801: 16MHz; Crystal_SMD_2016-4Pin_2.0x1.6mm
Y802: 32.768kHz; Crystal_SMD_2012-2Pin_2.0x1.2mm

Connections:
+1V8: R801.1, R802.1, R803.1, R804.1, R805.1, R806.1, R809.1, R810.1; also elsewhere on the board
+3V3: R807.1, R808.1; also elsewhere on the board
/Bluetooth/INT1: U801.C15 (PC6); also elsewhere on the board
/Bluetooth/INT2: U801.B15 (PC7); also elsewhere on the board
/Bluetooth/UART_CTS: U801.M6 (PB1); also elsewhere on the board
/Bluetooth/UART_RTS: U801.E14 (PG5); also elsewhere on the board
/DSI.CKN: U801.J1 (DSI_CKN); also elsewhere on the board
/DSI.CKP: U801.H1 (DSI_CKP); also elsewhere on the board
/DSI.D0N: U801.G2 (DSI_D0N); also elsewhere on the board
/DSI.D0P: U801.G1 (DSI_D0P); also elsewhere on the board
/Display Connector/DSI_TE: U801.L1 (PF10); also elsewhere on the board
/Display Connector/RESET: U801.L3 (PF7); also elsewhere on the board
/Display Connector/SWIRE: U801.A6 (PG12), U801.B7 (PG10); also elsewhere on the board
/Display Connector/TP_INT: U801.F2 (PJ8); also elsewhere on the board
/Display Connector/TP_RST: U801.E1 (PJ7); also elsewhere on the board
/Display Power/AVDDEN: U801.A7 (PG9); also elsewhere on the board
/Expansion Connector/GPIO1: U801.D9 (PD0); also elsewhere on the board
/Expansion Connector/GPIO2: U801.C9 (PD1); also elsewhere on the board
/Flash/CS2: U801.N4 (PA0); also elsewhere on the board
/Flash/INT: U801.F15 (PI13); also elsewhere on the board
/Flash/RST: U801.F14 (PI14); also elsewhere on the board
/Flash/RSTO: U801.G15 (PI10); also elsewhere on the board
/GNSS/PPS: U801.D12 (PA10); also elsewhere on the board
/GNSS/RST: U801.D1 (PJ3); also elsewhere on the board
/GNSS/WAKEUP: U801.E2 (PJ6); also elsewhere on the board
/I2C1.SCL: R807.2, U801.D7 (PG14); also elsewhere on the board
/I2C1.SDA: R808.2, U801.B6 (PG13); also elsewhere on the board
/I2C2.SCL: R801.2, U801.M12 (PB13); also elsewhere on the board
/I2C2.SDA: R802.2, U801.P13 (PB14); also elsewhere on the board
/I2C3.SCL: R803.2, U801.P2 (PC0); also elsewhere on the board
/I2C3.SDA: R804.2, U801.M1 (PC1); also elsewhere on the board
/I2C4.SCL: R805.2, U801.M13 (PD12); also elsewhere on the board
/I2C4.SDA: R806.2, U801.N14 (PD13); also elsewhere on the board
/I2C6.SCL: R809.2, U801.F1 (PJ10); also elsewhere on the board
/I2C6.SDA: R810.2, U801.H3 (PF0); also elsewhere on the board
/LPUART1.RX: U801.E13 (PG8); also elsewhere on the board
/LPUART1.TX: U801.D13 (PG7); also elsewhere on the board
/Micro SD/CD: U801.A9 (PD3); also elsewhere on the board
/Micro SD/EN: U801.A8 (PD4); also elsewhere on the board
/Microphone/CLOCK: U801.P9 (PE9); also elsewhere on the board
/Microphone/DATA: U801.P10 (PE10); also elsewhere on the board
/OSPI1.CLKN: U801.M11 (PB12); also elsewhere on the board
/OSPI1.CLKP: U801.N12 (PB10); also elsewhere on the board
/OSPI1.CS: U801.P11 (PE11); also elsewhere on the board
/OSPI1.DQS: U801.D14 (PG6); also elsewhere on the board
/OSPI1.IO0: U801.J14 (PI3); also elsewhere on the board
/OSPI1.IO1: U801.J13 (PI2); also elsewhere on the board
/OSPI1.IO2: U801.J12 (PI1); also elsewhere on the board
/OSPI1.IO3: U801.D10 (PH8); also elsewhere on the board
/OSPI1.IO4: U801.M14 (PH9); also elsewhere on the board
/OSPI1.IO5: U801.L13 (PH10); also elsewhere on the board
/OSPI1.IO6: U801.L14 (PH11); also elsewhere on the board
/OSPI1.IO7: U801.M15 (PH12); also elsewhere on the board
/Power/ENCHG: U801.R14 (PB15); also elsewhere on the board
/Power/INT: U801.P14 (PD10); also elsewhere on the board
/SDMMC1.CK: U801.C10 (PC12); also elsewhere on the board
/SDMMC1.CKIN: U801.C6 (PB8); also elsewhere on the board
/SDMMC1.CMD: U801.B9 (PD2); also elsewhere on the board
/SDMMC1.D0: U801.A14 (PC8); also elsewhere on the board
/SDMMC1.D1: U801.C14 (PC9); also elsewhere on the board
/SDMMC1.D2: U801.A10 (PC10); also elsewhere on the board
/SDMMC1.D3: U801.B10 (PC11); also elsewhere on the board
/SPI1.CS: U801.N6 (PB0); also elsewhere on the board
/SPI1.MISO: U801.P5 (PA6); also elsewhere on the board
/SPI1.MOSI: U801.R5 (PA7); also elsewhere on the board
/SPI1.SCK: U801.R4 (PA5); also elsewhere on the board
/STM32/ALS_INT: U801.M2 (PF6); also elsewhere on the board
/STM32/BTN: U801.M8 (PE8); also elsewhere on the board
/STM32/GPIO3: TP801.1, U801.B5
/STM32/HR_INT: U801.N15 (PD14); also elsewhere on the board
/STM32/IMU_INT1: U801.R7 (PB2); also elsewhere on the board
/STM32/IMU_INT2: U801.R8 (PF14); also elsewhere on the board
/STM32/LRA_EN: U801.P15 (PD9); also elsewhere on the board
/STM32/MAG_INT: U801.R6 (PC4); also elsewhere on the board
/STM32/OSC32_IN: C803.2, U801.B1 (PC14-OSC32_IN), Y802.2
/STM32/OSC32_OUT: C804.2, U801.C1 (PC15-OSC32_OUT), Y802.1
/STM32/OSC_IN: C801.2, U801.N1 (PH0-OSC_IN), Y801.3
/STM32/OSC_OUT: C802.2, U801.N2 (PH1-OSC_OUT), Y801.1
/STM32/SWD.RST: TP807.1, U801.R2 (NRST)
/STM32/SWD.SWCLK: TP806.1, U801.A12 (PA14)
/STM32/SWD.SWDIO: TP805.1, U801.C13 (PA13)
/STM32/SWO: TP804.1, U801.E7 (PB3)
/STM32/TOUCH_INT: U801.N9 (PE7); also elsewhere on the board
/STM32/TOUCH_RST: U801.N11 (PE12); also elsewhere on the board
/USART1.RX: U801.A3 (PB7); also elsewhere on the board
/USART1.TX: U801.A4 (PB6); also elsewhere on the board
/USART6.RX: U801.P1 (PC2); also elsewhere on the board
/USART6.TX: U801.N3 (PC3); also elsewhere on the board
/USB.DN: U801.B14 (PA11); also elsewhere on the board
/USB.DP: U801.B13 (PA12); also elsewhere on the board
GND: C801.1, C802.1, C803.1, C804.1, U801.B4 (PH3-BOOT0), Y801.2, Y801.4; also elsewhere on the board

Notes on the sheet:
CL = 8pF CS = 5pF ∴ CLx = 6pF
CL = 7pF CS = 4pF ∴ CLx = 6pF

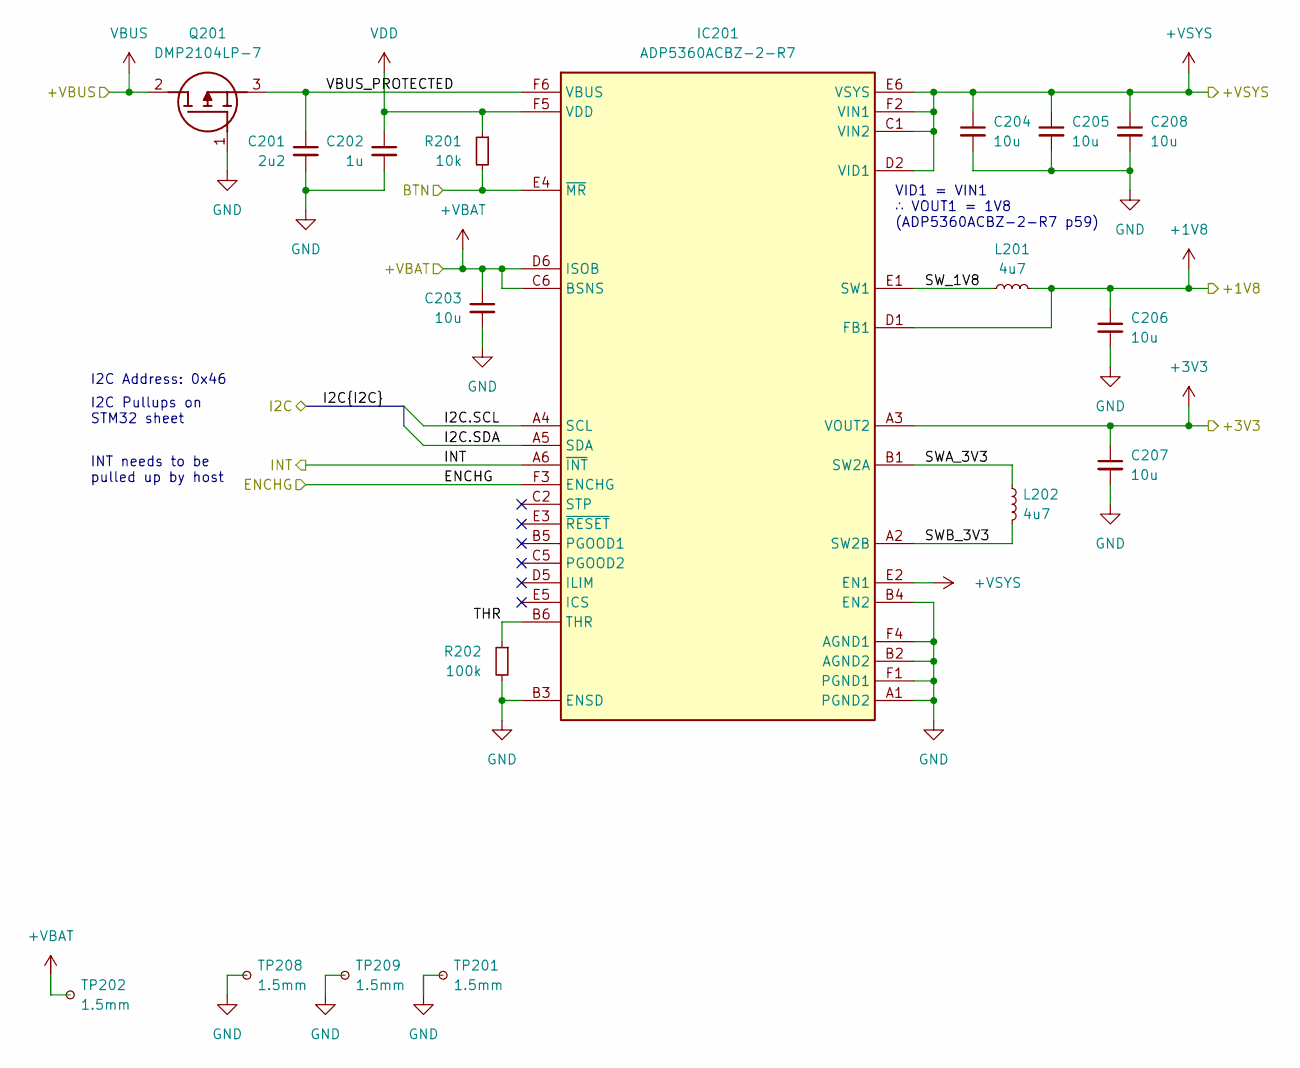
[picture p143: schematic power.kicad_sch, Watch Power]

Parts:
C201: 2u2; C_0402_1005Metric
C202: 1u; C_0402_1005Metric
C203, C204, C205, C206, C207, C208: 10u; C_0402_1005Metric
IC201: ADP5360ACBZ-2-R7; ADP5360ACBZ1R7; Mouser Part Number 584-ADP5360ACBZ-2-R7
L201, L202: 4u7; L_Murata_DFE201610P
Q201: DMP2104LP-7; DMP2104LP7; Mouser Part Number 621-DMP2104LP-7
R201: 10k; R_0402_1005Metric
R202: 100k; R_0402_1005Metric
TP201, TP202, TP208, TP209: 1.5mm; TestPoint_Pad_D1.5mm

Connections:
+1V8: C206.1, IC201.D1 (FB1), L201.2; also elsewhere on the board
+3V3: C207.1, IC201.A3 (VOUT2); also elsewhere on the board
+VBAT: C203.1, IC201.C6 (BSNS), IC201.D6 (ISOB), TP202.1; also elsewhere on the board
+VSYS: C204.1, C205.1, C208.1, IC201.C1 (VIN2), IC201.D2 (VID1), IC201.E2 (EN1), IC201.E6 (VSYS), IC201.F2 (VIN1); also elsewhere on the board
/I2C2.SCL: IC201.A4 (SCL); also elsewhere on the board
/I2C2.SDA: IC201.A5 (SDA); also elsewhere on the board
/Power/ENCHG: IC201.F3 (ENCHG); also elsewhere on the board
/Power/INT: IC201.A6 (~INT); also elsewhere on the board
/Power/SWA_3V3: IC201.B1 (SW2A), L202.1
/Power/SWB_3V3: IC201.A2 (SW2B), L202.2
/Power/SW_1V8: IC201.E1 (SW1), L201.1
/Power/THR: IC201.B6 (THR), R202.1
/Power/VBUS_PROTECTED: C201.1, IC201.F6 (VBUS), Q201.3 (S)
/STM32/BTN: IC201.E4 (~MR), R201.2; also elsewhere on the board
GND: C201.2, C202.2, C203.2, C204.2, C205.2, C206.2, C207.2, C208.2, IC201.A1 (PGND2), IC201.B2 (AGND2), IC201.B3 (ENSD), IC201.B4 (EN2), IC201.F1 (PGND1), IC201.F4 (AGND1), Q201.1 (G), R202.2, TP201.1, TP208.1, TP209.1; also elsewhere on the board
VBUS: Q201.2 (D); also elsewhere on the board
VDD: C202.1, IC201.F5 (VDD), R201.1

Notes on the sheet:
VID1 = VIN1 ∴ VOUT1 = 1V8 (ADP5360ACBZ-2-R7 p59)
INT needs to be pulled up by host
I2C Address: 0x46
I2C Pullups on STM32 sheet

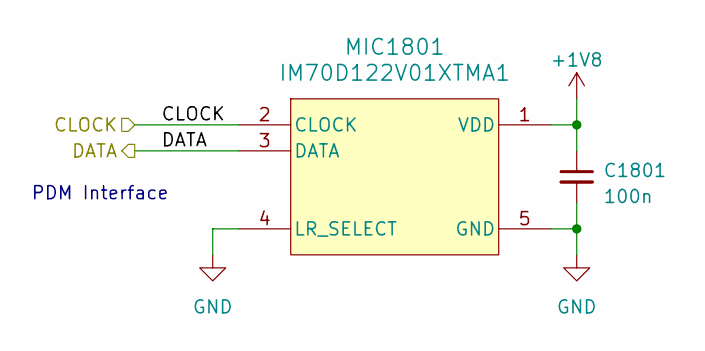
[picture p144: schematic microphone.kicad_sch, Watch Microphone]

Parts:
C1801: 100n; C_0402_1005Metric
MIC1801: IM70D122V01XTMA1; PG-TLGA-5-2_INF

Connections:
+1V8: C1801.1, MIC1801.1 (VDD); also elsewhere on the board
/Microphone/CLOCK: MIC1801.2 (CLOCK); also elsewhere on the board
/Microphone/DATA: MIC1801.3 (DATA); also elsewhere on the board
GND: C1801.2, MIC1801.4 (LR_SELECT), MIC1801.5 (GND); also elsewhere on the board

Notes on the sheet:
PDM Interface

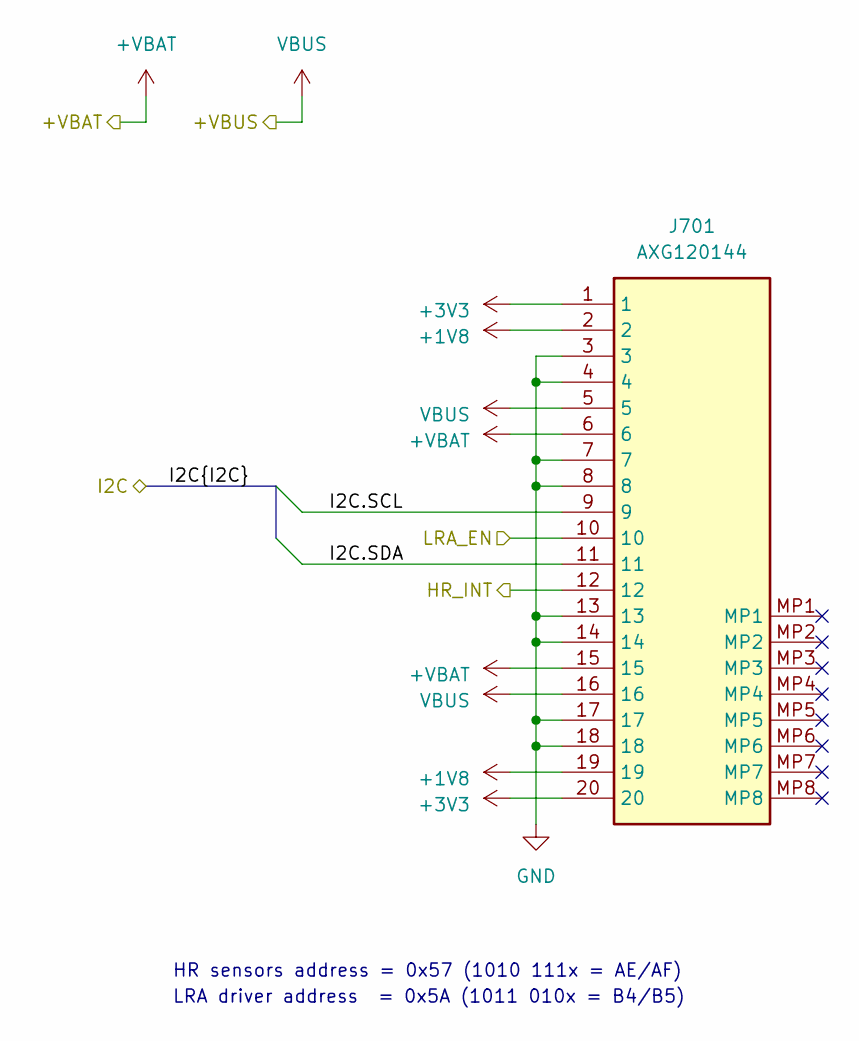
[picture p145: schematic daughterboard_connector.kicad_sch, Watch Daughterboard Connector]

Parts:
J701: AXG120144; Manufacturer_Part_Number AXG120144; Mouser Part Number 769-AXG120144

Connections:
+1V8: J701.2, J701.19; also elsewhere on the board
+3V3: J701.1, J701.20; also elsewhere on the board
+VBAT: J701.6, J701.15; also elsewhere on the board
/I2C4.SCL: J701.9; also elsewhere on the board
/I2C4.SDA: J701.11; also elsewhere on the board
/STM32/HR_INT: J701.12; also elsewhere on the board
/STM32/LRA_EN: J701.10; also elsewhere on the board
GND: J701.3, J701.4, J701.7, J701.8, J701.13, J701.14, J701.17, J701.18; also elsewhere on the board
VBUS: J701.5, J701.16; also elsewhere on the board

Notes on the sheet:
HR sensors address = 0x57 (1010 111x = AE/AF)
LRA driver address = 0x5A (1011 010x = B4/B5)

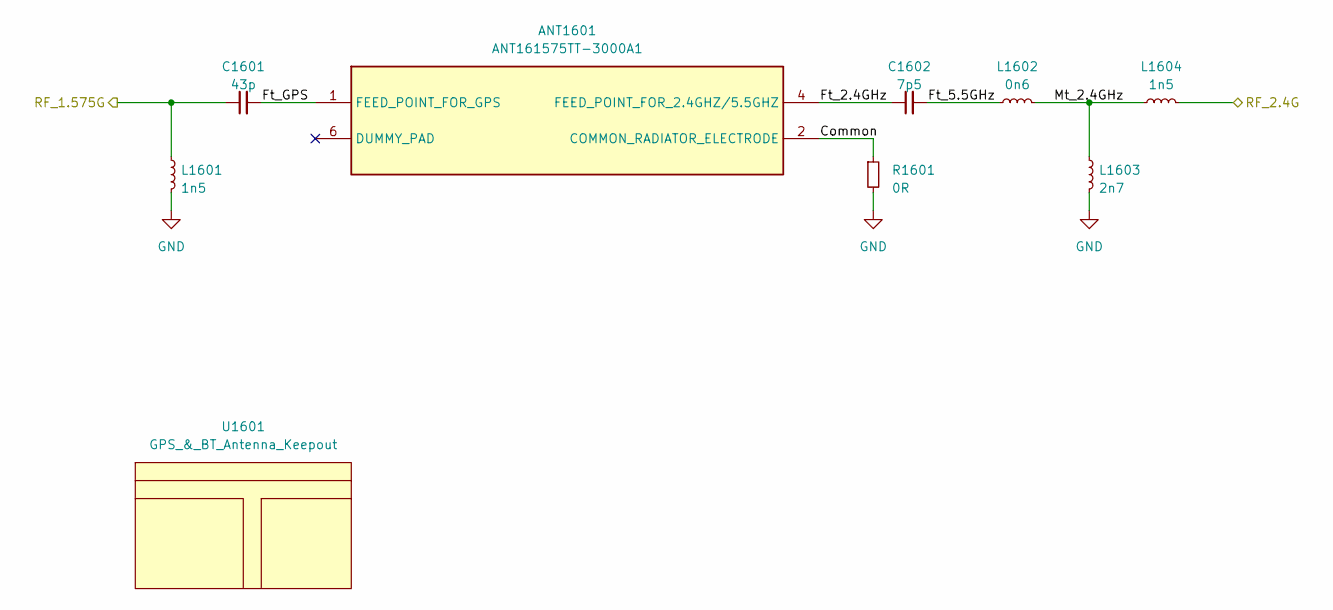
[picture p146: schematic antenna.kicad_sch, Watch Antenna]

Parts:
ANT1601: ANT161575TT-3000A1; ANT161575TT3000A1; Mouser Part Number 810-ANT161575TT-30A1
C1601: 43p; C_0402_1005Metric
C1602: 7p5; C_0402_1005Metric
L1601, L1604: 1n5; L_0402_1005Metric
L1602: 0n6; L_0402_1005Metric
L1603: 2n7; L_0402_1005Metric
R1601: 0R; R_0402_1005Metric
U1601: GPS_&_BT_Antenna_Keepout; GPS & BT Antenna

Connections:
/Antenna/Common: ANT1601.2 (COMMON_RADIATOR_ELECTRODE), R1601.1
/Antenna/Ft_2.4GHz: ANT1601.4 (FEED_POINT_FOR_2.4GHZ/5.5GHZ), C1602.1
/Antenna/Ft_5.5GHz: C1602.2, L1602.1
/Antenna/Ft_GPS: ANT1601.1 (FEED_POINT_FOR_GPS), C1601.2
/Antenna/Mt_2.4GHz: L1602.2, L1603.1, L1604.1
/Antenna/RF_2.4G: L1604.2; also elsewhere on the board
/GNSS/RF_1.575G: C1601.1, L1601.1; also elsewhere on the board
GND: L1601.2, L1603.2, R1601.2; also elsewhere on the board

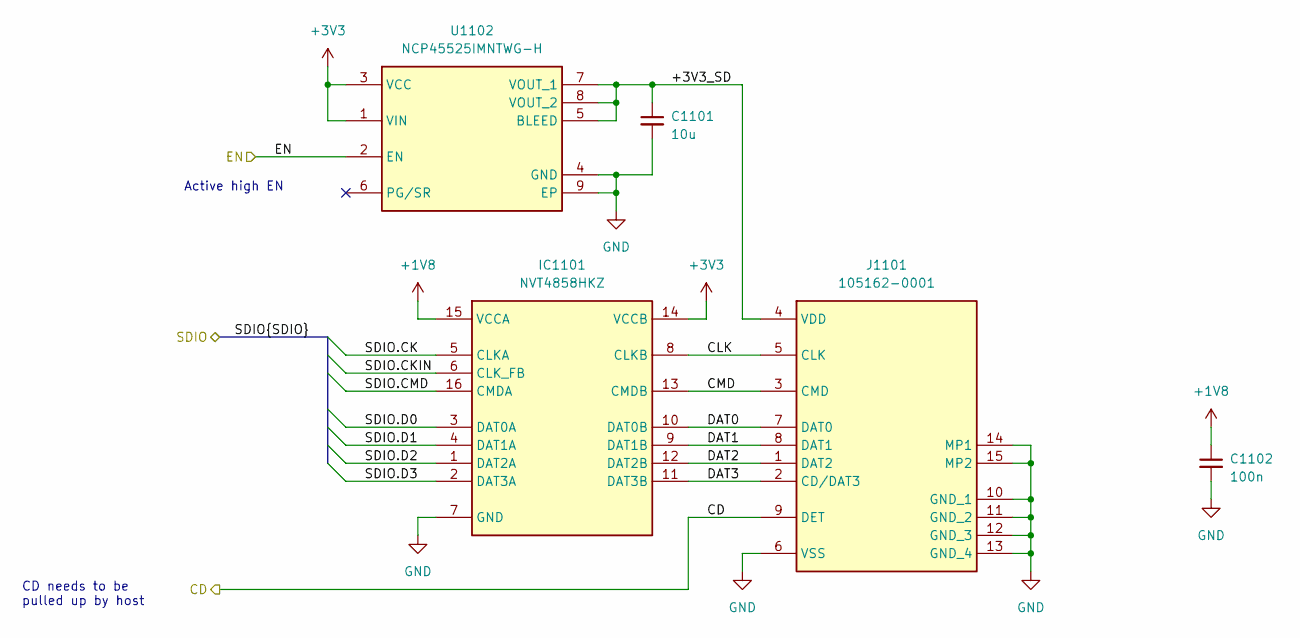
[picture p147: schematic micro_sd.kicad_sch, Watch Micro SD]

Parts:
C1101: 10u; C_0402_1005Metric
C1102: 100n; C_0402_1005Metric
IC1101: NVT4858HKZ; Mouser Part Number 771-NVT4858HKZ
J1101: 105162-0001; Mouser Part Number 538-105162-0001
U1102: NCP45525IMNTWG-H; NCP45525IMNTWGH; Mouser Part Number 863-NCP45525IMNTWG-H

Connections:
+1V8: C1102.1, IC1101.15 (VCCA); also elsewhere on the board
+3V3: IC1101.14 (VCCB), U1102.1 (VIN), U1102.3 (VCC); also elsewhere on the board
/Micro SD/+3V3_SD: C1101.1, J1101.4 (VDD), U1102.5 (BLEED), U1102.7 (VOUT_1), U1102.8 (VOUT_2)
/Micro SD/CD: J1101.9 (DET); also elsewhere on the board
/Micro SD/CLK: IC1101.8 (CLKB), J1101.5 (CLK)
/Micro SD/CMD: IC1101.13 (CMDB), J1101.3 (CMD)
/Micro SD/DAT0: IC1101.10 (DAT0B), J1101.7 (DAT0)
/Micro SD/DAT1: IC1101.9 (DAT1B), J1101.8 (DAT1)
/Micro SD/DAT2: IC1101.12 (DAT2B), J1101.1 (DAT2)
/Micro SD/DAT3: IC1101.11 (DAT3B), J1101.2 (CD/DAT3)
/Micro SD/EN: U1102.2 (EN); also elsewhere on the board
/SDMMC1.CK: IC1101.5 (CLKA); also elsewhere on the board
/SDMMC1.CKIN: IC1101.6 (CLK_FB); also elsewhere on the board
/SDMMC1.CMD: IC1101.16 (CMDA); also elsewhere on the board
/SDMMC1.D0: IC1101.3 (DAT0A); also elsewhere on the board
/SDMMC1.D1: IC1101.4 (DAT1A); also elsewhere on the board
/SDMMC1.D2: IC1101.1 (DAT2A); also elsewhere on the board
/SDMMC1.D3: IC1101.2 (DAT3A); also elsewhere on the board
GND: C1101.2, C1102.2, IC1101.7 (GND), J1101.6 (VSS), J1101.10 (GND_1), J1101.11 (GND_2), J1101.12 (GND_3), J1101.13 (GND_4), J1101.14 (MP1), J1101.15 (MP2), U1102.4 (GND), U1102.9 (EP); also elsewhere on the board

Notes on the sheet:
CD needs to be pulled up by host
Active high EN


Parts:
J501: AXG130144; Mouser Part Number 667-AXG130144

Connections:
+1V8: J501.1, J501.2, J501.5; also elsewhere on the board
/DSI.CKN: J501.28; also elsewhere on the board
/DSI.CKP: J501.27; also elsewhere on the board
/DSI.D0N: J501.25; also elsewhere on the board
/DSI.D0P: J501.24; also elsewhere on the board
/Display Connector/AVDD: J501.3, J501.4; also elsewhere on the board
/Display Connector/DSI_TE: J501.11; also elsewhere on the board
/Display Connector/ELVDD: J501.16, J501.17, J501.18; also elsewhere on the board
/Display Connector/RESET: J501.10; also elsewhere on the board
/Display Connector/SWIRE: J501.12; also elsewhere on the board
/Display Connector/TP_INT: J501.22; also elsewhere on the board
/Display Connector/TP_RST: J501.19; also elsewhere on the board
/Display Power/ELVSS: J501.13, J501.14, J501.15; also elsewhere on the board
/I2C6.SCL: J501.20; also elsewhere on the board
/I2C6.SDA: J501.21; also elsewhere on the board
GND: J501.6, J501.7, J501.8, J501.9, J501.23, J501.26, J501.29; also elsewhere on the board

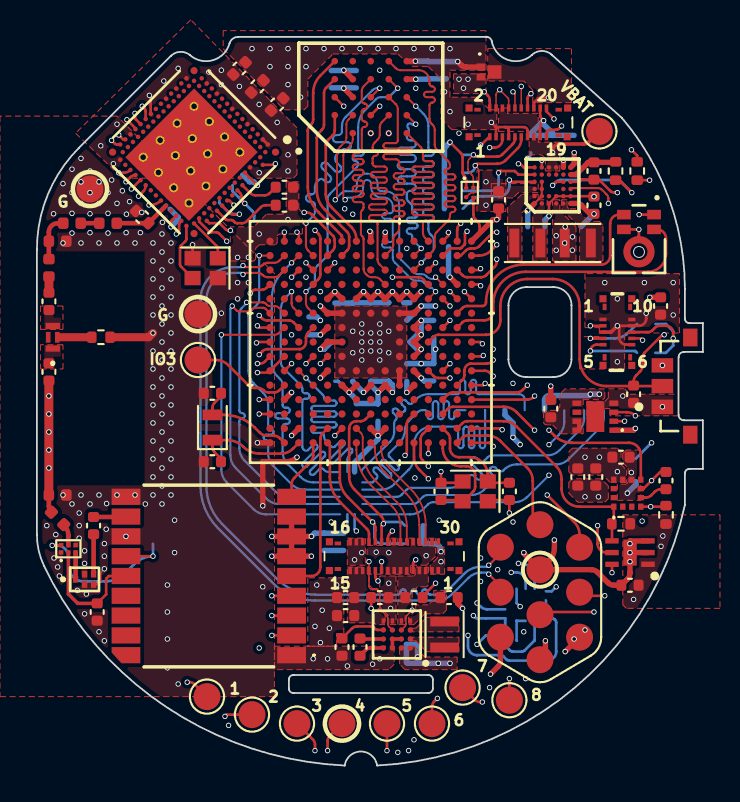
[picture p148: board PCBs/watch_main_v2/watch_main.kicad_pcb from above]

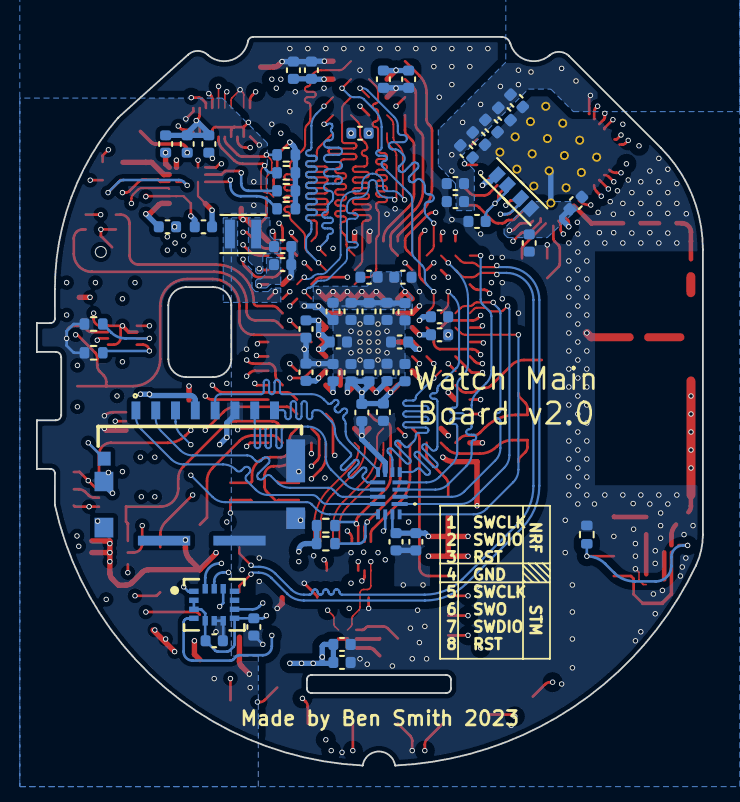
[picture p149: board PCBs/watch_main_v2/watch_main.kicad_pcb from below]

Board: 8 copper layers, 37.0 x 40.5 mm, 146 parts (63 on the bottom side), 145 nets.
