ben5049/Smart-Watch/PCBs/watch_lower/watch_lower.kicad_pcb

## KiCad design PCBs/watch_lower/watch_lower.kicad_pcb (2024-01-10)

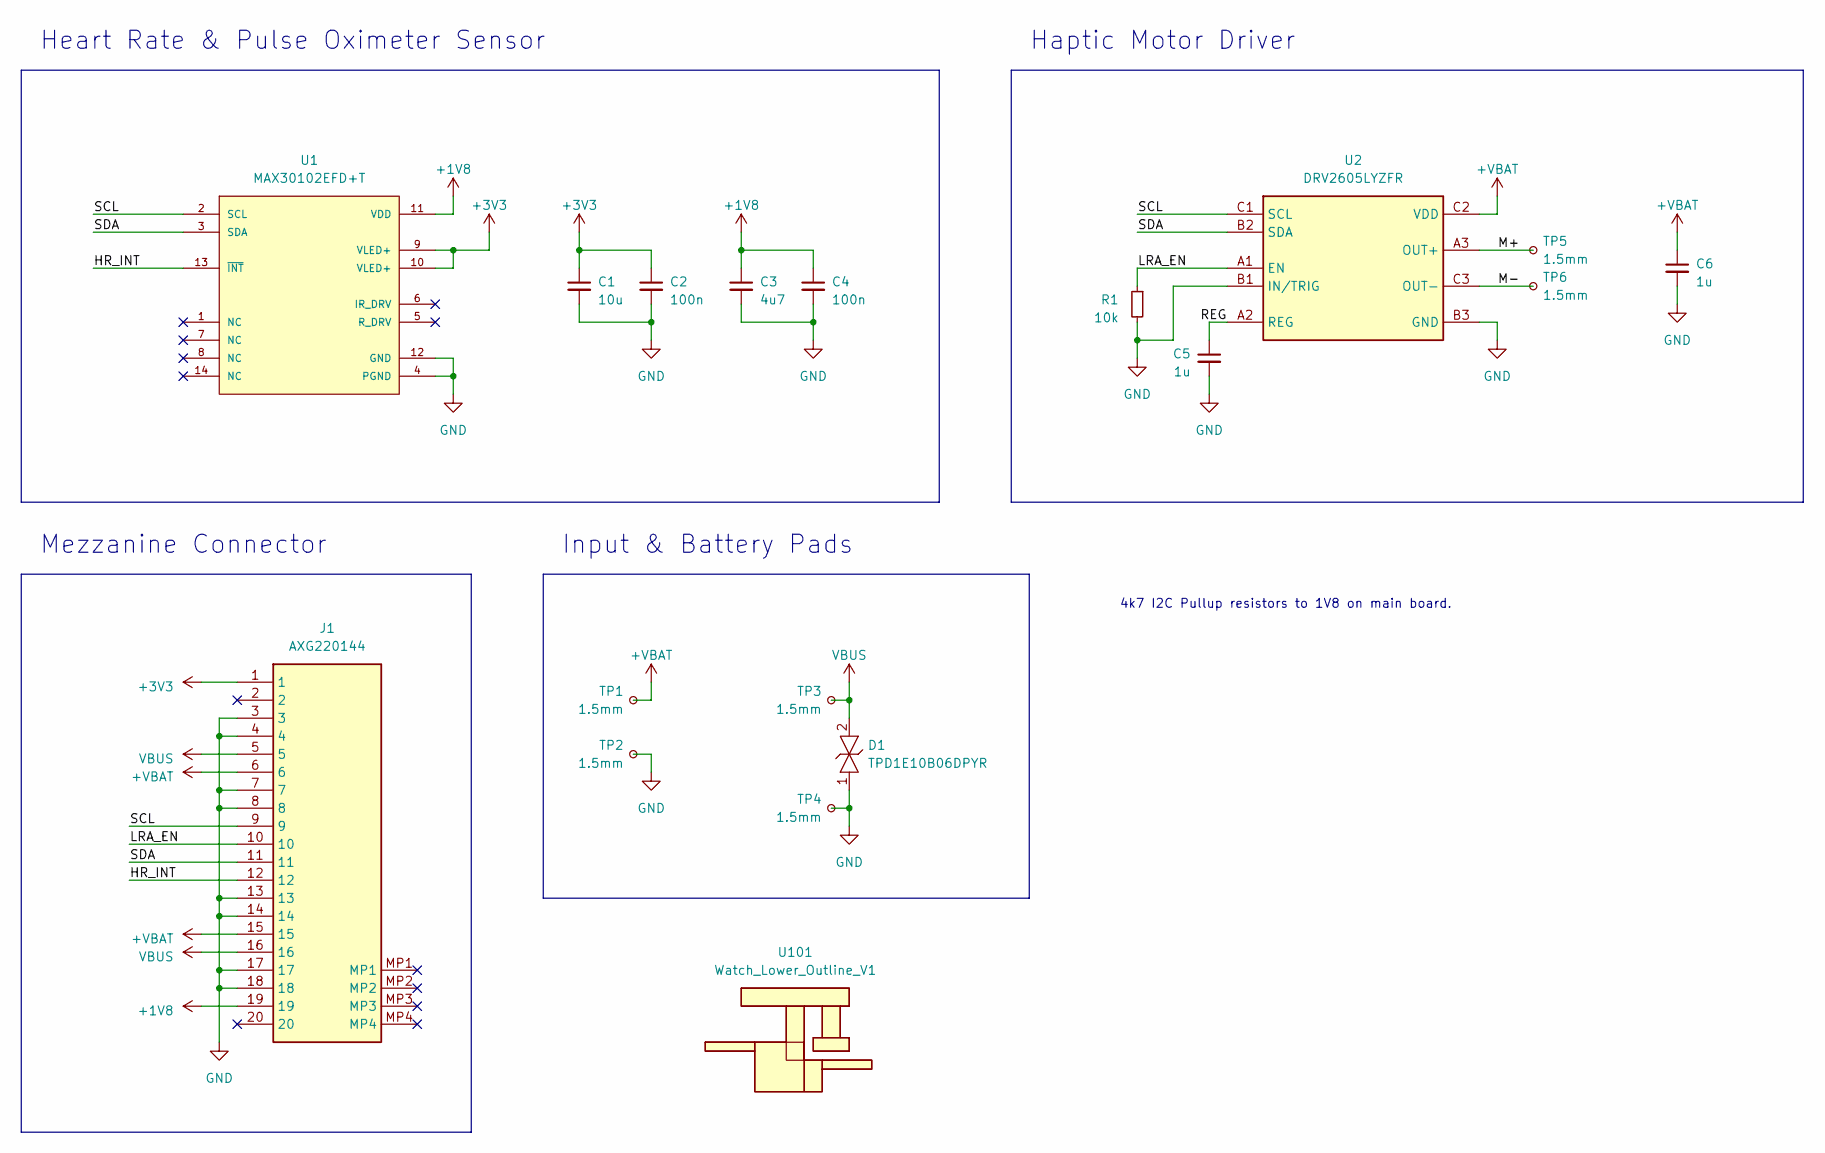
[picture p150: schematic watch_lower.kicad_sch]

Parts:
C1: 10u; C_0402_1005Metric
C2, C4: 100n; C_0402_1005Metric
C3: 4u7; C_0402_1005Metric
C5, C6: 1u; C_0402_1005Metric
D1: TPD1E10B06DPYR; Mouser Part Number 595-TPD1E10B06DPYR
J1: AXG220144; Manufacturer_Part_Number AXG220144; Mouser Part Number 769-AXG220144
R1: 10k; R_0402_1005Metric
TP1, TP2, TP3, TP4, TP5, TP6: 1.5mm; TestPoint_Pad_D1.5mm
U1: MAX30102EFD+T; mouser part number 700-MAX30102EFD+T; digikey description INTEGRATED OPTICAL SENSOR
U2: DRV2605LYZFR; BGA9C50P3X3_144X144X62; Mouser Part Number 595-DRV2605LYZFR
U101: Watch_Lower_Outline_V1; Watch Lower Outline V1

Connections:
+1V8: C3.1, C4.1, J1.19, U1.11 (VDD)
+3V3: C1.1, C2.1, J1.1, U1.9 (VLED+), U1.10 (VLED+)
+VBAT: C6.1, J1.6, J1.15, TP1.1, U2.C2 (VDD)
/HR_INT: J1.12, U1.13 (~INT)
/LRA_EN: J1.10, R1.1, U2.A1 (EN)
/M+: TP5.1, U2.A3 (OUT+)
/M-: TP6.1, U2.C3 (OUT-)
/REG: C5.1, U2.A2 (REG)
/SCL: J1.9, U1.2 (SCL), U2.C1 (SCL)
/SDA: J1.11, U1.3 (SDA), U2.B2 (SDA)
GND: C1.2, C2.2, C3.2, C4.2, C5.2, C6.2, D1.1, J1.3, J1.4, J1.7, J1.8, J1.13, J1.14, J1.17, J1.18, R1.2, TP2.1, TP4.1, U1.4 (PGND), U1.12 (GND), U2.B1 (IN/TRIG), U2.B3 (GND)
VBUS: D1.2, J1.5, J1.16, TP3.1

Notes on the sheet:
Mezzanine Connector
Heart Rate & Pulse Oximeter Sensor
Input & Battery Pads
Haptic Motor Driver
4k7 I2C Pullup resistors to 1V8 on main board.

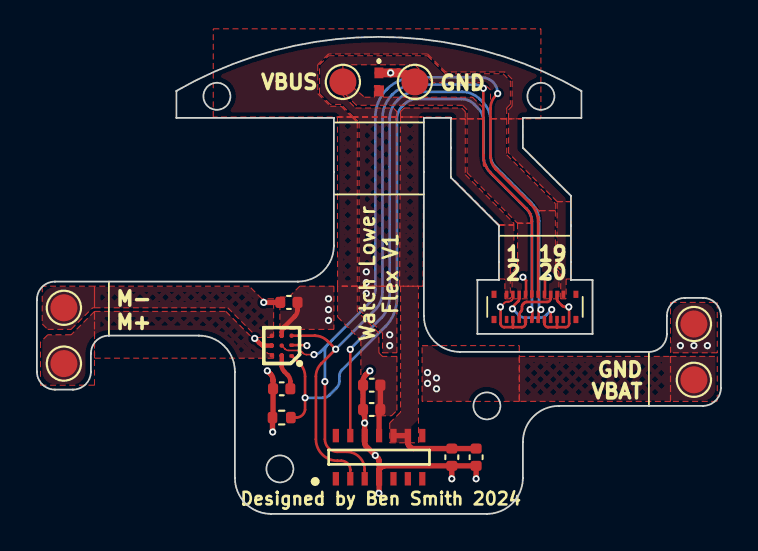
[picture p151: board watch_lower.kicad_pcb from above]

Board: 2 copper layers, 38.0 x 26.5 mm, 18 parts (0 on the bottom side), 12 nets.
