ben5049/Smart-Watch/PCBs/watch_test_rig_v2/watch_test_rig.kicad_pcb

## KiCad design PCBs/watch_test_rig_v2/watch_test_rig.kicad_pcb (2024-01-01)

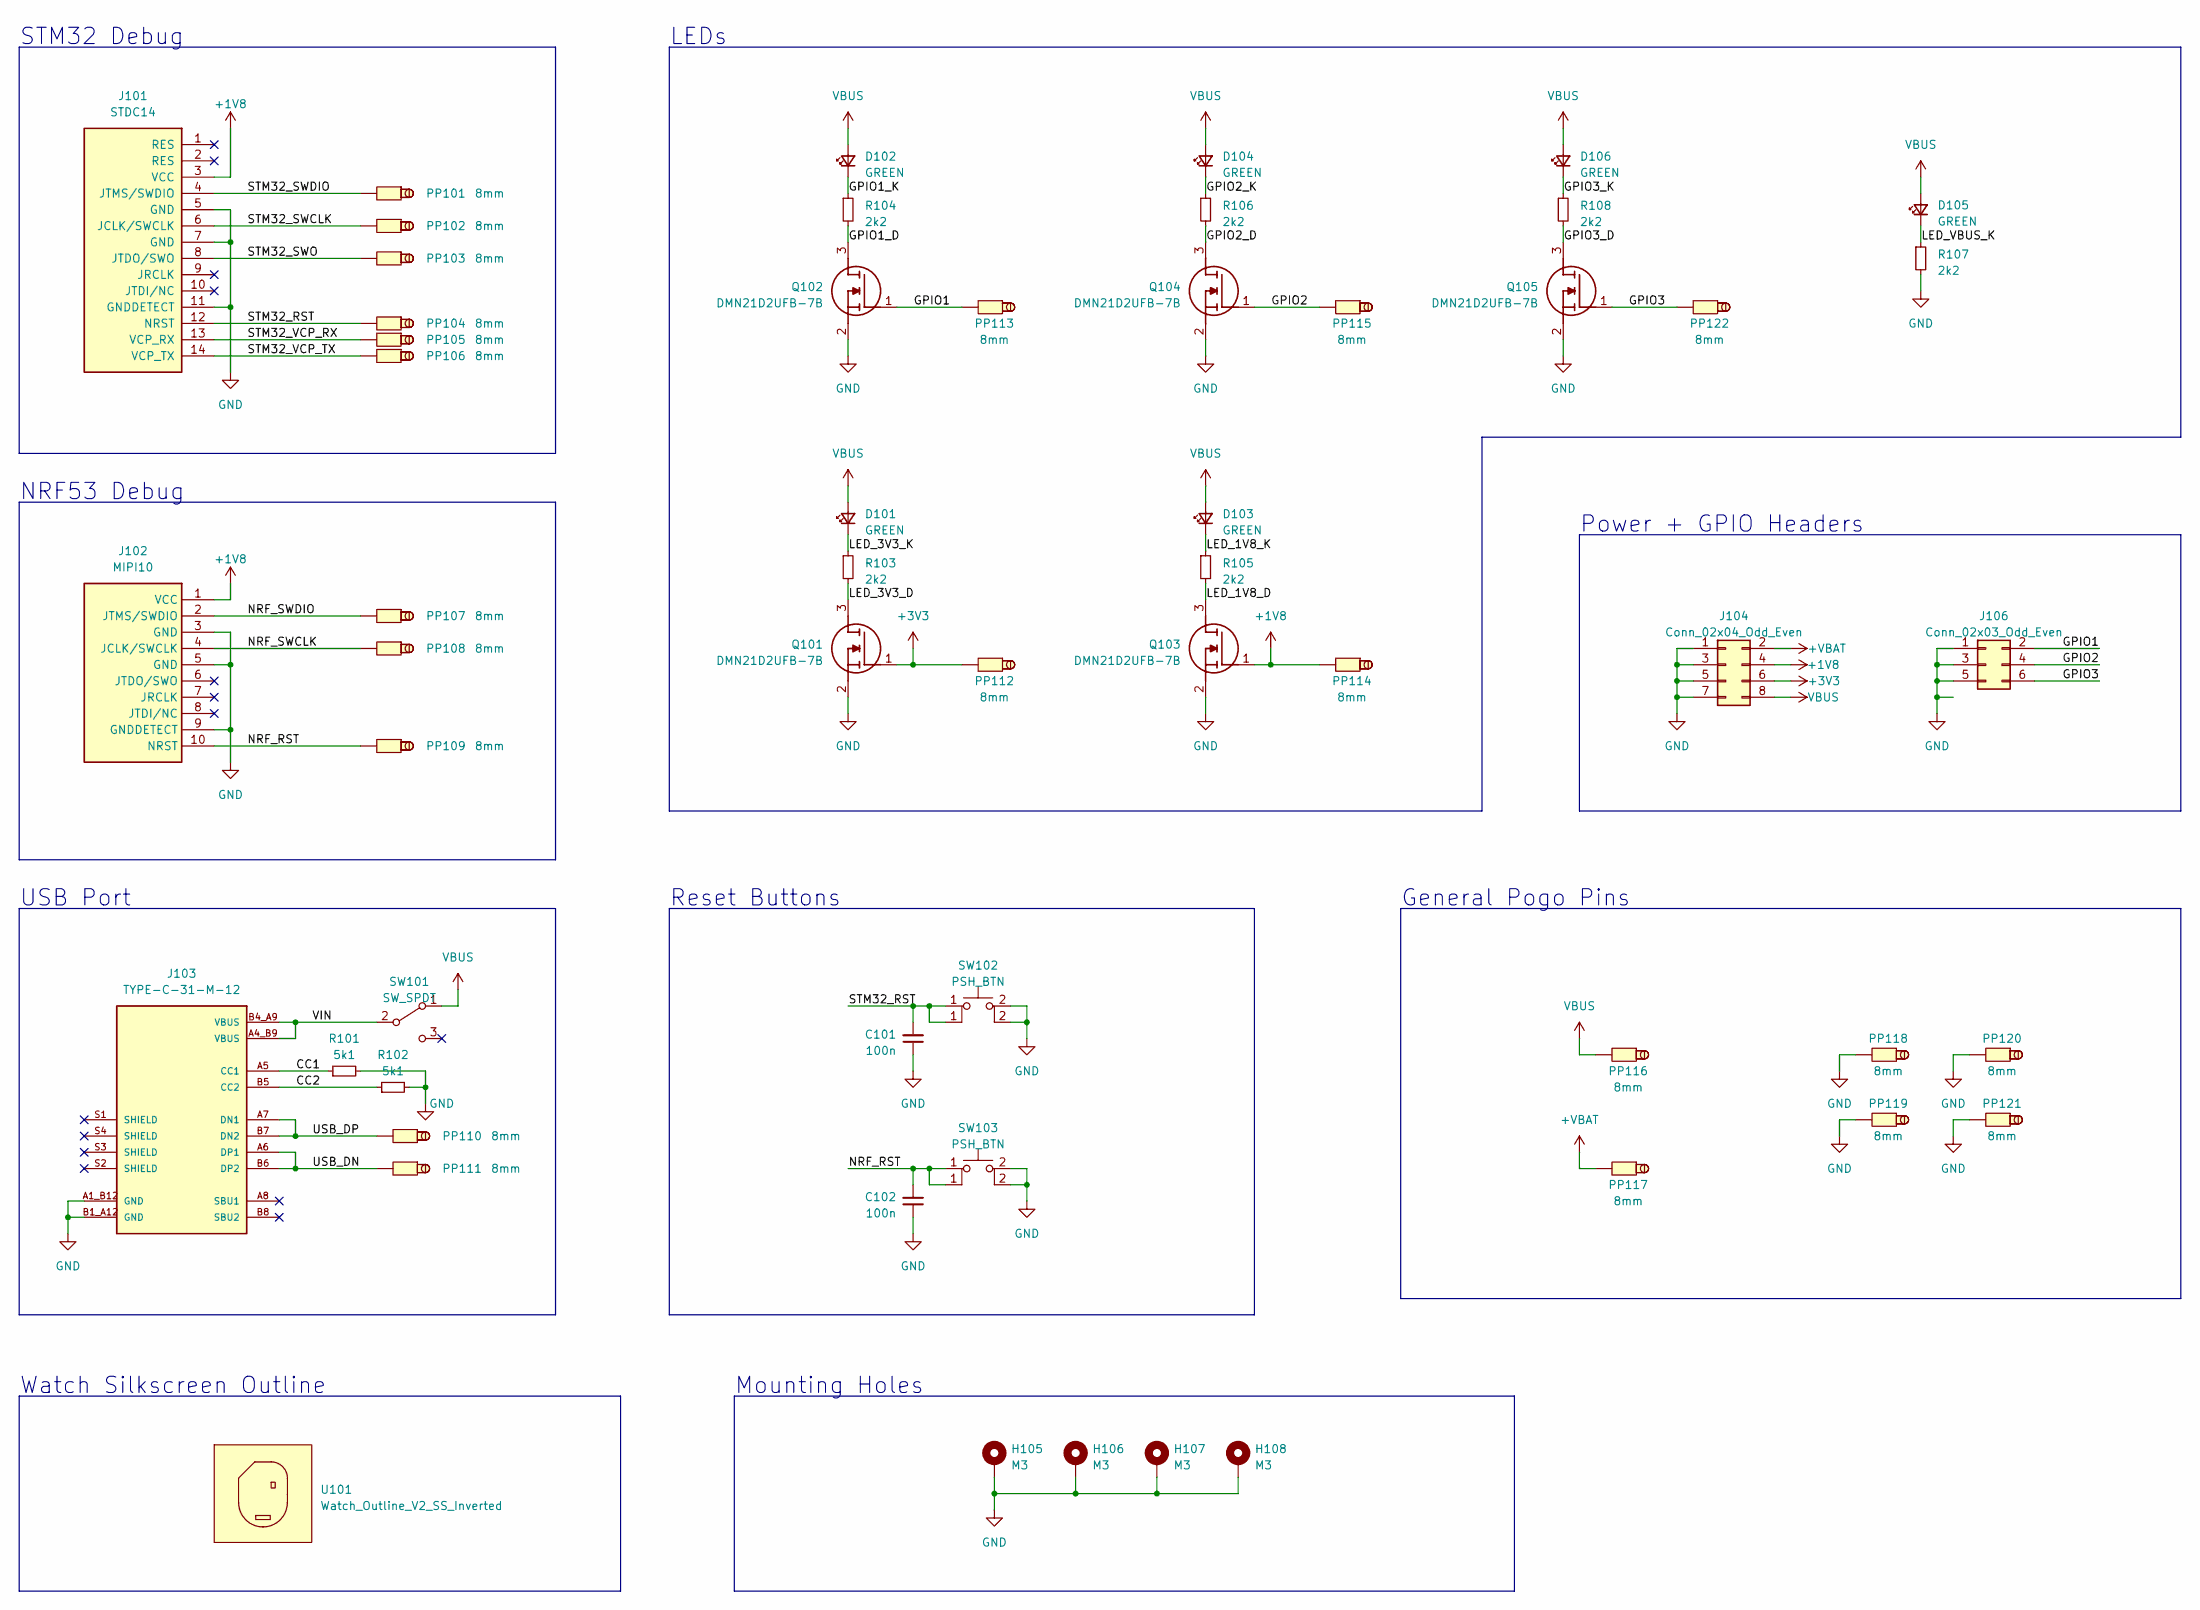
[picture p152: schematic watch_test_rig.kicad_sch, Watch Test Rig]

Parts:
C101, C102: 100n; C_0402_1005Metric
D101, D102, D103, D104, D105, D106: GREEN; D_0603_1608Metric
H105, H106, H107, H108: M3; MountingHole_3.2mm_M3_DIN965_Pad_TopBottom
J101: STDC14
J102: MIPI10
J103: TYPE-C-31-M-12; PARTREV 2020.12.08
J104: Conn_02x04_Odd_Even; PinHeader_2x04_P2.54mm_Vertical
J106: Conn_02x03_Odd_Even; PinHeader_2x03_P2.54mm_Vertical
PP101, PP102, PP103, PP104, PP105, PP106, PP107, PP108, PP109, PP110, PP111, PP112, PP113, PP114, PP115, PP116, PP117, PP118, PP119, PP120, PP121, PP122: 8mm; Pogo_Pin_8mm_SMD
Q101, Q102, Q103, Q104, Q105: DMN21D2UFB-7B; DMN21D2UFB7B; Mouser Part Number 621-DMN21D2UFB-7B
R101, R102: 5k1; R_0402_1005Metric
R103, R104, R105, R106, R107, R108: 2k2; R_0402_1005Metric
SW101: SW_SPDT; PinHeader_1x03_P2.54mm_Vertical
SW102, SW103: PSH_BTN; SW_PUSH_6mm_H5mm
U101: Watch_Outline_V2_SS_Inverted; Watch Outline V2 SS Inverted

Connections:
+1V8: J101.3 (VCC), J102.1 (VCC), J104.4, PP114.1, Q103.1 (G)
+3V3: J104.6, PP112.1, Q101.1 (G)
+VBAT: J104.2, PP117.1
/CC1: J103.A5 (CC1), R101.1
/CC2: J103.B5 (CC2), R102.1
/GPIO1: J106.2, PP113.1, Q102.1 (G)
/GPIO1_D: Q102.3 (D), R104.2
/GPIO1_K: D102.1 (K), R104.1
/GPIO2: J106.4, PP115.1, Q104.1 (G)
/GPIO2_D: Q104.3 (D), R106.2
/GPIO2_K: D104.1 (K), R106.1
/GPIO3: J106.6, PP122.1, Q105.1 (G)
/GPIO3_D: Q105.3 (D), R108.2
/GPIO3_K: D106.1 (K), R108.1
/LED_1V8_D: Q103.3 (D), R105.2
/LED_1V8_K: D103.1 (K), R105.1
/LED_3V3_D: Q101.3 (D), R103.2
/LED_3V3_K: D101.1 (K), R103.1
/LED_VBUS_K: D105.1 (K), R107.1
/NRF_RST: C102.2, J102.10 (NRST), PP109.1, SW103.1
/NRF_SWCLK: J102.4 (JCLK/SWCLK), PP108.1
/NRF_SWDIO: J102.2 (JTMS/SWDIO), PP107.1
/STM32_RST: C101.2, J101.12 (NRST), PP104.1, SW102.1
/STM32_SWCLK: J101.6 (JCLK/SWCLK), PP102.1
/STM32_SWDIO: J101.4 (JTMS/SWDIO), PP101.1
/STM32_SWO: J101.8 (JTDO/SWO), PP103.1
/STM32_VCP_RX: J101.13 (VCP_RX), PP105.1
/STM32_VCP_TX: J101.14 (VCP_TX), PP106.1
/USB_DN: J103.A6 (DP1), J103.B6 (DP2), PP111.1
/USB_DP: J103.A7 (DN1), J103.B7 (DN2), PP110.1
/VIN: J103.A4_B9 (VBUS), J103.B4_A9 (VBUS), SW101.2 (B)
GND: C101.1, C102.1, H105.1, H106.1, H107.1, H108.1, J101.5 (GND), J101.7 (GND), J101.11 (GNDDETECT), J102.3 (GND), J102.5 (GND), J102.9 (GNDDETECT), J103.A1_B12 (GND), J103.B1_A12 (GND), J104.1, J104.3, J104.5, J104.7, J106.1, J106.3, J106.5, PP118.1, PP119.1, PP120.1, PP121.1, Q101.2 (S), Q102.2 (S), Q103.2 (S), Q104.2 (S), Q105.2 (S), R101.2, R102.2, R107.2, SW102.2, SW103.2
VBUS: D101.2 (A), D102.2 (A), D103.2 (A), D104.2 (A), D105.2 (A), D106.2 (A), J104.8, PP116.1, SW101.1 (A)

Notes on the sheet:
Mounting Holes
Watch Silkscreen Outline
STM32 Debug
USB Port
Reset Buttons
General Pogo Pins
Power + GPIO Headers
LEDs
NRF53 Debug

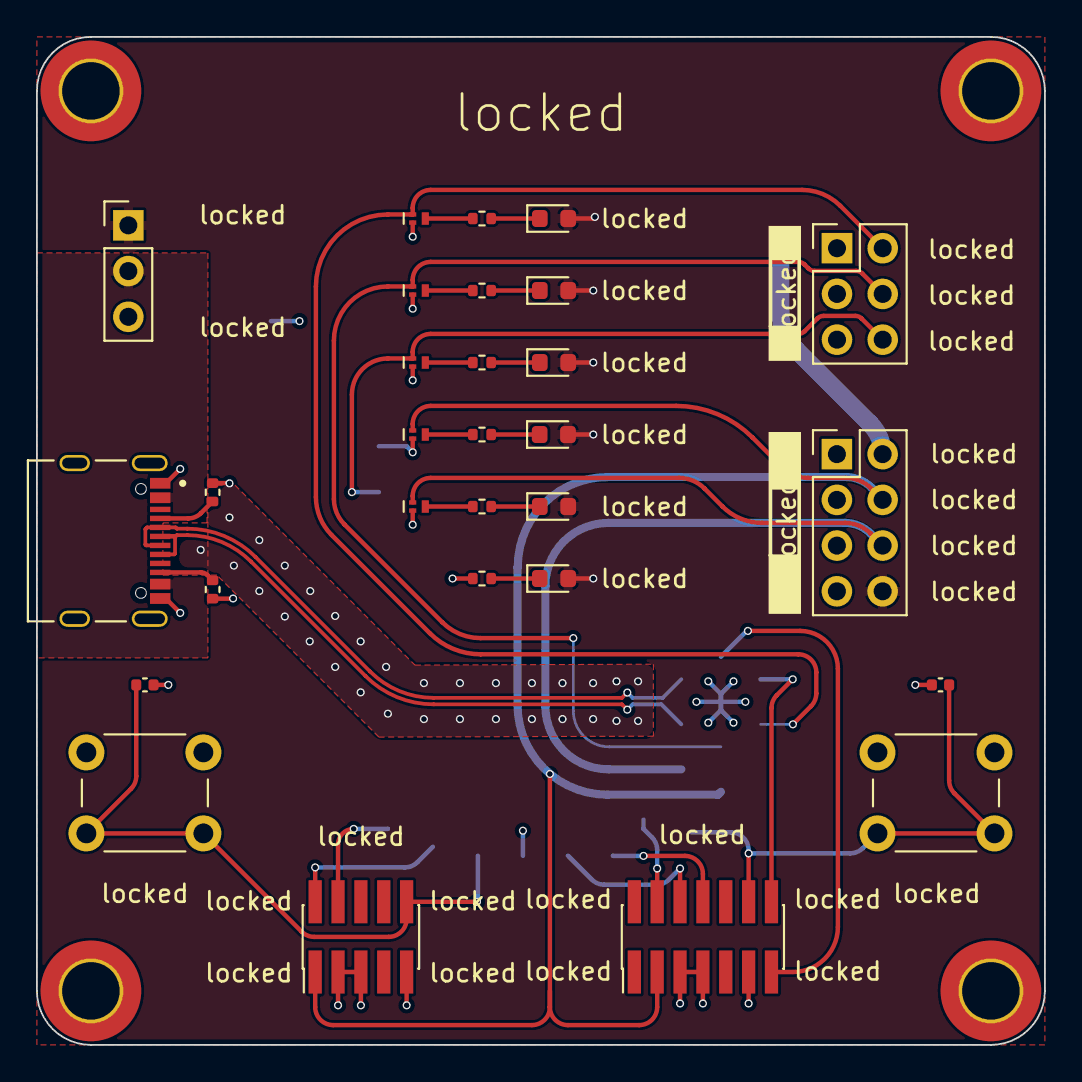
[picture p153: board PCBs/watch_test_rig_v2/watch_test_rig.kicad_pcb from above]

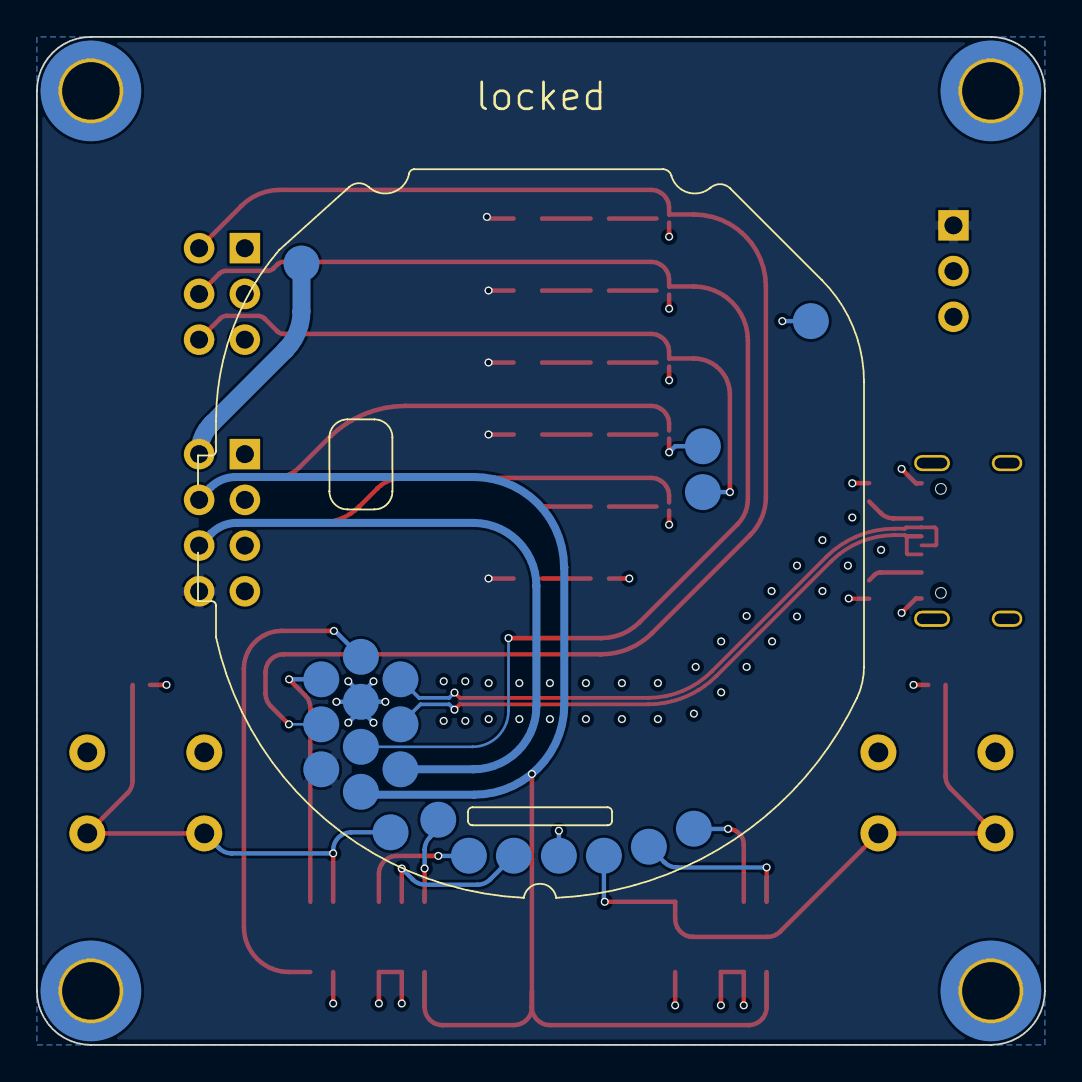
[picture p154: board PCBs/watch_test_rig_v2/watch_test_rig.kicad_pcb from below]

Board: 4 copper layers, 56.0 x 56.0 mm, 56 parts (22 on the bottom side), 33 nets.
