ben5049/Smart-Watch/PCBs/module_test_rig/module_test_rig.kicad_pcb

## KiCad design PCBs/module_test_rig/module_test_rig.kicad_pcb (2024-01-06)

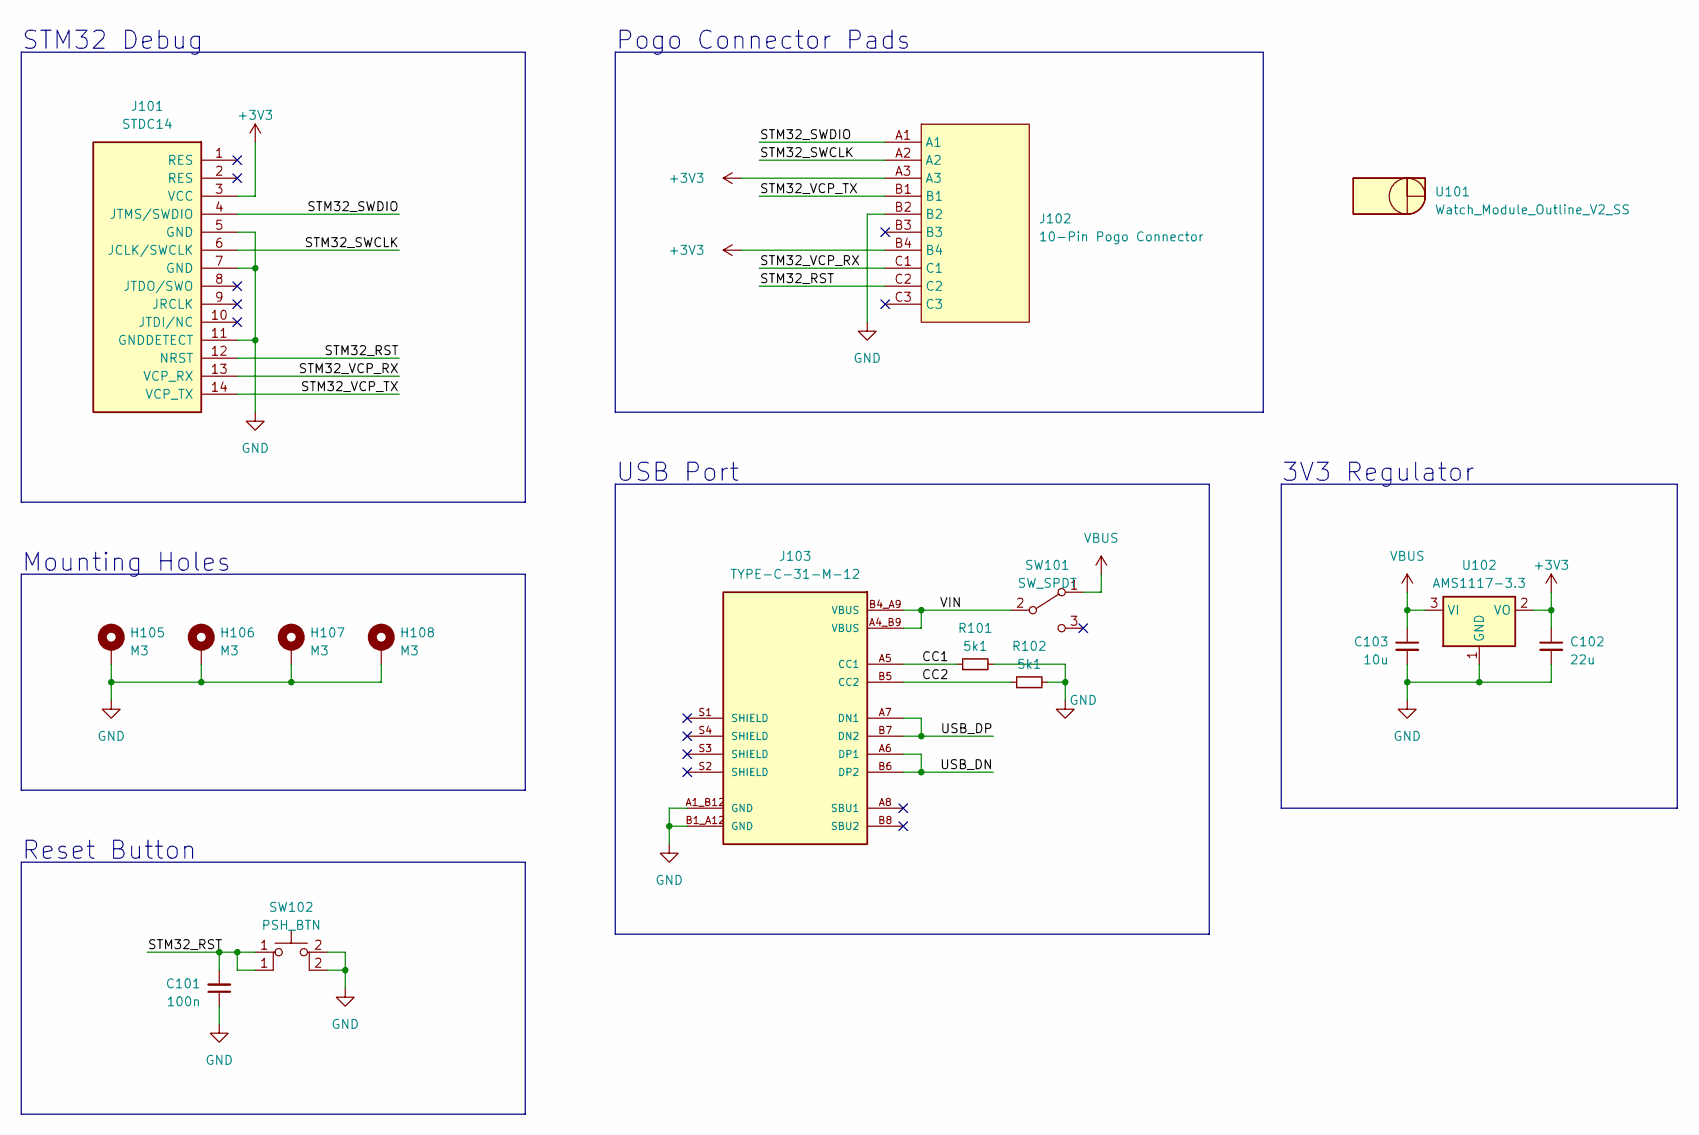
[picture p155: schematic module_test_rig.kicad_sch, Module Test Rig]

Parts:
C101: 100n; C_0402_1005Metric
C102: 22u; C_0402_1005Metric
C103: 10u; C_0402_1005Metric
H105, H106, H107, H108: M3; MountingHole_3.2mm_M3_DIN965_Pad_TopBottom
J101: STDC14
J102: 10-Pin Pogo Connector
J103: TYPE-C-31-M-12; PARTREV 2020.12.08
R101, R102: 5k1; R_0402_1005Metric
SW101: SW_SPDT; PinHeader_1x03_P2.54mm_Vertical
SW102: PSH_BTN; SW_PUSH_6mm_H5mm
U101: Watch_Module_Outline_V2_SS; Watch Module Outline V2 SS
U102: AMS1117-3.3; SOT-223-3_TabPin2

Connections:
+3V3: C102.1, J101.3 (VCC), J102.A3, J102.B4, U102.2 (VO)
/CC1: J103.A5 (CC1), R101.1
/CC2: J103.B5 (CC2), R102.1
/STM32_RST: C101.2, J101.12 (NRST), J102.C2, SW102.1
/STM32_SWCLK: J101.6 (JCLK/SWCLK), J102.A2
/STM32_SWDIO: J101.4 (JTMS/SWDIO), J102.A1
/STM32_VCP_RX: J101.13 (VCP_RX), J102.C1
/STM32_VCP_TX: J101.14 (VCP_TX), J102.B1
/USB_DN: J103.A6 (DP1), J103.B6 (DP2)
/USB_DP: J103.A7 (DN1), J103.B7 (DN2)
/VIN: J103.A4_B9 (VBUS), J103.B4_A9 (VBUS), SW101.2 (B)
GND: C101.1, C102.2, C103.2, H105.1, H106.1, H107.1, H108.1, J101.5 (GND), J101.7 (GND), J101.11 (GNDDETECT), J102.B2, J103.A1_B12 (GND), J103.B1_A12 (GND), R101.2, R102.2, SW102.2, U102.1 (GND)
VBUS: C103.1, SW101.1 (A), U102.3 (VI)

Notes on the sheet:
Mounting Holes
STM32 Debug
USB Port
Reset Button
Pogo Connector Pads
3V3 Regulator

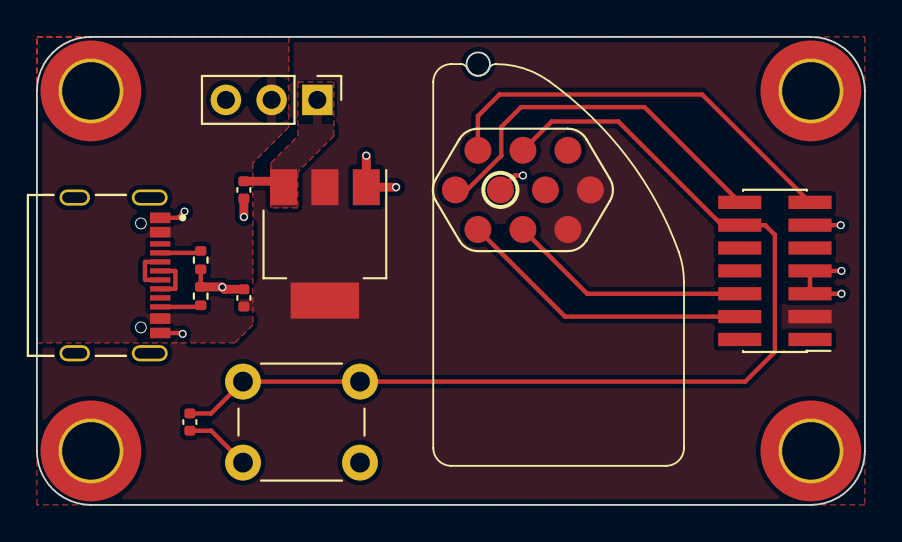
[picture p156: board module_test_rig.kicad_pcb from above]

Board: 2 copper layers, 46.0 x 26.0 mm, 16 parts (0 on the bottom side), 13 nets.
