ben5049/Smart-Watch/PCBs/lora_module/lora_module.kicad_pcb

## KiCad design PCBs/lora_module/lora_module.kicad_pcb (2024-01-02)

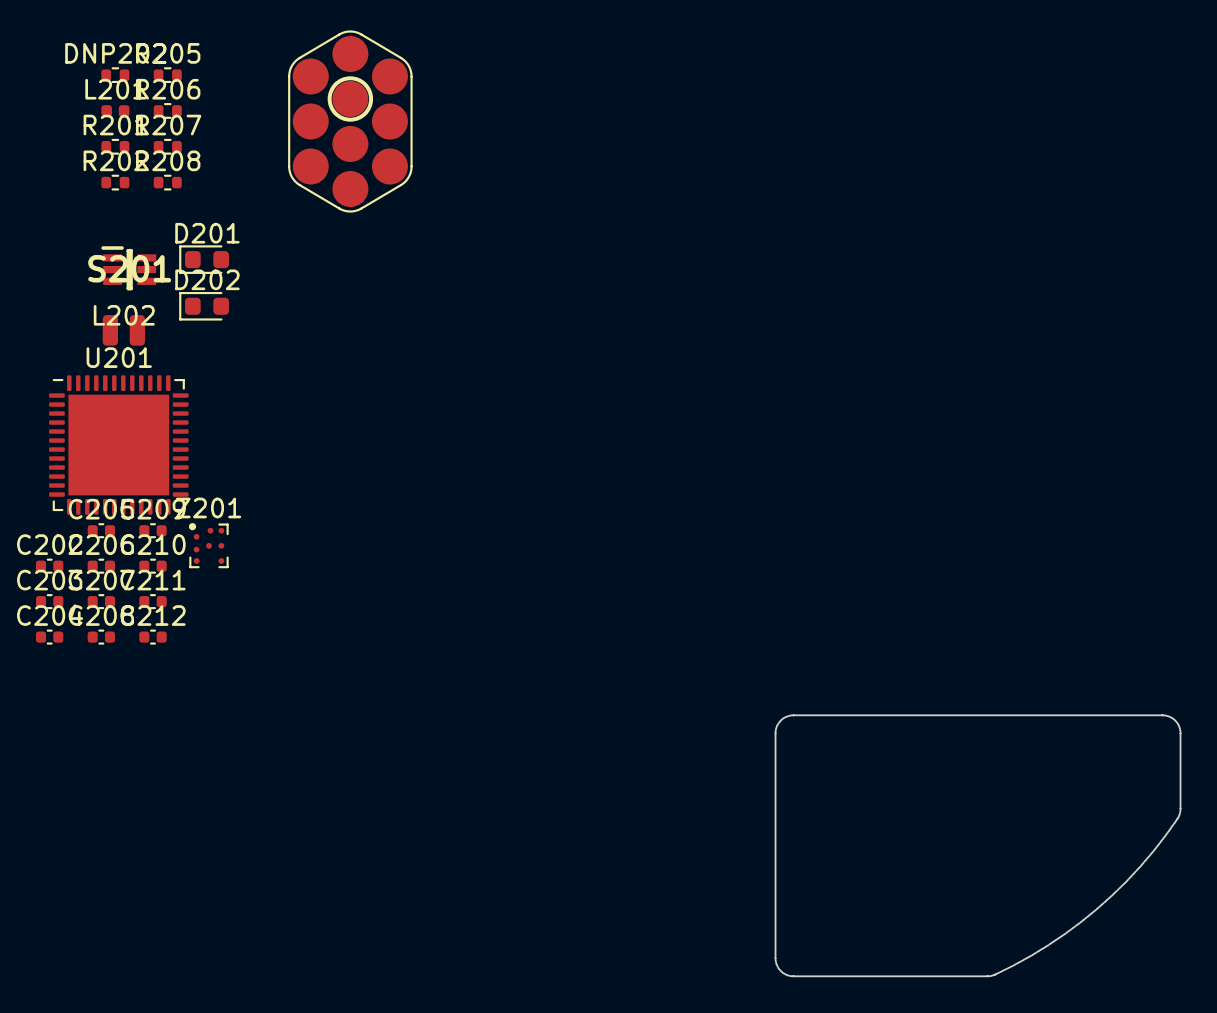
[picture p157: board lora_module.kicad_pcb from above]

Board: 2 copper layers, 22.5 x 14.5 mm, 27 parts (0 on the bottom side), 13 nets, no tracks yet.

Parts:
C202, C203, C206, C210: 100n; C_0402_1005Metric
C204: 68p; C_0402_1005Metric
C205: 470n; C_0402_1005Metric
C207, C212: 4u7; C_0402_1005Metric
C208: 10n; C_0402_1005Metric
C209, C211: 1u; C_0402_1005Metric
D201: LEDR; LED_0603_1608Metric
D202: LEDB; LED_0603_1608Metric
DNP202: 10k; R_0402_1005Metric
J401: 10-Pin_Pogo_Connector_Male; 10-Pin Pogo Connector Male
L201: 47n; L_0402_1005Metric
L202: 15u; Inductor 0806 (2016)
R201, R202: 1k; R_0402_1005Metric
R205, R207, R208: 10k; R_0402_1005Metric
R206: 0R; R_0402_1005Metric
S201: PE42421SCAA-Z; SOT65P210X110-6N
U101: Watch_Module_Outline_V1; Watch Module Outline V1
U201: STM32WL55CCUx; QFN-48-1EP_7x7mm_P0.5mm_EP5.6x5.6mm
Z201: BALFHB-WL-02D3

Connections:
+3V3: C203.1, C206.1, C207.1, C208.1, C209.1, C210.1, C211.1, C212.1, DNP202.1, J401.A3, R207.2, R208.2
/STM32WL55/CTRL1: R208.1, S201.6 (VDD)
/STM32WL55/CTRL2: R207.1, S201.4 (CTRL)
/STM32WL55/LoRa_BOOT: DNP202.2, R205.1
/STM32WL55/LoRa_LEDB_C: D202.1 (K), R202.1
/STM32WL55/LoRa_LEDR_C: D201.1 (K), R201.1
/STM32WL55/RFI: S201.3 (RF2), Z201.C3 (RFI_IN)
/STM32WL55/RFO: S201.1 (RF1), Z201.C1 (RFO_OUT)
/STM32WL55/RFO_HP1: L201.2, R206.1
/STM32WL55/RFO_HP2: R206.2, Z201.A1 (RFO_IN)
/STM32WL55/VDDRF1V5: C205.1, L202.1
/STM32WL55/VR_PA: C202.1, C204.1, L201.1
GND: C202.2, C203.2, C204.2, C205.2, C206.2, C207.2, C208.2, C209.2, C210.2, C211.2, C212.2, J401.B2, R201.2, R202.2, R205.2, S201.2 (GND), Z201.B1 (GND), Z201.B2 (GND), Z201.C2 (GND)
