ben5049/Smart-Watch/Firmware/STM32/main_board_v3/default_configuration_v3/default_configuration_v3.ioc

Mcu.UserName=STM32U5G9ZJJxQ
PA0.Signal=UART4_TX
PA1.Signal=UART4_RX
PA11.Signal=USB_OTG_HS_DM
PA12.Signal=USB_OTG_HS_DP
PA2.Signal=RCC_LSCO
PA3.GPIO_Label=AVDD_ADC
PA3.Signal=ADC1_IN8
PA4.GPIO_Label=ELVDD_ADC
PA4.Signal=ADC1_IN9
PA5.Signal=SPI1_SCK
PA6.Signal=SPI1_MISO
PA7.Signal=SPI1_MOSI
PA8.Signal=SDMMC2_D1
PB0.Signal=SPI1_NSS
PB1.GPIO_Label=ISYS_ADC
PB1.Signal=ADC1_IN16
PB10.Signal=OCTOSPIM_P1_CLK
PB11.Signal=I2C2_SDA
PB13.Signal=I2C2_SCL
PB14.Signal=SDMMC2_D0
PB15.GPIO_Label=BTN
PB15.Signal=GPXTI15
PB2.Signal=OCTOSPIM_P1_DQS
PB5.Signal=OCTOSPIM_P1_NCLK
PB6.Signal=I2C1_SCL
PB7.Signal=DSIHOST_TE
PB8.Signal=SDMMC1_CKIN
PB9.Signal=I2C1_SDA
PC0.Signal=I2C3_SCL
PC1.Signal=I2C3_SDA
PC10.Signal=SDMMC1_D2
PC11.Signal=SDMMC1_D3
PC12.Signal=SDMMC1_CK
PC13.GPIO_Label=IMU_INT2
PC13.Signal=GPXTI13
PC2.GPIO_Label=GPIO1
PC2.Signal=GPIO_Output
PC3.GPIO_Label=ELVSS_ADC
PC3.Signal=ADC1_IN4
PC6.GPIO_Label=FLASH_INT
PC6.Signal=GPXTI6
PC7.GPIO_Label=FLASH_RSTO
PC7.Signal=GPXTI7
PC8.Signal=SDMMC1_D0
PC9.Signal=SDMMC1_D1
PD0.Signal=I2C5_SDA
PD1.Signal=I2C5_SCL
PD10.GPIO_Label=HR_INT
PD10.Signal=GPXTI10
PD11.GPIO_Label=TOUCH_INT
PD11.Signal=GPXTI11
PD12.Signal=I2C4_SCL
PD13.Signal=I2C4_SDA
PD14.GPIO_Label=LRA_EN
PD14.Signal=GPIO_Output
PD15.GPIO_Label=TOUCH_RST
PD15.Signal=GPIO_Output
PD2.Signal=SDMMC1_CMD
PD3.Signal=USART2_CTS
PD4.Signal=USART2_RTS
PD5.Signal=USART2_TX
PD6.Signal=SDMMC2_CK
PD7.Signal=SDMMC2_CMD
PD8.GPIO_Label=PWR_ENCHG
PD8.Signal=GPIO_Output
PD9.GPIO_Label=PWR_INT
PD9.Signal=GPXTI9
PE0.GPIO_Label=SWIRE_IN
PE0.Signal=GPIO_Input
PE10.Signal=ADF1_SDI0
PE11.Signal=OCTOSPIM_P1_NCS
PE12.Signal=OCTOSPIM_P1_IO0
PE13.Signal=OCTOSPIM_P1_IO1
PE14.Signal=OCTOSPIM_P1_IO2
PE15.Signal=OCTOSPIM_P1_IO3
PE2.GPIO_Label=TP_INT
PE2.Signal=GPXTI2
PE3.GPIO_Label=TP_RST
PE3.Signal=GPIO_Output
PE4.GPIO_Label=SWIRE_OUT
PE4.Signal=GPIO_Output
PE5.GPIO_Label=IMU_INT1
PE5.Signal=GPXTI5
PE6.GPIO_Label=AVDDEN
PE6.Signal=GPIO_Output
PE7.GPIO_Label=SD_EN
PE7.Signal=GPIO_Output
PE8.GPIO_Label=MAG_INT
PE8.Signal=GPXTI8
PE9.Signal=ADF1_CCK0
PF0.Signal=I2C6_SDA
PF1.Signal=I2C6_SCL
PF2.GPIO_Label=GPIO2
PF2.Signal=GPIO_Output
PG0.GPIO_Label=SD_CD
PG0.Signal=GPIO_Input
PG1.GPIO_Label=ALS_INT
PG1.Signal=GPXTI1
PG10.Signal=USART1_RX
PG12.GPIO_Label=GNSS_PPS
PG12.Signal=GPXTI12
PG13.GPIO_Label=GPIO3
PG13.Signal=GPIO_Output
PG14.GPIO_Label=GNSS_WAKEUP
PG14.Signal=GPIO_Output
PG15.GPIO_Label=GNSS_RST
PG15.Signal=GPIO_Output
PG9.Signal=USART1_TX
PH10.Signal=OCTOSPIM_P2_IO5
PH11.Signal=OCTOSPIM_P2_IO6
PH12.Signal=OCTOSPIM_P2_IO7
PH13.GPIO_Label=FLASH_RST
PH13.Signal=GPIO_Output
PH14.GPIO_Label=WL_HOST_WAKE
PH14.Signal=GPXTI14
PH15.GPIO_Label=WL_BT_PWR_EN
PH15.Signal=GPIO_Output
PH3-BOOT0.GPIO_Label=DISPLAY_RST
PH3-BOOT0.Signal=GPIO_Output
PH9.Signal=OCTOSPIM_P2_IO4
PI0.GPIO_Label=BT_EN
PI0.Signal=GPIO_Output
PI1.GPIO_Label=WL_EN
PI1.Signal=GPIO_Output
PI2.GPIO_Label=BT_DEV_WAKE
PI2.Signal=GPIO_Output
PI3.GPIO_Label=BT_HOST_WAKE
PI3.Signal=GPXTI3
