ben5049/Smart-Watch/Firmware/STM32/rfid_module_v1/rfid_module_firmware/Core/Inc/main.h

#define BOOST_EN_Pin GPIO_PIN_4
#define BOOST_EN_GPIO_Port GPIOA
#define OPAMP_SHDN_Pin GPIO_PIN_11
#define OPAMP_SHDN_GPIO_Port GPIOA
#define IRQN_Pin GPIO_PIN_3
#define IRQN_GPIO_Port GPIOB
#define PULL_Pin GPIO_PIN_6
#define PULL_GPIO_Port GPIOB
