ben5049/Smart-Watch/Documentation/Display/touch driver SDK1.9.101/rad_fw_image_20.h

#define RAD_20 0x2212
const unsigned char u8_rad_boot_20[] = {
0x20, 0x01, 0x00, 0x20, 0x75, 0x01, 0x00, 0x00,
0x79, 0x01, 0x00, 0x00, 0x7B, 0x01, 0x00, 0x00,
0x7D, 0x01, 0x00, 0x00, 0x7F, 0x01, 0x00, 0x00,
0x81, 0x01, 0x00, 0x00, 0x00, 0x00, 0x00, 0x00,
0x00, 0x00, 0x00, 0x00, 0x00, 0x00, 0x00, 0x00,
0x00, 0x00, 0x00, 0x00, 0x83, 0x01, 0x00, 0x00,
0x85, 0x01, 0x00, 0x00, 0x00, 0x00, 0x00, 0x00,
0x87, 0x01, 0x00, 0x00, 0x51, 0x30, 0x00, 0x00,
0xD5, 0x28, 0x00, 0x00, 0x05, 0x1D, 0x00, 0x00,
0x8B, 0x01, 0x00, 0x00, 0x01, 0x2C, 0x00, 0x00,
0x8B, 0x01, 0x00, 0x00, 0x19, 0x20, 0x00, 0x00,
0x8B, 0x01, 0x00, 0x00, 0x71, 0x27, 0x00, 0x00,
0x8B, 0x01, 0x00, 0x00, 0xC9, 0x27, 0x00, 0x00,
0x9D, 0x24, 0x00, 0x00, 0x95, 0x25, 0x00, 0x00,
0x35, 0x22, 0x00, 0x00, 0x9D, 0x20, 0x00, 0x00,
0xE9, 0x2F, 0x00, 0x00, 0x8B, 0x01, 0x00, 0x00,
0x02, 0xF3, 0x02, 0x04, 0x03, 0x48, 0x85, 0x46,
0x00, 0xF0, 0x82, 0xF8, 0x00, 0x48, 0x00, 0x47,
0xCB, 0x00, 0x00, 0x00, 0x20, 0x01, 0x00, 0x20,
0x80, 0xF3, 0x08, 0x88, 0x70, 0x47, 0x00, 0x00,
0x10, 0xB5, 0x20, 0x48, 0x81, 0x69, 0x01, 0x22,
0x92, 0x03, 0x11, 0x43, 0x81, 0x61, 0x41, 0x69,
0x10, 0x22, 0x11, 0x43, 0x41, 0x61, 0xD4, 0x01,
0x20, 0x68, 0xFF, 0xF7, 0xED, 0xFF, 0x60, 0x68,
0x19, 0x49, 0x48, 0x60, 0x08, 0x60, 0x80, 0x47,
0x10, 0xBD, 0x01, 0x26, 0xB6, 0x07, 0x30, 0x68,
0x16, 0x49, 0x08, 0x43, 0x30, 0x60, 0x00, 0xF0,
0x2F, 0xF8, 0x00, 0xF0, 0xAA, 0xF8, 0x14, 0x4F,
0x14, 0x4C, 0x01, 0x25, 0x60, 0x68, 0x00, 0x28,
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
0xFF, 0xFF, 0xFF, 0xFF, 0xFF, 0xFF, 0xFF, 0xFF,
0xFF, 0xFF, 0xFF, 0xFF, 0xFF, 0xFF, 0xFF, 0xFF,
0xFF, 0xFF, 0xFF, 0xFF, 0xFF, 0xFF, 0xFF, 0xFF,
0xFF, 0xFF, 0xFF, 0xFF, 0xFF, 0xFF, 0xFF, 0xFF,
0xFF, 0xFF, 0xFF, 0xFF, 0xFF, 0xFF, 0xFF, 0xFF,
0xFF, 0xFF, 0xFF, 0xFF, 0xFF, 0xFF, 0xFF, 0xFF,
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
};
