ben5049/Smart-Watch/Documentation/Display/touch driver SDK1.9.101/rad_fw_image_21.h

#define RAD_21 0x2207
const unsigned char u8_rad_boot_21[] = {
0x18, 0x01, 0x00, 0x20, 0xA9, 0x01, 0x00, 0x00,
0xAD, 0x01, 0x00, 0x00, 0xAF, 0x01, 0x00, 0x00,
0xB1, 0x01, 0x00, 0x00, 0xB3, 0x01, 0x00, 0x00,
0xB5, 0x01, 0x00, 0x00, 0x00, 0x00, 0x00, 0x00,
0x00, 0x00, 0x00, 0x00, 0x00, 0x00, 0x00, 0x00,
0x00, 0x00, 0x00, 0x00, 0xB7, 0x01, 0x00, 0x00,
0xB9, 0x01, 0x00, 0x00, 0x00, 0x00, 0x00, 0x00,
0xBB, 0x01, 0x00, 0x00, 0x51, 0x30, 0x00, 0x00,
0xD5, 0x28, 0x00, 0x00, 0x05, 0x1D, 0x00, 0x00,
0xBF, 0x01, 0x00, 0x00, 0x01, 0x2C, 0x00, 0x00,
0x01, 0x2A, 0x00, 0x00, 0x19, 0x20, 0x00, 0x00,
0xBF, 0x01, 0x00, 0x00, 0x71, 0x27, 0x00, 0x00,
0xBF, 0x01, 0x00, 0x00, 0xC9, 0x27, 0x00, 0x00,
0x9D, 0x24, 0x00, 0x00, 0x95, 0x25, 0x00, 0x00,
0x35, 0x22, 0x00, 0x00, 0x9D, 0x20, 0x00, 0x00,
0xE9, 0x2F, 0x00, 0x00, 0xBF, 0x01, 0x00, 0x00,
0x02, 0xF3, 0x05, 0x01, 0x03, 0x48, 0x85, 0x46,
0x00, 0xF0, 0x9C, 0xF8, 0x00, 0x48, 0x00, 0x47,
0xD5, 0x00, 0x00, 0x00, 0x18, 0x01, 0x00, 0x20,
0x80, 0xF3, 0x08, 0x88, 0x70, 0x47, 0x00, 0x00,
0x10, 0xB5, 0x2C, 0x48, 0x81, 0x69, 0x01, 0x22,
0x92, 0x03, 0x11, 0x43, 0x81, 0x61, 0x41, 0x69,
0x10, 0x22, 0x11, 0x43, 0x41, 0x61, 0x81, 0x05,
0x08, 0x68, 0x8A, 0x14, 0x90, 0x43, 0x08, 0x60,
0xCC, 0x14, 0x20, 0x68, 0xFF, 0xF7, 0xE8, 0xFF,
0x60, 0x68, 0x23, 0x49, 0x48, 0x60, 0x08, 0x60,
0x80, 0x47, 0x10, 0xBD, 0x05, 0x20, 0x00, 0x07,
0xC1, 0x69, 0x07, 0x22, 0xC9, 0x0B, 0xC9, 0x03,
0x12, 0x03, 0x89, 0x18, 0x1D, 0x4A, 0x11, 0x43,
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
0xFF, 0xFF, 0xFF, 0xFF, 0xFF, 0xFF, 0xFF, 0xFF,
0xFF, 0xFF, 0xFF, 0xFF, 0xFF, 0xFF, 0xFF, 0xFF,
0xFF, 0xFF, 0xFF, 0xFF, 0xFF, 0xFF, 0xFF, 0xFF,
0xFF, 0xFF, 0xFF, 0xFF, 0xFF, 0xFF, 0xFF, 0xFF,
0xFF, 0xFF, 0xFF, 0xFF, 0xFF, 0xFF, 0xFF, 0xFF,
0xFF, 0xFF, 0xFF, 0xFF, 0xFF, 0xFF, 0xFF, 0xFF,
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
};
