ben5049/Smart-Watch/Firmware/STM32/gui_ltdc_test/Core/Src/main.c

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
/* Includes ------------------------------------------------------------------*/
#include "app_threadx.h"
#include "main.h"
#include "app_touchgfx.h"

ADC_HandleTypeDef hadc1;

CRC_HandleTypeDef hcrc;

DMA2D_HandleTypeDef hdma2d;

DSI_HandleTypeDef hdsi;

GPU2D_HandleTypeDef hgpu2d;

I2C_HandleTypeDef hi2c5;

LTDC_HandleTypeDef hltdc;

RTC_HandleTypeDef hrtc;

UART_HandleTypeDef huart4;

void SystemClock_Config(void);
static void SystemPower_Config(void);
static void MX_GPIO_Init(void);
static void MX_DSIHOST_DSI_Init(void);
static void MX_ICACHE_Init(void);
static void MX_LTDC_Init(void);
static void MX_I2C5_Init(void);
static void MX_RTC_Init(void);
static void MX_ADC1_Init(void);
static void MX_UART4_Init(void);
static void MX_CRC_Init(void);
static void MX_DMA2D_Init(void);
static void MX_GPU2D_Init(void);
/**
  * @brief  The application entry point.
  * @retval int
  */
int main(void)
{

  /* MCU Configuration--------------------------------------------------------*/

  /* Reset of all peripherals, Initializes the Flash interface and the Systick. */
  HAL_Init();

  /* Configure the system clock */
  SystemClock_Config();

  /* Configure the System Power */
  SystemPower_Config();

  /* Initialize all configured peripherals */
  MX_GPIO_Init();
  MX_DSIHOST_DSI_Init();
  MX_ICACHE_Init();
  MX_LTDC_Init();
  MX_I2C5_Init();
  MX_RTC_Init();
  MX_ADC1_Init();
  MX_UART4_Init();
  MX_CRC_Init();
  MX_DMA2D_Init();
  MX_GPU2D_Init();
  /* Call PreOsInit function */
  MX_TouchGFX_PreOSInit();
  MX_ThreadX_Init();

  /* We should never get here as control is now taken by the scheduler */

  /* Infinite loop */
  /* USER CODE BEGIN WHILE */
	while (1)
	{
    /* USER CODE END WHILE */

    /* USER CODE BEGIN 3 */
	}
  /* USER CODE END 3 */
}

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
/**
  * @brief  Period elapsed callback in non blocking mode
  * @note   This function is called  when TIM6 interrupt took place, inside
  * HAL_TIM_IRQHandler(). It makes a direct call to HAL_IncTick() to increment
  * a global variable "uwTick" used as application time base.
  * @param  htim : TIM handle
  * @retval None
  */
void HAL_TIM_PeriodElapsedCallback(TIM_HandleTypeDef *htim)
{
  if (htim->Instance == TIM6) {
    HAL_IncTick();
  }
}

/**
  * @brief  This function is executed in case of error occurrence.
  * @retval None
  */
void Error_Handler(void)
{
  /* USER CODE BEGIN Error_Handler_Debug */
	/* User can add his own implementation to report the HAL error return state */
	__disable_irq();
	while (1)
	{
	}
  /* USER CODE END Error_Handler_Debug */
}

#ifdef  USE_FULL_ASSERT
/**
  * @brief  Reports the name of the source file and the source line number
  *         where the assert_param error has occurred.
  * @param  file: pointer to the source file name
  * @param  line: assert_param error line source number
  * @retval None
  */
void assert_failed(uint8_t *file, uint32_t line)
{
  /* USER CODE BEGIN 6 */
	/* User can add his own implementation to report the file name and line number,
     ex: printf("Wrong parameters value: file %s on line %d\r\n", file, line) */
  /* USER CODE END 6 */
}
#endif /* USE_FULL_ASSERT */
