ben5049/Smart-Watch/Documentation/Display/touch driver SDK1.9.101/tpselftest.h

#define UC_UPPER_THD 271
#define UC_LOWER_THD -271
unsigned char u8_raw_uc_cc[60]={
0xAA,0x03,0xA9,0x03,0x6D,0x03,0xE8,0x03,0x55,0x03,0x67,0x03,
0x69,0x03,0x56,0x03,0xE8,0x03,0x71,0x03,0xA9,0x03,0xA6,0x03,
0x00,0x00,0x00,0x00,0x00,0x00,0x00,0x00,0xA8,0x03,0xAA,0x03,
0x6C,0x03,0xE6,0x03,0x52,0x03,0x68,0x03,0x6A,0x03,0x54,0x03,
0xE9,0x03,0x73,0x03,0xAA,0x03,0xA5,0x03,0x00,0x00,0x00,0x00};
