ben5049/Smart-Watch/(commit log)

2023-12-12 Started main PCB development
    [105162-0001.stp, ADP5301ACBZ-3-R7.stp, ADP5360ACBZ-2-R7.stp, ANT161575TT-3000A1.stp, ICE40UP5K-UWG30ITR1K.stp, LGA14_LSM6_STM.step, Panasonic_-_EVP-AEJB2A.step, S25HS512TFABHM010.stp]
2023-12-13 More PCB progress
    [NVT4858HKZ.stp, bluetooth.kicad_sch, button.kicad_sch, display_connector.kicad_sch, flash.kicad_sch, fpga.kicad_sch, gnss.kicad_sch, iCE40UP 5k Pinout.xlsx]
2023-12-13 Created "Component Selection.md", minor PCB schematic updates
    [16mhz_crystal.kicad_sch, 32mhz_crystal.kicad_sch, rfid.kicad_sch, watch_main.kicad_sch]
2023-12-15 Created board outline
    [watch_main.kicad_pcb]
2023-12-15 All components symbols, footprints and models paths are relative to project for better portability.
    [antenna.kicad_sch, bluetooth.kicad_sch, button.kicad_sch, display_power.kicad_sch, flash.kicad_sch, fpga.kicad_sch, gnss.kicad_sch, imu.kicad_sch]
2023-12-17 Created firmware project
    [16mhz_crystal.kicad_sch, 32mhz_crystal.kicad_sch, NRF5340-QKAA-R7.step, antenna.kicad_sch, bluetooth.kicad_sch, button.kicad_sch, daughterboard_connector.kicad_sch, display_power.kicad_sch]
2023-12-17 Schematic and pcb progress
    [MAX9028EBT+T.stp, TR1102-0491J.step, antenna.kicad_sch, antenna_layout.dxf, bluetooth.kicad_sch, gnss.kicad_sch, imu.kicad_sch, rfid.kicad_sch]
2023-12-18 PCB Schematic progress
    [Watch Main BOM.xlsx, bluetooth.kicad_sch, fpga.kicad_sch, rfid.kicad_sch, stm32.kicad_sch, stm32_power.kicad_sch, watch_main.kicad_pcb, watch_main.kicad_sch]
2023-12-18 Added connector symbols and footprints
    [AXG110144A.stp, AXG120144.stp, AXG220144.stp, daughterboard_connector.kicad_sch, display_connector.kicad_sch, stm32.kicad_sch, touch_connector.kicad_sch, watch_main.kicad_pcb]
2023-12-19 Main PCB schematic almost complete
    [DRV2605LYZFR.stp, IIS2MDCTR.stp, MAX30102EFD+T.step, OPT3004DNPR.stp, daughterboard_connector.kicad_sch, display_connector.kicad_sch, flash.kicad_sch, imu.kicad_sch]
2023-12-20 Progress with schematic and RFID simulations
    [DMN21D2UFB-7B.stp, DMP21D5UFB4-7B.stp, MAX9027EBT+T.stp, bluetooth.kicad_sch, daughterboard_connector.kicad_sch, display_power.kicad_sch, flash.kicad_sch, micro_sd.kicad_sch]
2023-12-21 Schematic finished and BOM started
    [B39162B4327P810.step, BGA725L6E6327FTSA1.stp, DMP2104LP-7.stp, IM70D122V01.step, TESEO-LIV3FL.stp, TPD1E10B06DPYR.stp, Watch Main BOM.xlsx, antenna.kicad_sch]
2023-12-21 Created test rig schematic
    [FTSH-105-01-L-DV-K.stp, FTSH-107-01-L-DV-K.stp, Pogo_Pin_8mm.step, Watch Test Rig BOM.xlsx, power.kicad_sch, stm32.kicad_sch, watch_test_rig.kicad_pcb, watch_test_rig.kicad_sch]
2023-12-22 Started routing main PCB
    [TYPE-C-31-M-12.step, Watch Main BOM.xlsx, antenna.kicad_sch, bluetooth.kicad_sch, daughterboard_connector.kicad_sch, display_connector.kicad_sch, display_power.kicad_sch, flash.kicad_sch]
2023-12-23 Main PCB placement and routing progress
    [rfid.kicad_sch, stm32.kicad_sch, watch_main.kicad_pcb, watch_test_rig.kicad_pcb, watch_test_rig.kicad_sch]
2023-12-23 287 Connections unrouted
    [micro_sd.kicad_sch, stm32.kicad_sch, watch_main.kicad_pcb]
2023-12-23 224 Unrouted traces
    [power.kicad_sch, rfid.kicad_sch, watch_main.kicad_pcb]
2023-12-24 69 Unrouted traces
    [power.kicad_sch, rfid.kicad_sch, stm32.kicad_sch, stm32_power.kicad_sch, watch_main.kicad_pcb, watch_main.kicad_sch]
2023-12-24 33 Unrouted traces
    [stm32.kicad_sch, watch_main.kicad_pcb]
2023-12-24 Main PCB finished
    [stm32.kicad_sch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]
2023-12-25 Test rig board finished
    [bluetooth.kicad_sch, power.kicad_sch, stm32.kicad_sch, stm32_power.kicad_sch, watch_main.kicad_sch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]
2023-12-25 Created schematic PDFs
    [watch_lower.kicad_pcb]
2023-12-27 New display, started PCB revision 2
    [500913-0242.stp, AXG130144.stp, RT4730WSC.step, Watch Main BOM.xlsx, antenna.kicad_sch, bluetooth.kicad_sch, button.kicad_sch, daughterboard_connector.kicad_sch]
2023-12-27 Schematic v2 complete
    [antenna.kicad_sch, bluetooth.kicad_sch, button.kicad_sch, daughterboard_connector.kicad_sch, display_connector.kicad_sch, display_power.kicad_sch, expansion_connector_sch.kicad_sch, flash.kicad_sch]
2023-12-27 252 Unrouted traces
    [stm32.kicad_sch, watch_main.kicad_pcb]
2023-12-28 262 Unrouted traces, fixed clearance issues
    [bluetooth.kicad_sch, display_power.kicad_sch, micro_sd.kicad_sch, sensors.kicad_sch, stm32.kicad_sch, stm32_power.kicad_sch, watch_main.kicad_pcb]
2023-12-29 190 Unrouted traces
    [NCP45525IMNTWG-H.stp, bluetooth.kicad_sch, expansion_connector_sch.kicad_sch, micro_sd.kicad_sch, power.kicad_sch, stm32.kicad_sch, stm32_power.kicad_sch, watch_main.dxf]
2023-12-30 Main board v2 complete
    [bluetooth.kicad_sch, expansion_connector_sch.kicad_sch, micro_sd.kicad_sch, power.kicad_sch, stm32.kicad_sch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]
2023-12-30 Added EEPROM
    [M24256X-FCU6T_VF.stp, eeprom.kicad_sch, microphone.kicad_sch, stm32.kicad_sch, watch_main.kicad_pcb, watch_main.kicad_sch]
2023-12-31 Main board and test rig complete & ordered.
    [RFID Module BOM.xlsx, Watch Main BOM.xlsx, rfid.kicad_sch, rfid_module.kicad_pcb, rfid_module.kicad_sch, stm32.kicad_sch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]
2024-01-01 Added watch_test_rig_support
    [watch_test_rig.kicad_pcb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]
2024-01-02 RFID Module progress
    [10-Pin Pogo Connector Pads.step, MAX17291BANT+T.stp, Pogo Pin 3mm.step, Test Point 1.5mm.step, Test Point 2mm.step, boost_converter.kicad_sch, lora_module.kicad_pcb, lora_module.kicad_sch]
2024-01-03 RFID PCB Done, started lower flex PCB
    [10-Pin Pogo Connector Pins.step, Module Test Rig BOM.xlsx, RFID Module BOM.xlsx, Watch Main BOM.xlsx, Watch Test Rig BOM.xlsx, antenna.kicad_sch, bluetooth.kicad_sch, boost_converter.kicad_sch]
2024-01-04 Flex PCB finished. Need to rotate RFID transponder coil.
    [RFID Module BOM.xlsx, rfid_module.kicad_pcb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]
2024-01-05 3D Modelling complete, need to rework some PCBs
    [rfid_module.kicad_pcb, watch_lower.kicad_pcb, watch_module.dxf]
2024-01-05 RFID Module v1.1 complete
    [boost_converter.kicad_sch, pogo_connector.kicad_sch, rfid.kicad_sch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]
2024-01-06 RFID Module v1.1 complete (+default firmware)
    [lora_module.kicad_sch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]
2024-01-07 Added comments to RFID module and created gerber files.
    [boost_converter.kicad_sch, watch_lower.kicad_sch]
2024-01-07 Watch main BOM progress.
    [Watch Main BOM.xlsx]
2024-01-08 Flex PCB and RFID PCB ordered.
    [module_test_rig-B_Cu.gbr, module_test_rig-B_Mask.gbr, module_test_rig-B_Paste.gbr, module_test_rig-B_Silkscreen.gbr, module_test_rig-Edge_Cuts.gbr, module_test_rig-F_Cu.gbr, module_test_rig-F_Mask.gbr, module_test_rig-F_Paste.gbr]
2024-01-08 All BOMs complete
    [Module Test Rig BOM.xlsx, RFID Module BOM.xlsx, Watch Lower PCB BOM.xlsx, Watch Main BOM.xlsx, Watch Test Rig BOM.xlsx]
2024-01-09 Component purchasing complete
    [Module Test Rig BOM.xlsx, RFID Module BOM.xlsx, Watch Lower PCB BOM.xlsx, Watch Main BOM.xlsx, Watch Test Rig BOM.xlsx]
2024-01-09 Fixed flex PCB via in pad issue.
    [watch_lower-B_Cu.gbr, watch_lower-B_Mask.gbr, watch_lower-B_Paste.gbr, watch_lower-B_Silkscreen.gbr, watch_lower-Edge_Cuts.gbr, watch_lower-F_Cu.gbr, watch_lower-F_Mask.gbr, watch_lower-F_Paste.gbr]
2024-01-09 Default firmware finished, minor main PCB update
    [stm32.kicad_sch, watch_main.kicad_pcb]
2024-01-10 Minor PCB fixes
    [rfid.kicad_sch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]
2024-01-10 Added CAD folder and test rig frame models
    [Test Rig Frame.stl]
2024-01-12 Created display_pixel_config.xlsx
    [display_pixel_config.csv, display_pixel_config_WORKING.xlsx]
2024-01-13 Fixed coordinate generation program
    [Test Rig Frame.stl, display_pixel_config.csv, display_pixel_config_WORKING.xlsx]
2024-01-14 Bottom frame finished
    [Bottom.stl, watch_main.kicad_pcb]
2024-01-16 Refreshed IBOM for main PCB & test rig
2024-01-17 ADP5360 driver working
    [Watch Main BOM.xlsx]
2024-01-17 Changed firmware file structure & added functionality to enter shipment mode via MR pin on the ADP5360
2024-01-18 Created watch main board V3 Kicad project
    [Watch Main BOM.xlsx, antenna.kicad_sch, bluetooth.kicad_sch, button.kicad_sch, daughterboard_connector.kicad_sch, display_connector.kicad_sch, display_power.kicad_sch, eeprom.kicad_sch]
2024-01-19 EEPROM Driver working
    [daughterboard_connector.kicad_sch, stm32.kicad_sch]
2024-01-20 DRV2605 Driver progress
2024-01-22 Tidying, improved documentation, and created MAX30102 driver template
    [iCE40UP 5k Pinout.xlsx]
2024-01-25 Started watch_main_v3
    [LBEE5PK2AE-564.stp, bluetooth.kicad_sch, stm32.kicad_sch, watch_lower.kicad_sch, watch_main.kicad_pcb]
2024-01-25 watch_main_v3 updates
    [FCBGA300_CYP.step, LBEE59B1LV-278.stp, stm32.kicad_sch, watch_main.dxf, watch_main.kicad_pcb, watch_main.kicad_sch]
2024-01-26 watch_main_v3 updated layout
    [STM32U5G9ZJJ.stp, watch_main.kicad_pcb]
2024-01-26 watch_main_v3 removed unnecessary capacitors from schematic.
    [stm32.kicad_sch, stm32_power.kicad_sch, watch_main.kicad_pcb]
2024-01-27 watch_main_v3 WiFi/Bluetooth schematic done
    [LQ05041QCS6.stp, bluetooth.kicad_sch, gnss.kicad_sch, micro_sd.kicad_sch, stm32.kicad_sch, watch_main.kicad_pcb, watch_main.kicad_sch, wifi_bluetooth.kicad_sch]
2024-01-31 Created touch connector footprint
    [Watch Main BOM.xlsx, touch_connector.kicad_sch, watch_main.kicad_pcb]
2024-02-01 Swapped in new touch connector footprint
    [touch_connector.kicad_sch, watch_main.kicad_pcb]
2024-02-03 Created "display_demo" project, currently not working
    [display_pixel_config.xlsx]
2024-03-26 PCB V3 progress
    [UFBGA144_STM.step, antenna.kicad_sch, bluetooth.kicad_sch, boost_converter.kicad_sch, button.kicad_sch, daughterboard_connector.kicad_sch, display_connector.kicad_sch, display_power.kicad_sch]
2024-03-28 Hard routing done
    [PCA9570GMH.stp, power.kicad_sch, watch_main.kicad_sch]
2024-03-30 Main board version 3.0 done and purchased
    [display_power.kicad_sch, stm32.kicad_sch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]
2024-04-02 Small PCB tweaks
    [rfid_module.kicad_pcb]
2024-05-06 DISPLAY WORKS!!!
    [display_power.kicad_sch, wifi_bluetooth.kicad_sch]
2024-10-17 Changed README.md with latest PCB
2025-03-17 Updated gitignore with kicad patterns
2025-03-17 Updated some projects to Kicad 9
    [antenna.kicad_sch, button.kicad_sch, daughterboard_connector.kicad_sch, display_connector.kicad_sch, display_power.kicad_sch, eeprom.kicad_sch, expansion_connector_sch.kicad_sch, flash.kicad_sch]
