ben5049/Smart-Watch/(notices)

Notices in the files:
Documentation/Display/touch driver SDK1.9.101/raydium_selftest.c:
This program is free software; you can redistribute it and/or modify
it under the terms of the GNU General Public License as published by
the Free Software Foundation; either version 2 of the License, or
(at your option) any later version.
PCBs/component_library/watch_models/FTSH-107-01-L-DV-K.stp:
author */ ('License CC BY-ND 4.0'),
